EwoudVV/arpeggiator/images/note-switches.png

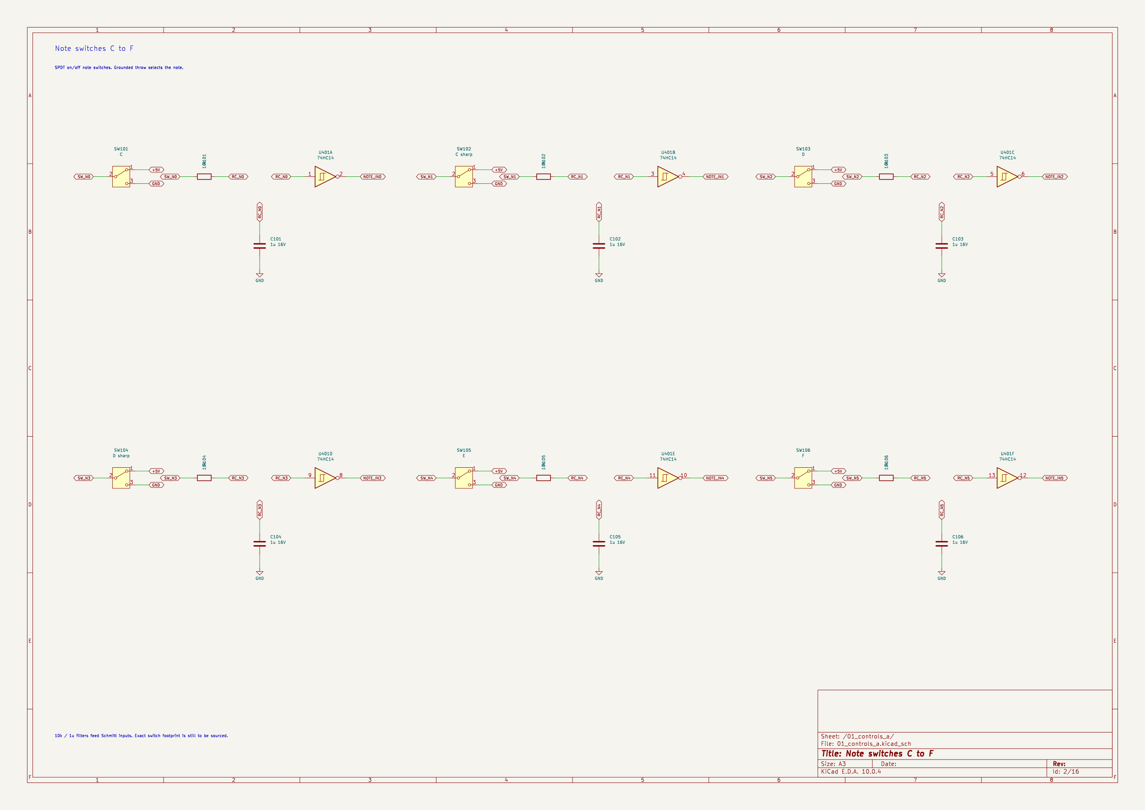
images/note-switches.png
