EwoudVV/arpeggiator/images/pcb-placement.png

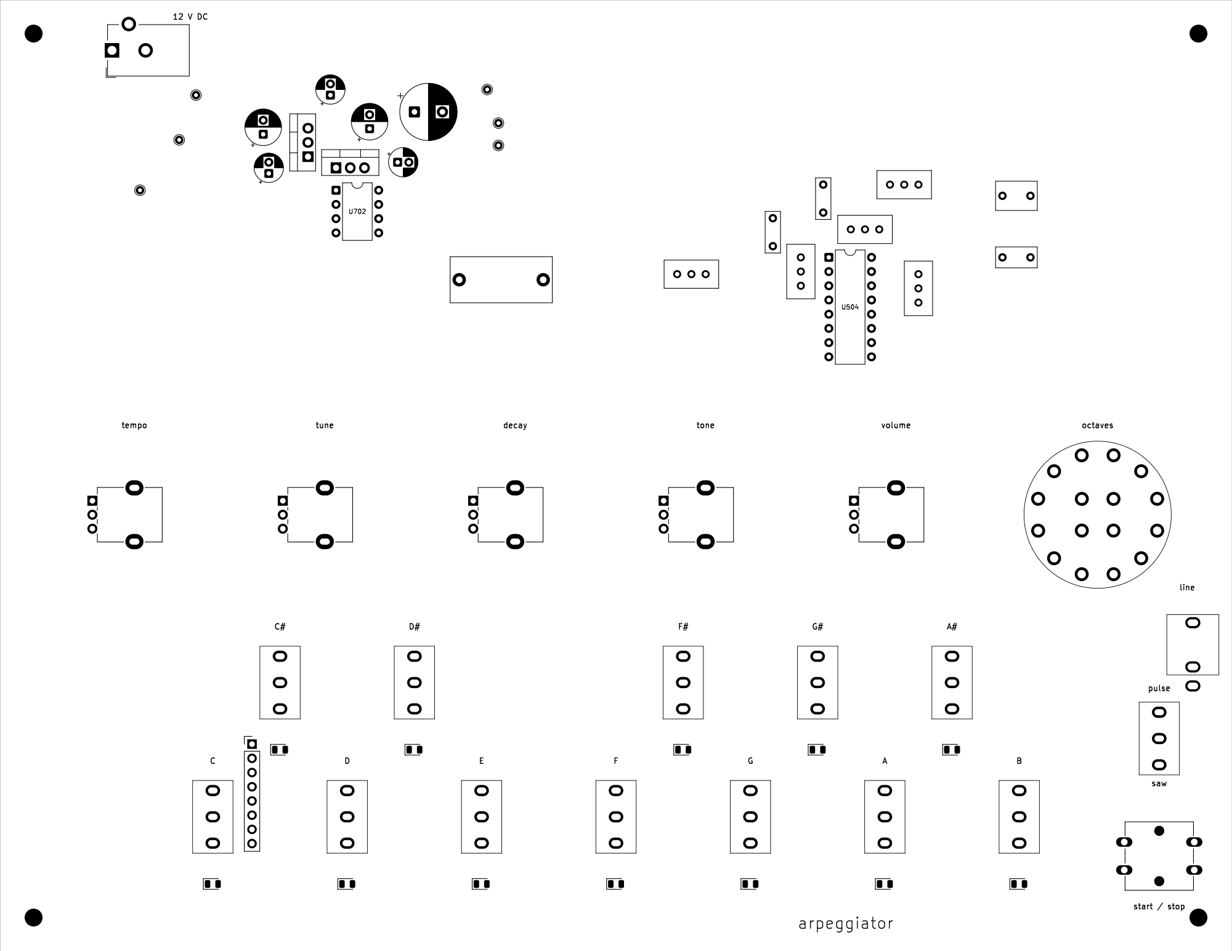
images/pcb-placement.png
