EwoudVV/arpeggiator/BOM.csv

Value | Quantity | References | MPN | Footprint | Manufacturer | Supplier | Supplier URL | Datasheet | Status
74HC04 | 4 | U404, U405, U408, U416 | 74HC04D,653 | Package_SO:SOIC-14_3.9x8.7mm_P1.27mm | Nexperia | LCSC | https://www.lcsc.com/product-detail/C5590.html | https://assets.nexperia.com/documents/data-sheet/74HC_HCT04.pdf | in stock, 23 oct 2026
74HC08 | 8 | U406, U413, U414, U417, U418, U421, U423, U425 | 74HC08D,653 | Package_SO:SOIC-14_3.9x8.7mm_P1.27mm | Nexperia | LCSC | https://www.lcsc.com/product-detail/C5593.html | https://assets.nexperia.com/documents/data-sheet/74HC_HCT08.pdf | in stock, 23 oct 2026
74HC138 | 1 | U212 | 74HC138D,653 | Package_SO:SOIC-16_3.9x9.9mm_P1.27mm | Nexperia | LCSC | https://www.lcsc.com/product-detail/C5602.html | https://assets.nexperia.com/documents/data-sheet/74HC_HCT138.pdf | in stock, 23 oct 2026
74HC14 | 4 | U401, U402, U403, U420 | 74HC14D,653 | Package_SO:SOIC-14_3.9x8.7mm_P1.27mm | Nexperia | LCSC | https://www.lcsc.com/product-detail/C5605.html | https://assets.nexperia.com/documents/data-sheet/74HC_HCT14.pdf | in stock, 23 oct 2026
74HC154 | 1 | U222 | CD74HC154M96 | Package_SO:SOIC-24W_7.5x15.4mm_P1.27mm | TI | LCSC | https://www.lcsc.com/product-detail/C2832236.html | https://assets.nexperia.com/documents/data-sheet/74HC_HCT154.pdf | in stock, 23 oct 2026
74HC163 | 4 | U211, U213, U214, U215 | SN74HC163DR | Package_SO:SOIC-16_3.9x9.9mm_P1.27mm | TI | LCSC | https://www.lcsc.com/product-detail/C338758.html | https://assets.nexperia.com/documents/data-sheet/74HC_HCT163.pdf | in stock, 23 oct 2026
74HC32 | 7 | U409, U410, U411, U412, U419, U422, U424 | 74HC32D,653 | Package_SO:SOIC-14_3.9x8.7mm_P1.27mm | Nexperia | LCSC | https://www.lcsc.com/product-detail/C5632.html | https://assets.nexperia.com/documents/data-sheet/74HC_HCT32.pdf | in stock, 23 oct 2026
74HC377 | 3 | U205, U206, U221 | 74HC377D,653 | Package_SO:SOIC-20W_7.5x12.8mm_P1.27mm | Nexperia | LCSC | https://www.lcsc.com/product-detail/C5639.html | https://assets.nexperia.com/documents/data-sheet/74HC_HCT377.pdf | in stock, 23 oct 2026
74HC4051D | 1 | U503 | 74HC4051D,653 | Package_SO:SOIC-16_3.9x9.9mm_P1.27mm | Nexperia | LCSC | https://www.lcsc.com/product-detail/C9386.html | https://assets.nexperia.com/documents/data-sheet/74HC_HCT4051.pdf | in stock, 23 oct 2026
74HC574 | 4 | U201, U203, U202, U204 | 74HC574D,653 | Package_SO:SOIC-20W_7.5x12.8mm_P1.27mm | Nexperia | LCSC | https://www.lcsc.com/product-detail/C16501.html | https://assets.nexperia.com/documents/data-sheet/74HC_HCT574.pdf | in stock, 23 oct 2026
74HC74 | 3 | U301, U302, U303 | 74HC74D,653 | Package_SO:SOIC-14_3.9x8.7mm_P1.27mm | Nexperia | LCSC | https://www.lcsc.com/product-detail/C27597.html | https://assets.nexperia.com/documents/data-sheet/74HC_HCT74.pdf | in stock, 23 oct 2026
74HC86 | 2 | U407, U415 | 74HC86D,653 | Package_SO:SOIC-14_3.9x8.7mm_P1.27mm | Nexperia | LCSC | https://www.lcsc.com/product-detail/C5955.html | https://assets.nexperia.com/documents/data-sheet/74HC_HCT86.pdf | in stock, 23 oct 2026
ADG706BRUZ | 1 | U502 | ADG706BRUZ-REEL7 | Package_SO:TSSOP-28_4.4x9.7mm_P0.65mm | ADI | LCSC | https://www.lcsc.com/product-detail/C408400.html | https://www.analog.com/media/en/technical-documentation/data-sheets/adg706_707.pdf | in stock, 23 oct 2026
AS3340A | 1 | U504 | AS3340A | Package_DIP:DIP-16_W7.62mm | ALFA RPAR | Infinite Machinery | https://infinitemachinery.com/as3340a | https://www.alfatriode.lv/eng/sc/AS3340.pdf | listed in stock, cart blocked by verification
CD74HC4067M | 1 | U216 | CD74HC4067M | Package_SO:SOIC-24W_7.5x15.4mm_P1.27mm | TI | LCSC | https://www.lcsc.com/product-detail/C1545936.html | https://www.ti.com/lit/ds/symlink/cd74hc4067.pdf | in stock, 23 oct 2026
L7805CV | 1 | U701 | L7805CV | Package_TO_SOT_THT:TO-220-3_Vertical | ST | LCSC | https://www.lcsc.com/product-detail/C111887.html | https://www.st.com/resource/en/datasheet/l78.pdf | in stock, 23 oct 2026
L7905CV | 1 | U706 | L7905CV | Package_TO_SOT_THT:TO-220-3_Vertical | ST | LCSC | https://www.lcsc.com/product-detail/C111884.html | https://www.st.com/resource/en/datasheet/l79.pdf | in stock, 23 oct 2026
LM13700M/NOPB | 1 | U604 | LM13700M/NOPB | Package_SO:SOIC-16_3.9x9.9mm_P1.27mm | TI | LCSC | https://www.lcsc.com/product-detail/C1346265.html | https://www.ti.com/lit/ds/symlink/lm13700.pdf | in stock, 23 oct 2026
LT1054CP | 1 | U702 | LT1054CP | Package_DIP:DIP-8_W7.62mm | Texas Instruments | Mouser | https://www.mouser.com/en/ProductDetail/Texas-Instruments/LT1054CP?qs=p6YqzpSxLIw2yA3OFyb6XA%3D%3D | https://www.ti.com/lit/ds/symlink/lt1054.pdf | in stock, 22 oct 2026
MCP100T-450I/TT | 1 | U103 | MCP100T-450I/TT | Package_TO_SOT_SMD:SOT-23 | MICROCHIP | LCSC | https://www.lcsc.com/product-detail/C134467.html | https://www.microchip.com/en-us/product/MCP100 | in stock, 23 oct 2026
OPA4192IDR | 2 | U501, U602 | OPA4192IDR | Package_SO:SOIC-14_3.9x8.7mm_P1.27mm | TI | LCSC | https://www.lcsc.com/product-detail/C2057908.html | https://www.ti.com/lit/ds/symlink/opa4192.pdf | in stock, 23 oct 2026
TL074HIDR | 1 | U603 | TL074HIDR | Package_SO:SOIC-14_3.9x8.7mm_P1.27mm | TI | LCSC | https://www.lcsc.com/product-detail/C2878713.html | https://www.ti.com/lit/ds/symlink/tl074.pdf | in stock, 23 oct 2026
TL431BIDBZR | 2 | U703, U704 | TL431BIDBZR | Package_TO_SOT_SMD:SOT-23 | TI | LCSC | https://www.lcsc.com/product-detail/C41283.html | https://www.ti.com/lit/ds/symlink/tl431.pdf | in stock, 23 oct 2026
TLC555IDR | 3 | U101, U102, U601 | TLC555IDR | Package_SO:SOIC-8_3.9x4.9mm_P1.27mm | TI | LCSC | https://www.lcsc.com/product-detail/C6987.html | https://www.ti.com/lit/ds/symlink/tlc555.pdf | in stock, 23 oct 2026
TMUX6219DGKRQ1 | 1 | U705 | TMUX6219DGKRQ1 | Arpeggiator:VSSOP-8_DGK0008A_TI | Texas Instruments | LCSC | https://www.lcsc.com/product-detail/C3657022.html | https://www.ti.com/lit/ds/symlink/tmux6219-q1.pdf | in stock, 23 oct 2026
1 / 2 / 3 octaves | 1 | SW114 | SR2612F-0403-18R0B-D8-N | Arpeggiator:SW_Alpha_SR2612F_4P3T | Taiwan Alpha | Tayda | https://www.taydaelectronics.com/electromechanical/switches-key-pad/rotary-switch/rotary-switch-4-pole-3-position-alpha-sr2612f.html | https://www.taydaelectronics.com/datasheets/A-1892.pdf | in stock, 22 oct 2026
1000u 25V | 1 | C708 | EEU-FR1E102 | Capacitor_THT:CP_Radial_D10.0mm_P5.00mm | Panasonic | Mouser | https://www.mouser.com/en/ProductDetail/Panasonic/EEU-FR1E102?qs=Ao3mORb5HCARq2G4MnAlEQ%3D%3D |  | in stock, 22 oct 2026
100k 0.01% 25ppm/C | 4 | R531, R532, R622, R623 | RNCF0805TKT100K | Resistor_SMD:R_0805_2012Metric | SEI Stackpole | Mouser | https://www.mouser.com/en/ProductDetail/SEI-Stackpole/RNCF0805TKT100K?qs=IPgv5n7u5QbwSiCWZtnkOw%3D%3D |  | in stock, 22 oct 2026
100k audio volume | 1 | RV604 | RD901F-40-15F-A100K | Potentiometer_THT:Potentiometer_Alpha_RD901F-40-00D_Single_Vertical | Taiwan Alpha | Tayda | https://www.taydaelectronics.com/100k-ohm-logarithmic-taper-potentiometer-d-shaft-pcb-9mm.html | https://www.taydaelectronics.com/datasheets/files/A-4728-1.pdf | in stock, 22 oct 2026
100k coarse trim | 1 | RV606 | 3296W-1-104LF | Potentiometer_THT:Potentiometer_Bourns_3296W_Vertical | BOURNS | LCSC | https://www.lcsc.com/product-detail/C48084.html | https://www.bourns.com/docs/product-datasheets/3296.pdf | in stock, 23 oct 2026
100k offset null | 1 | RV602 | 3296W-1-104LF | Potentiometer_THT:Potentiometer_Bourns_3296W_Vertical | BOURNS | LCSC | https://www.lcsc.com/product-detail/C48084.html | https://www.bourns.com/docs/product-datasheets/3296.pdf | in stock, 23 oct 2026
100k tone | 1 | RV603 | RD901F-40-15F-B100K | Potentiometer_THT:Potentiometer_Alpha_RD901F-40-00D_Single_Vertical | Taiwan Alpha | Tayda | https://www.taydaelectronics.com/100k-ohm-linear-taper-potentiometer-d-shaft-pcb-9mm.html | https://www.taydaelectronics.com/datasheets/files/A-4728-1.pdf | in stock, 22 oct 2026
100k tune | 1 | RV605 | RD901F-40-15F-B100K | Potentiometer_THT:Potentiometer_Alpha_RD901F-40-00D_Single_Vertical | Taiwan Alpha | Tayda | https://www.taydaelectronics.com/100k-ohm-linear-taper-potentiometer-d-shaft-pcb-9mm.html | https://www.taydaelectronics.com/datasheets/files/A-4728-1.pdf | in stock, 22 oct 2026
100n film 100V 5% | 2 | C631, C632 | R82EC3100DQ70J | Capacitor_THT:C_Rect_L7.2mm_W2.5mm_P5.00mm | KEMET | Tayda | https://www.taydaelectronics.com/0-1uf-100v-5-kemet-polyester-film-box-type-capacitor.html |  | in stock, 22 oct 2026
100u 25V | 2 | C701, C707 | EEU-FC1E101S | Capacitor_THT:CP_Radial_D6.3mm_P2.50mm | Panasonic | Mouser | https://www.mouser.com/en/ProductDetail/Panasonic/EEU-FC1E101S?qs=XZT10BZ%2FaGG7SbPLggsp3w%3D%3D | https://industrial.panasonic.com/cdbs/www-data/pdf/RDF0000/ABA0000C1209.pdf | in stock, 22 oct 2026
10k 0.01% 25ppm/C | 4 | R504, R505, R621, R624 | RNCF0805TKY10K0 | Resistor_SMD:R_0805_2012Metric | SEI Stackpole | Mouser | https://www.mouser.com/en/ProductDetail/SEI-Stackpole/RNCF0805TKY10K0?qs=FESYatJ8odKPVkqigBJMsg%3D%3D |  | in stock, 22 oct 2026
10k tempco | 1 | RV502 | 3296W-1-103LF | Potentiometer_THT:Potentiometer_Bourns_3296W_Vertical | Bourns | Mouser | https://www.mouser.com/en/ProductDetail/Bourns/3296W-1-103LF?qs=CL3xLxiry19Id6AEaxYcng%3D%3D | https://www.bourns.com/docs/product-datasheets/3296.pdf | in stock, 22 oct 2026
1M decay | 1 | RV601 | RD901F-40-15F-B1M | Potentiometer_THT:Potentiometer_Alpha_RD901F-40-00D_Single_Vertical | Taiwan Alpha | Tayda | https://www.taydaelectronics.com/potentiometer-variable-resistors/rotary-potentiometer/linear/1m-ohm-linear-taper-potentiometer-d-shaft-pcb-9mm.html | https://www.taydaelectronics.com/datasheets/files/A-4728-1.pdf | in stock, 22 oct 2026
1u film 63V 5% | 1 | C603 | R82DC4100DQ60J | Capacitor_THT:C_Rect_L7.2mm_W5.0mm_P5.00mm | KEMET | Tayda | https://www.taydaelectronics.com/1uf-63v-5-kemet-polyester-film-box-type-capacitor.html |  | in stock, 22 oct 2026
2.2u film 100V 10% | 1 | C181 | MKS4D042204F00KSSD | Capacitor_THT:C_Rect_L18.0mm_W8.0mm_P15.00mm_FKS3_FKP3 | WIMA | Tayda | https://www.taydaelectronics.com/capacitors/polyester-film-box-type-capacitors/wima-2200nf-2-2uf-100v-10-polyester-film-box-type-capacitor.html |  | in stock, 22 oct 2026
20k HF track | 1 | RV503 | 3296W-1-203LF | Potentiometer_THT:Potentiometer_Bourns_3296W_Vertical | BOURNS | LCSC | https://www.lcsc.com/product-detail/C34845.html | https://www.bourns.com/docs/product-datasheets/3296.pdf | in stock, 23 oct 2026
250k linear | 1 | RV101 | RD901F-40-15F-B250K | Potentiometer_THT:Potentiometer_Alpha_RD901F-40-00D_Single_Vertical | Taiwan Alpha | Tayda | https://www.taydaelectronics.com/potentiometer-variable-resistors/250k-ohm-linear-taper-potentiometer-d-shaft-pcb-9mm.html | https://www.taydaelectronics.com/datasheets/files/A-4728-1.pdf | in stock, 22 oct 2026
2N7002 | 2 | Q601, Q605 | 2N7002,215 | Package_TO_SOT_SMD:SOT-23 | Nexperia | LCSC | https://www.lcsc.com/product-detail/C65189.html | https://assets.nexperia.com/documents/data-sheet/2N7002.pdf | in stock, 23 oct 2026
3.5mm mono line out | 1 | J601 | PJ-3001F | Arpeggiator:Jack_PJ-3001F_Vertical | Tayda Electronics | Tayda | https://www.taydaelectronics.com/pj-3001f-3-5-mm-mono-phone-jack.html | https://www.taydaelectronics.com/datasheets/files/PJ35586.pdf | in stock, 22 oct 2026
470n film 63V 5% | 1 | C633 | R82DC3470AA60J | Capacitor_THT:C_Rect_L7.2mm_W3.5mm_P5.00mm | KEMET | Mouser | https://www.mouser.com/en/ProductDetail/KEMET/R82DC3470AA60J?qs=06HLYMEcjuWhk0f5YvbbSQ%3D%3D |  | in stock, 22 oct 2026
47u 25V | 3 | C704, C705, C711 | 25YXJ47M5X11 | Capacitor_THT:CP_Radial_D5.0mm_P2.00mm | Rubycon | Mouser | https://www.mouser.com/en/ProductDetail/Rubycon/25YXJ47M5X11?qs=T3oQrply3y%2F3J8S0Pc4Y1g%3D%3D |  | in stock, 22 oct 2026
500 scale | 1 | RV501 | 3296W-1-501LF | Potentiometer_THT:Potentiometer_Bourns_3296W_Vertical | Bourns | Mouser | https://www.mouser.com/en/ProductDetail/Bourns/3296W-1-501LF?qs=jv1NtkgVBglZfwkzTzmOUg%3D%3D | https://www.bourns.com/docs/product-datasheets/3296.pdf | in stock, 22 oct 2026
A | 1 | SW110 | 1MS1T1B1M2QES | Arpeggiator:SW_Dailywell_1M_SPDT_M2 | Dailywell | Tayda | https://www.taydaelectronics.com/electromechanical/switches-key-pad/toggle-switch/mini-toggle-switch-spdt-on-none-on-pc-thru-hole.html | https://www.taydaelectronics.com/datasheets/files/1M_series.pdf | in stock, 22 oct 2026
A sharp | 1 | SW111 | 1MS1T1B1M2QES | Arpeggiator:SW_Dailywell_1M_SPDT_M2 | Dailywell | Tayda | https://www.taydaelectronics.com/electromechanical/switches-key-pad/toggle-switch/mini-toggle-switch-spdt-on-none-on-pc-thru-hole.html | https://www.taydaelectronics.com/datasheets/files/1M_series.pdf | in stock, 22 oct 2026
AO3401A | 1 | Q701 | AO3401A | Package_TO_SOT_SMD:SOT-23 | AOS | LCSC | https://www.lcsc.com/product-detail/C15127.html | https://www.aosmd.com/res/data_sheets/AO3401A.pdf | in stock, 23 oct 2026
B | 1 | SW112 | 1MS1T1B1M2QES | Arpeggiator:SW_Dailywell_1M_SPDT_M2 | Dailywell | Tayda | https://www.taydaelectronics.com/electromechanical/switches-key-pad/toggle-switch/mini-toggle-switch-spdt-on-none-on-pc-thru-hole.html | https://www.taydaelectronics.com/datasheets/files/1M_series.pdf | in stock, 22 oct 2026
BAT54GW | 2 | D601, D708 | BAT54GWX | Diode_SMD:D_SOD-123 | Nexperia | LCSC | https://www.lcsc.com/product-detail/C5952163.html | https://assets.nexperia.com/documents/data-sheet/BAT54GW.pdf | in stock, 23 oct 2026
BAT54S,215 | 1 | D706 | BAT54S,215 | Package_TO_SOT_SMD:SOT-23 | Nexperia | LCSC | https://www.lcsc.com/product-detail/C47546.html | https://assets.nexperia.com/documents/data-sheet/BAT54_SER.pdf | in stock, 23 oct 2026
BSS84 | 1 | Q603 | BSS84,215 | Package_TO_SOT_SMD:SOT-23 | Nexperia | LCSC | https://www.lcsc.com/product-detail/C493579.html | https://assets.nexperia.com/documents/data-sheet/BSS84.pdf | in stock, 23 oct 2026
BZT52C8V2 | 1 | D701 | BZT52-C8V2J | Diode_SMD:D_SOD-123 | Nexperia | Mouser | https://www.mouser.com/en/ProductDetail/Nexperia/BZT52-C8V2J?qs=%252BEew9%252B0nqrCU1UOFPtFF2A%3D%3D | https://assets.nexperia.com/documents/data-sheet/BZT52_SER.pdf | in stock, 22 oct 2026
C | 1 | SW101 | 1MS1T1B1M2QES | Arpeggiator:SW_Dailywell_1M_SPDT_M2 | Dailywell | Tayda | https://www.taydaelectronics.com/electromechanical/switches-key-pad/toggle-switch/mini-toggle-switch-spdt-on-none-on-pc-thru-hole.html | https://www.taydaelectronics.com/datasheets/files/1M_series.pdf | in stock, 22 oct 2026
C sharp | 1 | SW102 | 1MS1T1B1M2QES | Arpeggiator:SW_Dailywell_1M_SPDT_M2 | Dailywell | Tayda | https://www.taydaelectronics.com/electromechanical/switches-key-pad/toggle-switch/mini-toggle-switch-spdt-on-none-on-pc-thru-hole.html | https://www.taydaelectronics.com/datasheets/files/1M_series.pdf | in stock, 22 oct 2026
D | 1 | SW103 | 1MS1T1B1M2QES | Arpeggiator:SW_Dailywell_1M_SPDT_M2 | Dailywell | Tayda | https://www.taydaelectronics.com/electromechanical/switches-key-pad/toggle-switch/mini-toggle-switch-spdt-on-none-on-pc-thru-hole.html | https://www.taydaelectronics.com/datasheets/files/1M_series.pdf | in stock, 22 oct 2026
D sharp | 1 | SW104 | 1MS1T1B1M2QES | Arpeggiator:SW_Dailywell_1M_SPDT_M2 | Dailywell | Tayda | https://www.taydaelectronics.com/electromechanical/switches-key-pad/toggle-switch/mini-toggle-switch-spdt-on-none-on-pc-thru-hole.html | https://www.taydaelectronics.com/datasheets/files/1M_series.pdf | in stock, 22 oct 2026
E | 1 | SW105 | 1MS1T1B1M2QES | Arpeggiator:SW_Dailywell_1M_SPDT_M2 | Dailywell | Tayda | https://www.taydaelectronics.com/electromechanical/switches-key-pad/toggle-switch/mini-toggle-switch-spdt-on-none-on-pc-thru-hole.html | https://www.taydaelectronics.com/datasheets/files/1M_series.pdf | in stock, 22 oct 2026
F | 1 | SW106 | 1MS1T1B1M2QES | Arpeggiator:SW_Dailywell_1M_SPDT_M2 | Dailywell | Tayda | https://www.taydaelectronics.com/electromechanical/switches-key-pad/toggle-switch/mini-toggle-switch-spdt-on-none-on-pc-thru-hole.html | https://www.taydaelectronics.com/datasheets/files/1M_series.pdf | in stock, 22 oct 2026
F sharp | 1 | SW107 | 1MS1T1B1M2QES | Arpeggiator:SW_Dailywell_1M_SPDT_M2 | Dailywell | Tayda | https://www.taydaelectronics.com/electromechanical/switches-key-pad/toggle-switch/mini-toggle-switch-spdt-on-none-on-pc-thru-hole.html | https://www.taydaelectronics.com/datasheets/files/1M_series.pdf | in stock, 22 oct 2026
G | 1 | SW108 | 1MS1T1B1M2QES | Arpeggiator:SW_Dailywell_1M_SPDT_M2 | Dailywell | Tayda | https://www.taydaelectronics.com/electromechanical/switches-key-pad/toggle-switch/mini-toggle-switch-spdt-on-none-on-pc-thru-hole.html | https://www.taydaelectronics.com/datasheets/files/1M_series.pdf | in stock, 22 oct 2026
G sharp | 1 | SW109 | 1MS1T1B1M2QES | Arpeggiator:SW_Dailywell_1M_SPDT_M2 | Dailywell | Tayda | https://www.taydaelectronics.com/electromechanical/switches-key-pad/toggle-switch/mini-toggle-switch-spdt-on-none-on-pc-thru-hole.html | https://www.taydaelectronics.com/datasheets/files/1M_series.pdf | in stock, 22 oct 2026
LM4040A25IDBZR | 1 | D501 | LM4040A25IDBZR | Package_TO_SOT_SMD:SOT-23 | TI | LCSC | https://www.lcsc.com/product-detail/C9421.html | https://www.ti.com/lit/ds/symlink/lm4040.pdf | in stock, 23 oct 2026
MF-MSMF035/33X-2 / 350mA | 1 | F701 | MF-MSMF035/33X-2 | Fuse:Fuse_1812_4532Metric | Bourns | Mouser | https://www.mouser.com/en/ProductDetail/Bourns/MF-MSMF035-33X-2?qs=CoAU%2FpHVZXxuOeHMuQc7RQ%3D%3D | https://www.bourns.com/docs/product-datasheets/mf-msmf.pdf | in stock, 22 oct 2026
MMBT3904 | 2 | Q602, Q604 | MMBT3904,215 | Package_TO_SOT_SMD:SOT-23 | Nexperia | LCSC | https://www.lcsc.com/product-detail/C426835.html | https://assets.nexperia.com/documents/data-sheet/MMBT3904.pdf | in stock, 23 oct 2026
MMBT3906 | 3 | Q606, Q702, Q703 | MMBT3906,215 | Package_TO_SOT_SMD:SOT-23 | Nexperia | LCSC | https://www.lcsc.com/product-detail/C75549.html | https://assets.nexperia.com/documents/data-sheet/MMBT3906.pdf | in stock, 23 oct 2026
PESD5V0S1BA,115 | 1 | D705 | PESD5V0S1BA,115 | Diode_SMD:D_SOD-323 | Nexperia | LCSC | https://www.lcsc.com/product-detail/C19224.html | https://assets.nexperia.com/documents/data-sheet/PESD5V0S1BA_BB_BL.pdf | in stock, 23 oct 2026
PJ-102AH / 12V DC centre + | 1 | J701 | PJ-102AH | Arpeggiator:BarrelJack_PJ102AH_Rear | Same Sky | Mouser | https://www.mouser.com/en/ProductDetail/Same-Sky/PJ-102AH?qs=WyjlAZoYn50Yq4CrVLCXLw%3D%3D | https://www.sameskydevices.com/product/resource/pj-102ah.pdf | in stock, 22 oct 2026
SMBJ12A | 1 | D702 | SMBJ12A | Diode_SMD:D_SMB | Littelfuse | Mouser | https://www.mouser.com/en/ProductDetail/Littelfuse/SMBJ12A?qs=JJML70Qc14s9i3D6UUa43Q%3D%3D |  | in stock, 22 oct 2026
SS14 | 3 | D703, D707, D704 | SS14-E3/61T | Diode_SMD:D_SMA | Vishay | Mouser | https://www.mouser.com/en/ProductDetail/Vishay/SS14-E3-61T?qs=x2jpVgRnAtMLNL7KZbtr8g%3D%3D | https://www.mouser.com/datasheet/2/427/VISH_S_A0010526100_1-2571162.pdf | in stock, 22 oct 2026
saw / pulse | 1 | SW601 | 1MS1T1B1M2QES | Arpeggiator:SW_Dailywell_1M_SPDT_M2 | Dailywell | Tayda | https://www.taydaelectronics.com/electromechanical/switches-key-pad/toggle-switch/mini-toggle-switch-spdt-on-none-on-pc-thru-hole.html | https://www.taydaelectronics.com/datasheets/files/1M_series.pdf | in stock, 22 oct 2026
start / stop | 1 | SW113 | B3F-4055 | Button_Switch_THT:SW_SPST_Omron_B3F-40xx | OMRON | LCSC | https://www.lcsc.com/product-detail/C84931.html | https://omronfs.omron.com/en_US/ecb/products/pdf/en-b3f.pdf | in stock, 23 oct 2026
1.1M 1% | 1 | R633 | RC0805FR-071M1L | Resistor_SMD:R_0805_2012Metric | YAGEO | Mouser | https://www.mouser.com/en/ProductDetail/YAGEO/RC0805FR-071M1L?qs=g6xwsc4j%252B%2FrRMnxWx%2Fruqg%3D%3D |  | in stock, 22 oct 2026
1.5M 1% | 2 | R534, R542 | RC0805FR-071M5L | Resistor_SMD:R_0805_2012Metric | YAGEO | Mouser | https://www.mouser.com/en/ProductDetail/YAGEO/RC0805FR-071M5L?qs=g6xwsc4j%252B%2FoVoMODI3Rz0Q%3D%3D |  | in stock, 22 oct 2026
1.5k 1% | 1 | R537 | RC0805FR-071K5L | Resistor_SMD:R_0805_2012Metric | YAGEO | Mouser | https://www.mouser.com/en/ProductDetail/YAGEO/RC0805FR-071K5L?qs=8Y8p%252BasKcI6LbaohOVk4HA%3D%3D |  | in stock, 22 oct 2026
1.82M 0.1% | 1 | R620 | CPF0805B1M82E | Resistor_SMD:R_0805_2012Metric | TE Connectivity | Mouser | https://www.mouser.com/en/ProductDetail/TE-Connectivity/CPF0805B1M82E?qs=CXI0wBT1M2hvtJld3NhfsA%3D%3D |  | in stock, 22 oct 2026
1.8M 1% | 1 | R163 | ERJ-6ENF1804V | Resistor_SMD:R_0805_2012Metric | Panasonic | Mouser | https://www.mouser.com/en/ProductDetail/Panasonic/ERJ-6ENF1804V?qs=JjxTDIFmKPTXgJmgM%2FyOiQ%3D%3D |  | in stock, 22 oct 2026
100 0.1% | 1 | R540 | RT0805BRD07100RL | Resistor_SMD:R_0805_2012Metric | YAGEO | Mouser | https://www.mouser.com/en/ProductDetail/YAGEO/RT0805BRD07100RL?qs=%2Ff7pOCXLR5dUTF5MWPONjg%3D%3D |  | in stock, 22 oct 2026
100k 1% | 11 | R130, R216, R535, R601, R602, R605, R637, R701, R716, R726, R728 | RC0805FR-07100KL | Resistor_SMD:R_0805_2012Metric | YAGEO | Mouser | https://www.mouser.com/en/ProductDetail/YAGEO/RC0805FR-07100KL?qs=8Y8p%252BasKcI7rEWn6FcVdAA%3D%3D |  | in stock, 22 oct 2026
100n 5% | 1 | C601 | C0805C104J5RACTU | Capacitor_SMD:C_0805_2012Metric | KEMET | Mouser | https://www.mouser.com/en/ProductDetail/KEMET/C0805C104J5RACTU?qs=gbgtKHXraGH15GhoNPXHBg%3D%3D |  | in stock, 22 oct 2026
100n 50V X7R 10% | 68 | C130, C140, C141, C901, C902, C903, C904, C905, C906, C907, C908, C909, C910, C911, C912, C913, C914, C915, C916, C917, C918, C919, C920, C921, C922, C923, C924, C925, C926, C927, C928, C929, C930, C931, C932, C933, C934, C935, C936, C937, C938, C939, C940, C941, C942, C943, C944, C945, C501, C532, C551, C552, C553, C554, C555, C556, C557, C558, C559, C560, C561, C562, C661, C703, C706, C717, C715, C716 | CC0805KRX7R9BB104 | Capacitor_SMD:C_0805_2012Metric | YAGEO | LCSC | https://www.lcsc.com/product-detail/C49678.html |  | in stock, 23 oct 2026
100p C0G | 5 | C502, C503, C621, C713, C714 | C0805C101J5GACTU | Capacitor_SMD:C_0805_2012Metric | KEMET | Mouser | https://www.mouser.com/en/ProductDetail/KEMET/C0805C101J5GACTU?qs=6pfgPk%252B7Yz7wCPQSSQ%2FBjg%3D%3D |  | in stock, 22 oct 2026
10k 0.1% | 2 | R625, R639 | RT0805BRD0710KL | Resistor_SMD:R_0805_2012Metric | YAGEO | Mouser | https://www.mouser.com/en/ProductDetail/YAGEO/RT0805BRD0710KL?qs=87%2Fgv35YuOdOfU%252BBkLDVxA%3D%3D |  | in stock, 22 oct 2026
10k 0.1% 25ppm/C | 1 | R503 | RT0805BRD0710KL | Resistor_SMD:R_0805_2012Metric | YAGEO | Mouser | https://www.mouser.com/en/ProductDetail/YAGEO/RT0805BRD0710KL?qs=87%2Fgv35YuOdOfU%252BBkLDVxA%3D%3D |  | in stock, 22 oct 2026
10k 1% | 25 | R101, R102, R103, R104, R105, R106, R107, R108, R109, R110, R111, R112, R151, R152, R161, R140, R142, R141, R143, R604, R609, R630, R717, R727, R707 | RC0805FR-0710KL | Resistor_SMD:R_0805_2012Metric | YAGEO | Mouser | https://www.mouser.com/en/ProductDetail/YAGEO/RC0805FR-0710KL?qs=7bY8808IzHq6vrU3BeiiYw%3D%3D |  | in stock, 22 oct 2026
10n | 6 | C172, C182, C531, C533, C602, C634 | C0805C103J5GACTU | Capacitor_SMD:C_0805_2012Metric | KEMET | LCSC | https://www.lcsc.com/product-detail/C2167597.html |  | in stock, 23 oct 2026
10u 16V | 1 | C150 | GRM21BR61C106KE15L | Capacitor_SMD:C_0805_2012Metric | muRata | LCSC | https://www.lcsc.com/product-detail/C77075.html |  | in stock, 23 oct 2026
15k 0.1% 25ppm/C | 1 | R502 | RT0805BRD0715KL | Resistor_SMD:R_0805_2012Metric | YAGEO | Mouser | https://www.mouser.com/en/ProductDetail/YAGEO/RT0805BRD0715KL?qs=%2Ff7pOCXLR5foXQ1VlhQYhQ%3D%3D |  | in stock, 22 oct 2026
174k 0.1% | 1 | R704 | RT0805BRD07174KL | Resistor_SMD:R_0805_2012Metric | YAGEO | Mouser | https://www.mouser.com/en/ProductDetail/YAGEO/RT0805BRD07174KL?qs=4CyHz7GXqSj4xC7rYoRg0A%3D%3D |  | in stock, 22 oct 2026
18.2k 1% | 1 | R603 | ERJ-6ENF1822V | Resistor_SMD:R_0805_2012Metric | Panasonic | Mouser | https://www.mouser.com/en/ProductDetail/Panasonic/ERJ-6ENF1822V?qs=JjxTDIFmKPRzh6ImPVU9cQ%3D%3D |  | in stock, 22 oct 2026
1M 1% | 2 | R541, R629 | RC0805FR-071ML | Resistor_SMD:R_0805_2012Metric | YAGEO | Mouser | https://www.mouser.com/en/ProductDetail/YAGEO/RC0805FR-071ML?qs=8Y8p%252BasKcI6wvSL4jxV1pQ%3D%3D |  | in stock, 22 oct 2026
1k 0.1% | 12 | R511, R512, R513, R514, R515, R516, R517, R518, R519, R520, R521, R522 | RT0805BRD071KL | Resistor_SMD:R_0805_2012Metric | YAGEO | Mouser | https://www.mouser.com/en/ProductDetail/YAGEO/RT0805BRD071KL?qs=%2Ff7pOCXLR5e3FpClshTdPA%3D%3D |  | in stock, 22 oct 2026
1k 1% | 6 | R131, R628, R632, R634, R635, R636 | RC0805FR-071KL | Resistor_SMD:R_0805_2012Metric | YAGEO | Mouser | https://www.mouser.com/en/ProductDetail/YAGEO/RC0805FR-071KL?qs=1ogmaHw32WJjeGY0DHXakQ%3D%3D |  | in stock, 22 oct 2026
1n C0G | 2 | C171, C534 | C0805C102J5GACTU | Capacitor_SMD:C_0805_2012Metric | KEMET | Mouser | https://www.mouser.com/en/ProductDetail/KEMET/C0805C102J5GACTU?qs=yrVqjCObULOWvTzsHVJg1Q%3D%3D |  | in stock, 22 oct 2026
1u 16V | 12 | C101, C102, C103, C104, C105, C106, C107, C108, C109, C110, C111, C112 | CC0805KKX7R8BB105 | Capacitor_SMD:C_0805_2012Metric | YAGEO | Mouser | https://www.mouser.com/en/ProductDetail/YAGEO/CC0805KKX7R8BB105?qs=QENzi4TkIJ0C75LKGblEtw%3D%3D |  | in stock, 22 oct 2026
2.2k 1% | 14 | R221, R222, R223, R224, R225, R226, R227, R228, R229, R230, R231, R232, R714, R724 | RC0805FR-072K2L | Resistor_SMD:R_0805_2012Metric | YAGEO | Mouser | https://www.mouser.com/en/ProductDetail/YAGEO/RC0805FR-072K2L?qs=CSLd874fYV2eT6iKTza3nw%3D%3D |  | in stock, 22 oct 2026
2.32k 0.1% | 1 | R712 | RT0805BRD072K32L | Resistor_SMD:R_0805_2012Metric | YAGEO | Mouser | https://www.mouser.com/en/ProductDetail/YAGEO/RT0805BRD072K32L?qs=4CyHz7GXqSgSJcxnTJ8TbQ%3D%3D |  | in stock, 22 oct 2026
2.49k 1% | 1 | R501 | RC0805FR-072K49L | Resistor_SMD:R_0805_2012Metric | YAGEO | Mouser | https://www.mouser.com/en/ProductDetail/YAGEO/RC0805FR-072K49L?qs=QrWOOBGzeCbaR%2FeulLJohg%3D%3D |  | in stock, 22 oct 2026
200k 1% | 1 | R627 | RC0805FR-07200KL | Resistor_SMD:R_0805_2012Metric | YAGEO | Mouser | https://www.mouser.com/en/ProductDetail/YAGEO/RC0805FR-07200KL?qs=8Y8p%252BasKcI4ufYuYh%252BmyZQ%3D%3D |  | in stock, 22 oct 2026
20k 0.1% | 1 | R703 | RT0805BRD0720KL | Resistor_SMD:R_0805_2012Metric | YAGEO | Mouser | https://www.mouser.com/en/ProductDetail/YAGEO/RT0805BRD0720KL?qs=87%2Fgv35YuOd%2FdRM1LyX3Lg%3D%3D |  | in stock, 22 oct 2026
220 1% | 2 | R607, R611 | RC0805FR-07220RL | Resistor_SMD:R_0805_2012Metric | YAGEO | Mouser | https://www.mouser.com/en/ProductDetail/YAGEO/RC0805FR-07220RL?qs=KCkj9j0IqmXa4o%252BHKR6RGw%3D%3D |  | in stock, 22 oct 2026
22k 1% | 1 | R608 | RC0805FR-0722KL | Resistor_SMD:R_0805_2012Metric | YAGEO | Mouser | https://www.mouser.com/en/ProductDetail/YAGEO/RC0805FR-0722KL?qs=ngJqVwYVsdVbc7Rh0xIeHw%3D%3D |  | in stock, 22 oct 2026
24k 1% | 1 | R538 | RC0805FR-0724KL | Resistor_SMD:R_0805_2012Metric | YAGEO | Mouser | https://www.mouser.com/en/ProductDetail/YAGEO/RC0805FR-0724KL?qs=0OpHuDRjTADBsy5P0J6k2w%3D%3D |  | in stock, 22 oct 2026
2k 0.1% | 2 | R711, R722 | RT0805BRD072KL | Resistor_SMD:R_0805_2012Metric | YAGEO | Mouser | https://www.mouser.com/en/ProductDetail/YAGEO/RT0805BRD072KL?qs=7JGxMcfkPok2189RXPA53g%3D%3D |  | in stock, 22 oct 2026
2n C0G | 1 | C709 | C0805C202J5GACTU | Capacitor_SMD:C_0805_2012Metric | KEMET | Mouser | https://www.mouser.com/en/ProductDetail/KEMET/C0805C202J5GACTU?qs=W4SVoLh3QChWIjbVvPwmQg%3D%3D |  | in stock, 22 oct 2026
330k 0.1% | 2 | R713, R723 | RT0805BRD07330KL | Resistor_SMD:R_0805_2012Metric | YAGEO | Mouser | https://www.mouser.com/en/ProductDetail/YAGEO/RT0805BRD07330KL?qs=aZCcseWLxnuj6nToWrZKFA%3D%3D |  | in stock, 22 oct 2026
330n 50V | 1 | C702 | C0805C334K5RACTU | Capacitor_SMD:C_0805_2012Metric | KEMET | Mouser | https://www.mouser.com/en/ProductDetail/KEMET/C0805C334K5RACTU?qs=nRD1PKnFC2Hh3tSy%2FGeH2Q%3D%3D |  | in stock, 22 oct 2026
33k 1% | 1 | R706 | RC0805FR-0733KL | Resistor_SMD:R_0805_2012Metric | YAGEO | Mouser | https://www.mouser.com/en/ProductDetail/YAGEO/RC0805FR-0733KL?qs=BrN8wpjQTgGzZxKgikrwvw%3D%3D |  | in stock, 22 oct 2026
33p C0G | 1 | C622 | C0805C330J5GACTU | Capacitor_SMD:C_0805_2012Metric | KEMET | Mouser | https://www.mouser.com/en/ProductDetail/KEMET/C0805C330J5GACTU?qs=PVnqbTyV3SUE6Uu%252BkD9Iyg%3D%3D |  | in stock, 22 oct 2026
360k 0.1% | 1 | R533 | RT0805BRD07360KL | Resistor_SMD:R_0805_2012Metric | YAGEO | Mouser | https://www.mouser.com/en/ProductDetail/YAGEO/RT0805BRD07360KL?qs=aZCcseWLxnvpELpsSQnh8g%3D%3D |  | in stock, 22 oct 2026
36k 1% | 1 | R162 | RC0805FR-0736KL | Resistor_SMD:R_0805_2012Metric | YAGEO | Mouser | https://www.mouser.com/en/ProductDetail/YAGEO/RC0805FR-0736KL?qs=g6xwsc4j%252B%2Fq3CmSeyDlL7g%3D%3D |  | in stock, 22 oct 2026
4.7 1% 0.25W | 1 | R702 | RC1206FR-074R7L | Resistor_SMD:R_1206_3216Metric | YAGEO | Mouser | https://www.mouser.com/en/ProductDetail/YAGEO/RC1206FR-074R7L?qs=bz%2FLPVPAsTK5WyYax3BLuA%3D%3D |  | in stock, 22 oct 2026
4.7u 25V X7R | 1 | C635 | GRM21BR71E475KA73L | Capacitor_SMD:C_0805_2012Metric | muRata | LCSC | https://www.lcsc.com/product-detail/C162427.html |  | in stock, 23 oct 2026
470 1% | 2 | R536, R543 | RC0805FR-07470RL | Resistor_SMD:R_0805_2012Metric | YAGEO | Mouser | https://www.mouser.com/en/ProductDetail/YAGEO/RC0805FR-07470RL?qs=CSLd874fYV2wsnqMGLpcHA%3D%3D |  | in stock, 22 oct 2026
47k 1% | 5 | R606, R610, R626, R715, R725 | RC0805FR-0747KL | Resistor_SMD:R_0805_2012Metric | YAGEO | Mouser | https://www.mouser.com/en/ProductDetail/YAGEO/RC0805FR-0747KL?qs=sfaR5EV1ye7DERH7OnC2Gg%3D%3D |  | in stock, 22 oct 2026
5.62k 0.1% | 1 | R539 | RT0805BRD075K62L | Resistor_SMD:R_0805_2012Metric | YAGEO | Mouser | https://www.mouser.com/en/ProductDetail/YAGEO/RT0805BRD075K62L?qs=ylEn6CkgxuiWDc5aTJ638g%3D%3D |  | in stock, 22 oct 2026
51k 1% | 1 | R544 | RC0805FR-0751KL | Resistor_SMD:R_0805_2012Metric | YAGEO | Mouser | https://www.mouser.com/en/ProductDetail/YAGEO/RC0805FR-0751KL?qs=g6xwsc4j%252B%2FrUFmy6S6ALYQ%3D%3D |  | in stock, 22 oct 2026
6.04k 0.1% | 1 | R638 | RT0805BRD076K04L | Resistor_SMD:R_0805_2012Metric | YAGEO | Mouser | https://www.mouser.com/en/ProductDetail/YAGEO/RT0805BRD076K04L?qs=8SI67b7NHM5NwjLBwcP%252BXQ%3D%3D |  | in stock, 22 oct 2026
6.49k 0.1% | 1 | R721 | RT0805BRD076K49L | Resistor_SMD:R_0805_2012Metric | YAGEO | Mouser | https://www.mouser.com/en/ProductDetail/YAGEO/RT0805BRD076K49L?qs=4CyHz7GXqSiLdN4y1MhhhQ%3D%3D |  | in stock, 22 oct 2026
820k 1% | 1 | R631 | RC0805FR-07820KL | Resistor_SMD:R_0805_2012Metric | YAGEO | Mouser | https://www.mouser.com/en/ProductDetail/YAGEO/RC0805FR-07820KL?qs=g6xwsc4j%252B%2FozLzDoZP6Szg%3D%3D |  | in stock, 22 oct 2026
910 1% | 2 | R729, R730 | RC0805FR-07910RL | Resistor_SMD:R_0805_2012Metric | YAGEO | Mouser | https://www.mouser.com/en/ProductDetail/YAGEO/RC0805FR-07910RL?qs=g6xwsc4j%252B%2FoZ2NamZOKACA%3D%3D |  | in stock, 22 oct 2026
copper test pad | 6 | TP701, TP702, TP703, TP704, TP705, TP706 |  | TestPoint:TestPoint_THTPad_D1.5mm_Drill0.7mm |  |  |  |  | PCB pad, no component
logic test header | 1 | J202 | M20-9990846 | Connector_PinHeader_2.54mm:PinHeader_1x08_P2.54mm_Vertical | Harwin | Mouser | https://www.mouser.com/en/ProductDetail/Harwin/M20-9990846?qs=ulE8k0yEMYb37YKanNqd%2FQ%3D%3D |  | in stock, 22 oct 2026
note LED, 0805 | 12 | D221, D222, D223, D224, D225, D226, D227, D228, D229, D230, D231, D232 | APT2012SYCK | LED_SMD:LED_0805_2012Metric | Kingbright | Mouser | https://www.mouser.com/en/ProductDetail/Kingbright/APT2012SYCK?qs=y3UkhjaxUTb%252BLZXQu8d2yw%3D%3D |  | in stock, 22 oct 2026
four-layer PCB, 220 x 170 mm, 1.6 mm FR4, 1 oz outer / 0.5 oz inner | 1 | PCB | arpeggiator-jlcpcb |  | JLCPCB | JLCPCB | https://jlcpcb.com/pcb-fabrication/fr4-pcb |  | quoted 23 oct 2026; five boards, including production-file review
printed tray, control panel, rear cover and octave collar | 1 | CASE |  | case/base.stl; case/control-panel.stl; case/rear-cover.stl; case/octave-collar.stl |  |  |  |  | PETG-CF tray and rear cover, PLA panel and collar
printed pot knob | 5 | KNOBS |  | case/pot-knob.stl |  |  |  |  | PLA
regulated 12V DC adapter, >=0.5A, centre +, 5.5/2.1mm | 1 | PSU | SMI6B-12-4-P5 | external | CUI Inc. | Mouser | https://www.mouser.com/en/ProductDetail/CUI-Inc/SMI6B-12-4-P5?qs=mAH9sUMRCtt8%252BS4f4Sapgw%3D%3D |  | in stock, 22 oct 2026
printed octave knob | 1 | OCTAVE_KNOB |  | case/octave-knob.stl |  |  |  |  | PLA
M3 x 8 mm socket-head screw | 18 | CASE_SCREWS | A-6393 | ISO 4762 M3 x 8 | Tayda Electronics | Tayda | https://www.taydaelectronics.com/hardware-tools/nuts-washers-screws-spacers-and-more/screws/m3-hexagon-socket-head-cap-screw-3x8mm-grade-12-9.html |  | in stock, 22 oct 2026
M3 hex nut | 18 | CASE_NUTS | Nut M3 | ISO 4032 M3, 5.5 mm across flats | Tayda Electronics | Tayda | https://www.taydaelectronics.com/nut-3mm-for-screw-m3.html |  | in stock, 22 oct 2026
stick-on rubber foot, about 12 mm diameter | 4 | FEET | RF-1204 | external | Tayda Electronics | Tayda | https://www.taydaelectronics.com/rubber-feet-black-64pcs-block-size-12mmx4mm-for-enclosure.html |  | in stock, 23 oct 2026; one sheet of 64 feet
clear 3 mm acrylic rod, at least 200 mm stock | 1 | LIGHT_PIPES | a24061900ux1460 | external | Harfington | Harfington | https://www.harfington.com/products/p-1536182 |  | in stock, 23 oct 2026; listed as 3 x 300 mm, 30 rods per pack
round black button cap | 1 | START_CAP | B32-1610 | Omron B3F-4055 compatible | Aratas | Mouser | https://www.mouser.com/en/ProductDetail/Aratas/B32-1610?qs=1tDaWCEHQQ6l3s6oDrKSiA%3D%3D | https://omronfs.omron.com/en_US/ecb/products/pdf/en-b32.pdf | in stock, 22 oct 2026
M7 x 0.75 thin pot nut and washer | 5 | POT_MOUNTS |  | nut at most 2 mm thick, washer at most 0.5 mm |  |  |  |  | check whether included with pots
1/4-40 toggle nut and washer | 13 | TOGGLE_MOUNTS |  | nut about 2 mm thick, washer 0.5 mm |  |  |  |  | check whether included with switches
3/8-32 NEF rotary nut and lockwasher | 1 | ROTARY_MOUNT |  | nut at most 3 mm thick, washer at most 0.8 mm |  |  |  |  | included with Alpha SR2612F
M6 x 0.5 jack nut and washer | 1 | JACK_MOUNT |  | nut 1 mm thick, washer at most 0.5 mm |  |  |  |  | check whether included with jack
bottom-side frameless stencil, 380 x 280 mm, 0.12 mm | 1 | STENCIL | arpeggiator-bottom-stencil | external | JLCPCB | JLCPCB | https://jlcpcb.com/pcb-stencil |  | quoted 23 oct 2026, before coupon
