EwoudVV/arpeggiator/case/arpeggiator-assembly.step

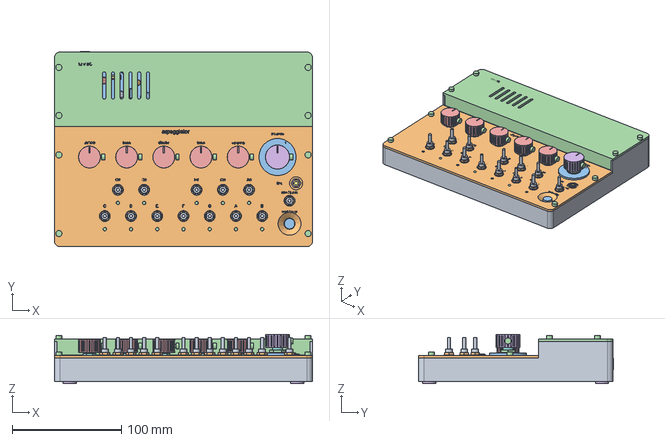
[picture p11: CAD file, 2026-10-22]
case/arpeggiator-assembly.step
236.0 x 178.7 x 45.1 mm
