EwoudVV/arpeggiator/case/rear-cover.stl

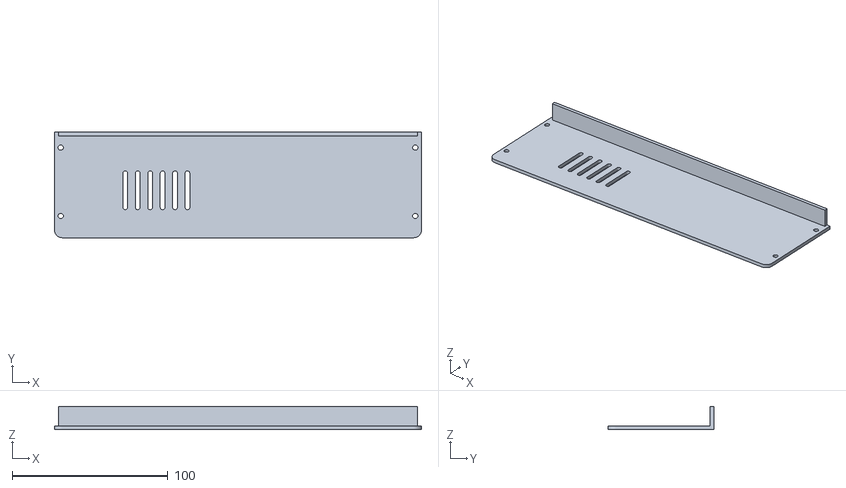
[picture p12: CAD file, 2026-10-22]
case/rear-cover.stl
236.0 x 67.8 x 14.9
