EwoudVV/arpeggiator/case/fit-coupon.stl

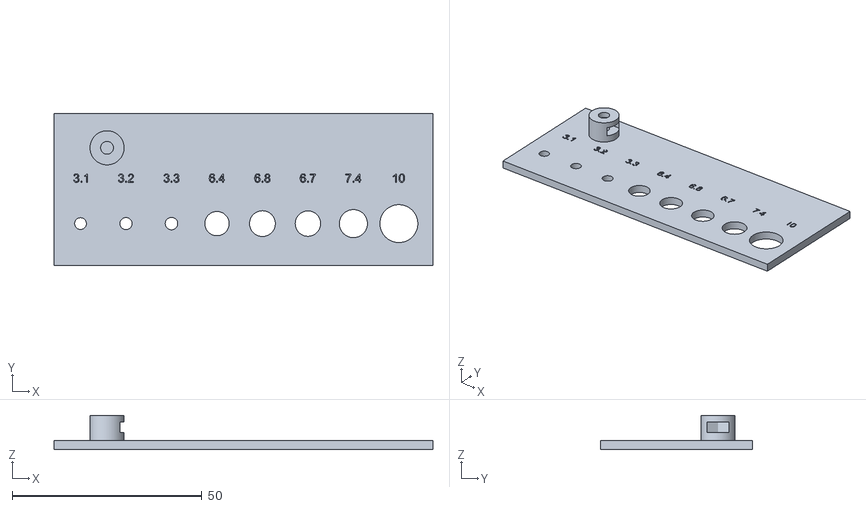
[picture p13: CAD file, 2026-10-22]
case/fit-coupon.stl
100.0 x 40.0 x 9.00
