EwoudVV/arpeggiator/case/base.stl

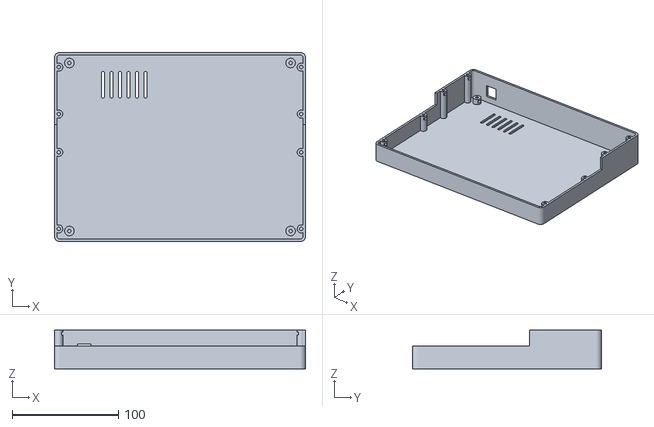
[picture p14: CAD file, 2026-10-22]
case/base.stl
236.0 x 178.0 x 36.6
