EwoudVV/arpeggiator/case/pot-knob.stl

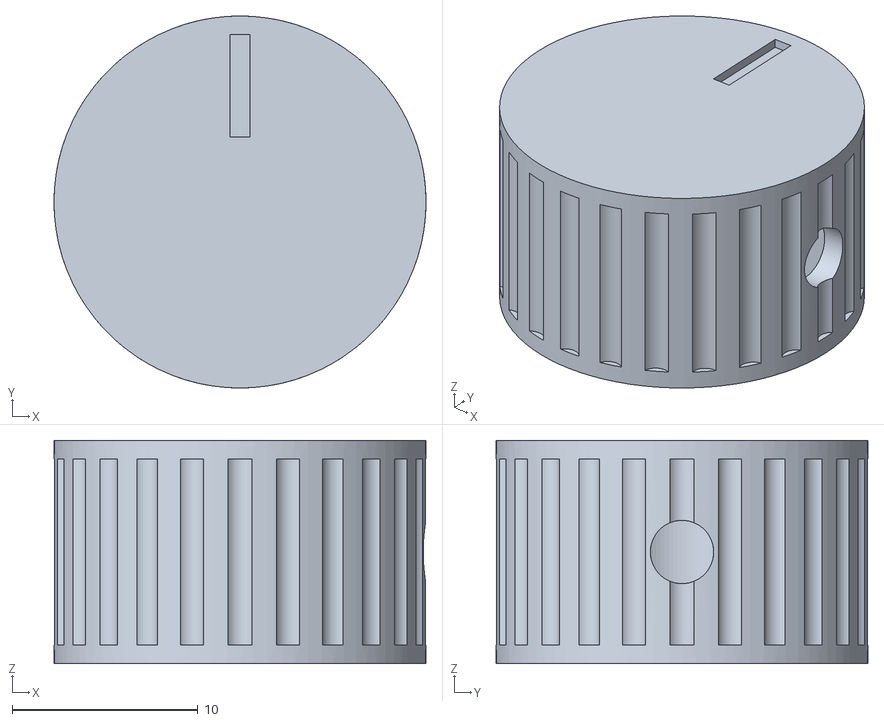
[picture p15: CAD file, 2026-10-22]
case/pot-knob.stl
20.0 x 20.0 x 12.0
