EwoudVV/arpeggiator/case/arpeggiator-case.FCStd

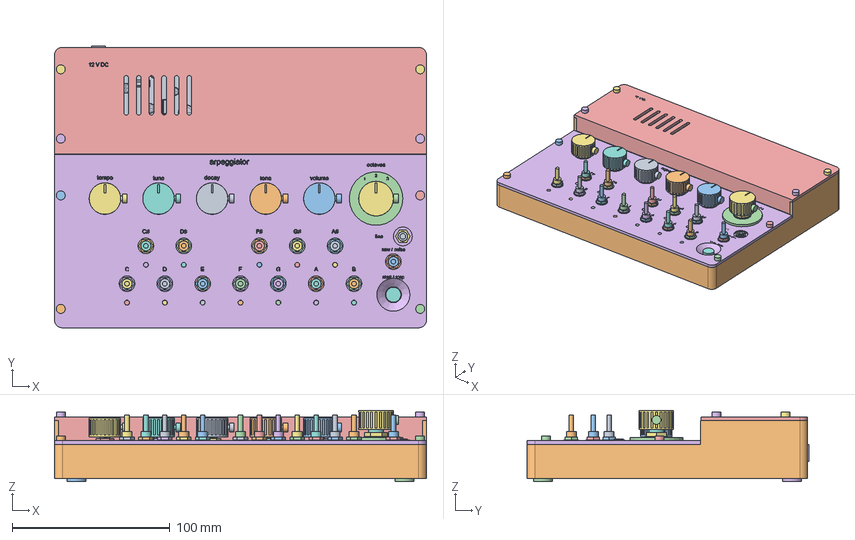
[picture p16: CAD file, 2026-10-22]
case/arpeggiator-case.FCStd
236.0 x 178.7 x 45.1 mm
line jack001
base tray
start switch
C603 body
D221 light pipe
D222 light pipe
D223 light pipe
D224 light pipe
D225 light pipe
D226 light pipe
D227 light pipe
D228 light pipe
D229 light pipe
D230 light pipe
D231 light pipe
D232 light pipe
DC input body
fit coupon
rubber foot
rubber foot001
rubber foot002
rubber foot003
knob1
knob2
knob3
knob4
knob5
octave collar001
rear cover001
control panel001
MountJackNut
MountJackWasher
M3 knob nut
M3 knob nut001
M3 knob nut002
M3 knob nut003
M3 knob nut004
M3 knob nut005
M3 x 8 knob screw
M3 x 8 knob screw001
M3 x 8 knob screw002
M3 x 8 knob screw003
M3 x 8 knob screw004
M3 x 8 knob screw005
MountPotNut0
MountPotNut1
MountPotNut2
MountPotNut3
MountPotNut4
MountPotWasher0
MountPotWasher1
MountPotWasher2
MountPotWasher3
MountPotWasher4
MountRotaryNut
MountRotaryWasher
MountToggleNut0
MountToggleNut1
MountToggleNut10
MountToggleNut11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
