EwoudVV/arpeggiator/case/octave-collar.stl

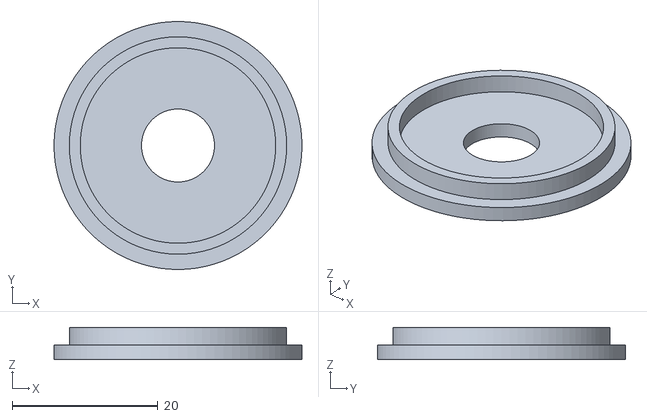
[picture p17: CAD file, 2026-10-22]
case/octave-collar.stl
34.0 x 34.0 x 4.40
