EwoudVV/arpeggiator/case/octave-knob.stl

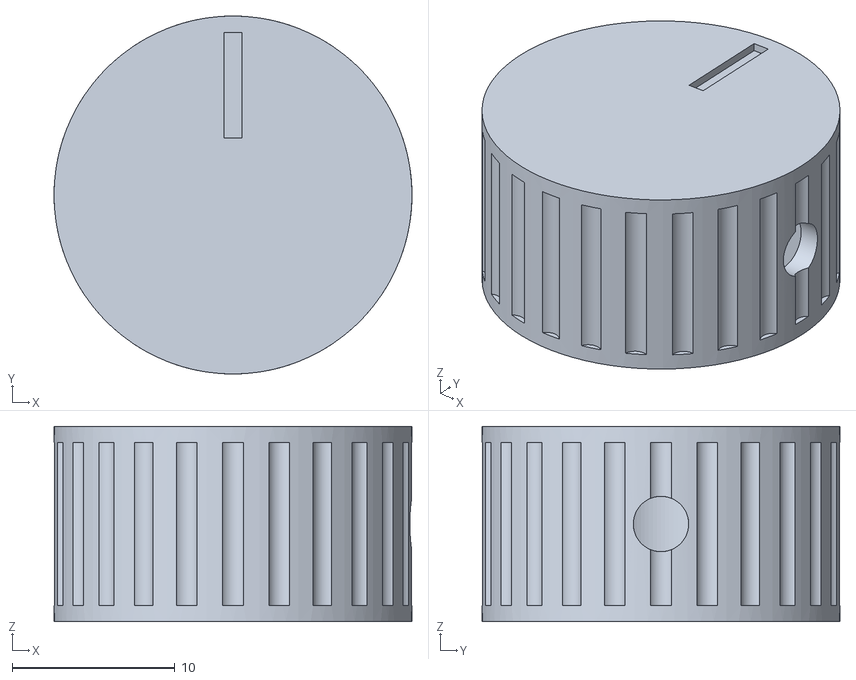
[picture p18: CAD file, 2026-10-22]
case/octave-knob.stl
22.0 x 22.0 x 12.0
