EwoudVV/arpeggiator/case/control-panel.stl

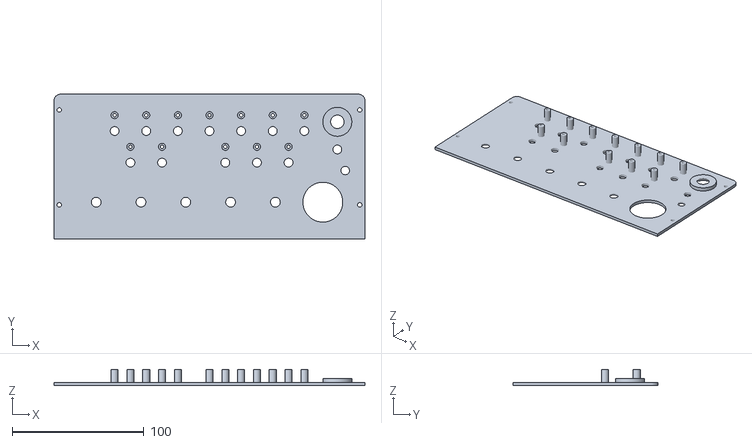
[picture p19: CAD file, 2026-10-22]
case/control-panel.stl
236.0 x 109.8 x 12.2
