EwoudVV/arpeggiator/JOURNAL.md

# journal

## October 19, 2026

10 hours

Devlog 01: sequencer circuit

started the arpeggiator for music week. i'm making it with analog circuits and logic chips, with no microcontroller. settled on 12 note switches and a selector that repeats the chosen notes across one, two or three octaves. set up the repo and Half Life project too

drew the sequencer in KiCad, including the switch inputs, clocks, counters, octave selection, start/stop and note LEDs. one clock sets the tempo and a much faster one searches for the next enabled note. a separate register holds the sounding note steady while that search happens

added a settling step before triggering each note, then put the trigger through a register so a brief glitch from the state decoder won't become an extra note. also added reset and mute behaviour for an empty selection or an invalid state

checked the exported connections and tested the clocked model with every note-switch combination and octave range. also checked changing the selection, stopping during a search and restarting. ERC is clean for this section. these are circuit and model checks, not physical tests

looked into the pitch-voltage parts too. ordinary analog switches can leak enough current to affect the tuning, so i'm planning a precision switch and 0.1% resistors for that section. the sound circuit, main supply, PCB and case are next. nothing built yet

sequencer

note-switches

arpeggiator-03_clock_range

arpeggiator-04_input_registers

arpeggiator-06_pitch_register

arpeggiator-events

arpeggiator-logic_02

arpeggiator-logic_03

arpeggiator-logic_05

arpeggiator-logic_06

## October 19, 2026

4 hours

Devlog 02: pitch and sound circuit

added the part that turns the note numbers into sound. the note register selects a voltage from the resistor ladder, and a second switch selects the octave. both go into the AS3340A oscillator, with trimmers for tuning and tracking

the saw and pulse outputs feed an LM13700 amplifier. each note charges an envelope capacitor, then the decay knob controls how quickly it fades. stop discharges that capacitor too. after the amplifier there is a simple tone control, volume knob and a mono line output

i checked the reference and resistor values, and ran models of the envelope and amplifier current source. i also went back through the sequencer checks with the sound circuit connected. the schematic passes ERC. the oscillator will still need tuning and checking once the board exists

next is finishing the power supply and choosing the actual controls and parts before laying out the PCB

arpeggiator-10_oscillator

arpeggiator-11_envelope

arpeggiator-12_amplifier

arpeggiator-08_reference

## October 20, 2026

8 hours

Devlog 03: power supply and reset

added the power supply. the 12 V input has a fuse and reverse-polarity protection. a 7805 supplies the logic, and an LT1054 charge pump feeds a 7905 for the negative analog rail

added checks for the input voltage and negative rail alongside the existing 5 V reset. the sequencer stays reset until the supplies are ready. a switch mutes the line output while stopped, and the envelope discharge circuit now runs from 12 V so it still works if 5 V disappears

checked the current and heat estimates and reset thresholds, and ran models of a few startup and power-loss cases. also checked stopping partway through the envelope's charge pulse and restarting without an extra note. the sequencer checks still pass and ERC is clean. the switching supply and startup behaviour still need checking on the real board

started the BOM and found sources for the main chips and calibration parts. the AS3340A will use a DIP package, which should be easier to solder and replace. the front controls, a few capacitors and their footprints are next, then PCB placement

arpeggiator-15_input_power

arpeggiator-16_negative_supply

arpeggiator-17_negative_monitor

arpeggiator-18_input_monitor

arpeggiator-19_reset_output

arpeggiator-13_line_output

arpeggiator-14_analog_power

arpeggiator-10_oscillator

## October 20, 2026

8 hours

Devlog 04: controls and first PCB placement

picked the switches, pots, jack and film capacitors and finished their footprints. checked the knob directions too. clockwise now means faster tempo, higher pitch, longer decay, brighter tone and more volume. the note switches select a note when pushed up

the octave selector has exactly three positions. it uses two poles to encode the range, with the other two left open. the tempo pot is 250k with a resistor across it to keep the nominal range around 38-240 BPM

started the PCB. it is 220 x 170 mm with two copper layers and four mounting holes. the controls are on the front in two piano-style rows, with most of the small circuit parts on the back. the supply parts are grouped at the rear, away from the controls

made a footprint for the mute switch using TI's recommended land pattern. the wider pads in the generic footprint were too close for the board's clearance setting. also checked the switch commons, jack contacts and the pot support tabs against their drawings

the schematic passes ERC and the sequencer checks still pass. the board is only a first placement, with no routed tracks yet. routing and the case are next, and the physical fits will still need checking when the parts arrive

pcb-front

pcb-back

arpeggiator-01_controls_a

arpeggiator-03_clock_range

arpeggiator-13_line_output

SW_Alpha_SR2612F_4P3T

VSSOP-8_DGK0008A_TI

Jack_PJ-3001F_Vertical

## October 22, 2026

15 hours

Devlog 05: routing the board

finally got the PCB routed. the power section and analog circuit went in first, followed by all the connections between the logic chips. kept the note switches and the rest of the controls where they were

i started with two layers, but the ground connections were getting stuck between all the signal tracks. changed it to four layers, with both inner layers used for ground. that sorted out the remaining connections without having to move everything around again

the board passes DRC now. next is making a case for it, then getting the parts and board ordered

routed PCB, front

routed PCB, back

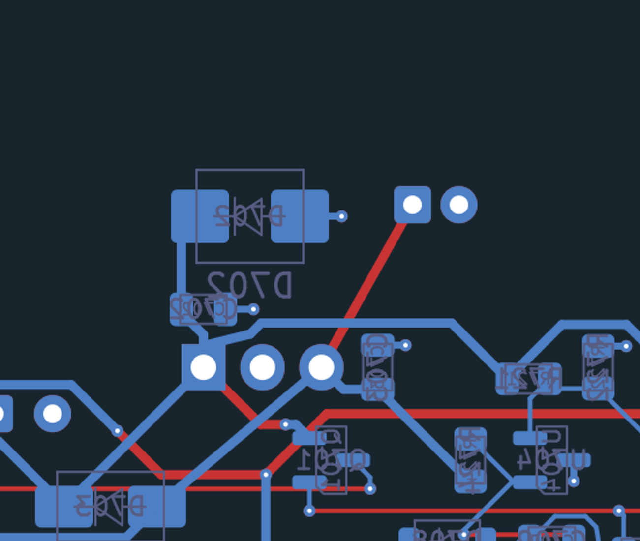
[picture p20: images/routing/5v-supply.png]
5v supply


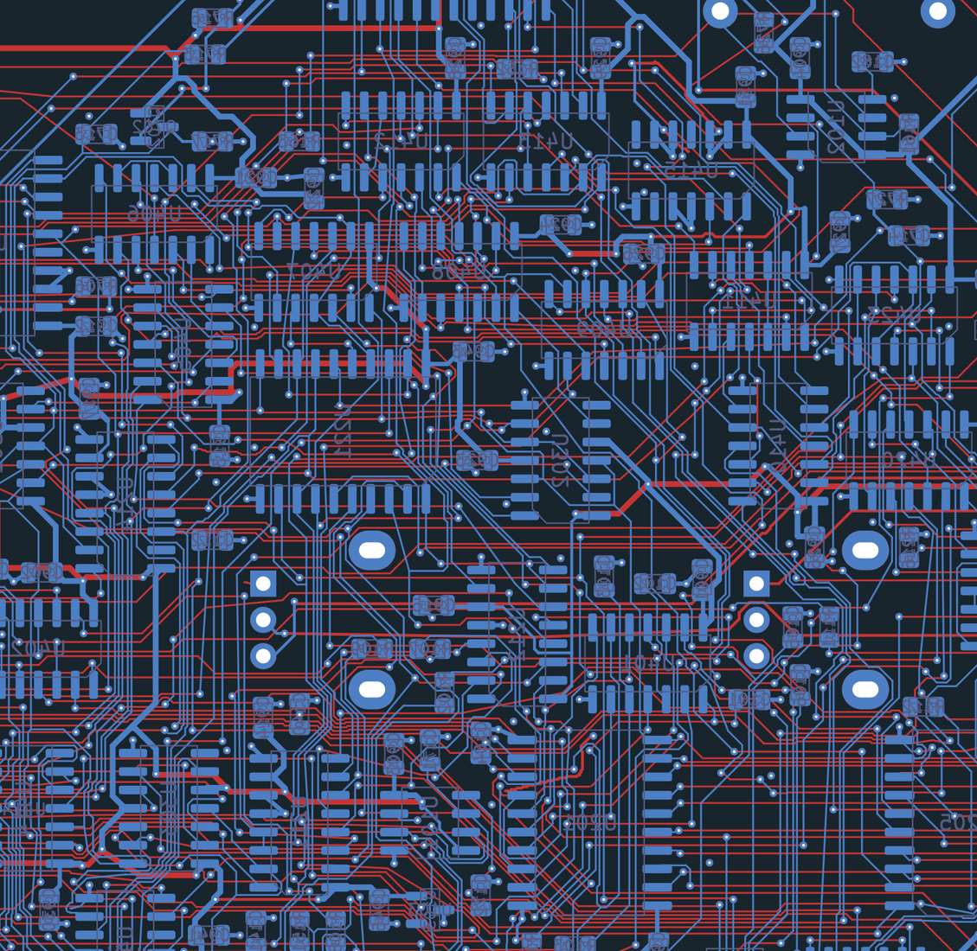
[picture p21: images/routing/clock-and-start.png]
clock and start


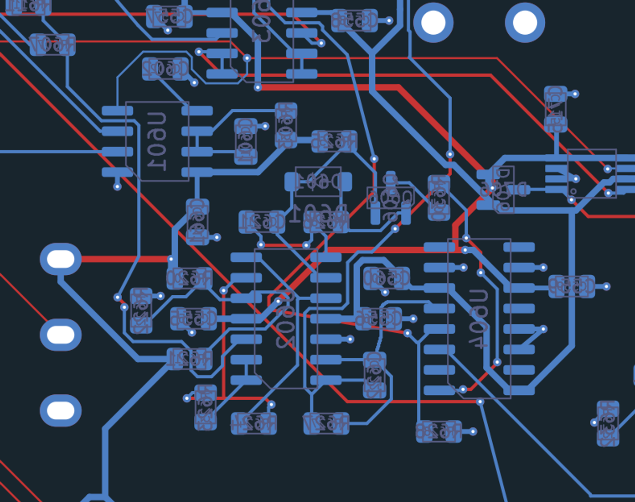
[picture p22: images/routing/envelope-and-vca.png]
envelope and vca


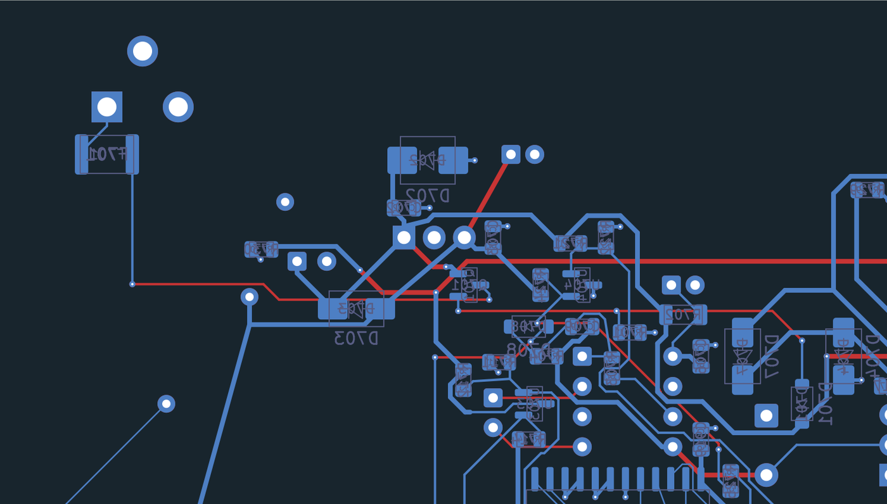
[picture p23: images/routing/input-power.png]
input power


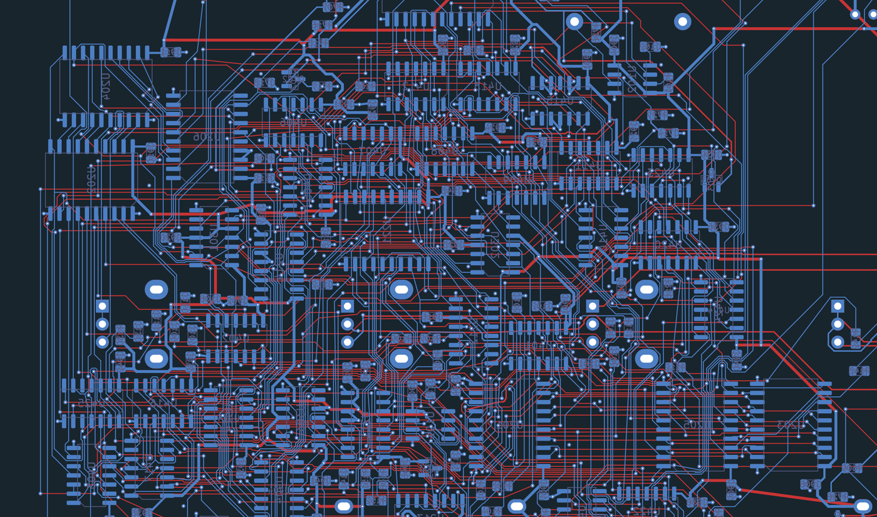
[picture p24: images/routing/input-registers.png]
input registers


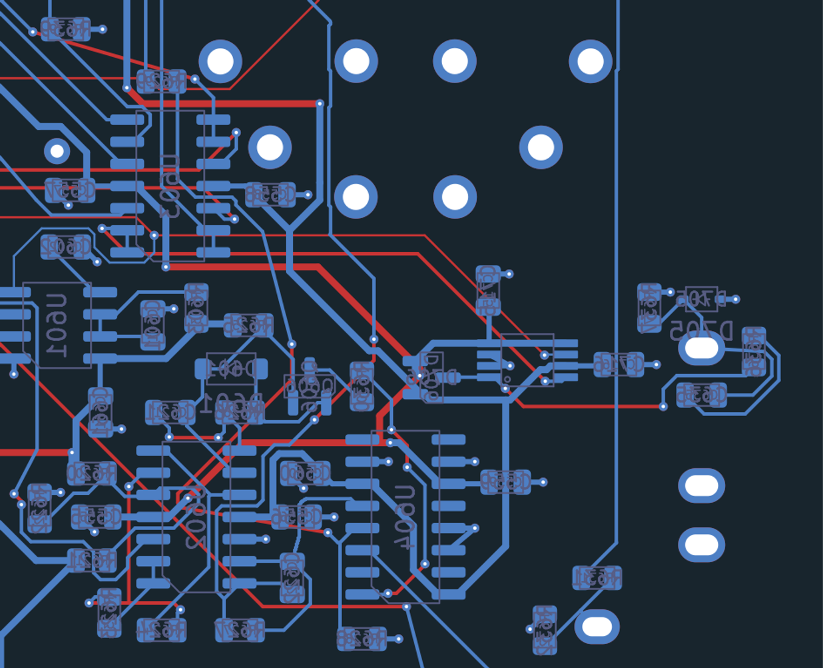
[picture p25: images/routing/line-output.png]
line output


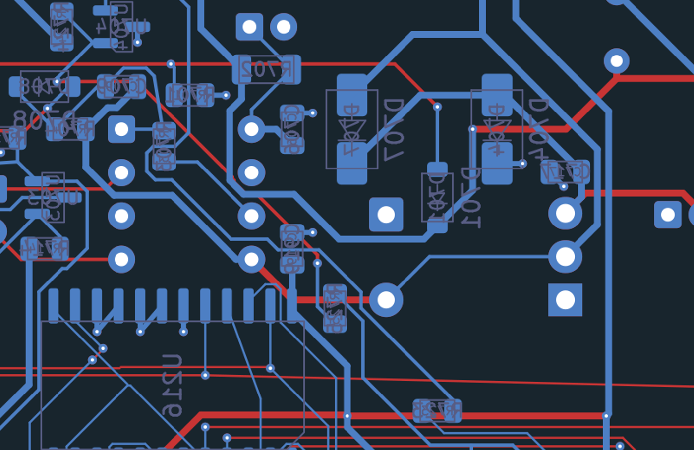
[picture p26: images/routing/negative-supply.png]
negative supply


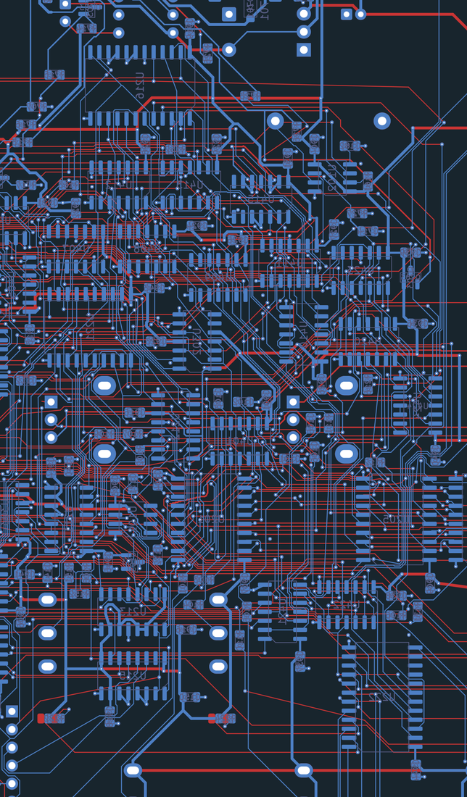
[picture p27: images/routing/note-multiplexer.png]
note multiplexer


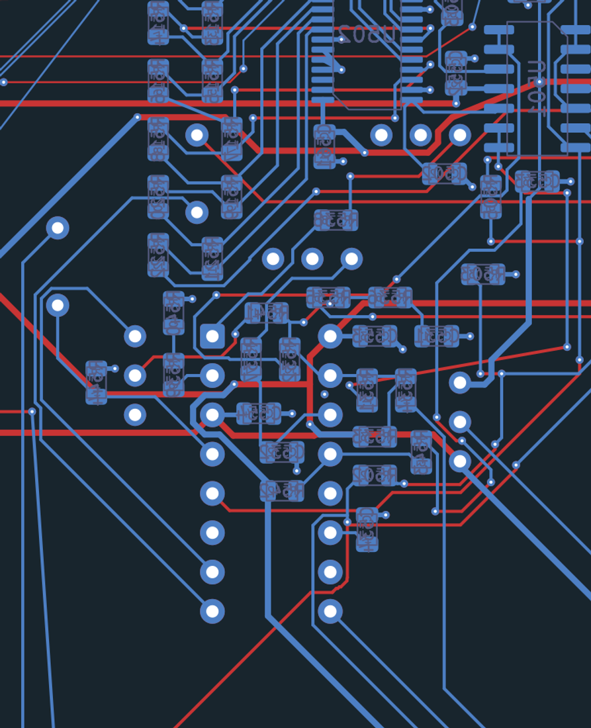
[picture p28: images/routing/oscillator.png]
oscillator


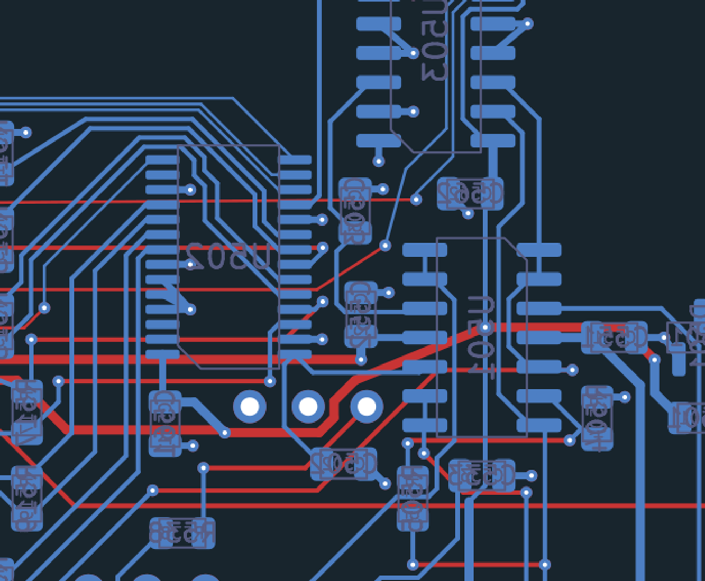
[picture p29: images/routing/pitch-reference.png]
pitch reference


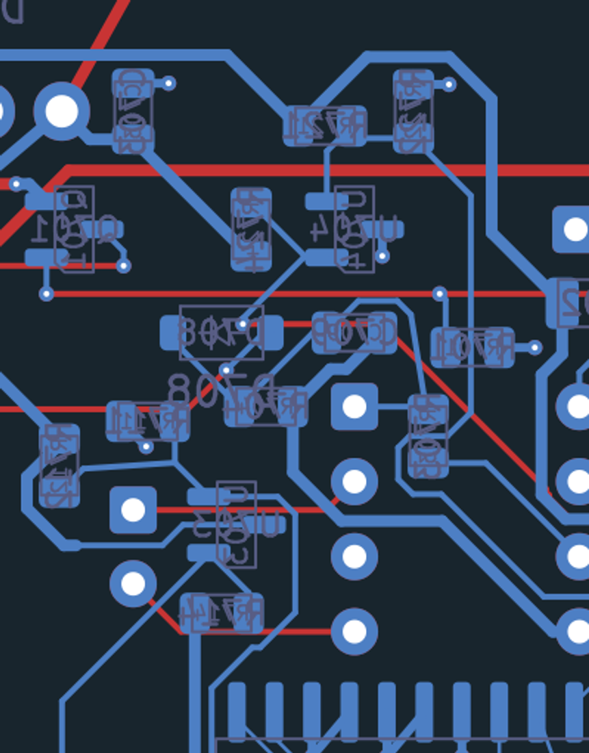
[picture p30: images/routing/rail-monitors.png]
rail monitors


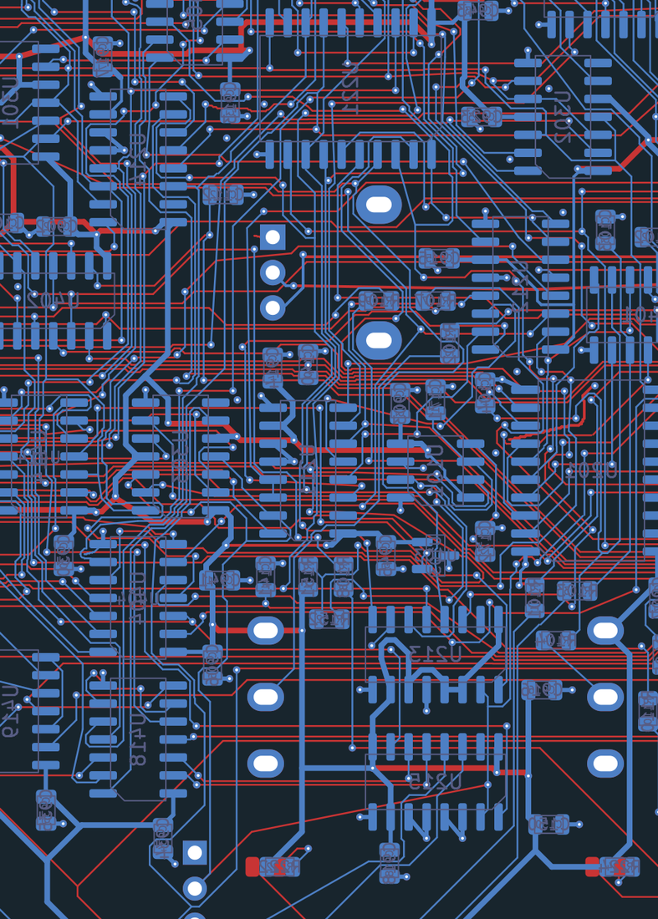
[picture p31: images/routing/search-counters.png]
search counters


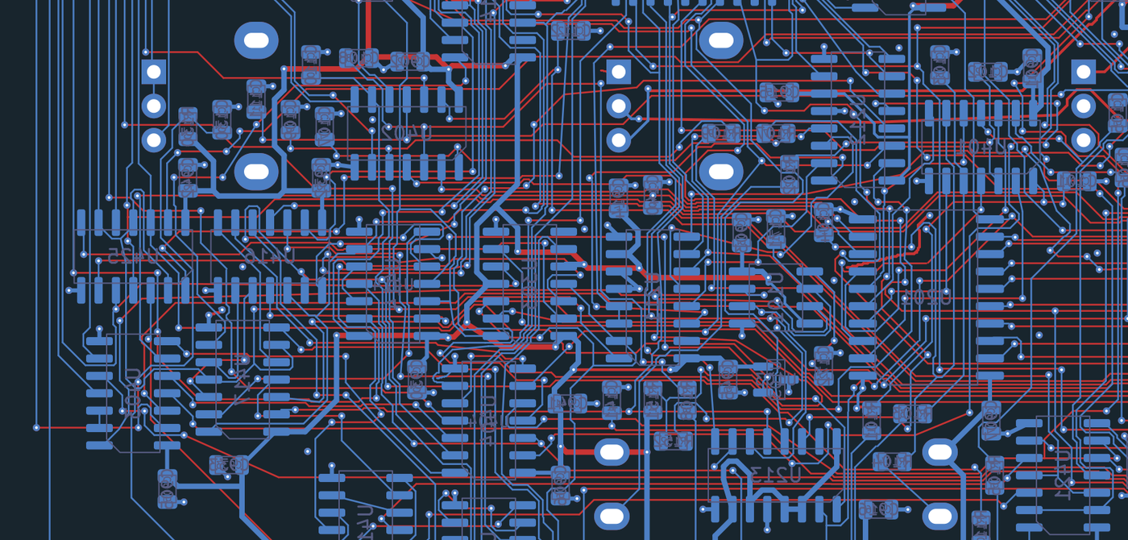
[picture p32: images/routing/switch-inputs.png]
switch inputs


## October 22, 2026

2 hours

Devlog 06: the case

made the case around the PCB. the controls stay in the same layout, with a low front panel and a taller cover over the power supply. the rear cover comes off so i can reach the tuning trimmers

added the board mounts, screw pockets and six printed knobs. the note LEDs use short pieces of clear acrylic rod to reach the panel. there's also a small fit sample to print before the bigger parts

caught the DC jack facing into the board while checking the case. turned it toward the back so the plug can actually reach it. the power trace stayed in place, and the board still passes DRC

case

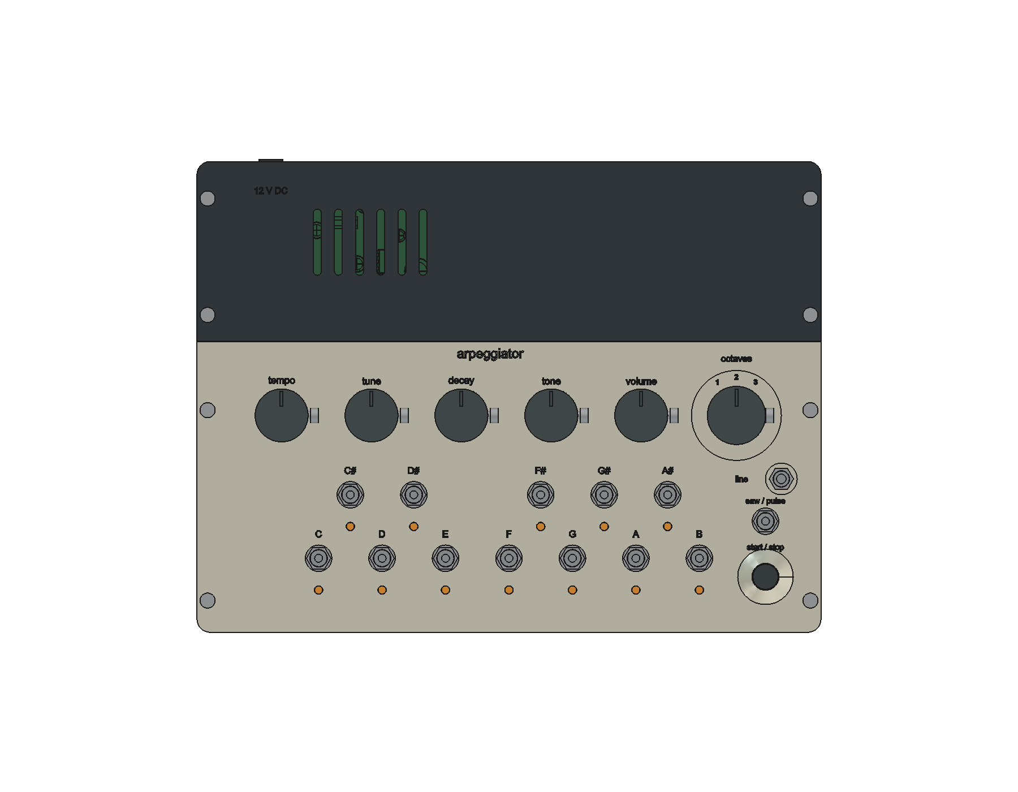
[picture p33: images/case-top.png]
controls


inside

## October 23, 2026

5 hours

Devlog 07: parts and quotes

spent this session picking parts and trying to get the price down. a few of the original part numbers were unavailable, so i checked replacements and updated the BOM. the mute switch is now the automotive version of the same TI chip, and the fuse is a 350mA Bourns part

the PCB quotes were expensive. changed the via drills to 0.3mm and used 0.5 oz copper for the two inner ground planes. five boards and a bottom stencil now quote at $62.27 before delivery and tax

put together the parts carts too. moved the fuse and mute switch into the other orders so there is no separate DigiKey shipment. found a $7 stencil coupon and got $9 off the LCSC shipping. the postage and US fees still add quite a bit

exported the Gerbers and drill files from the saved board and checked the connections again. added the full parts list to the README, plus a separate list with the quantities the shops actually sell. the oscillator supplier's site is still getting stuck on its verification page

PCB, back

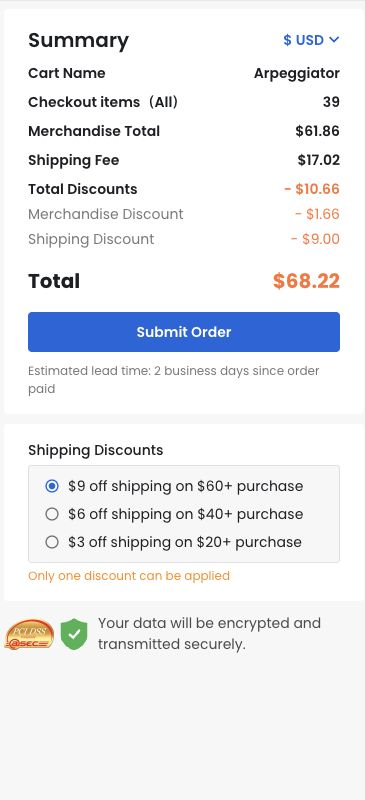
[picture p34: images/quotes/lcsc.png]
LCSC cart


PCB, front

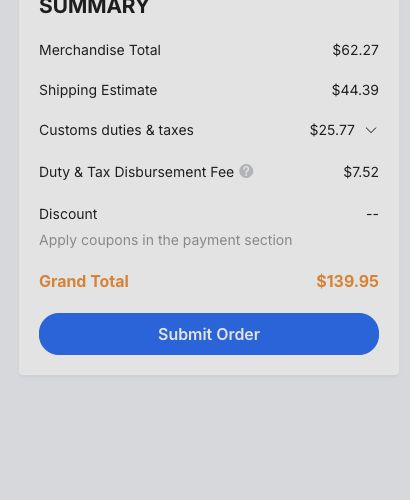
[picture p35: images/quotes/jlc.png]
JLC quote


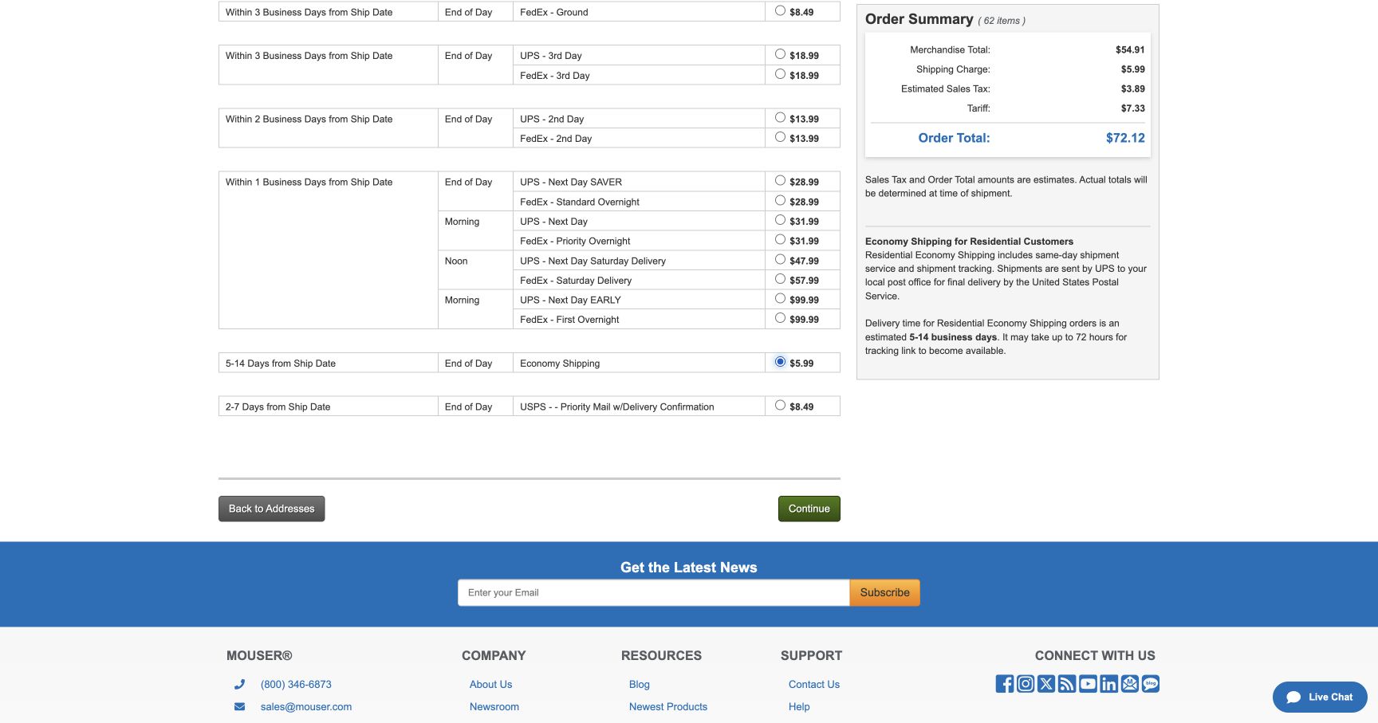
[picture p36: images/quotes/mouser.png]
Mouser quote


## October 23, 2026

5 hours

Devlog 08: getting it ready to submit

put the submission together. checked the saved board against the Gerbers and drill files, and went through the case files, parts list and shop quantities again

looked at cheaper ways to make it, including a two-layer board and different LEDs. those changes needed more work on the layout, so i kept the four-layer board and the existing controls. the cost is still higher than i wanted

filled in the website BOM with the quoted prices and delivery costs. grouped the small parts together so the whole list fits on the site, with every value and part number still in the repo

got the cart screenshots together and made the closing video from the PCB and case renders. next is ordering the parts and building it

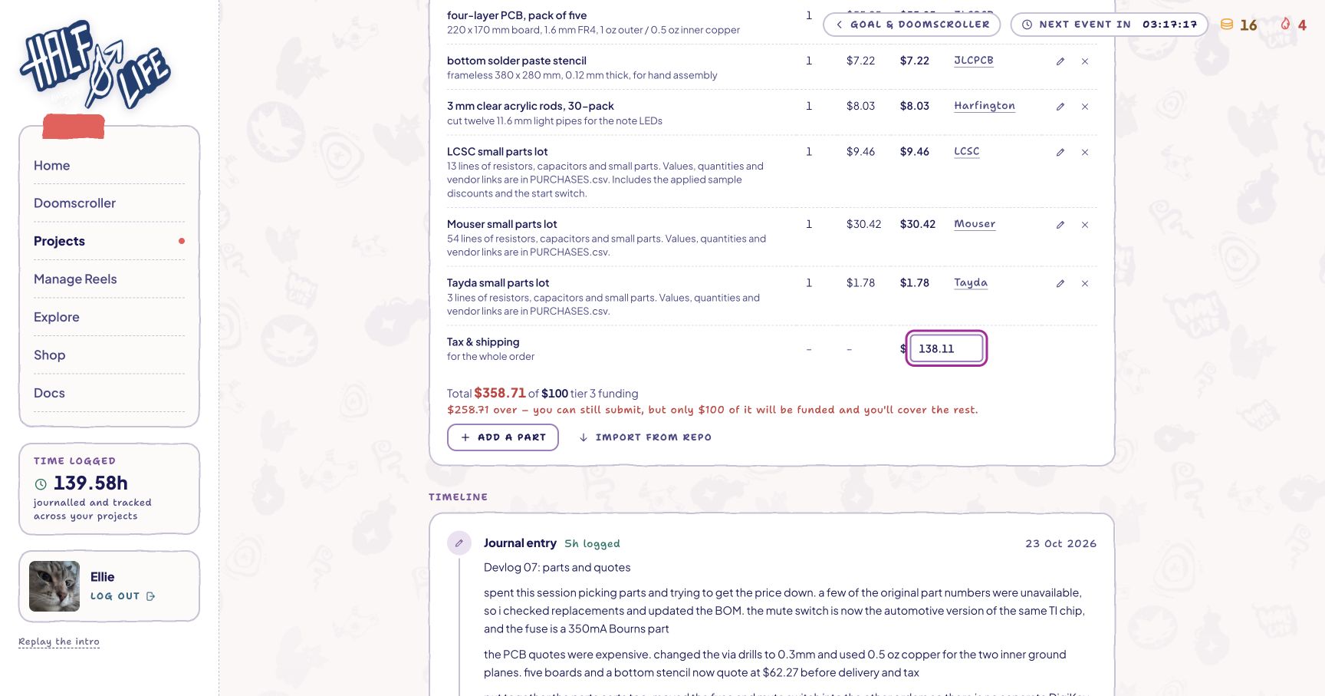
[picture p37: images/quotes/website-bom.png]
website BOM


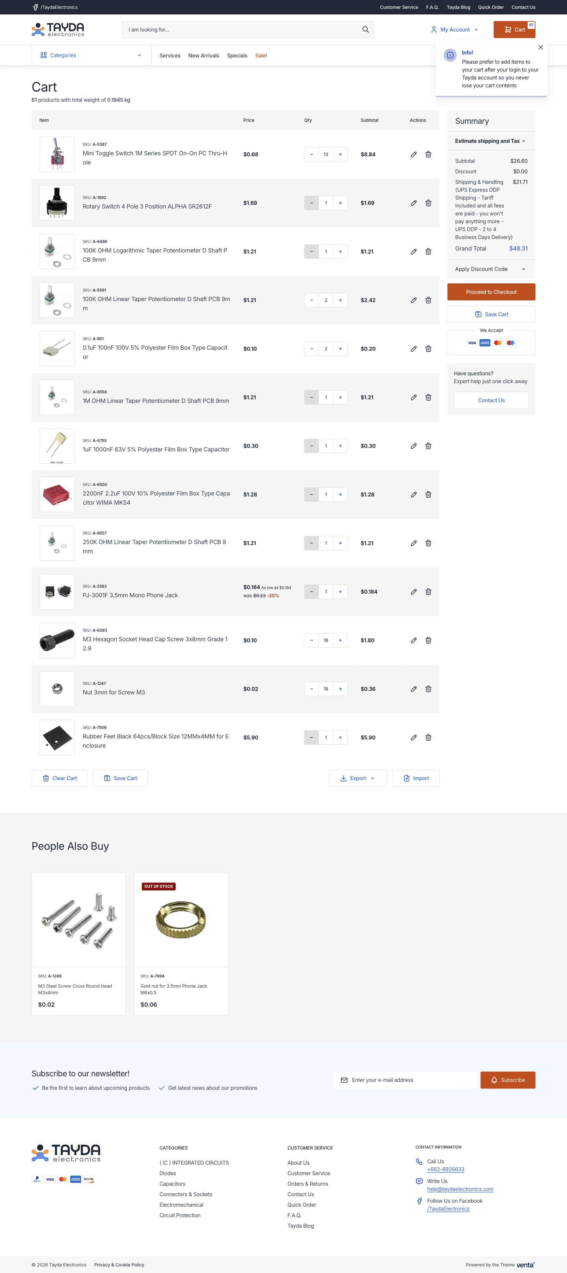
[picture p38: images/quotes/tayda.png]
Tayda cart


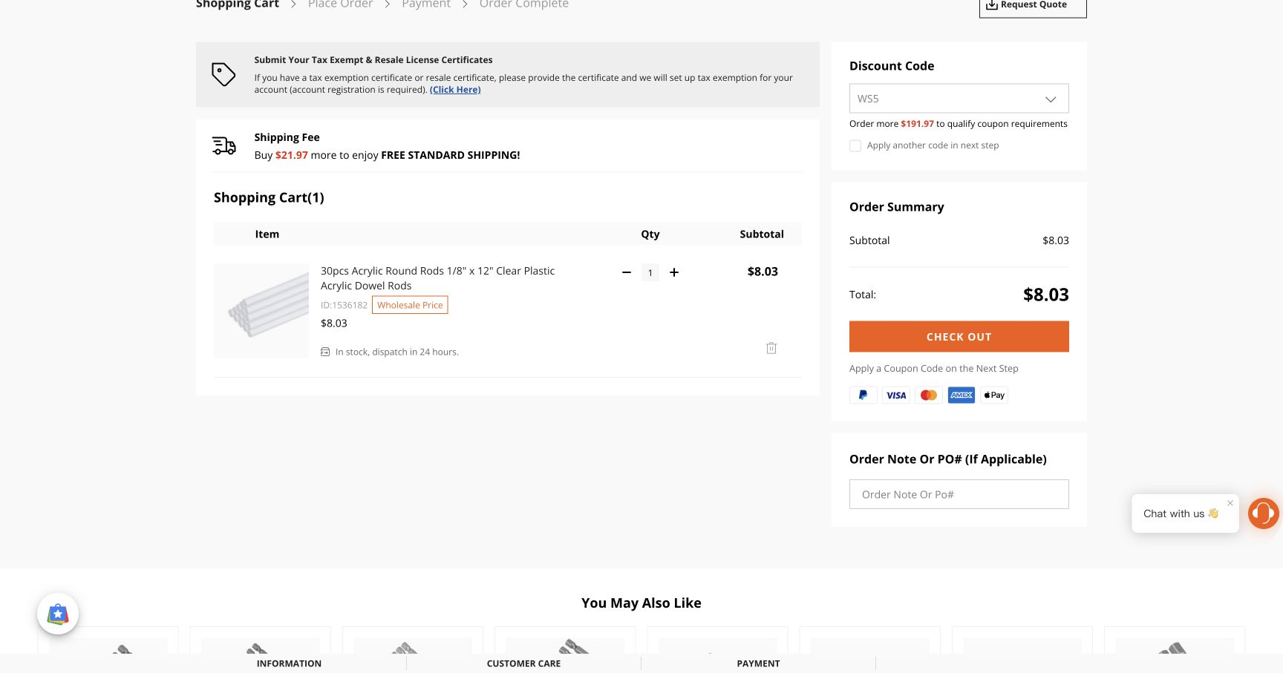
[picture p39: images/quotes/harfington.png]
acrylic rod cart


case

inside
