EwoudVV/arpeggiator/arpeggiator.kicad_pcb

## KiCad design arpeggiator.kicad_pcb (2026-10-23)

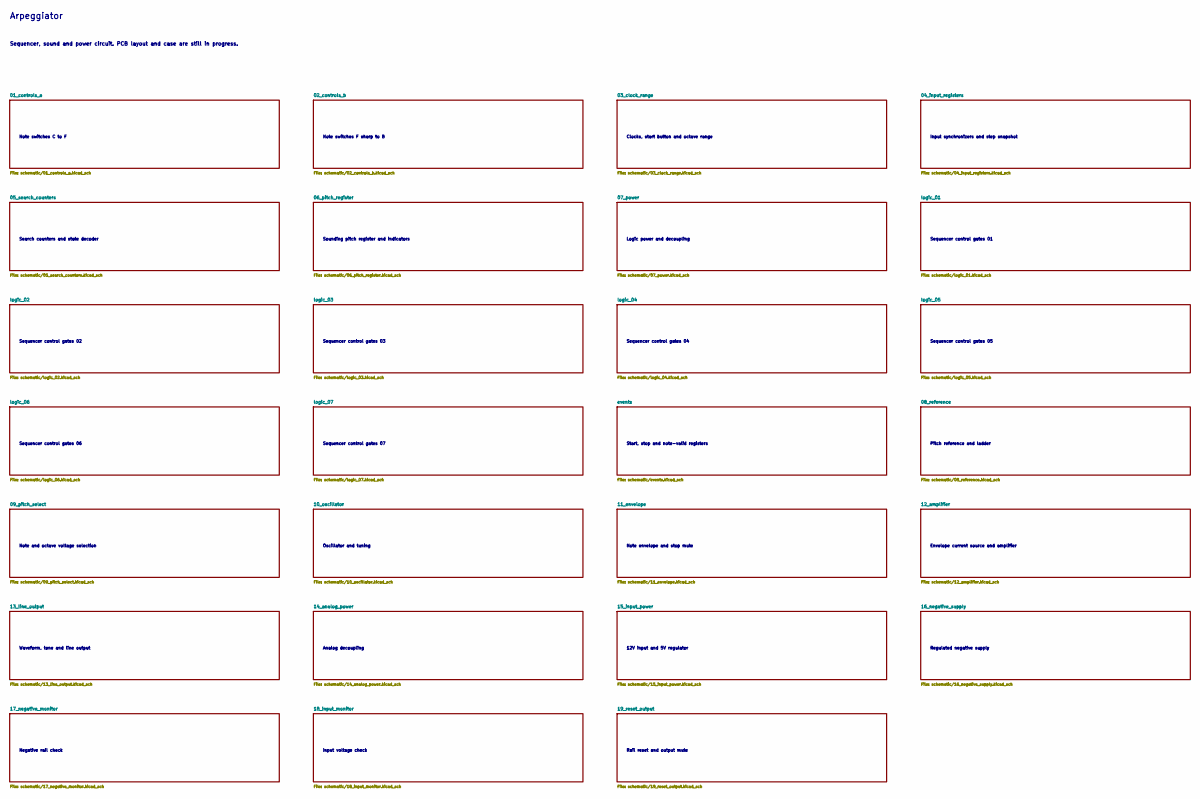
[picture p40: schematic arpeggiator.kicad_sch]

Notes on the sheet:
Arpeggiator
Sequencer, sound and power circuit. PCB layout and case are still in progress.
Note switches C to F
Note switches F sharp to B
Clocks, start button and octave range
Input synchronizers and step snapshot
Search counters and state decoder
Sounding pitch register and indicators
Logic power and decoupling
Sequencer control gates 01
Sequencer control gates 02
Sequencer control gates 03
Sequencer control gates 04
Sequencer control gates 05
Sequencer control gates 06
Sequencer control gates 07
Start, stop and note-valid registers
Pitch reference and ladder
Note and octave voltage selection
Oscillator and tuning
Note envelope and stop mute
Envelope current source and amplifier
Waveform, tone and line output
Analog decoupling
12V input and 5V regulator
Regulated negative supply
Negative rail check
Input voltage check
Rail reset and output mute

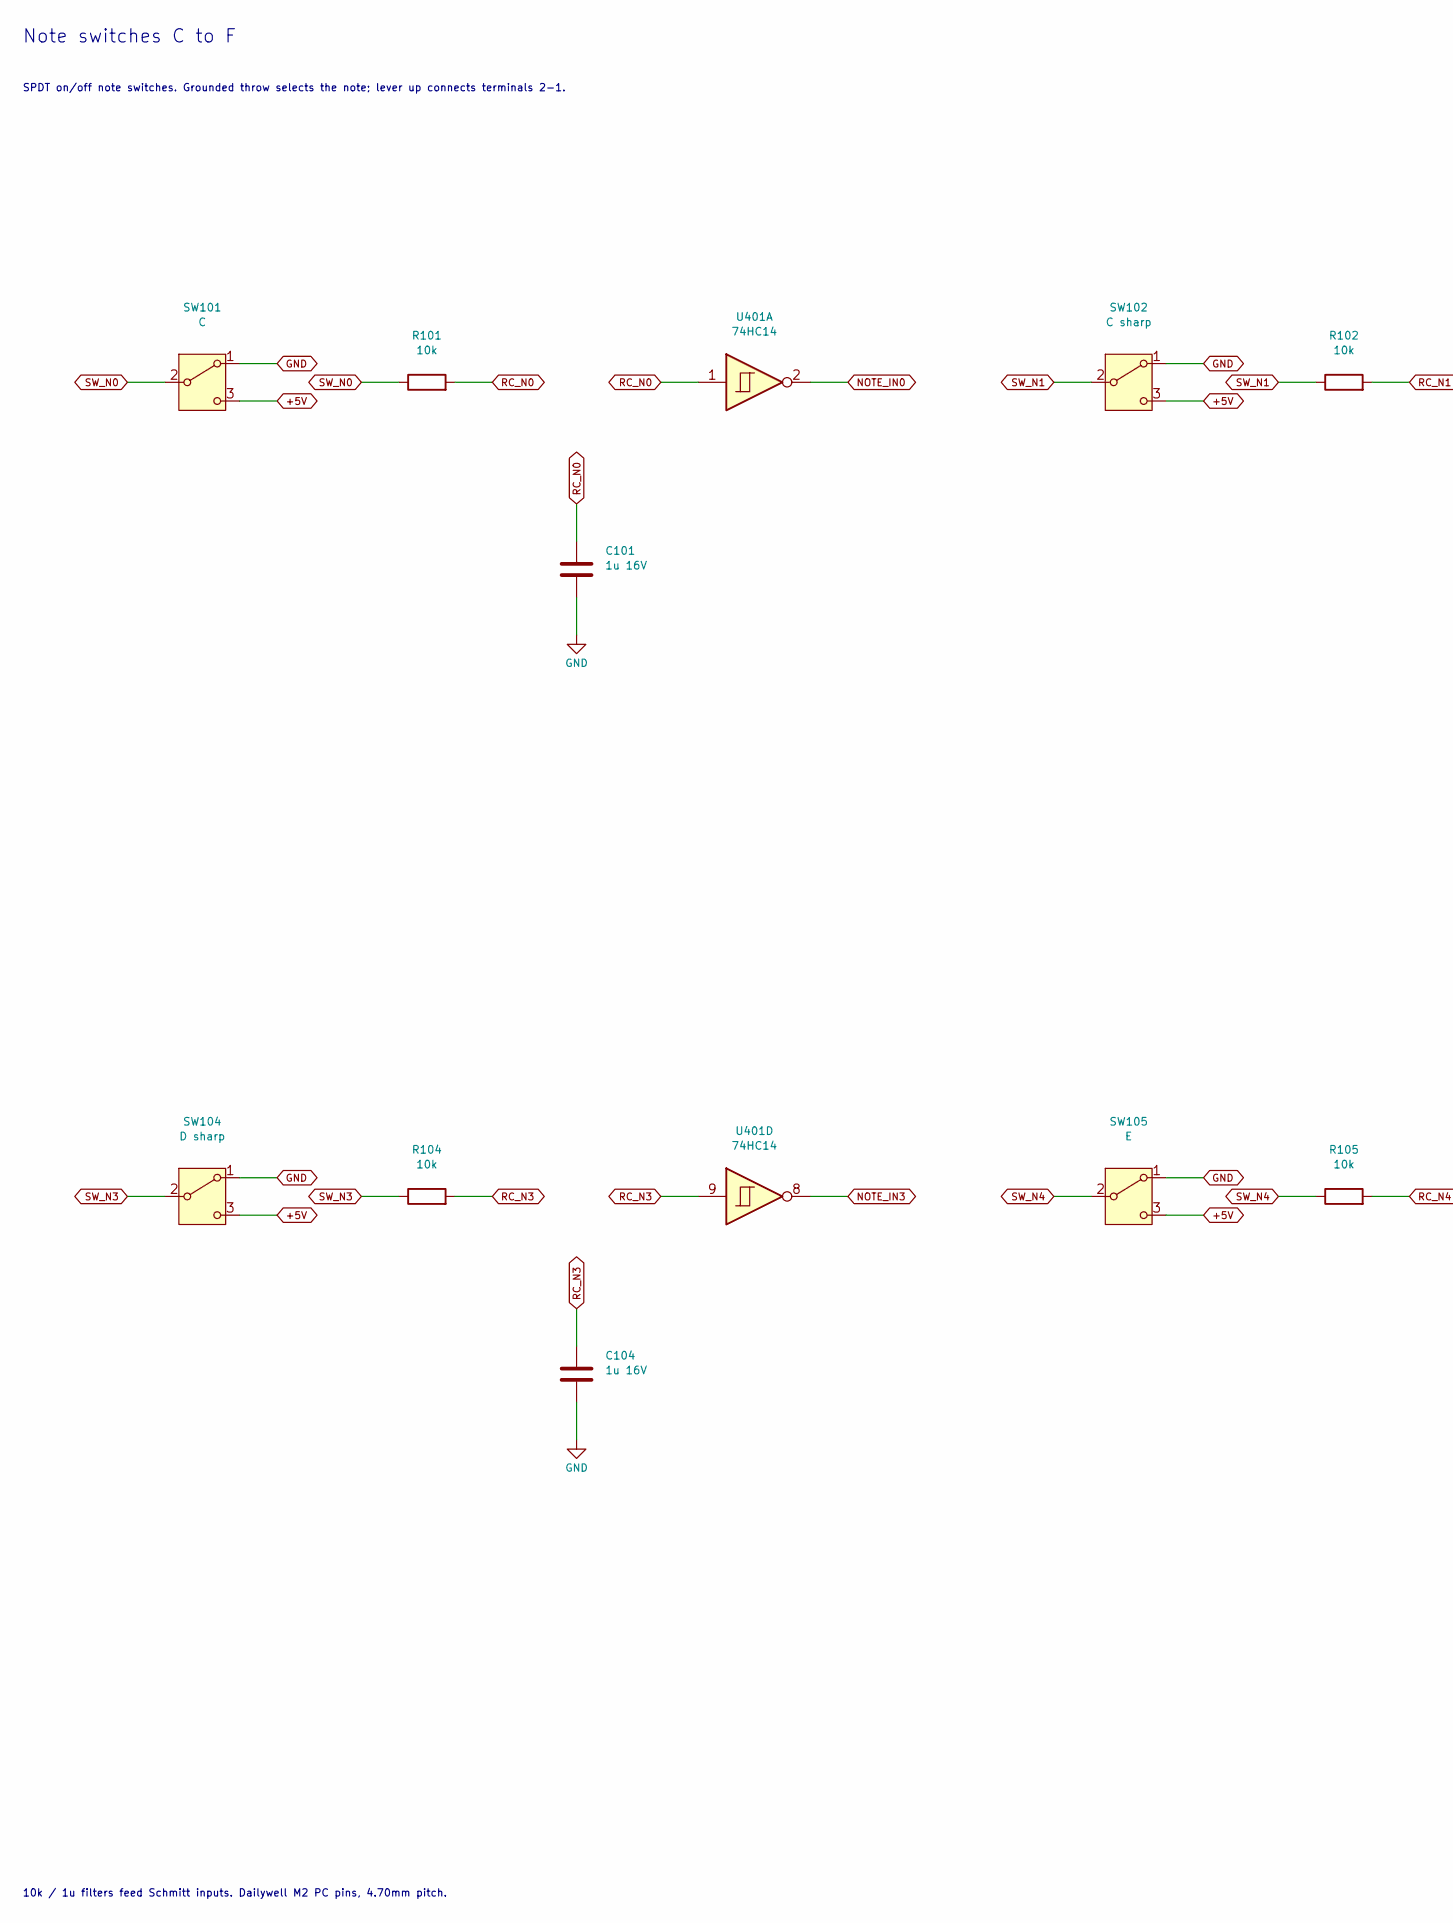
[picture p41: schematic 01_controls_a.kicad_sch, Note switches C to F, part in row 1, column 1]

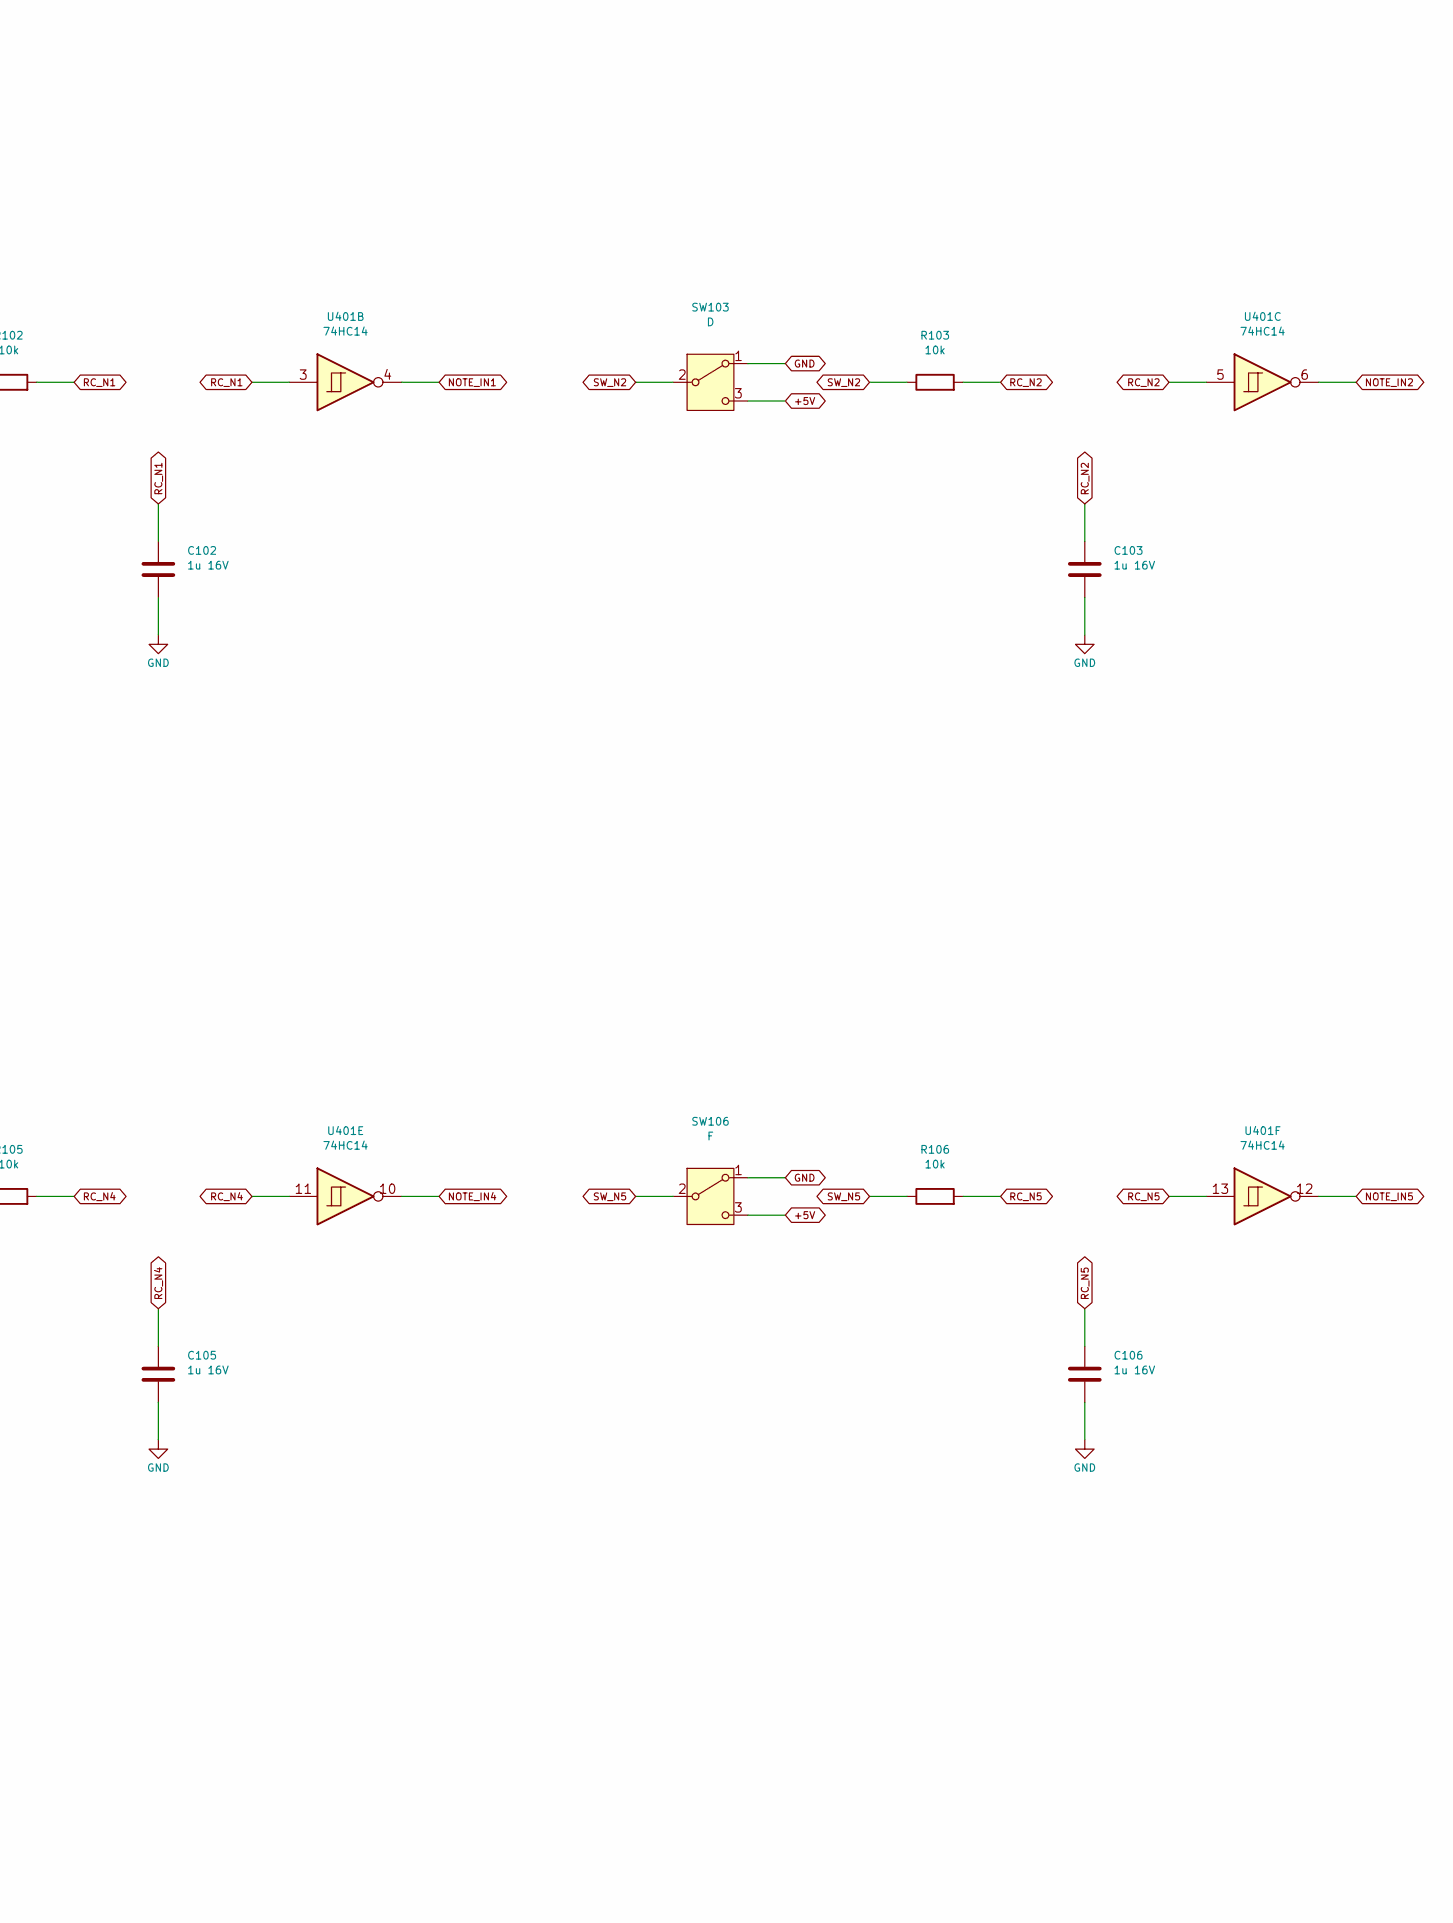
[picture p42: schematic 01_controls_a.kicad_sch, Note switches C to F, part in row 1, column 2]

Parts:
C101, C102, C103, C104, C105, C106: 1u 16V; C_0805_2012Metric
R101, R102, R103, R104, R105, R106: 10k; R_0805_2012Metric
SW101: C; SW_Dailywell_1M_SPDT_M2; MPN 1MS1T1B1M2QES
SW102: C sharp; SW_Dailywell_1M_SPDT_M2; MPN 1MS1T1B1M2QES
SW103: D; SW_Dailywell_1M_SPDT_M2; MPN 1MS1T1B1M2QES
SW104: D sharp; SW_Dailywell_1M_SPDT_M2; MPN 1MS1T1B1M2QES
SW105: E; SW_Dailywell_1M_SPDT_M2; MPN 1MS1T1B1M2QES
SW106: F; SW_Dailywell_1M_SPDT_M2; MPN 1MS1T1B1M2QES
U401: 74HC14; SOIC-14_3.9x8.7mm_P1.27mm; MPN 74HC14D,653

Connections:
+5V: SW101.3 (C), SW102.3 (C), SW103.3 (C), SW104.3 (C), SW105.3 (C), SW106.3 (C); also elsewhere on the board
NOTE_IN0: U401.2; also elsewhere on the board
NOTE_IN1: U401.4; also elsewhere on the board
NOTE_IN2: U401.6; also elsewhere on the board
NOTE_IN3: U401.8; also elsewhere on the board
NOTE_IN4: U401.10; also elsewhere on the board
NOTE_IN5: U401.12; also elsewhere on the board
RC_N0: C101.1, R101.2, U401.1
RC_N1: C102.1, R102.2, U401.3
RC_N2: C103.1, R103.2, U401.5
RC_N3: C104.1, R104.2, U401.9
RC_N4: C105.1, R105.2, U401.11
RC_N5: C106.1, R106.2, U401.13
SW_N0: R101.1, SW101.2 (B)
SW_N1: R102.1, SW102.2 (B)
SW_N2: R103.1, SW103.2 (B)
SW_N3: R104.1, SW104.2 (B)
SW_N4: R105.1, SW105.2 (B)
SW_N5: R106.1, SW106.2 (B)

Notes on the sheet:
Note switches C to F
SPDT on/off note switches. Grounded throw selects the note; lever up connects terminals 2-1.
10k / 1u filters feed Schmitt inputs. Dailywell M2 PC pins, 4.70mm pitch.

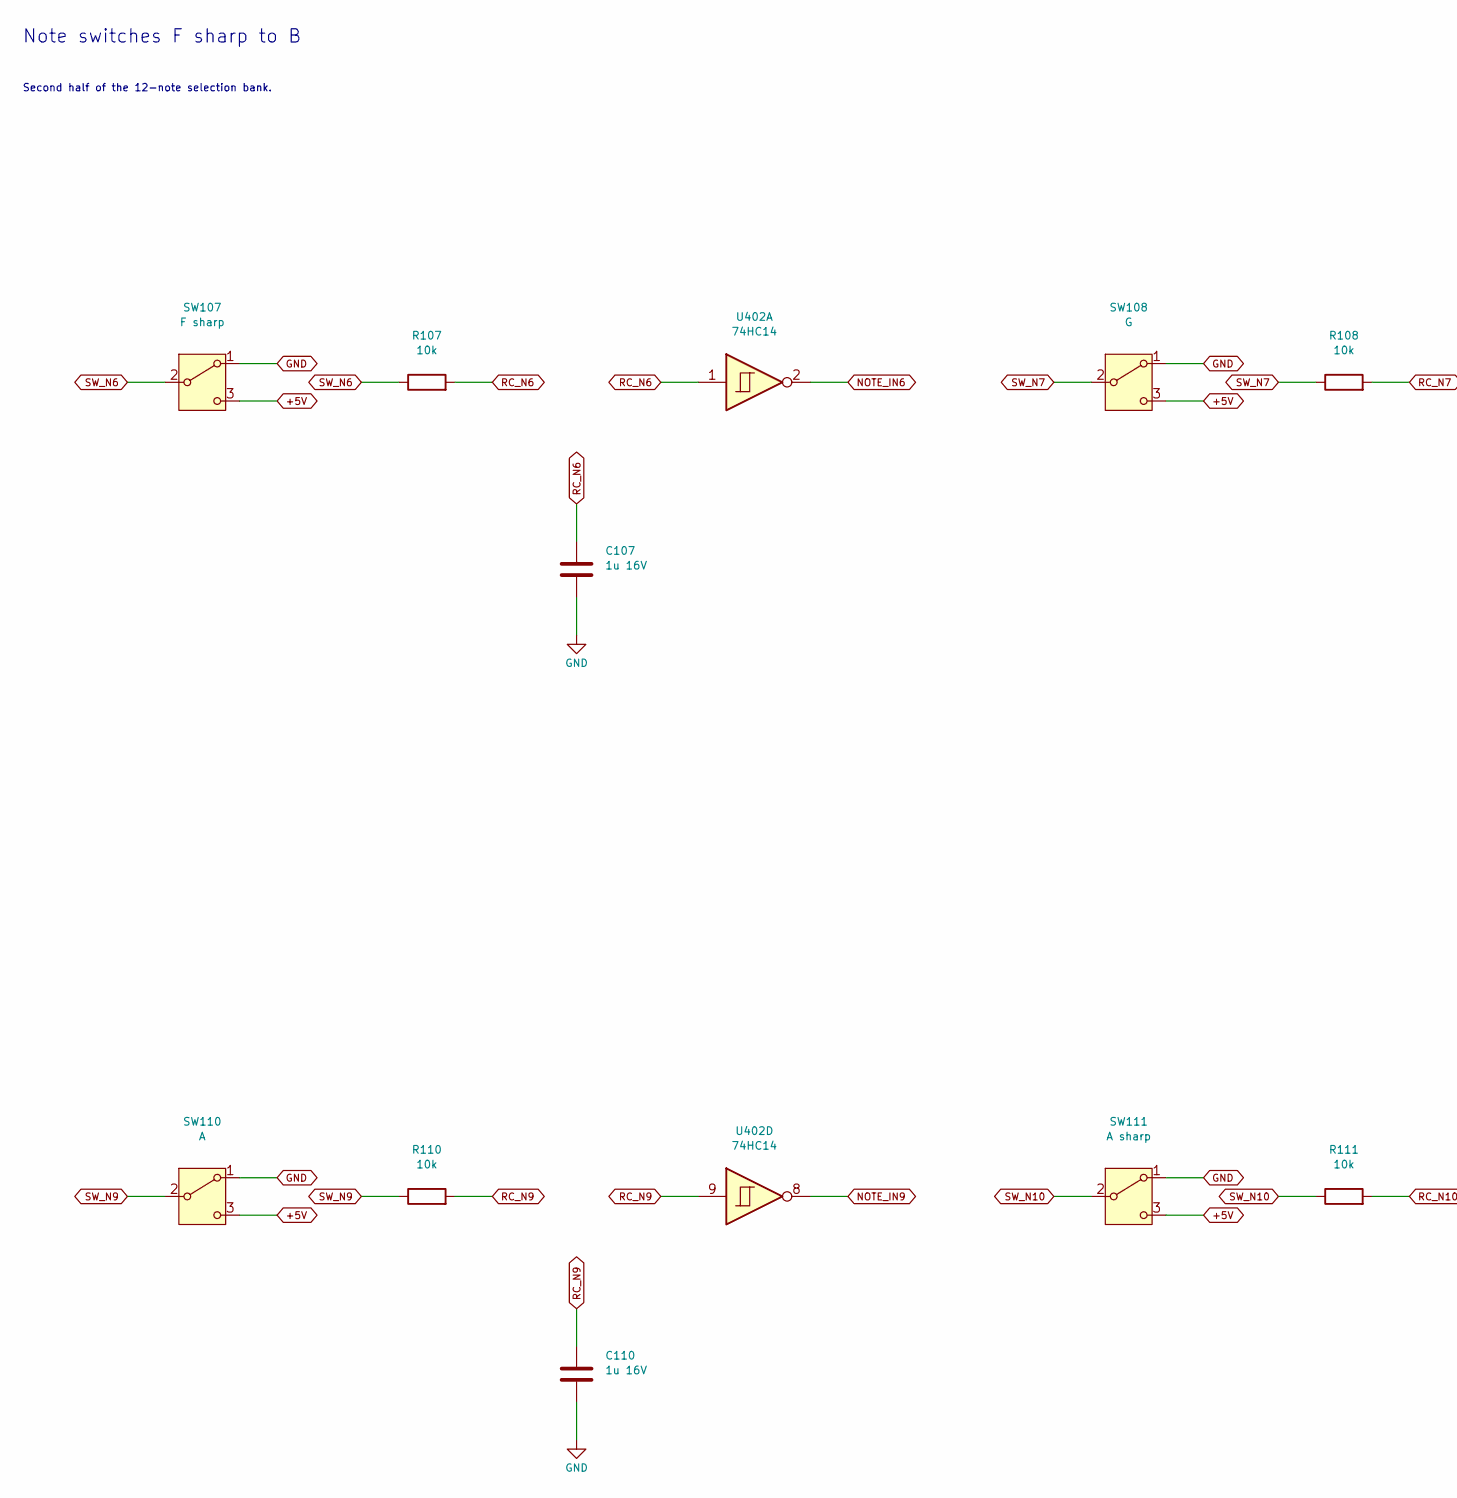
[picture p43: schematic 02_controls_b.kicad_sch, Note switches F sharp to B, part in row 1, column 1]

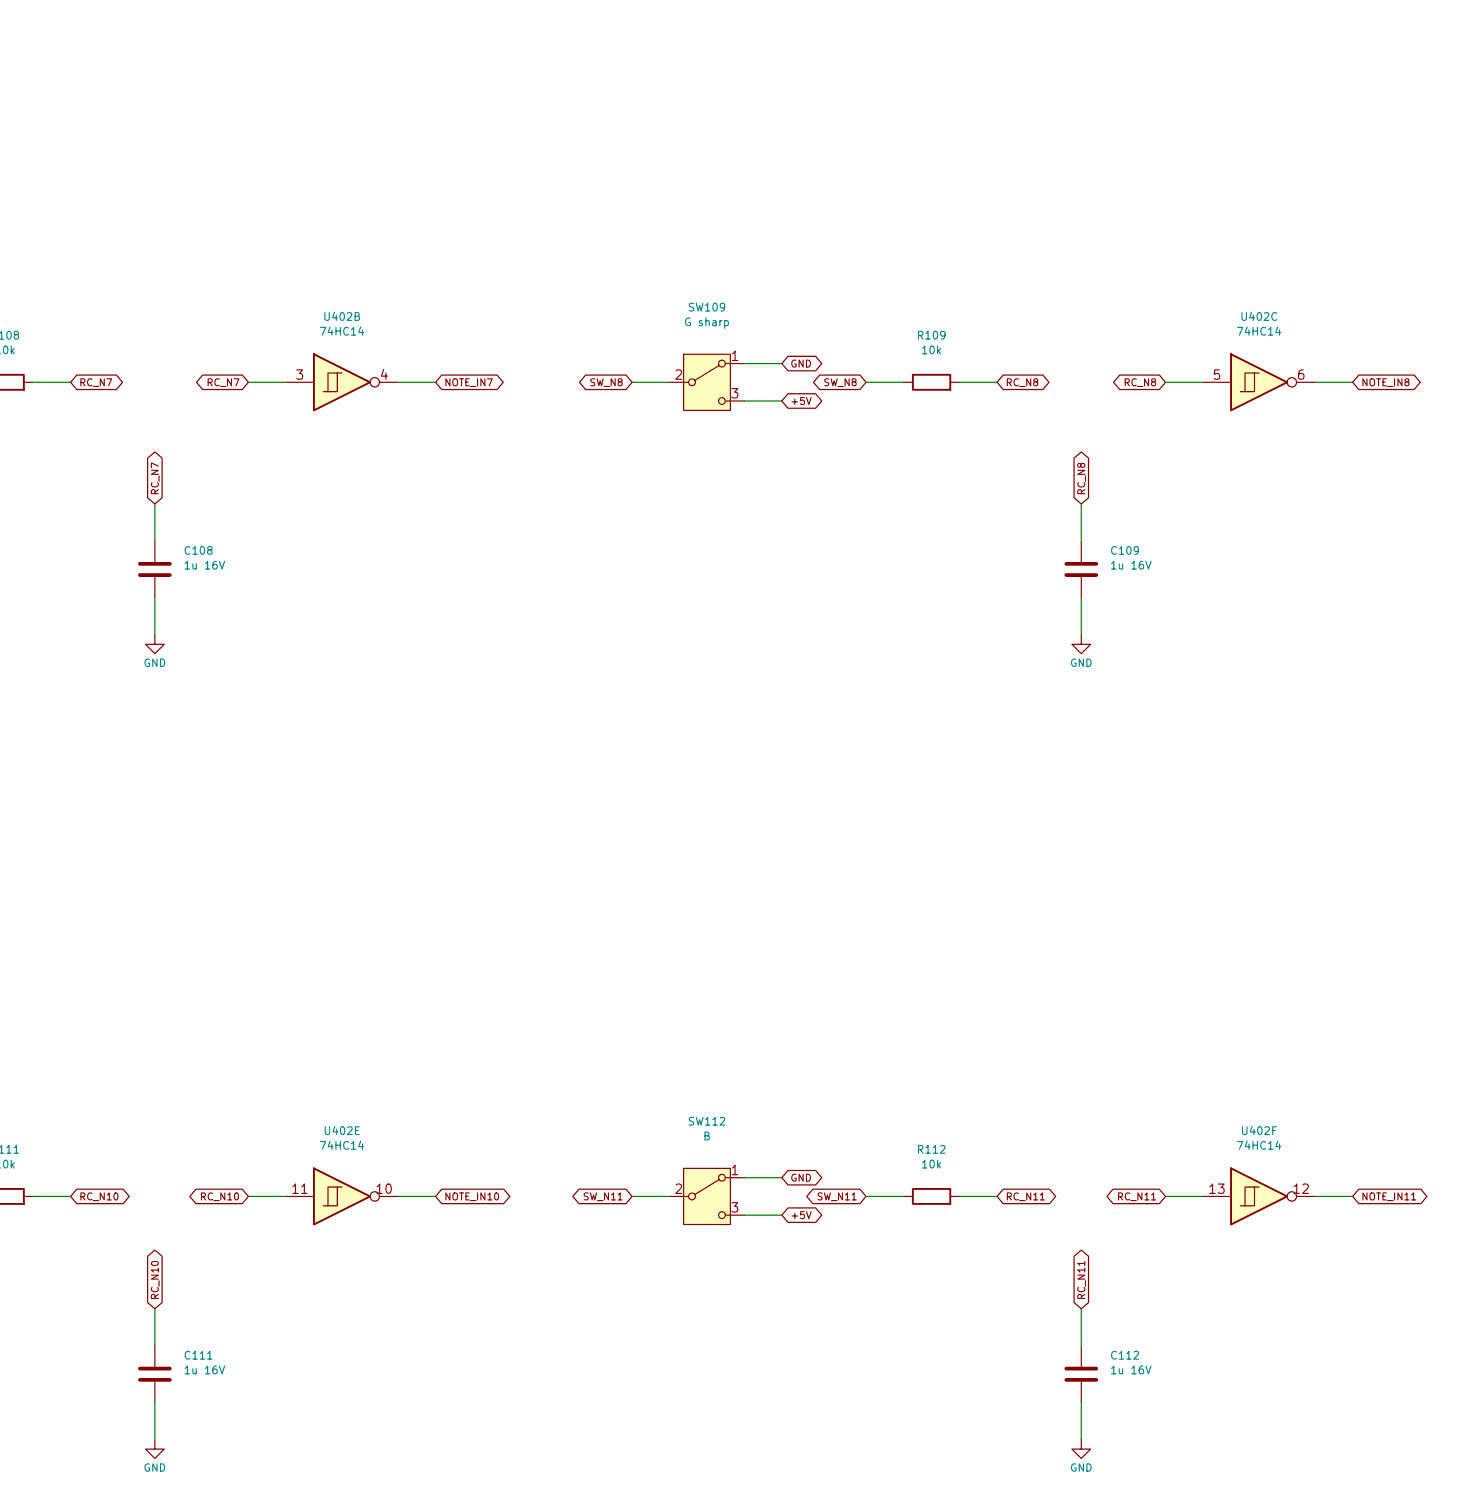
[picture p44: schematic 02_controls_b.kicad_sch, Note switches F sharp to B, part in row 1, column 2]

Parts:
C107, C108, C109, C110, C111, C112: 1u 16V; C_0805_2012Metric
R107, R108, R109, R110, R111, R112: 10k; R_0805_2012Metric
SW107: F sharp; SW_Dailywell_1M_SPDT_M2; MPN 1MS1T1B1M2QES
SW108: G; SW_Dailywell_1M_SPDT_M2; MPN 1MS1T1B1M2QES
SW109: G sharp; SW_Dailywell_1M_SPDT_M2; MPN 1MS1T1B1M2QES
SW110: A; SW_Dailywell_1M_SPDT_M2; MPN 1MS1T1B1M2QES
SW111: A sharp; SW_Dailywell_1M_SPDT_M2; MPN 1MS1T1B1M2QES
SW112: B; SW_Dailywell_1M_SPDT_M2; MPN 1MS1T1B1M2QES
U402: 74HC14; SOIC-14_3.9x8.7mm_P1.27mm; MPN 74HC14D,653

Connections:
+5V: SW107.3 (C), SW108.3 (C), SW109.3 (C), SW110.3 (C), SW111.3 (C), SW112.3 (C); also elsewhere on the board
NOTE_IN6: U402.2; also elsewhere on the board
NOTE_IN7: U402.4; also elsewhere on the board
NOTE_IN8: U402.6; also elsewhere on the board
NOTE_IN9: U402.8; also elsewhere on the board
NOTE_IN10: U402.10; also elsewhere on the board
NOTE_IN11: U402.12; also elsewhere on the board
RC_N6: C107.1, R107.2, U402.1
RC_N7: C108.1, R108.2, U402.3
RC_N8: C109.1, R109.2, U402.5
RC_N9: C110.1, R110.2, U402.9
RC_N10: C111.1, R111.2, U402.11
RC_N11: C112.1, R112.2, U402.13
SW_N6: R107.1, SW107.2 (B)
SW_N7: R108.1, SW108.2 (B)
SW_N8: R109.1, SW109.2 (B)
SW_N9: R110.1, SW110.2 (B)
SW_N10: R111.1, SW111.2 (B)
SW_N11: R112.1, SW112.2 (B)

Notes on the sheet:
Note switches F sharp to B
Second half of the 12-note selection bank.

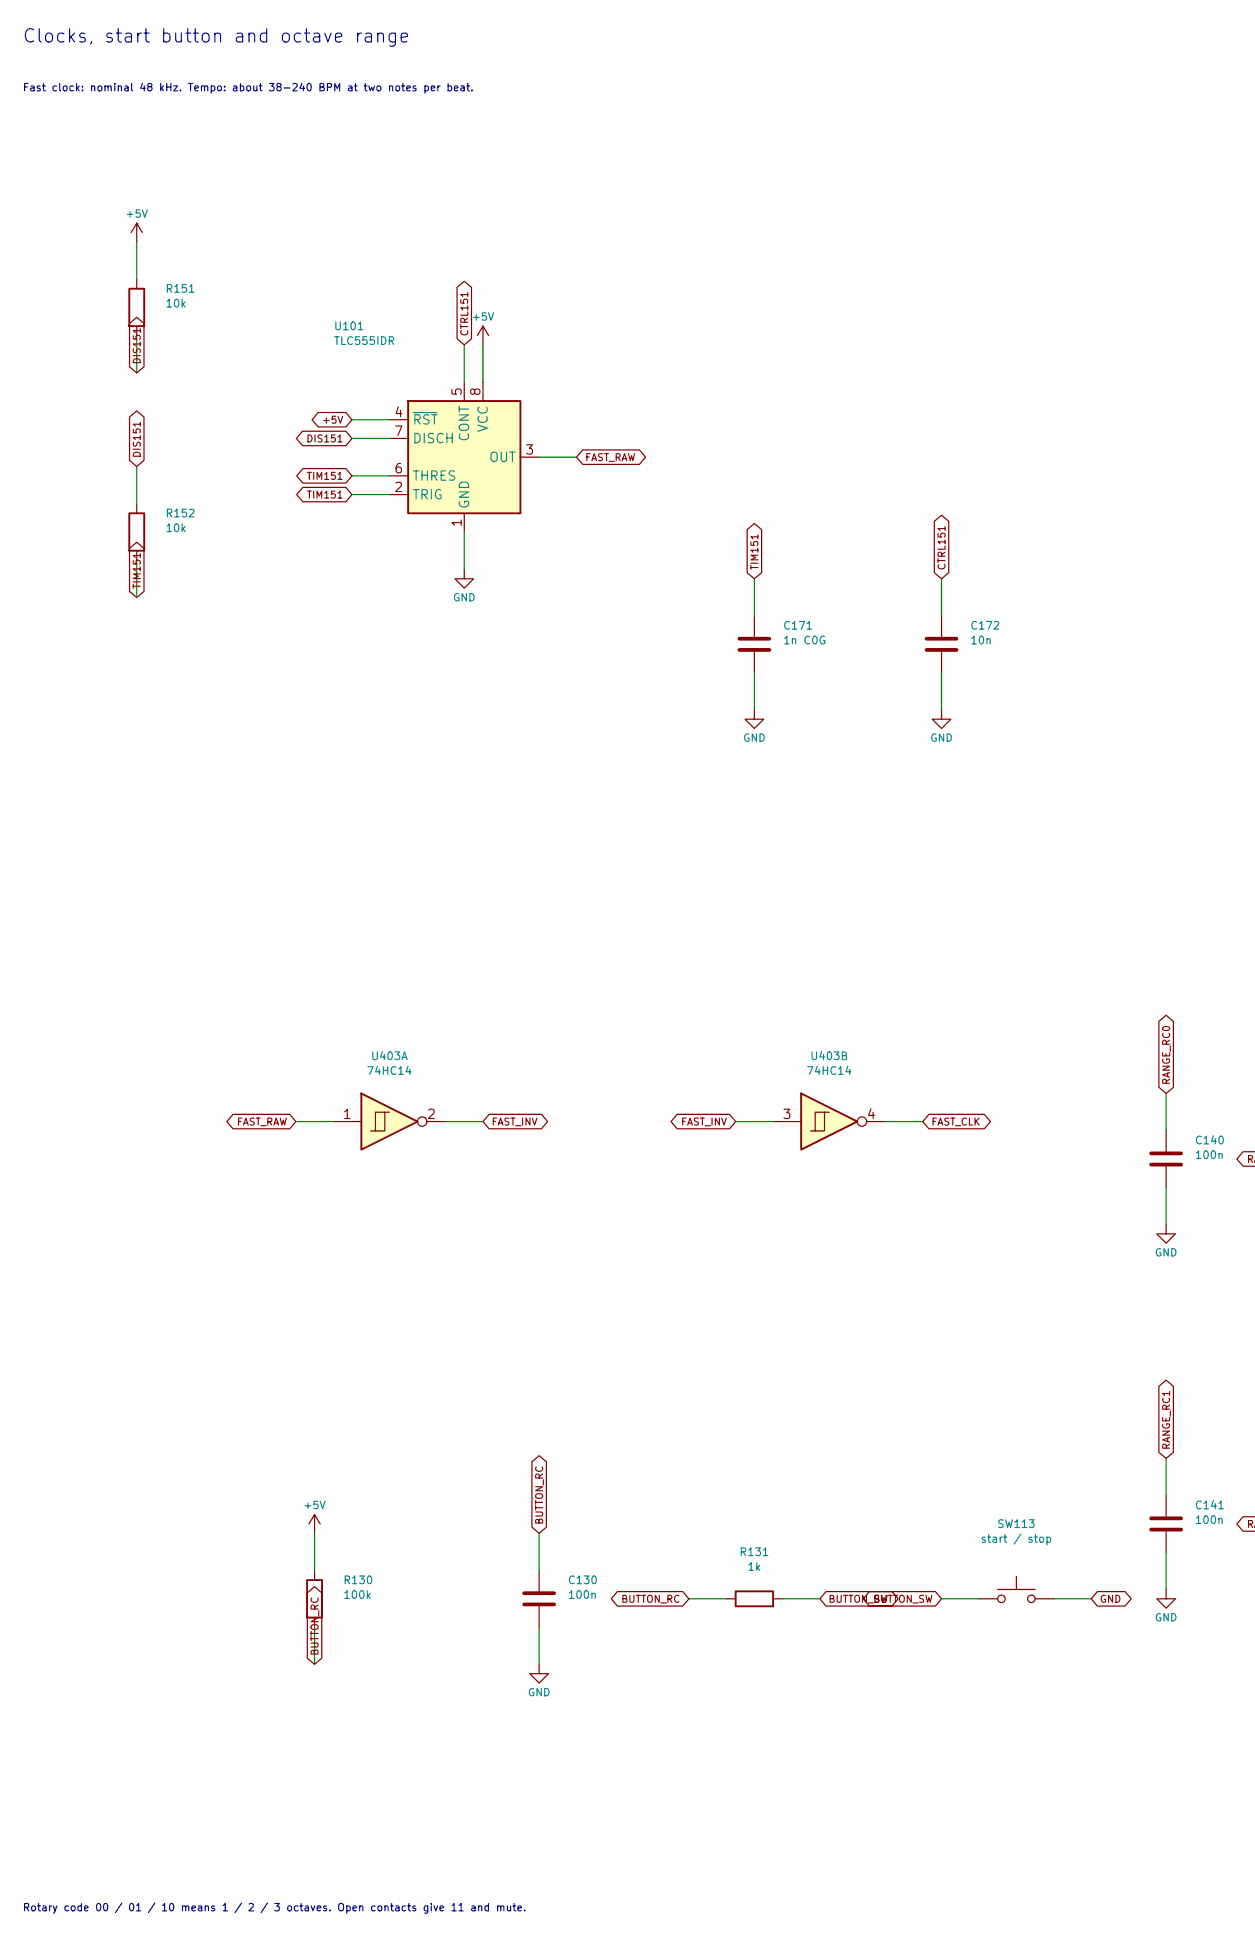
[picture p45: schematic 03_clock_range.kicad_sch, Clocks, start button and octave range, part in row 1, column 1]

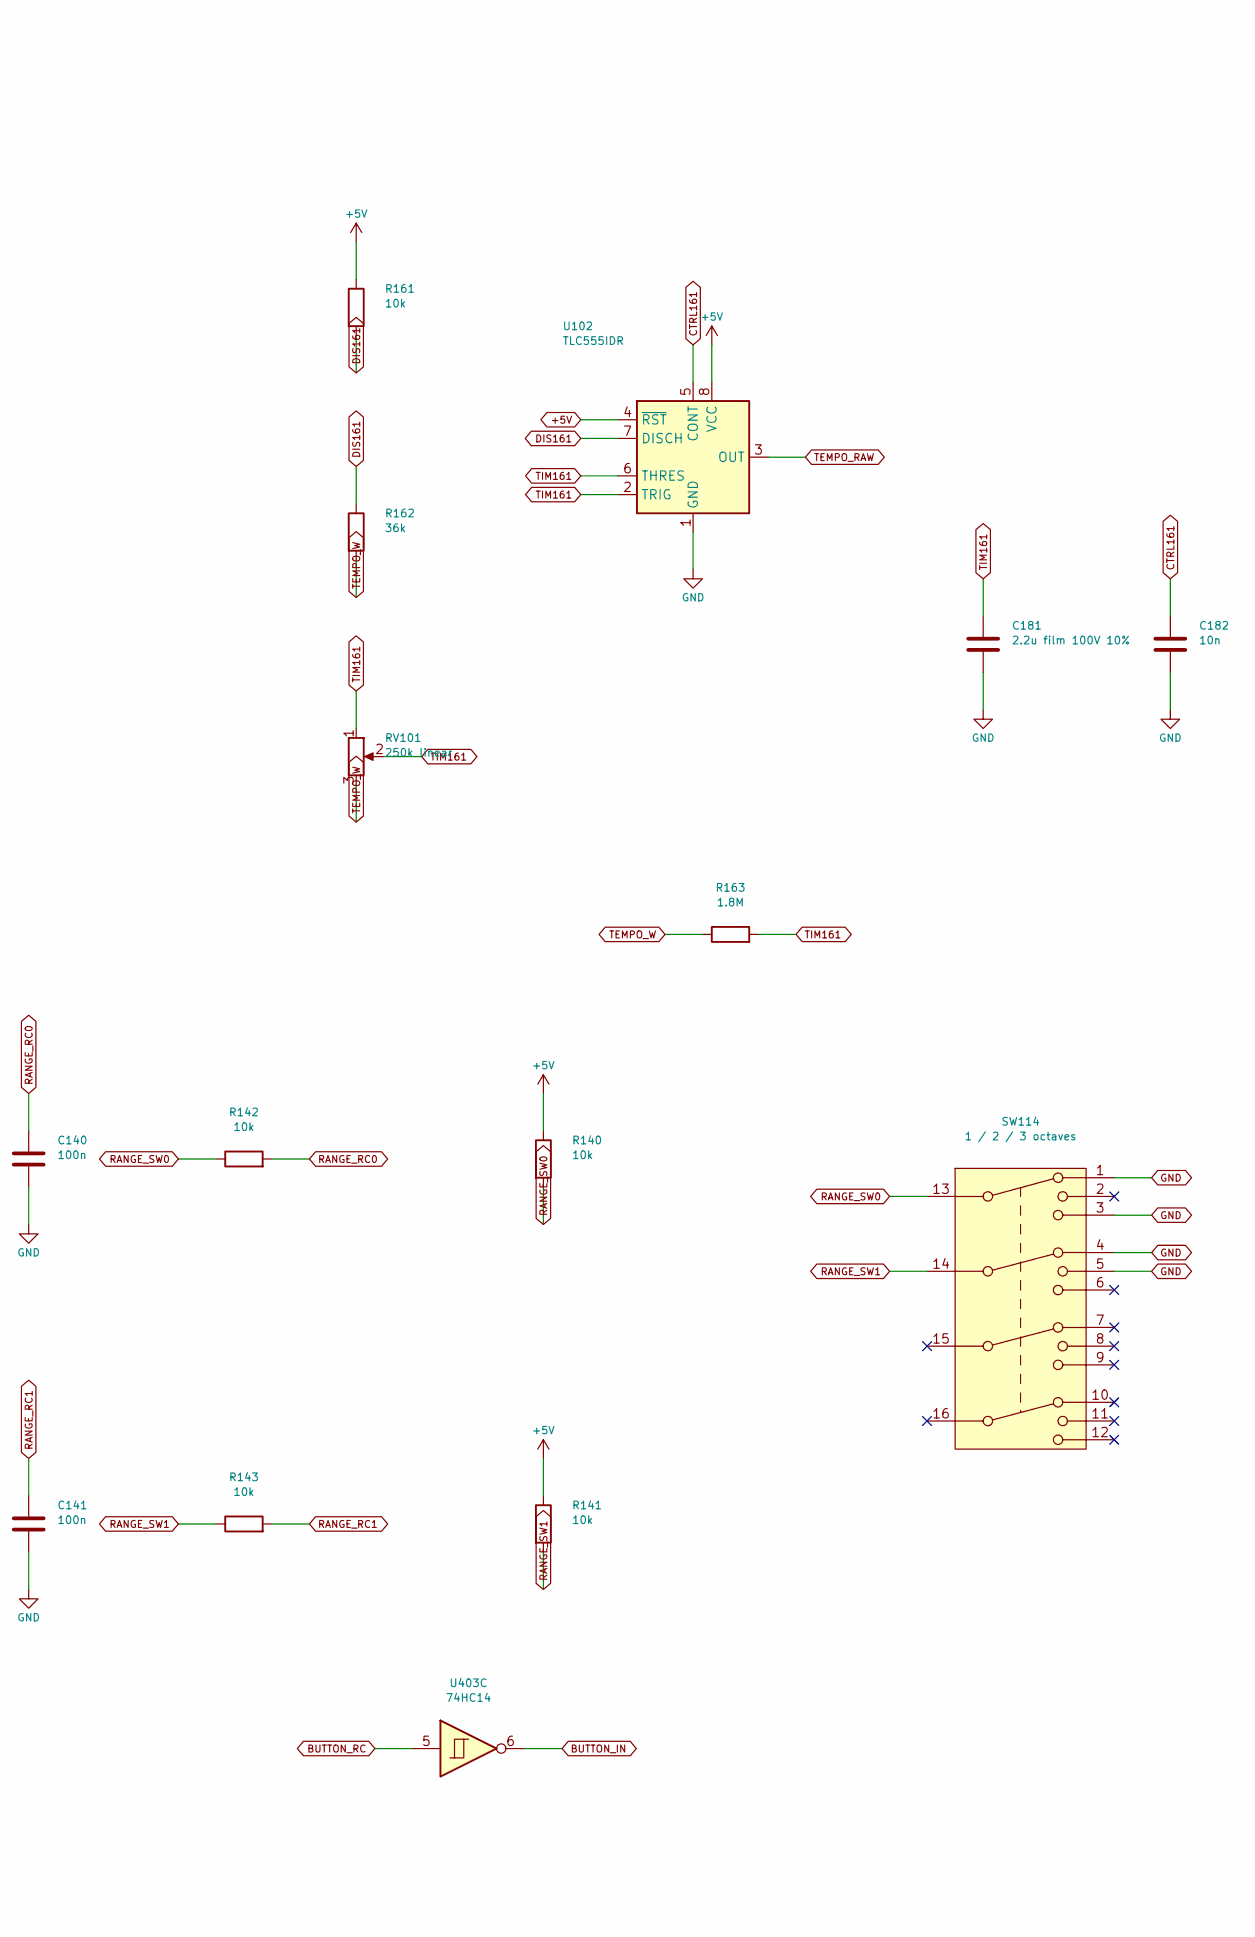
[picture p46: schematic 03_clock_range.kicad_sch, Clocks, start button and octave range, part in row 1, column 2]

Parts:
C130, C140, C141: 100n; C_0805_2012Metric
C171: 1n C0G; C_0805_2012Metric
C172, C182: 10n; C_0805_2012Metric
C181: 2.2u film 100V 10%; C_Rect_L18.0mm_W8.0mm_P15.00mm_FKS3_FKP3; MPN MKS4D042204F00KSSD
R130: 100k; R_0805_2012Metric
R131: 1k; R_0805_2012Metric
R140, R141, R142, R143, R151, R152, R161: 10k; R_0805_2012Metric
R162: 36k; R_0805_2012Metric
R163: 1.8M; R_0805_2012Metric
RV101: 250k linear; Potentiometer_Alpha_RD901F-40-00D_Single_Vertical; MPN RD901F-40-15F-B250K
SW113: start / stop; SW_SPST_Omron_B3F-40xx; MPN B3F-4055
SW114: 1 / 2 / 3 octaves; SW_Alpha_SR2612F_4P3T; MPN SR2612F-0403-18R0B-D8-N
U101, U102: TLC555IDR; SOIC-8_3.9x4.9mm_P1.27mm; MPN TLC555IDR
U403: 74HC14; SOIC-14_3.9x8.7mm_P1.27mm; MPN 74HC14D,653

Connections:
+5V: R130.1, R140.1, R141.1, R151.1, R161.1, U101.4 (~RST), U101.8 (VCC), U102.4 (~RST), U102.8 (VCC); also elsewhere on the board
BUTTON_IN: U403.6; also elsewhere on the board
BUTTON_RC: C130.1, R130.2, R131.1, U403.5
BUTTON_SW: R131.2, SW113.1
CTRL151: C172.1, U101.5 (CONT)
CTRL161: C182.1, U102.5 (CONT)
DIS151: R151.2, R152.1, U101.7 (DISCH)
DIS161: R161.2, R162.1, U102.7 (DISCH)
FAST_CLK: U403.4; also elsewhere on the board
FAST_INV: U403.2, U403.3
FAST_RAW: U101.3 (OUT), U403.1
RANGE_RC0: C140.1, R142.2; also elsewhere on the board
RANGE_RC1: C141.1, R143.2; also elsewhere on the board
RANGE_SW0: R140.2, R142.1, SW114.13
RANGE_SW1: R141.2, R143.1, SW114.14
TEMPO_RAW: U102.3 (OUT); also elsewhere on the board
TEMPO_W: R162.2, R163.1, RV101.3
TIM151: C171.1, R152.2, U101.2 (TRIG), U101.6 (THRES)
TIM161: C181.1, R163.2, RV101.1, RV101.2, U102.2 (TRIG), U102.6 (THRES)

Notes on the sheet:
Clocks, start button and octave range
Fast clock: nominal 48 kHz. Tempo: about 38-240 BPM at two notes per beat.
Rotary code 00 / 01 / 10 means 1 / 2 / 3 octaves. Open contacts give 11 and mute.
