EwoudVV/arpeggiator/arpeggiator.kicad_pcb

## KiCad design arpeggiator.kicad_pcb (continued)

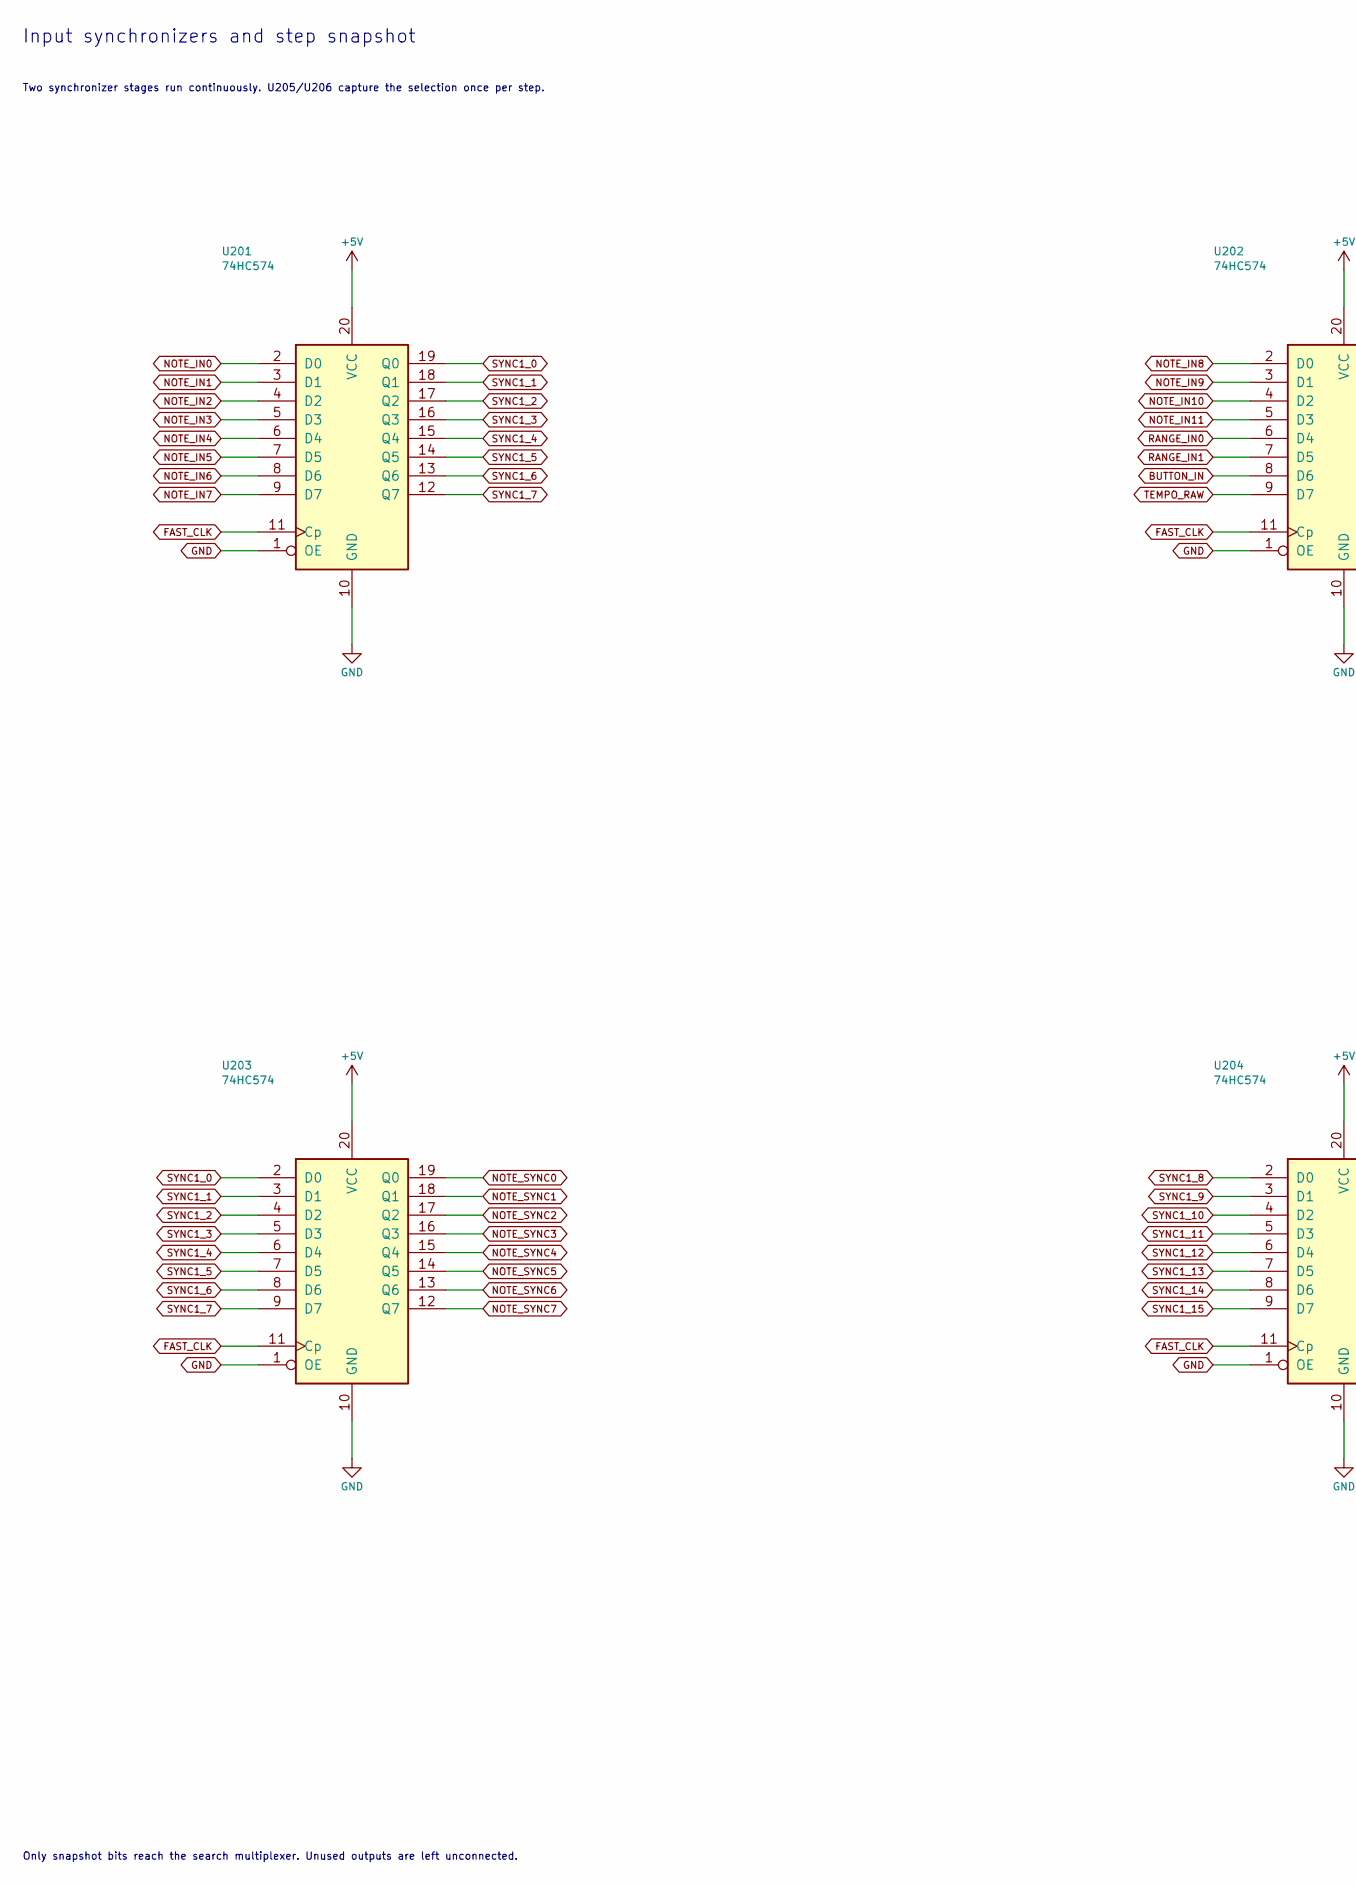
[picture p47: schematic 04_input_registers.kicad_sch, Input synchronizers and step snapshot, part in row 1, column 1]

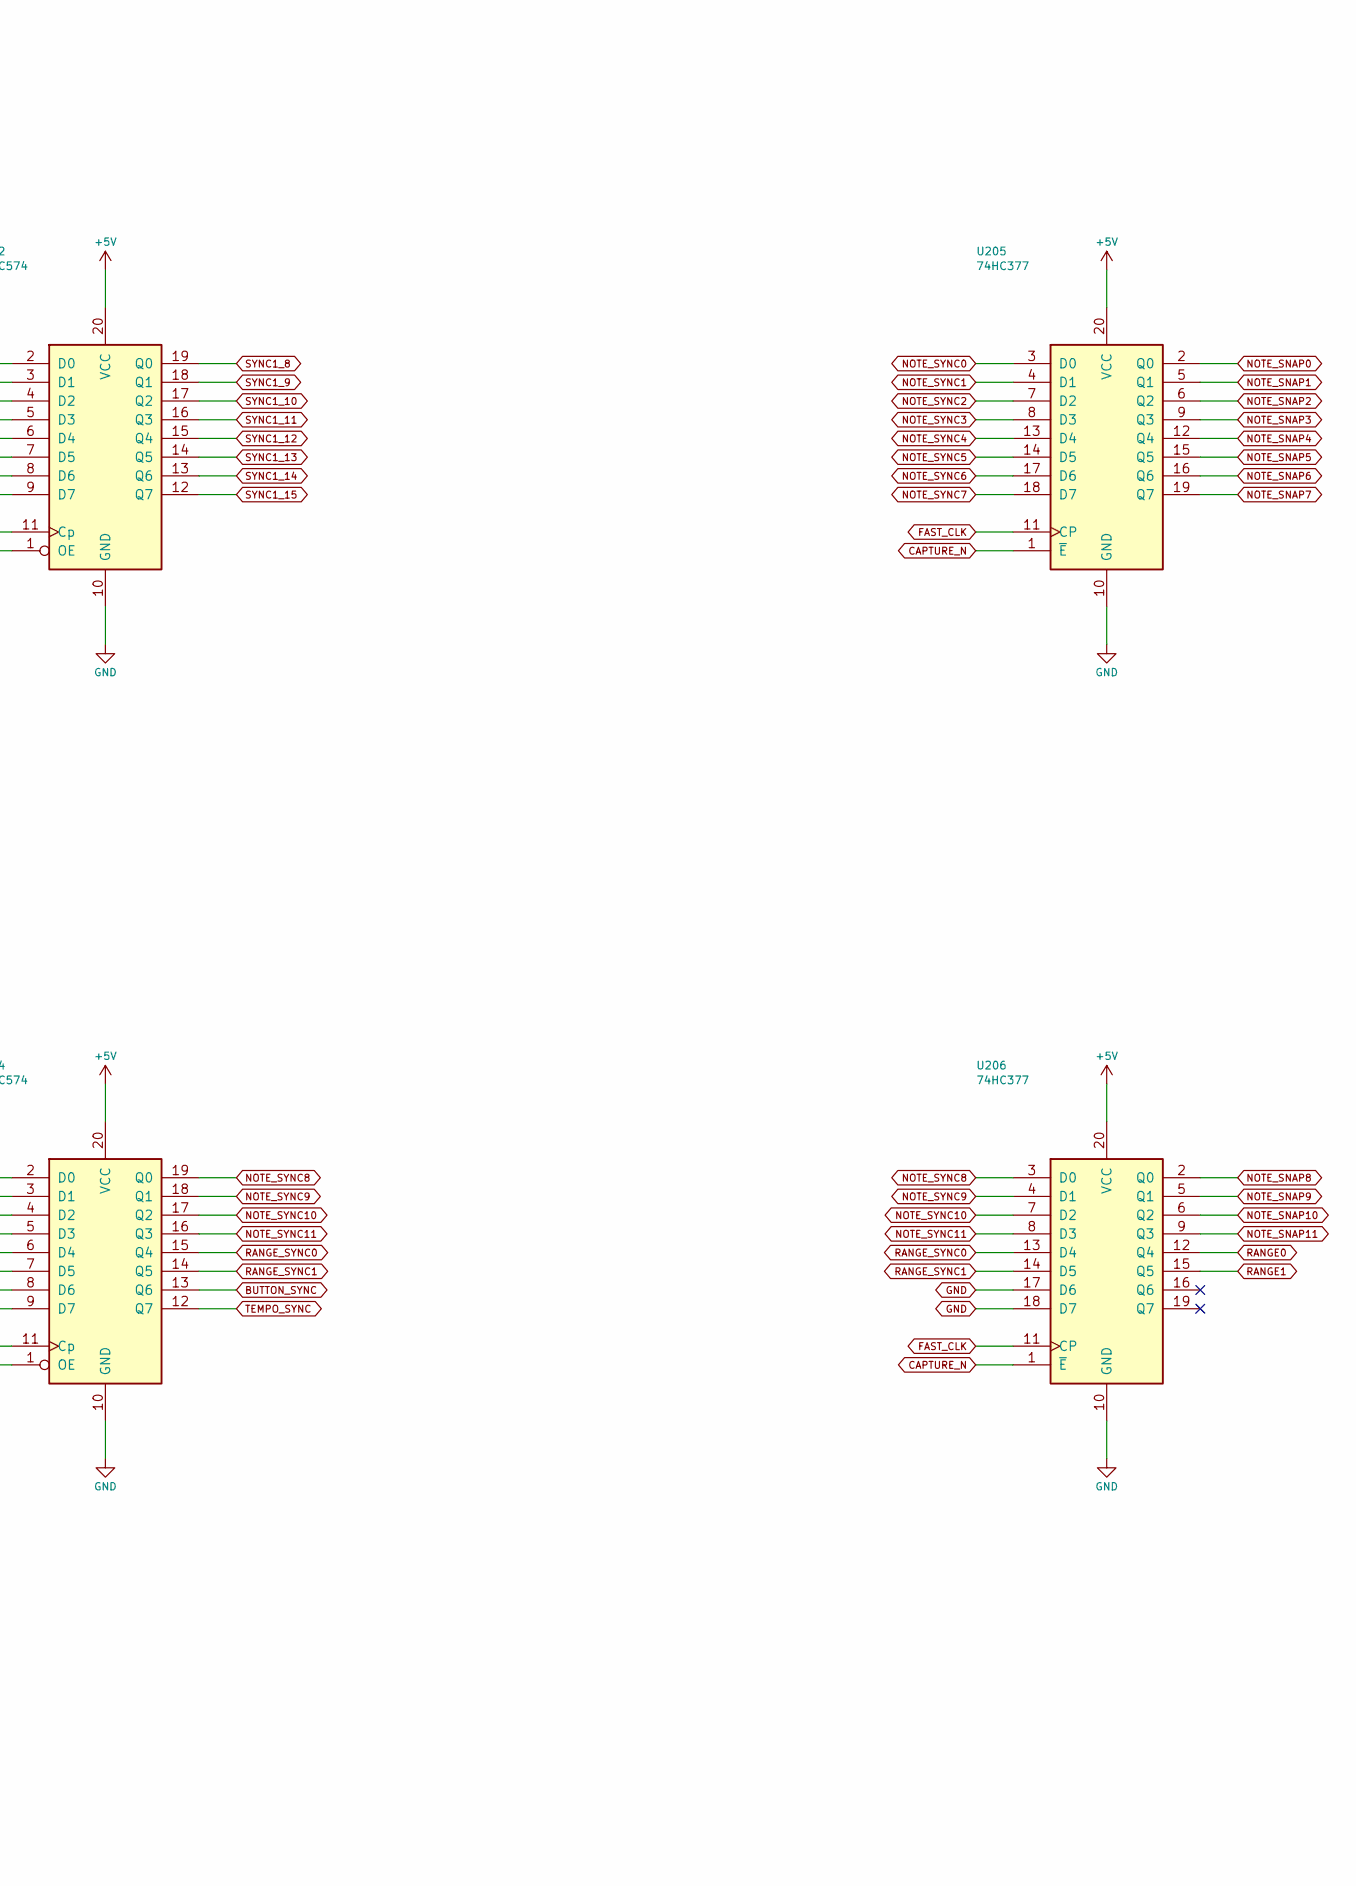
[picture p48: schematic 04_input_registers.kicad_sch, Input synchronizers and step snapshot, part in row 1, column 2]

Parts:
U201, U202, U203, U204: 74HC574; SOIC-20W_7.5x12.8mm_P1.27mm; MPN 74HC574D,653
U205, U206: 74HC377; SOIC-20W_7.5x12.8mm_P1.27mm; MPN 74HC377D,653

Connections:
+5V: U201.20 (VCC), U202.20 (VCC), U203.20 (VCC), U204.20 (VCC), U205.20 (VCC), U206.20 (VCC); also elsewhere on the board
BUTTON_IN: U202.8 (D6); also elsewhere on the board
BUTTON_SYNC: U204.13 (Q6); also elsewhere on the board
CAPTURE_N: U205.1 (~E), U206.1 (~E); also elsewhere on the board
FAST_CLK: U201.11 (Cp), U202.11 (Cp), U203.11 (Cp), U204.11 (Cp), U205.11 (CP), U206.11 (CP); also elsewhere on the board
NOTE_IN0: U201.2 (D0); also elsewhere on the board
NOTE_IN1: U201.3 (D1); also elsewhere on the board
NOTE_IN2: U201.4 (D2); also elsewhere on the board
NOTE_IN3: U201.5 (D3); also elsewhere on the board
NOTE_IN4: U201.6 (D4); also elsewhere on the board
NOTE_IN5: U201.7 (D5); also elsewhere on the board
NOTE_IN6: U201.8 (D6); also elsewhere on the board
NOTE_IN7: U201.9 (D7); also elsewhere on the board
NOTE_IN8: U202.2 (D0); also elsewhere on the board
NOTE_IN9: U202.3 (D1); also elsewhere on the board
NOTE_IN10: U202.4 (D2); also elsewhere on the board
NOTE_IN11: U202.5 (D3); also elsewhere on the board
NOTE_SNAP0: U205.2 (Q0); also elsewhere on the board
NOTE_SNAP1: U205.5 (Q1); also elsewhere on the board
NOTE_SNAP2: U205.6 (Q2); also elsewhere on the board
NOTE_SNAP3: U205.9 (Q3); also elsewhere on the board
NOTE_SNAP4: U205.12 (Q4); also elsewhere on the board
NOTE_SNAP5: U205.15 (Q5); also elsewhere on the board
NOTE_SNAP6: U205.16 (Q6); also elsewhere on the board
NOTE_SNAP7: U205.19 (Q7); also elsewhere on the board
NOTE_SNAP8: U206.2 (Q0); also elsewhere on the board
NOTE_SNAP9: U206.5 (Q1); also elsewhere on the board
NOTE_SNAP10: U206.6 (Q2); also elsewhere on the board
NOTE_SNAP11: U206.9 (Q3); also elsewhere on the board
NOTE_SYNC0: U203.19 (Q0), U205.3 (D0)
NOTE_SYNC1: U203.18 (Q1), U205.4 (D1)
NOTE_SYNC2: U203.17 (Q2), U205.7 (D2)
NOTE_SYNC3: U203.16 (Q3), U205.8 (D3)
NOTE_SYNC4: U203.15 (Q4), U205.13 (D4)
NOTE_SYNC5: U203.14 (Q5), U205.14 (D5)
NOTE_SYNC6: U203.13 (Q6), U205.17 (D6)
NOTE_SYNC7: U203.12 (Q7), U205.18 (D7)
NOTE_SYNC8: U204.19 (Q0), U206.3 (D0)
NOTE_SYNC9: U204.18 (Q1), U206.4 (D1)
NOTE_SYNC10: U204.17 (Q2), U206.7 (D2)
NOTE_SYNC11: U204.16 (Q3), U206.8 (D3)
RANGE0: U206.12 (Q4); also elsewhere on the board
RANGE1: U206.15 (Q5); also elsewhere on the board
RANGE_IN0: U202.6 (D4); also elsewhere on the board
RANGE_IN1: U202.7 (D5); also elsewhere on the board
RANGE_SYNC0: U204.15 (Q4), U206.13 (D4)
RANGE_SYNC1: U204.14 (Q5), U206.14 (D5)
SYNC1_0: U201.19 (Q0), U203.2 (D0)
SYNC1_1: U201.18 (Q1), U203.3 (D1)
SYNC1_2: U201.17 (Q2), U203.4 (D2)
SYNC1_3: U201.16 (Q3), U203.5 (D3)
SYNC1_4: U201.15 (Q4), U203.6 (D4)
SYNC1_5: U201.14 (Q5), U203.7 (D5)
SYNC1_6: U201.13 (Q6), U203.8 (D6)
SYNC1_7: U201.12 (Q7), U203.9 (D7)
SYNC1_8: U202.19 (Q0), U204.2 (D0)
SYNC1_9: U202.18 (Q1), U204.3 (D1)
SYNC1_10: U202.17 (Q2), U204.4 (D2)
SYNC1_11: U202.16 (Q3), U204.5 (D3)
SYNC1_12: U202.15 (Q4), U204.6 (D4)
SYNC1_13: U202.14 (Q5), U204.7 (D5)
SYNC1_14: U202.13 (Q6), U204.8 (D6)
SYNC1_15: U202.12 (Q7), U204.9 (D7)
TEMPO_RAW: U202.9 (D7); also elsewhere on the board
TEMPO_SYNC: U204.12 (Q7); also elsewhere on the board

Notes on the sheet:
Input synchronizers and step snapshot
Two synchronizer stages run continuously. U205/U206 capture the selection once per step.
Only snapshot bits reach the search multiplexer. Unused outputs are left unconnected.

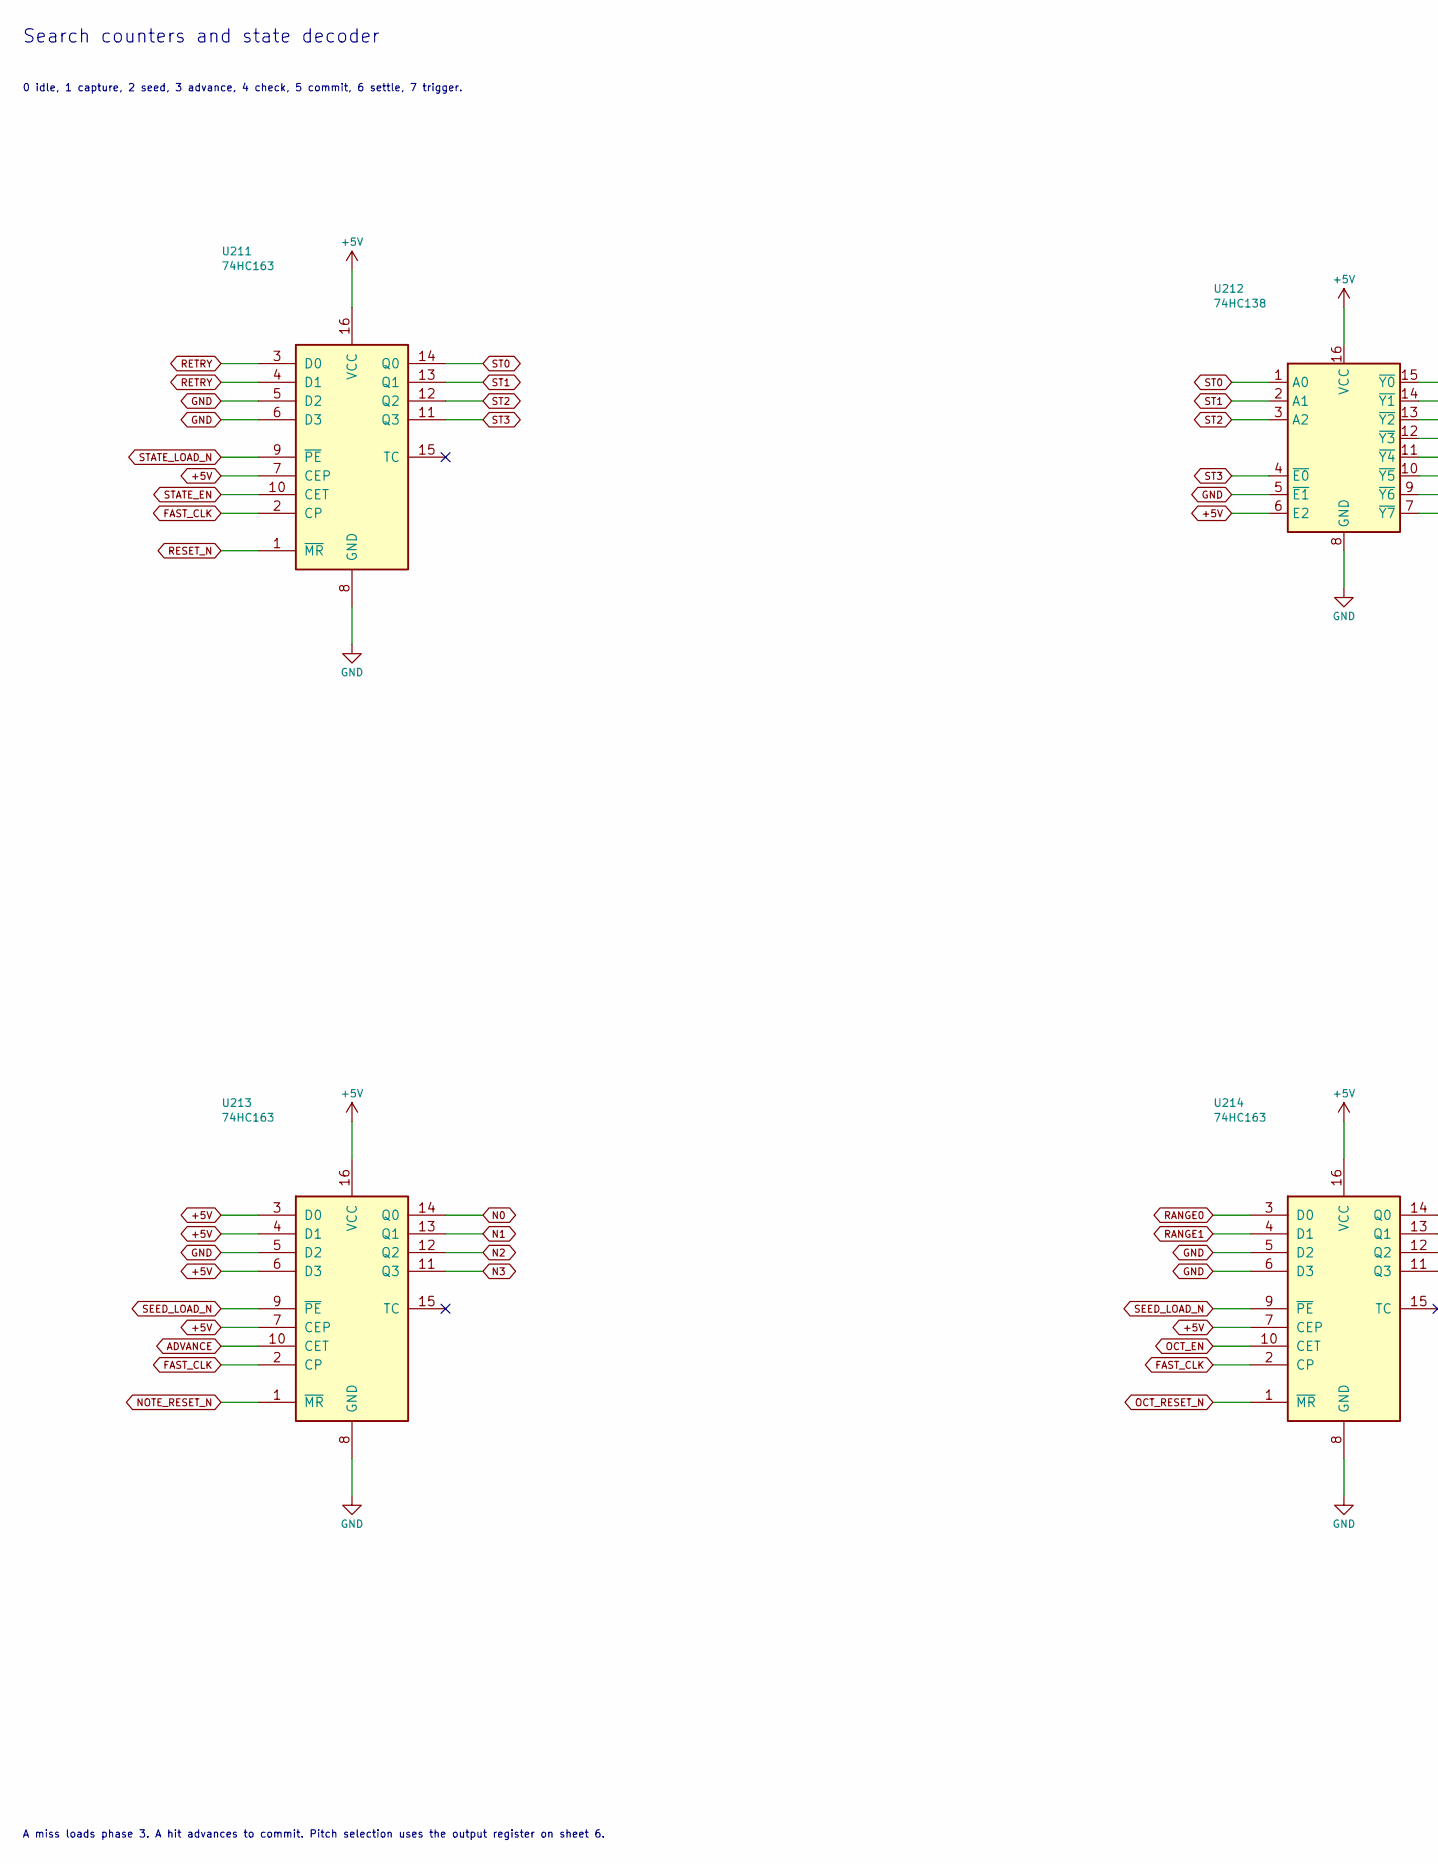
[picture p49: schematic 05_search_counters.kicad_sch, Search counters and state decoder, part in row 1, column 1]

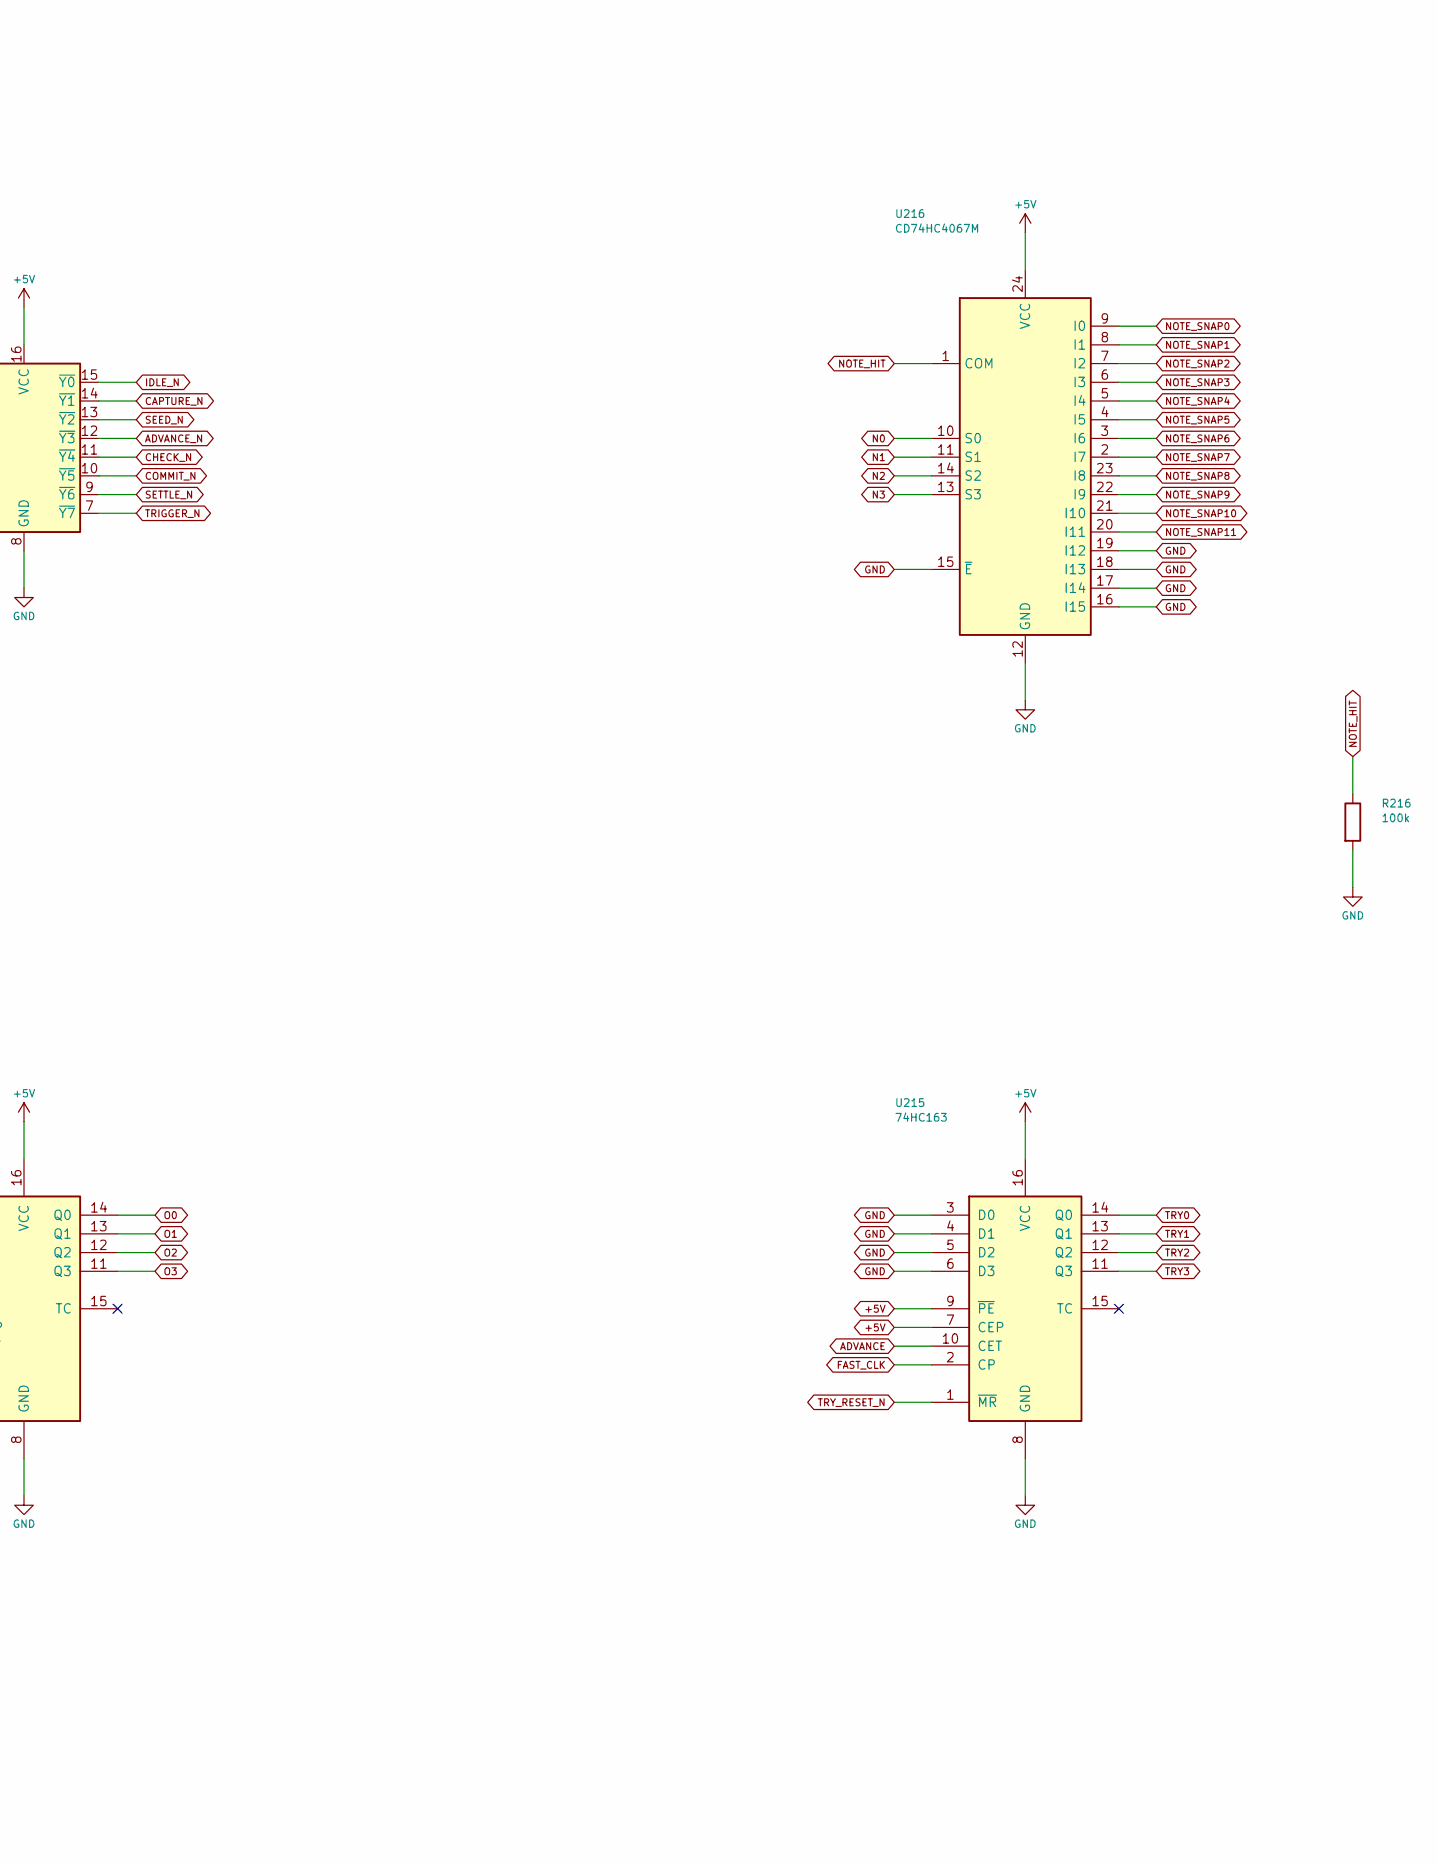
[picture p50: schematic 05_search_counters.kicad_sch, Search counters and state decoder, part in row 1, column 2]

Parts:
R216: 100k; R_0805_2012Metric
U211, U213, U214, U215: 74HC163; SOIC-16_3.9x9.9mm_P1.27mm; MPN SN74HC163DR
U212: 74HC138; SOIC-16_3.9x9.9mm_P1.27mm; MPN 74HC138D,653
U216: CD74HC4067M; SOIC-24W_7.5x15.4mm_P1.27mm; MPN CD74HC4067M

Connections:
+5V: U211.7 (CEP), U211.16 (VCC), U212.6 (E2), U212.16 (VCC), U213.3 (D0), U213.4 (D1), U213.6 (D3), U213.7 (CEP), U213.16 (VCC), U214.7 (CEP), U214.16 (VCC), U215.7 (CEP), U215.9 (~PE), U215.16 (VCC), U216.24 (VCC); also elsewhere on the board
ADVANCE: U213.10 (CET), U215.10 (CET); also elsewhere on the board
ADVANCE_N: U212.12 (~Y3); also elsewhere on the board
CAPTURE_N: U212.14 (~Y1); also elsewhere on the board
CHECK_N: U212.11 (~Y4); also elsewhere on the board
COMMIT_N: U212.10 (~Y5); also elsewhere on the board
FAST_CLK: U211.2 (CP), U213.2 (CP), U214.2 (CP), U215.2 (CP); also elsewhere on the board
IDLE_N: U212.15 (~Y0); also elsewhere on the board
N0: U213.14 (Q0), U216.10 (S0); also elsewhere on the board
N1: U213.13 (Q1), U216.11 (S1); also elsewhere on the board
N2: U213.12 (Q2), U216.14 (S2); also elsewhere on the board
N3: U213.11 (Q3), U216.13 (S3); also elsewhere on the board
NOTE_HIT: R216.1, U216.1 (COM); also elsewhere on the board
NOTE_RESET_N: U213.1 (~MR); also elsewhere on the board
NOTE_SNAP0: U216.9 (I0); also elsewhere on the board
NOTE_SNAP1: U216.8 (I1); also elsewhere on the board
NOTE_SNAP2: U216.7 (I2); also elsewhere on the board
NOTE_SNAP3: U216.6 (I3); also elsewhere on the board
NOTE_SNAP4: U216.5 (I4); also elsewhere on the board
NOTE_SNAP5: U216.4 (I5); also elsewhere on the board
NOTE_SNAP6: U216.3 (I6); also elsewhere on the board
NOTE_SNAP7: U216.2 (I7); also elsewhere on the board
NOTE_SNAP8: U216.23 (I8); also elsewhere on the board
NOTE_SNAP9: U216.22 (I9); also elsewhere on the board
NOTE_SNAP10: U216.21 (I10); also elsewhere on the board
NOTE_SNAP11: U216.20 (I11); also elsewhere on the board
O0: U214.14 (Q0); also elsewhere on the board
O1: U214.13 (Q1); also elsewhere on the board
O2: U214.12 (Q2); also elsewhere on the board
O3: U214.11 (Q3); also elsewhere on the board
OCT_EN: U214.10 (CET); also elsewhere on the board
OCT_RESET_N: U214.1 (~MR); also elsewhere on the board
RANGE0: U214.3 (D0); also elsewhere on the board
RANGE1: U214.4 (D1); also elsewhere on the board
RESET_N: U211.1 (~MR); also elsewhere on the board
RETRY: U211.3 (D0), U211.4 (D1); also elsewhere on the board
SEED_LOAD_N: U213.9 (~PE), U214.9 (~PE); also elsewhere on the board
SEED_N: U212.13 (~Y2); also elsewhere on the board
SETTLE_N: U212.9 (~Y6); also elsewhere on the board
ST0: U211.14 (Q0), U212.1 (A0)
ST1: U211.13 (Q1), U212.2 (A1)
ST2: U211.12 (Q2), U212.3 (A2)
ST3: U211.11 (Q3), U212.4 (~E0); also elsewhere on the board
STATE_EN: U211.10 (CET); also elsewhere on the board
STATE_LOAD_N: U211.9 (~PE); also elsewhere on the board
TRIGGER_N: U212.7 (~Y7); also elsewhere on the board
TRY0: U215.14 (Q0); also elsewhere on the board
TRY1: U215.13 (Q1); also elsewhere on the board
TRY2: U215.12 (Q2); also elsewhere on the board
TRY3: U215.11 (Q3); also elsewhere on the board
TRY_RESET_N: U215.1 (~MR); also elsewhere on the board

Notes on the sheet:
Search counters and state decoder
0 idle, 1 capture, 2 seed, 3 advance, 4 check, 5 commit, 6 settle, 7 trigger.
A miss loads phase 3. A hit advances to commit. Pitch selection uses the output register on sheet 6.

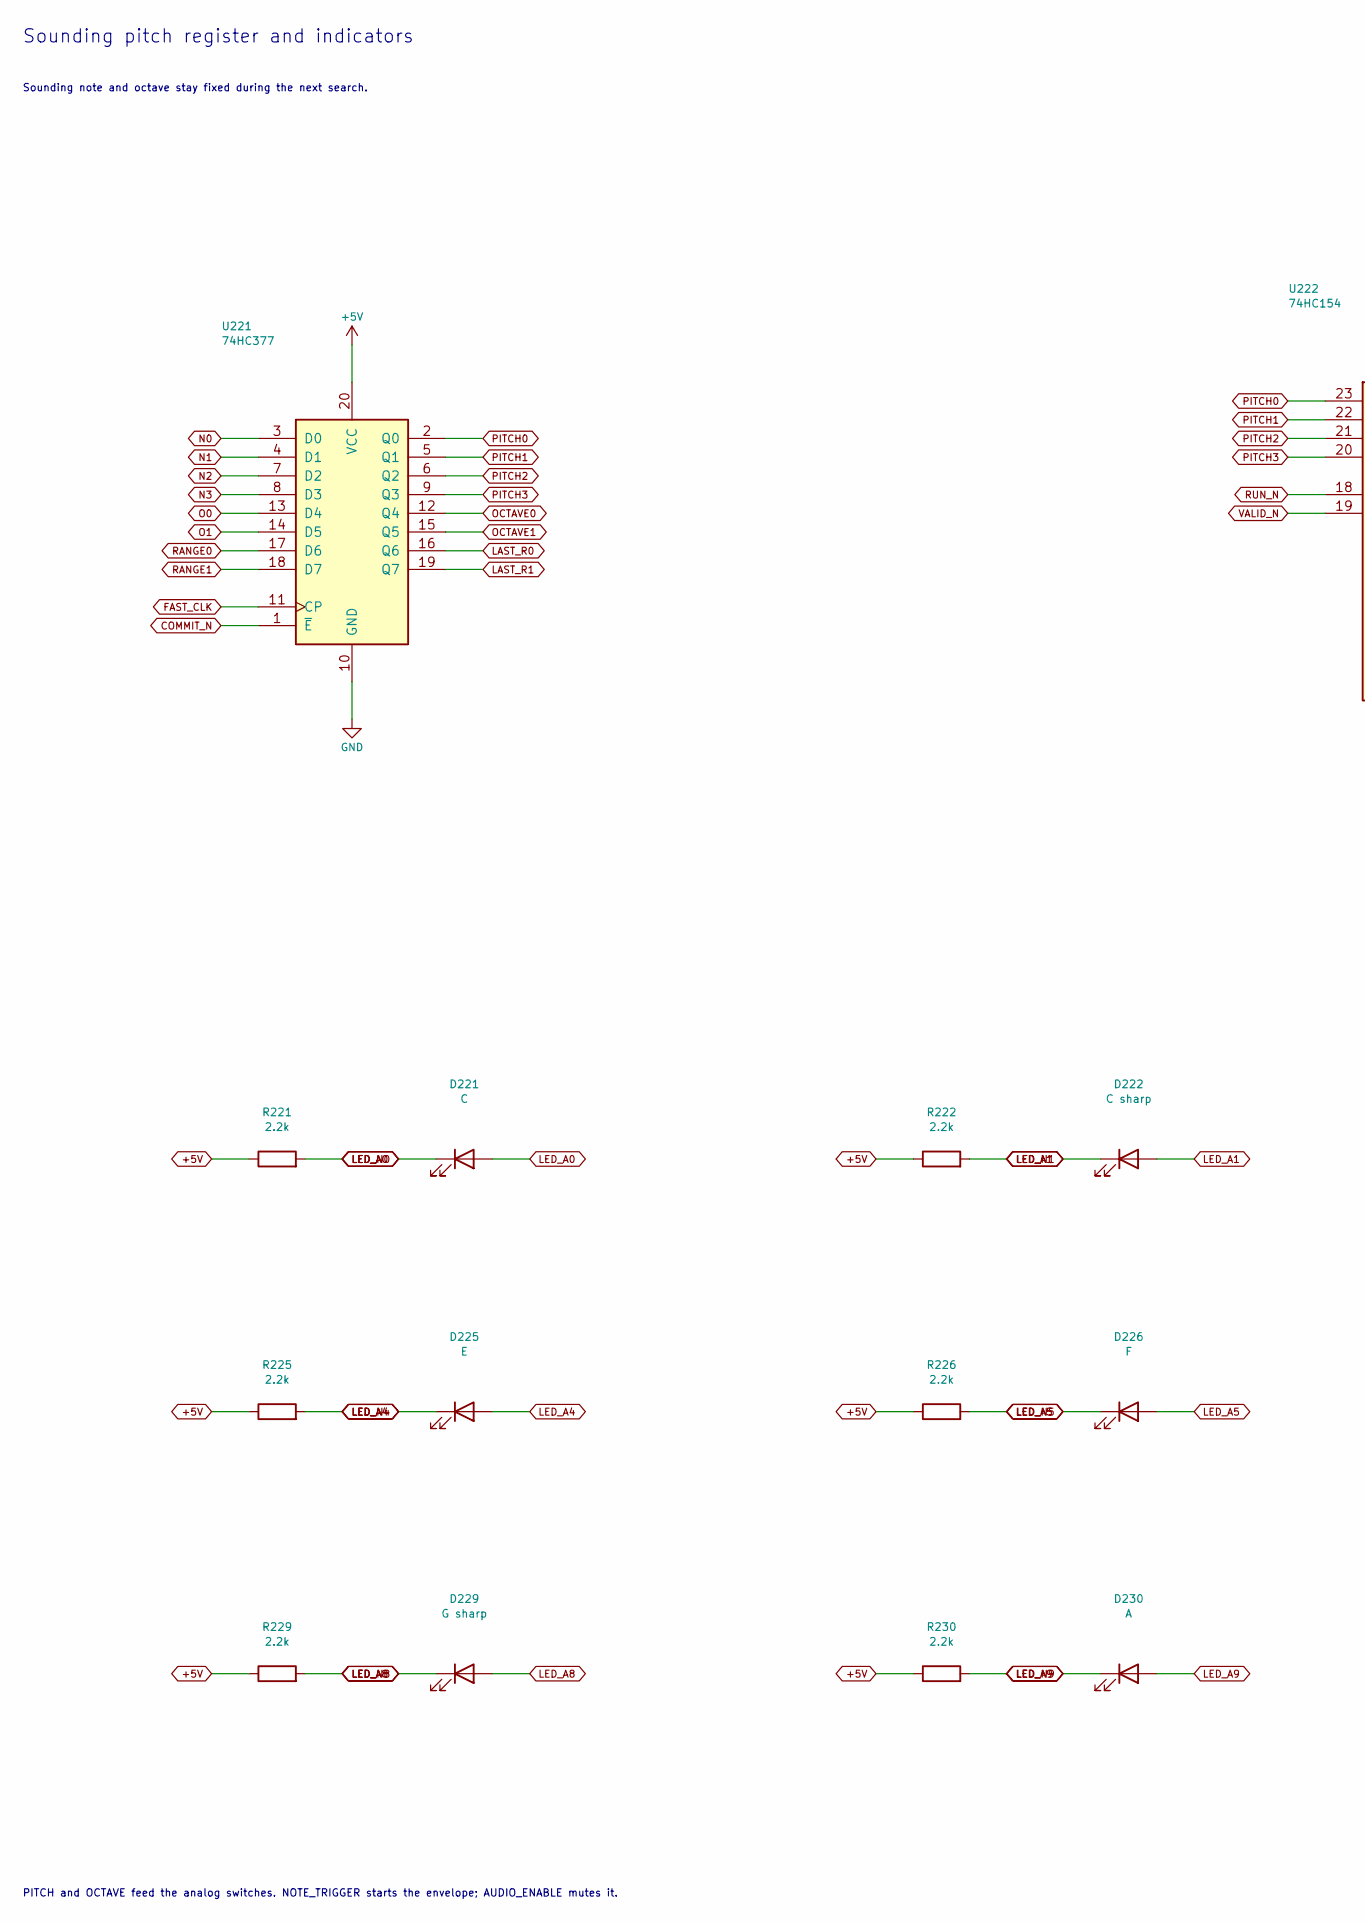
[picture p51: schematic 06_pitch_register.kicad_sch, Sounding pitch register and indicators, part in row 1, column 1]

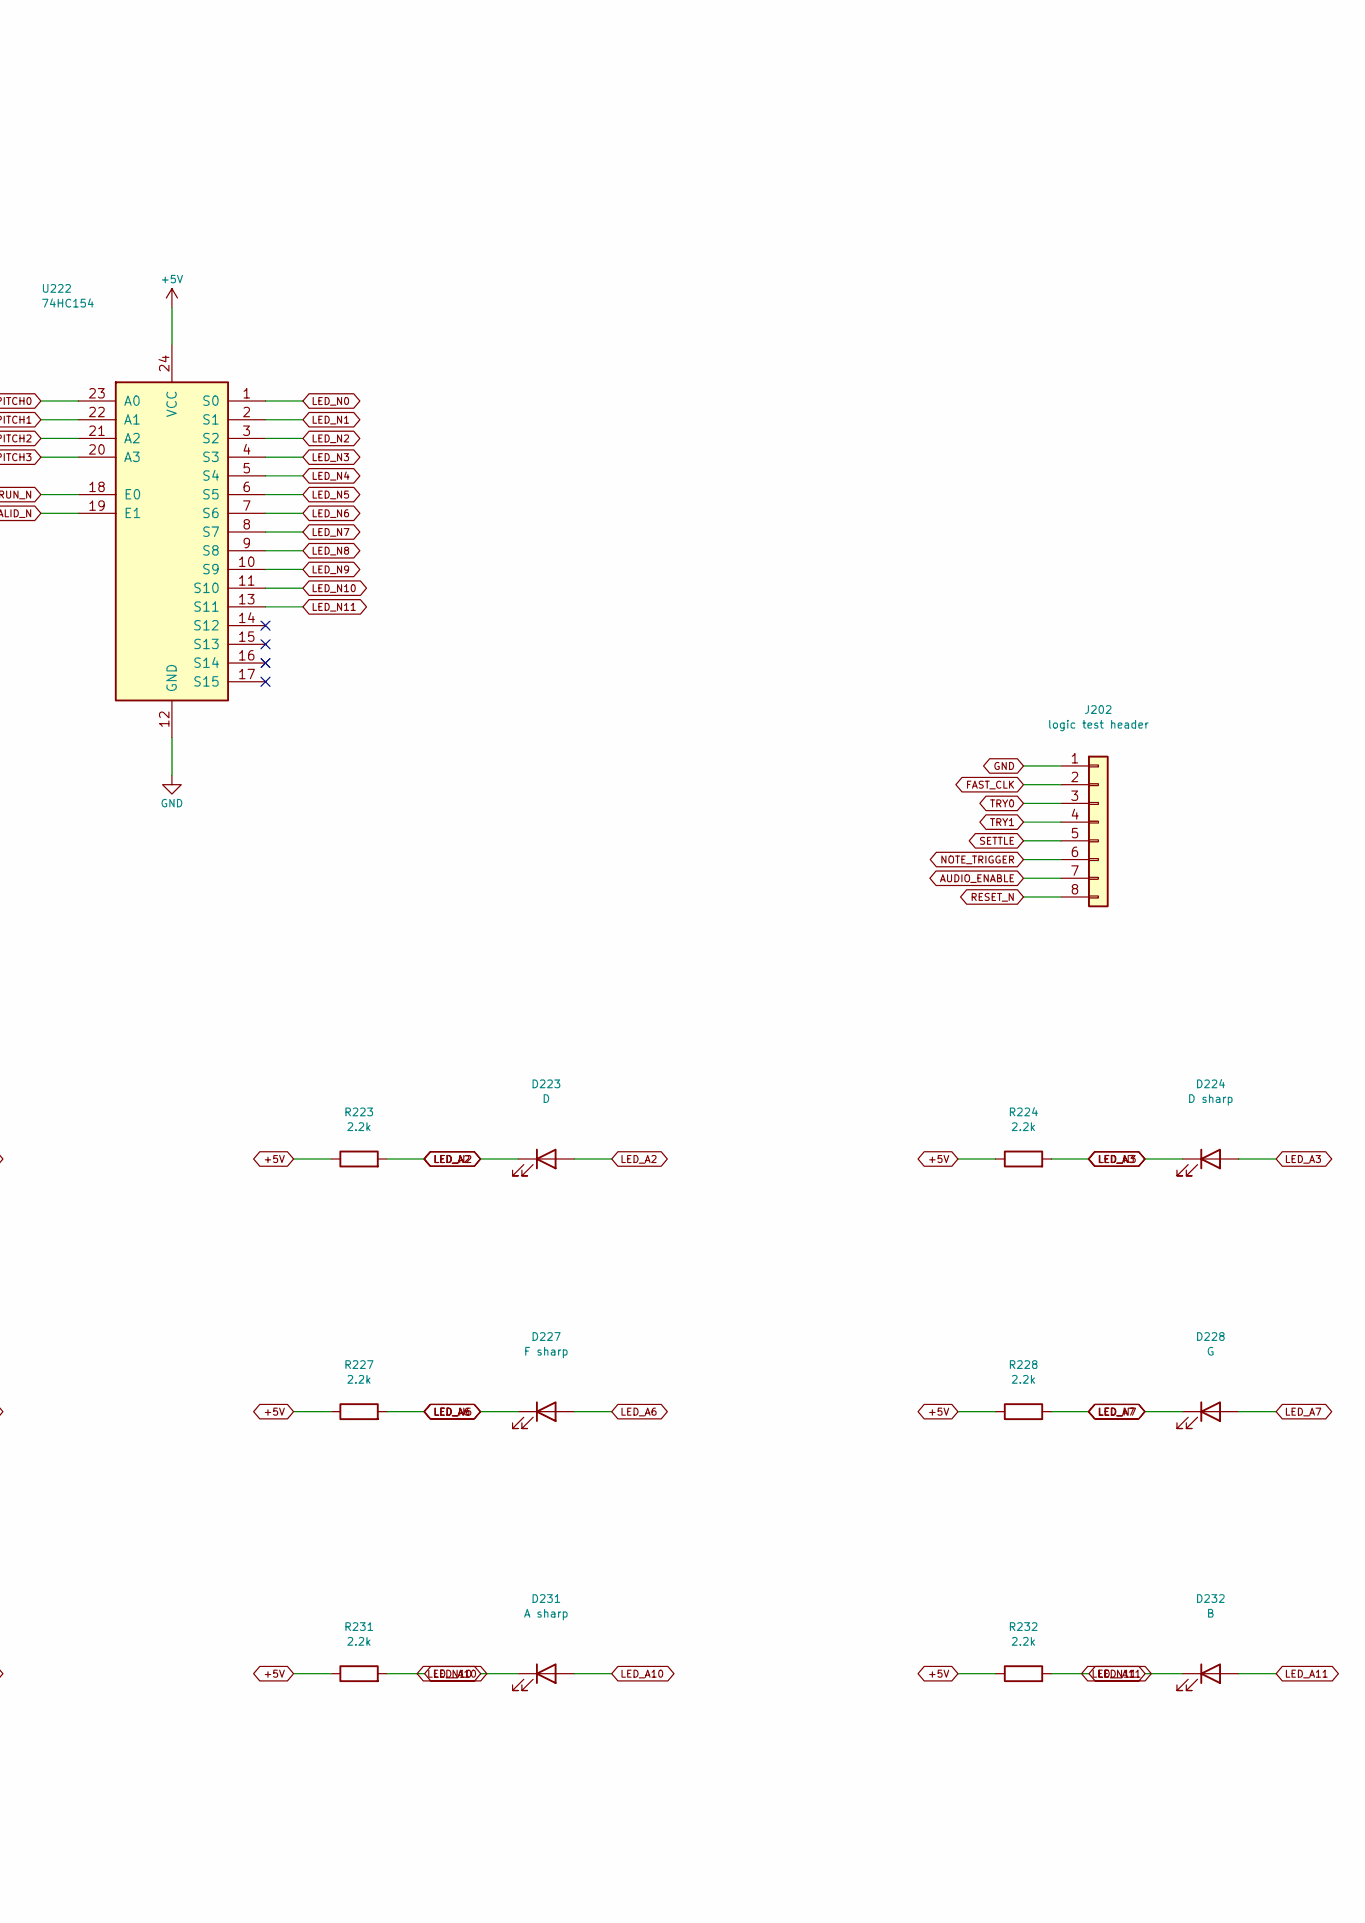
[picture p52: schematic 06_pitch_register.kicad_sch, Sounding pitch register and indicators, part in row 1, column 2]

Parts:
D221: C; LED_0805_2012Metric
D222: C sharp; LED_0805_2012Metric
D223: D; LED_0805_2012Metric
D224: D sharp; LED_0805_2012Metric
D225: E; LED_0805_2012Metric
D226: F; LED_0805_2012Metric
D227: F sharp; LED_0805_2012Metric
D228: G; LED_0805_2012Metric
D229: G sharp; LED_0805_2012Metric
D230: A; LED_0805_2012Metric
D231: A sharp; LED_0805_2012Metric
D232: B; LED_0805_2012Metric
J202: logic test header; PinHeader_1x08_P2.54mm_Vertical
R221, R222, R223, R224, R225, R226, R227, R228, R229, R230, R231, R232: 2.2k; R_0805_2012Metric
U221: 74HC377; SOIC-20W_7.5x12.8mm_P1.27mm; MPN 74HC377D,653
U222: 74HC154; SOIC-24W_7.5x15.4mm_P1.27mm; MPN CD74HC154M96

Connections:
+5V: R221.1, R222.1, R223.1, R224.1, R225.1, R226.1, R227.1, R228.1, R229.1, R230.1, R231.1, R232.1, U221.20 (VCC), U222.24 (VCC); also elsewhere on the board
AUDIO_ENABLE: J202.7; also elsewhere on the board
COMMIT_N: U221.1 (~E); also elsewhere on the board
FAST_CLK: J202.2, U221.11 (CP); also elsewhere on the board
LAST_R0: U221.16 (Q6); also elsewhere on the board
LAST_R1: U221.19 (Q7); also elsewhere on the board
LED_A0: D221.2 (A), R221.2
LED_A1: D222.2 (A), R222.2
LED_A2: D223.2 (A), R223.2
LED_A3: D224.2 (A), R224.2
LED_A4: D225.2 (A), R225.2
LED_A5: D226.2 (A), R226.2
LED_A6: D227.2 (A), R227.2
LED_A7: D228.2 (A), R228.2
LED_A8: D229.2 (A), R229.2
LED_A9: D230.2 (A), R230.2
LED_A10: D231.2 (A), R231.2
LED_A11: D232.2 (A), R232.2
LED_N0: D221.1 (K), U222.1 (S0)
LED_N1: D222.1 (K), U222.2 (S1)
LED_N2: D223.1 (K), U222.3 (S2)
LED_N3: D224.1 (K), U222.4 (S3)
LED_N4: D225.1 (K), U222.5 (S4)
LED_N5: D226.1 (K), U222.6 (S5)
LED_N6: D227.1 (K), U222.7 (S6)
LED_N7: D228.1 (K), U222.8 (S7)
LED_N8: D229.1 (K), U222.9 (S8)
LED_N9: D230.1 (K), U222.10 (S9)
LED_N10: D231.1 (K), U222.11 (S10)
LED_N11: D232.1 (K), U222.13 (S11)
N0: U221.3 (D0); also elsewhere on the board
N1: U221.4 (D1); also elsewhere on the board
N2: U221.7 (D2); also elsewhere on the board
N3: U221.8 (D3); also elsewhere on the board
NOTE_TRIGGER: J202.6; also elsewhere on the board
O0: U221.13 (D4); also elsewhere on the board
O1: U221.14 (D5); also elsewhere on the board
OCTAVE0: U221.12 (Q4); also elsewhere on the board
OCTAVE1: U221.15 (Q5); also elsewhere on the board
PITCH0: U221.2 (Q0), U222.23 (A0); also elsewhere on the board
PITCH1: U221.5 (Q1), U222.22 (A1); also elsewhere on the board
PITCH2: U221.6 (Q2), U222.21 (A2); also elsewhere on the board
PITCH3: U221.9 (Q3), U222.20 (A3); also elsewhere on the board
RANGE0: U221.17 (D6); also elsewhere on the board
RANGE1: U221.18 (D7); also elsewhere on the board
RESET_N: J202.8; also elsewhere on the board
RUN_N: U222.18 (E0); also elsewhere on the board
SETTLE: J202.5; also elsewhere on the board
TRY0: J202.3; also elsewhere on the board
TRY1: J202.4; also elsewhere on the board
VALID_N: U222.19 (E1); also elsewhere on the board

Notes on the sheet:
Sounding pitch register and indicators
Sounding note and octave stay fixed during the next search.
PITCH and OCTAVE feed the analog switches. NOTE_TRIGGER starts the envelope; AUDIO_ENABLE mutes it.
