EwoudVV/arpeggiator/arpeggiator.kicad_pcb

## KiCad design arpeggiator.kicad_pcb (continued)

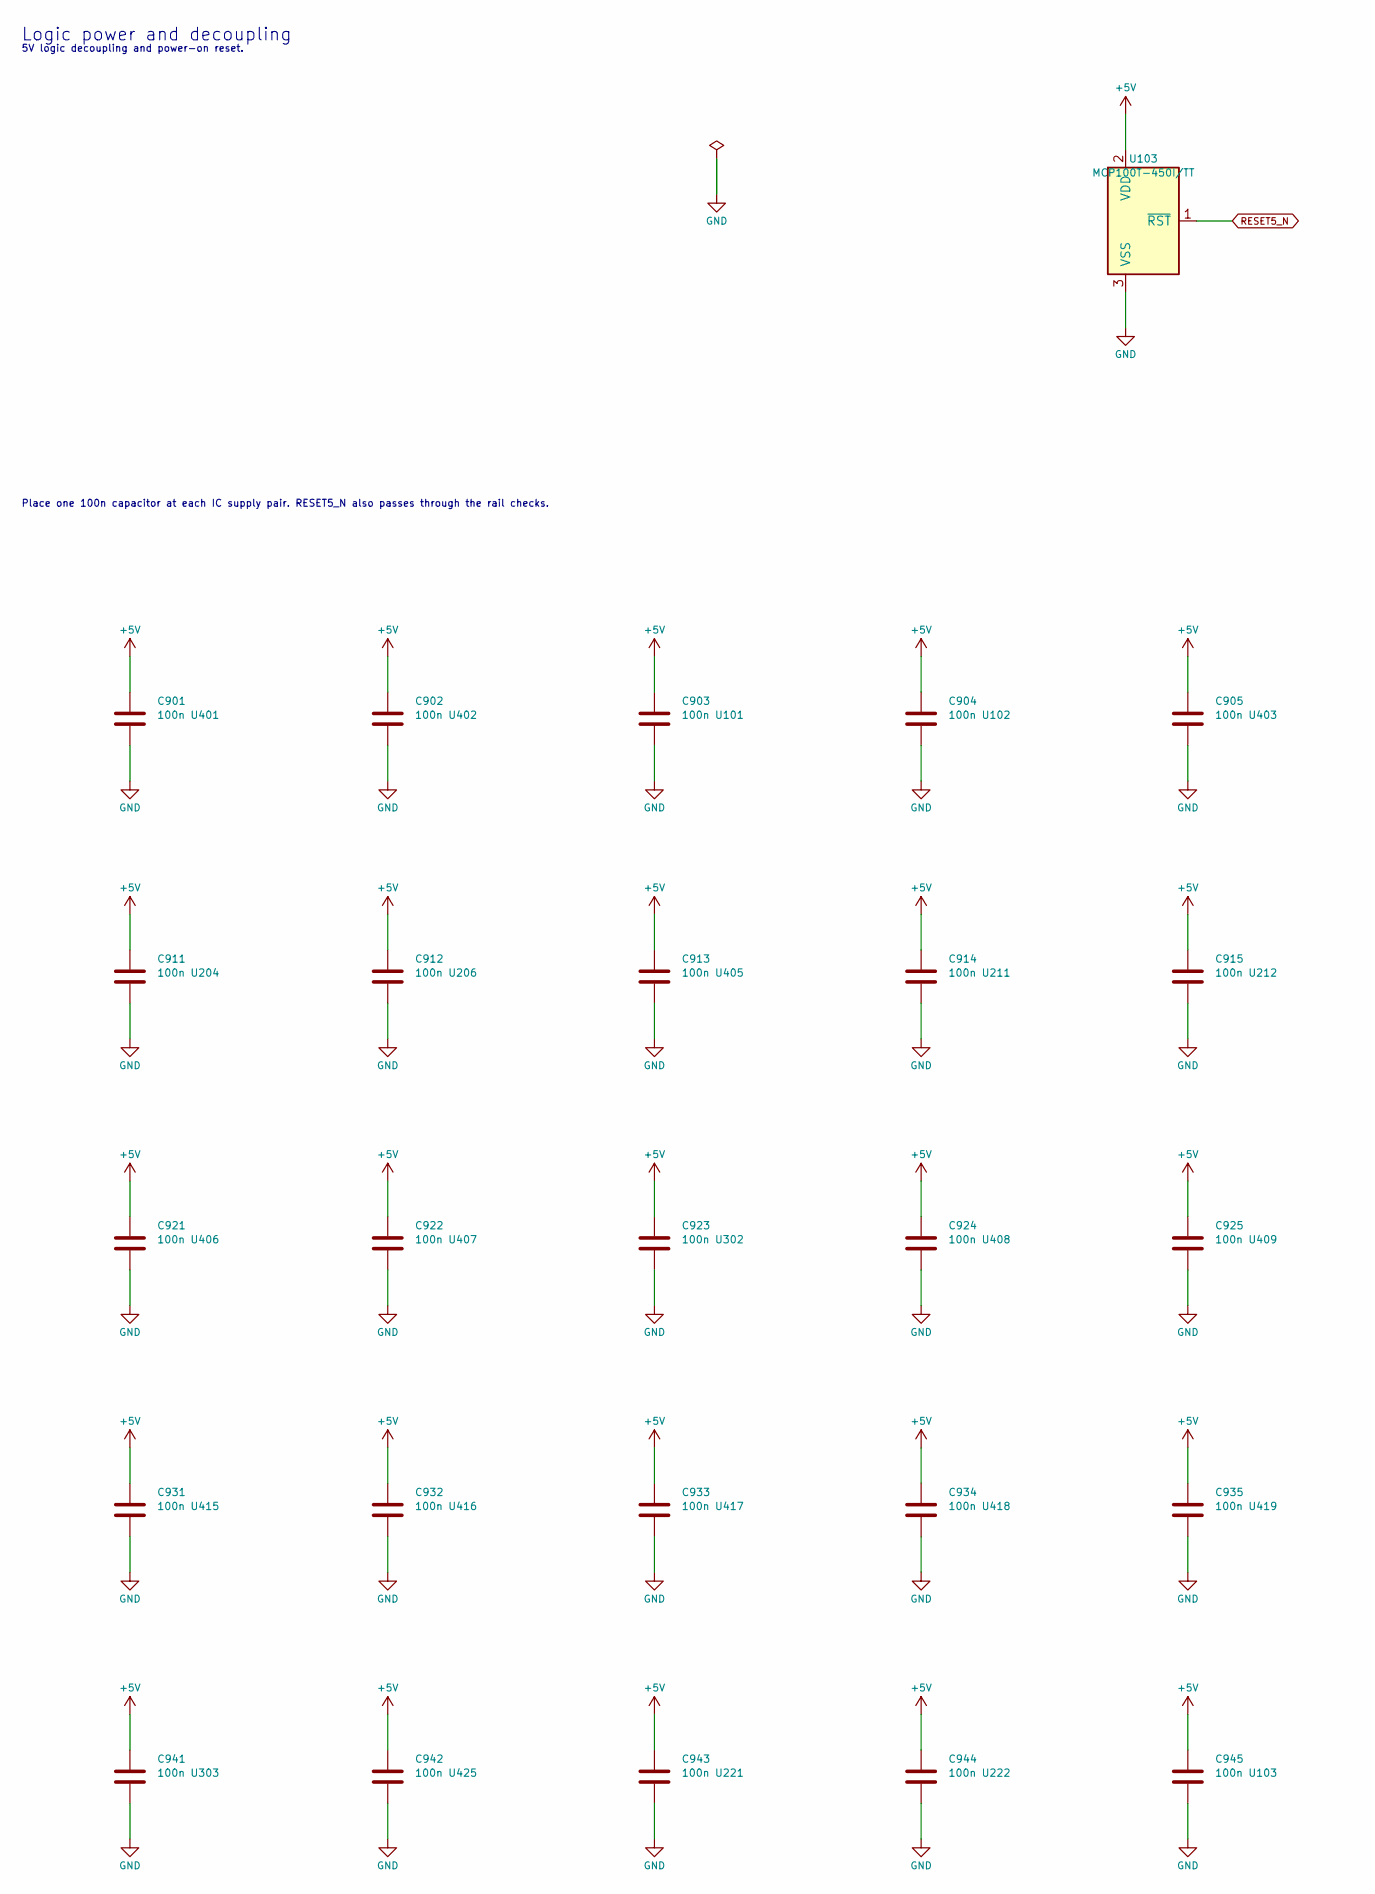
[picture p53: schematic 07_power.kicad_sch, Logic power and decoupling, part in row 1, column 1]

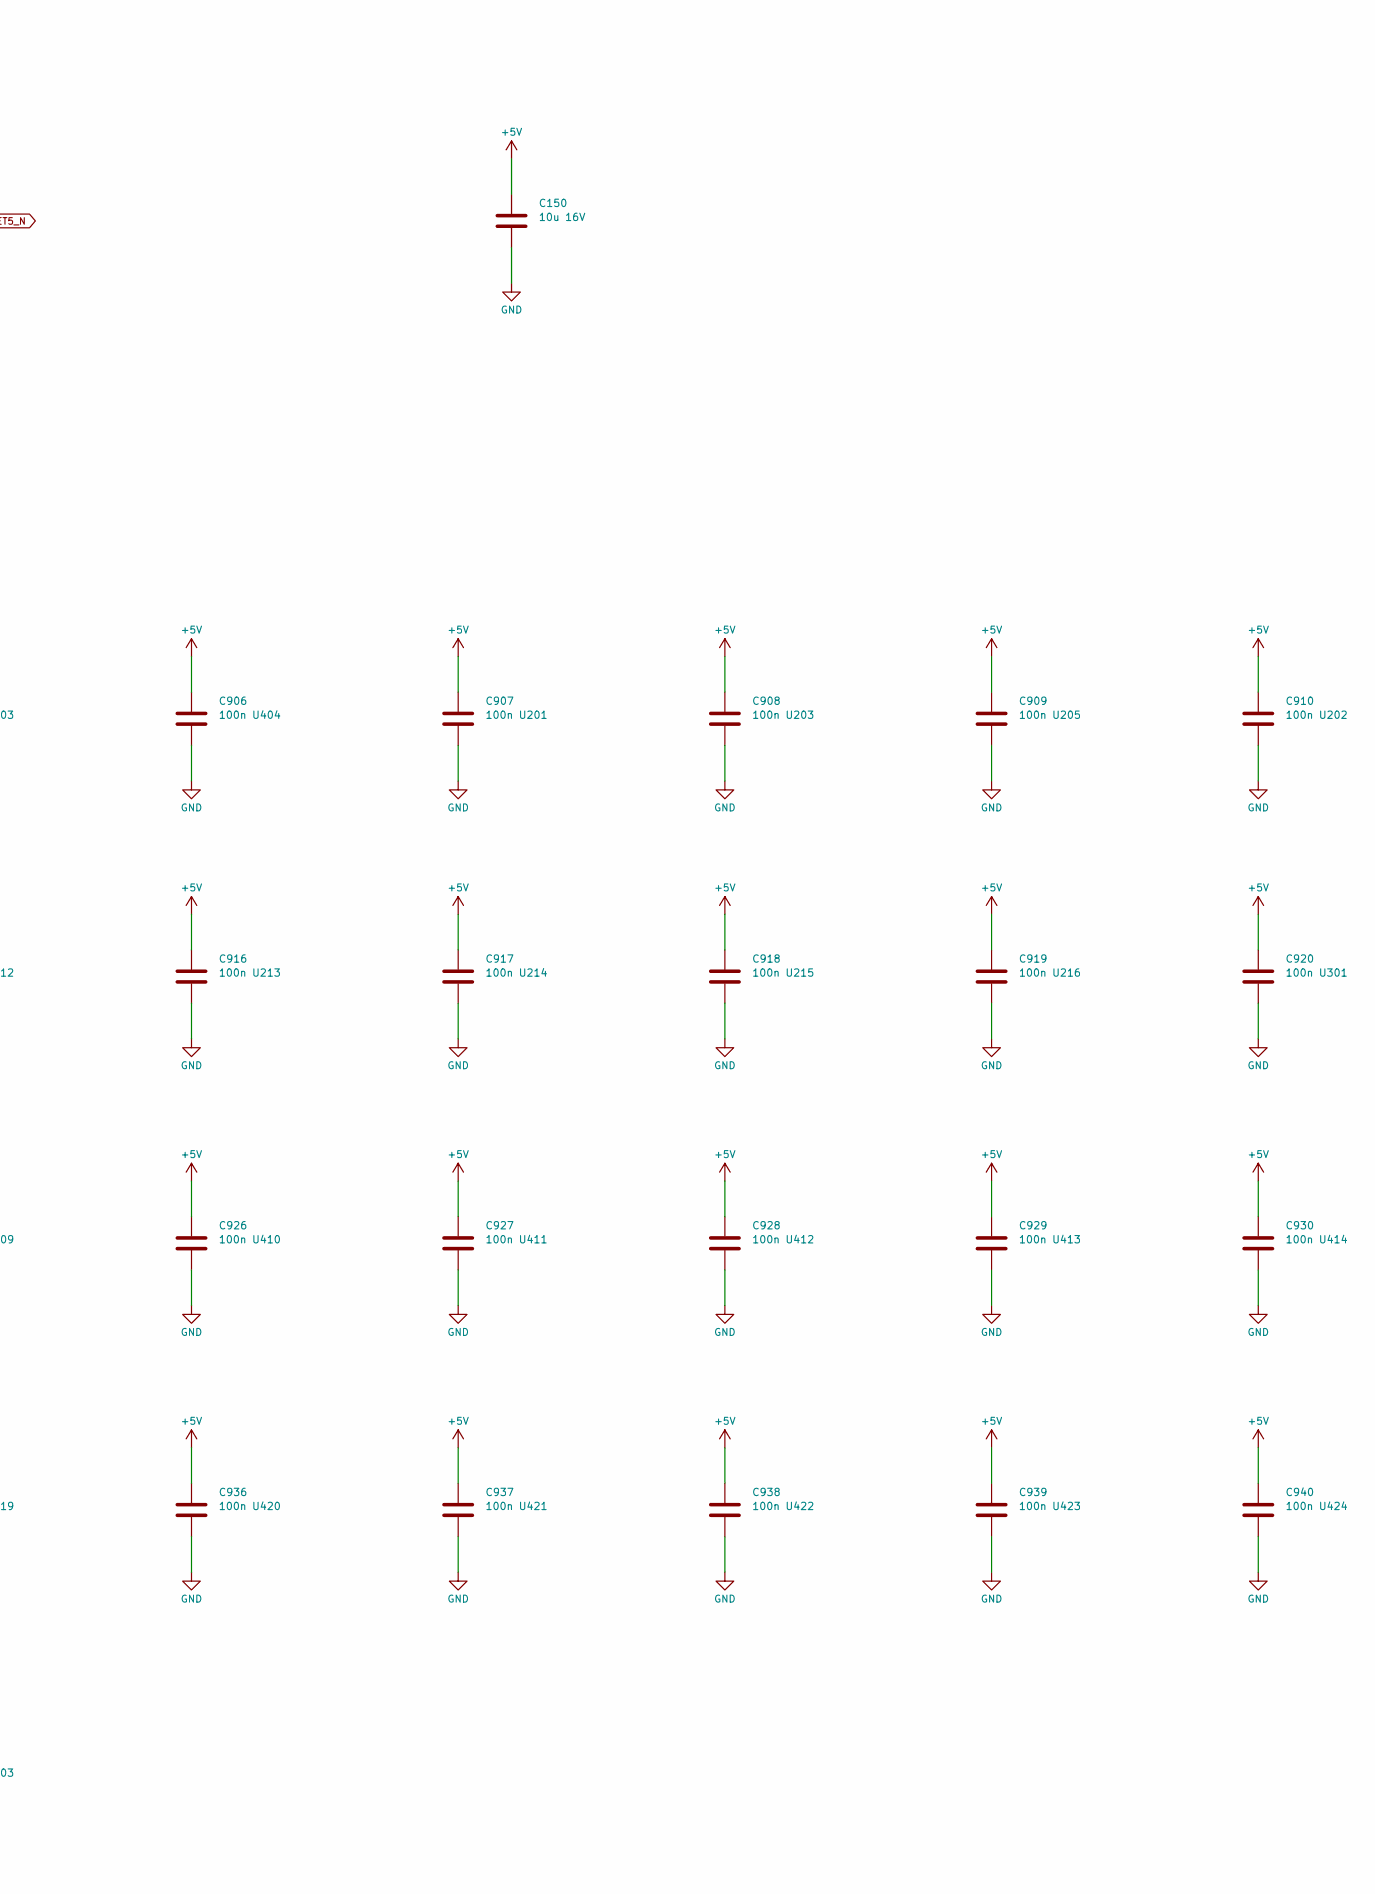
[picture p54: schematic 07_power.kicad_sch, Logic power and decoupling, part in row 1, column 2]

Parts:
C150: 10u 16V; C_0805_2012Metric
C901: 100n U401; C_0805_2012Metric
C902: 100n U402; C_0805_2012Metric
C903: 100n U101; C_0805_2012Metric
C904: 100n U102; C_0805_2012Metric
C905: 100n U403; C_0805_2012Metric
C906: 100n U404; C_0805_2012Metric
C907: 100n U201; C_0805_2012Metric
C908: 100n U203; C_0805_2012Metric
C909: 100n U205; C_0805_2012Metric
C910: 100n U202; C_0805_2012Metric
C911: 100n U204; C_0805_2012Metric
C912: 100n U206; C_0805_2012Metric
C913: 100n U405; C_0805_2012Metric
C914: 100n U211; C_0805_2012Metric
C915: 100n U212; C_0805_2012Metric
C916: 100n U213; C_0805_2012Metric
C917: 100n U214; C_0805_2012Metric
C918: 100n U215; C_0805_2012Metric
C919: 100n U216; C_0805_2012Metric
C920: 100n U301; C_0805_2012Metric
C921: 100n U406; C_0805_2012Metric
C922: 100n U407; C_0805_2012Metric
C923: 100n U302; C_0805_2012Metric
C924: 100n U408; C_0805_2012Metric
C925: 100n U409; C_0805_2012Metric
C926: 100n U410; C_0805_2012Metric
C927: 100n U411; C_0805_2012Metric
C928: 100n U412; C_0805_2012Metric
C929: 100n U413; C_0805_2012Metric
C930: 100n U414; C_0805_2012Metric
C931: 100n U415; C_0805_2012Metric
C932: 100n U416; C_0805_2012Metric
C933: 100n U417; C_0805_2012Metric
C934: 100n U418; C_0805_2012Metric
C935: 100n U419; C_0805_2012Metric
C936: 100n U420; C_0805_2012Metric
C937: 100n U421; C_0805_2012Metric
C938: 100n U422; C_0805_2012Metric
C939: 100n U423; C_0805_2012Metric
C940: 100n U424; C_0805_2012Metric
C941: 100n U303; C_0805_2012Metric
C942: 100n U425; C_0805_2012Metric
C943: 100n U221; C_0805_2012Metric
C944: 100n U222; C_0805_2012Metric
C945: 100n U103; C_0805_2012Metric
U103: MCP100T-450I/TT; SOT-23; MPN MCP100T-450I/TT

Connections:
+5V: C150.1, C901.1, C902.1, C903.1, C904.1, C905.1, C906.1, C907.1, C908.1, C909.1, C910.1, C911.1, C912.1, C913.1, C914.1, C915.1, C916.1, C917.1, C918.1, C919.1, C920.1, C921.1, C922.1, C923.1, C924.1, C925.1, C926.1, C927.1, C928.1, C929.1, C930.1, C931.1, C932.1, C933.1, C934.1, C935.1, C936.1, C937.1, C938.1, C939.1, C940.1, C941.1, C942.1, C943.1, C944.1, C945.1, U103.2 (VDD); also elsewhere on the board
RESET5_N: U103.1 (~RST); also elsewhere on the board

Notes on the sheet:
Logic power and decoupling
5V logic decoupling and power-on reset.
Place one 100n capacitor at each IC supply pair. RESET5_N also passes through the rail checks.

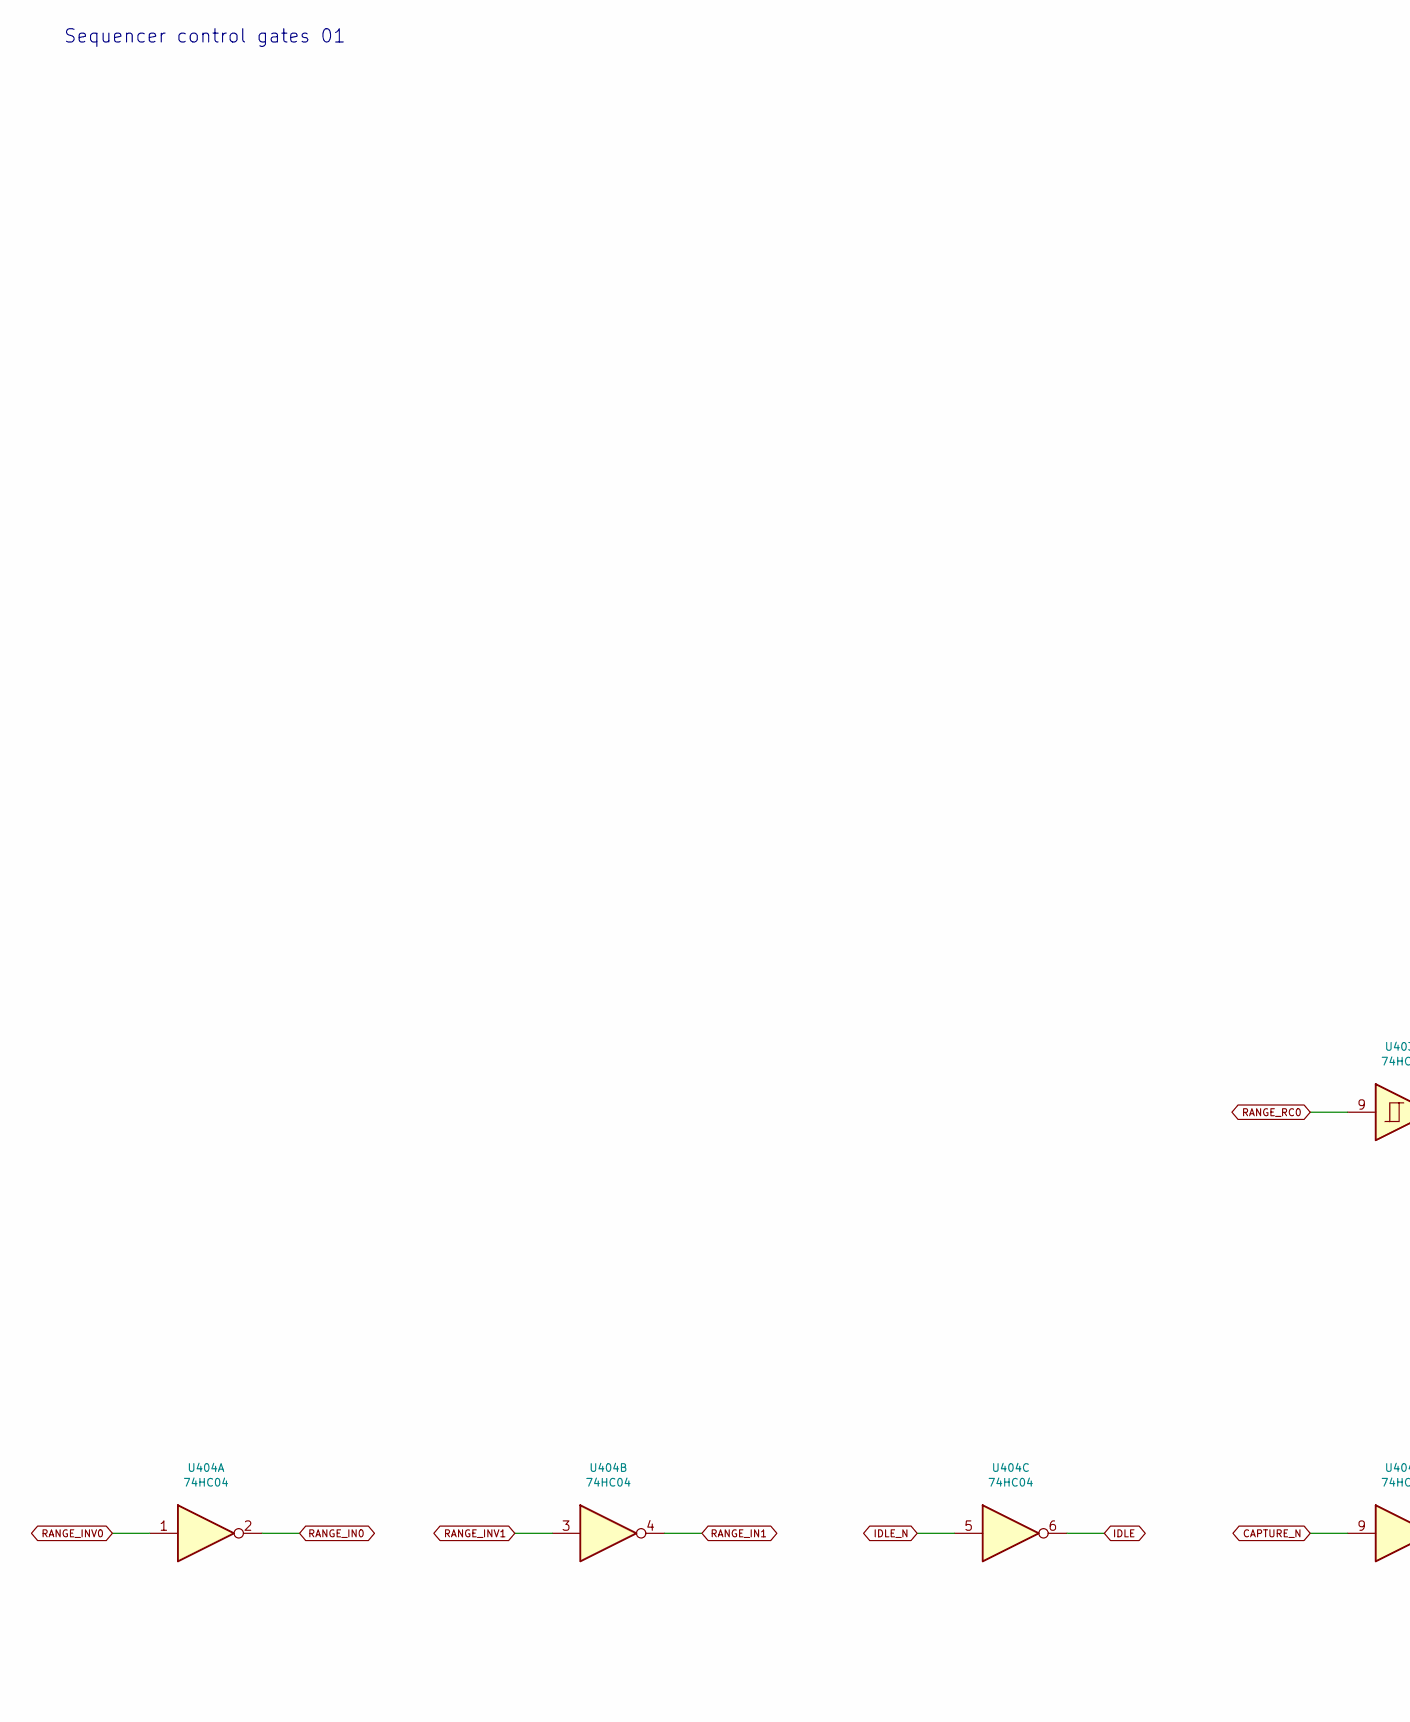
[picture p55: schematic logic_01.kicad_sch, Sequencer control gates 01, part in row 1, column 1]

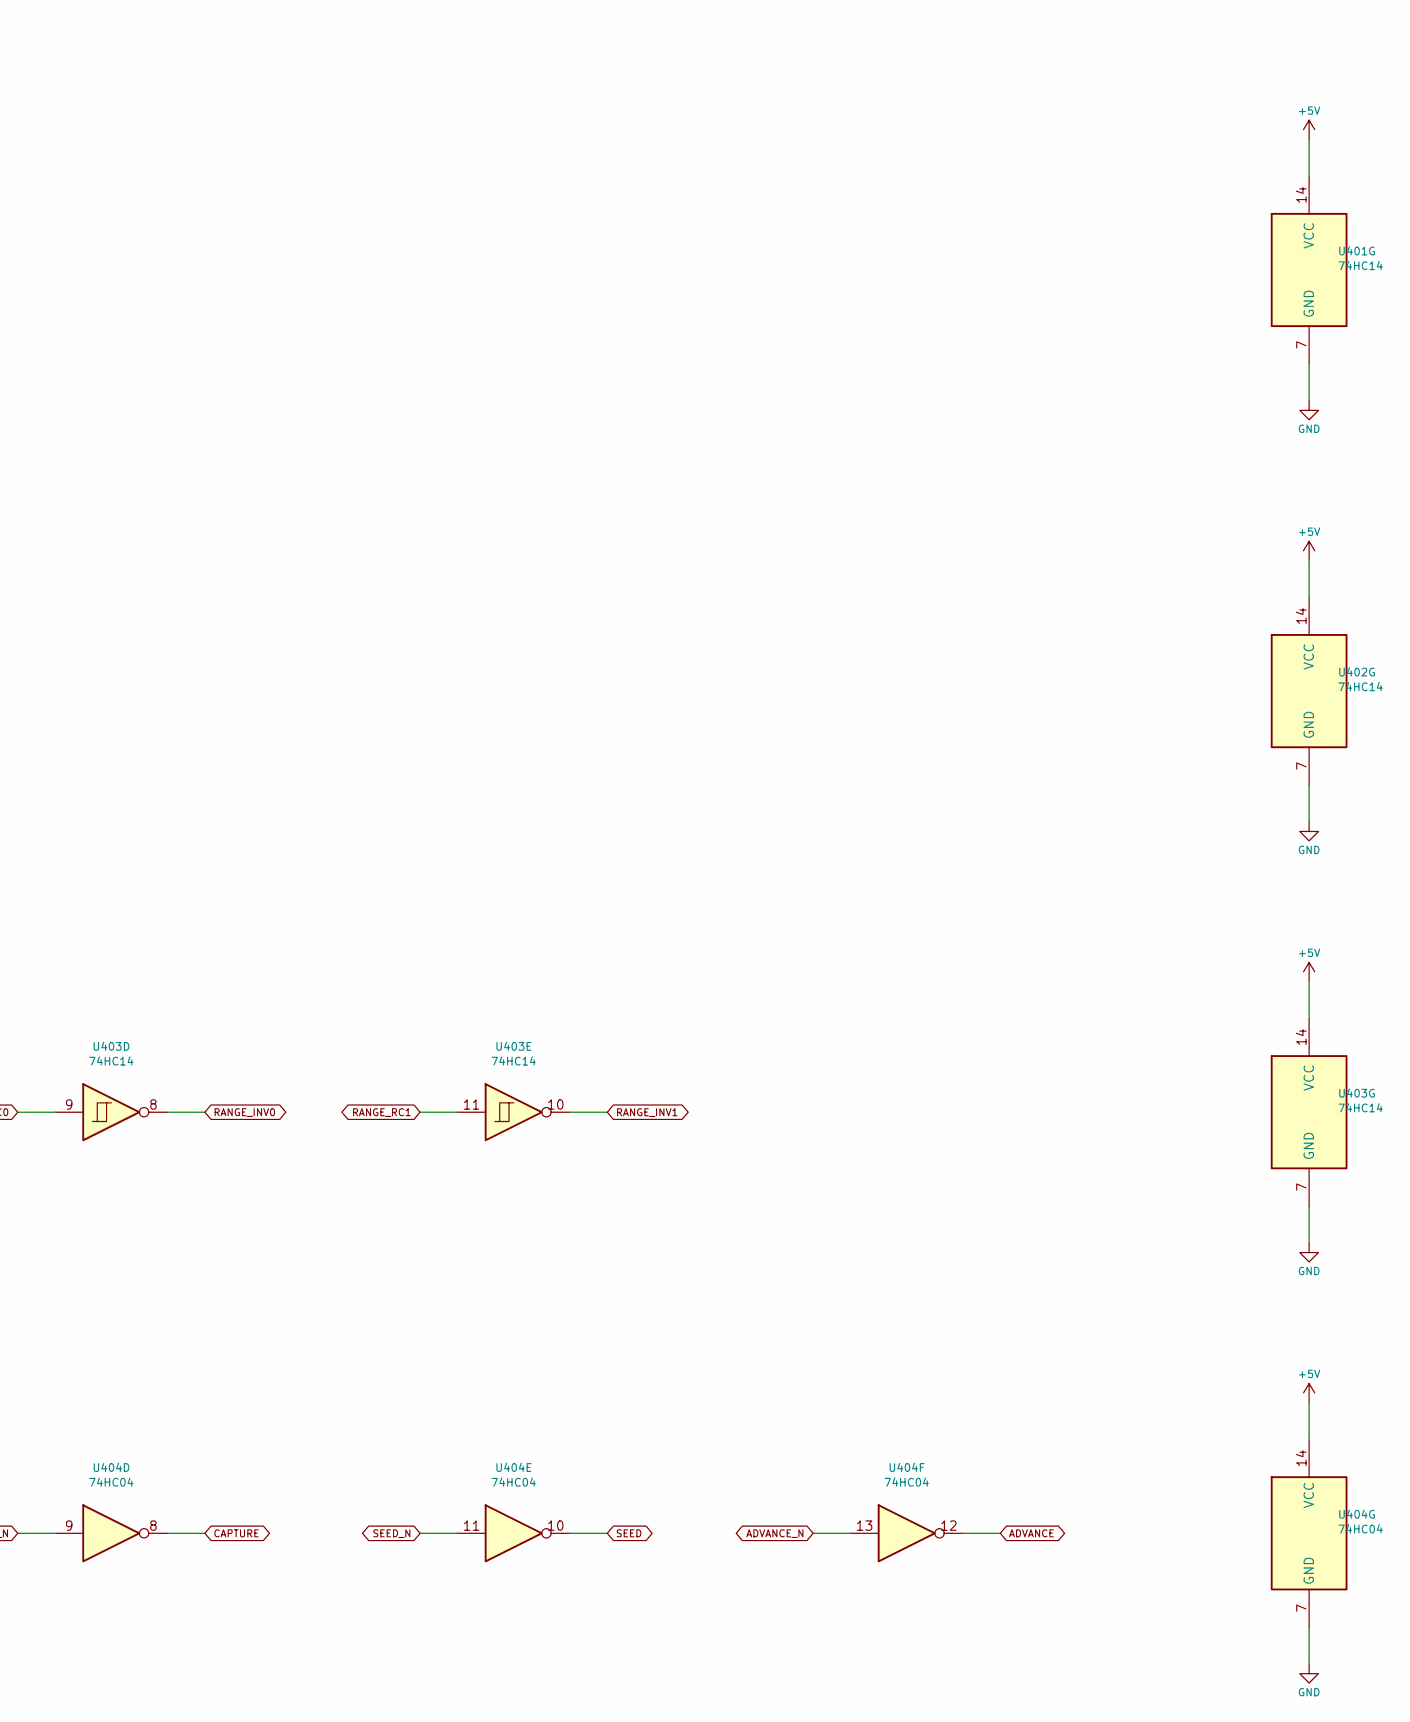
[picture p56: schematic logic_01.kicad_sch, Sequencer control gates 01, part in row 1, column 2]

Parts:
U401, U402, U403: 74HC14; SOIC-14_3.9x8.7mm_P1.27mm; MPN 74HC14D,653
U404: 74HC04; SOIC-14_3.9x8.7mm_P1.27mm; MPN 74HC04D,653

Connections:
+5V: U401.14 (VCC), U402.14 (VCC), U403.14 (VCC), U404.14 (VCC); also elsewhere on the board
ADVANCE: U404.12; also elsewhere on the board
ADVANCE_N: U404.13; also elsewhere on the board
CAPTURE: U404.8; also elsewhere on the board
CAPTURE_N: U404.9; also elsewhere on the board
IDLE: U404.6; also elsewhere on the board
IDLE_N: U404.5; also elsewhere on the board
RANGE_IN0: U404.2; also elsewhere on the board
RANGE_IN1: U404.4; also elsewhere on the board
RANGE_INV0: U403.8, U404.1
RANGE_INV1: U403.10, U404.3
RANGE_RC0: U403.9; also elsewhere on the board
RANGE_RC1: U403.11; also elsewhere on the board
SEED: U404.10; also elsewhere on the board
SEED_N: U404.11; also elsewhere on the board

Notes on the sheet:
Sequencer control gates 01

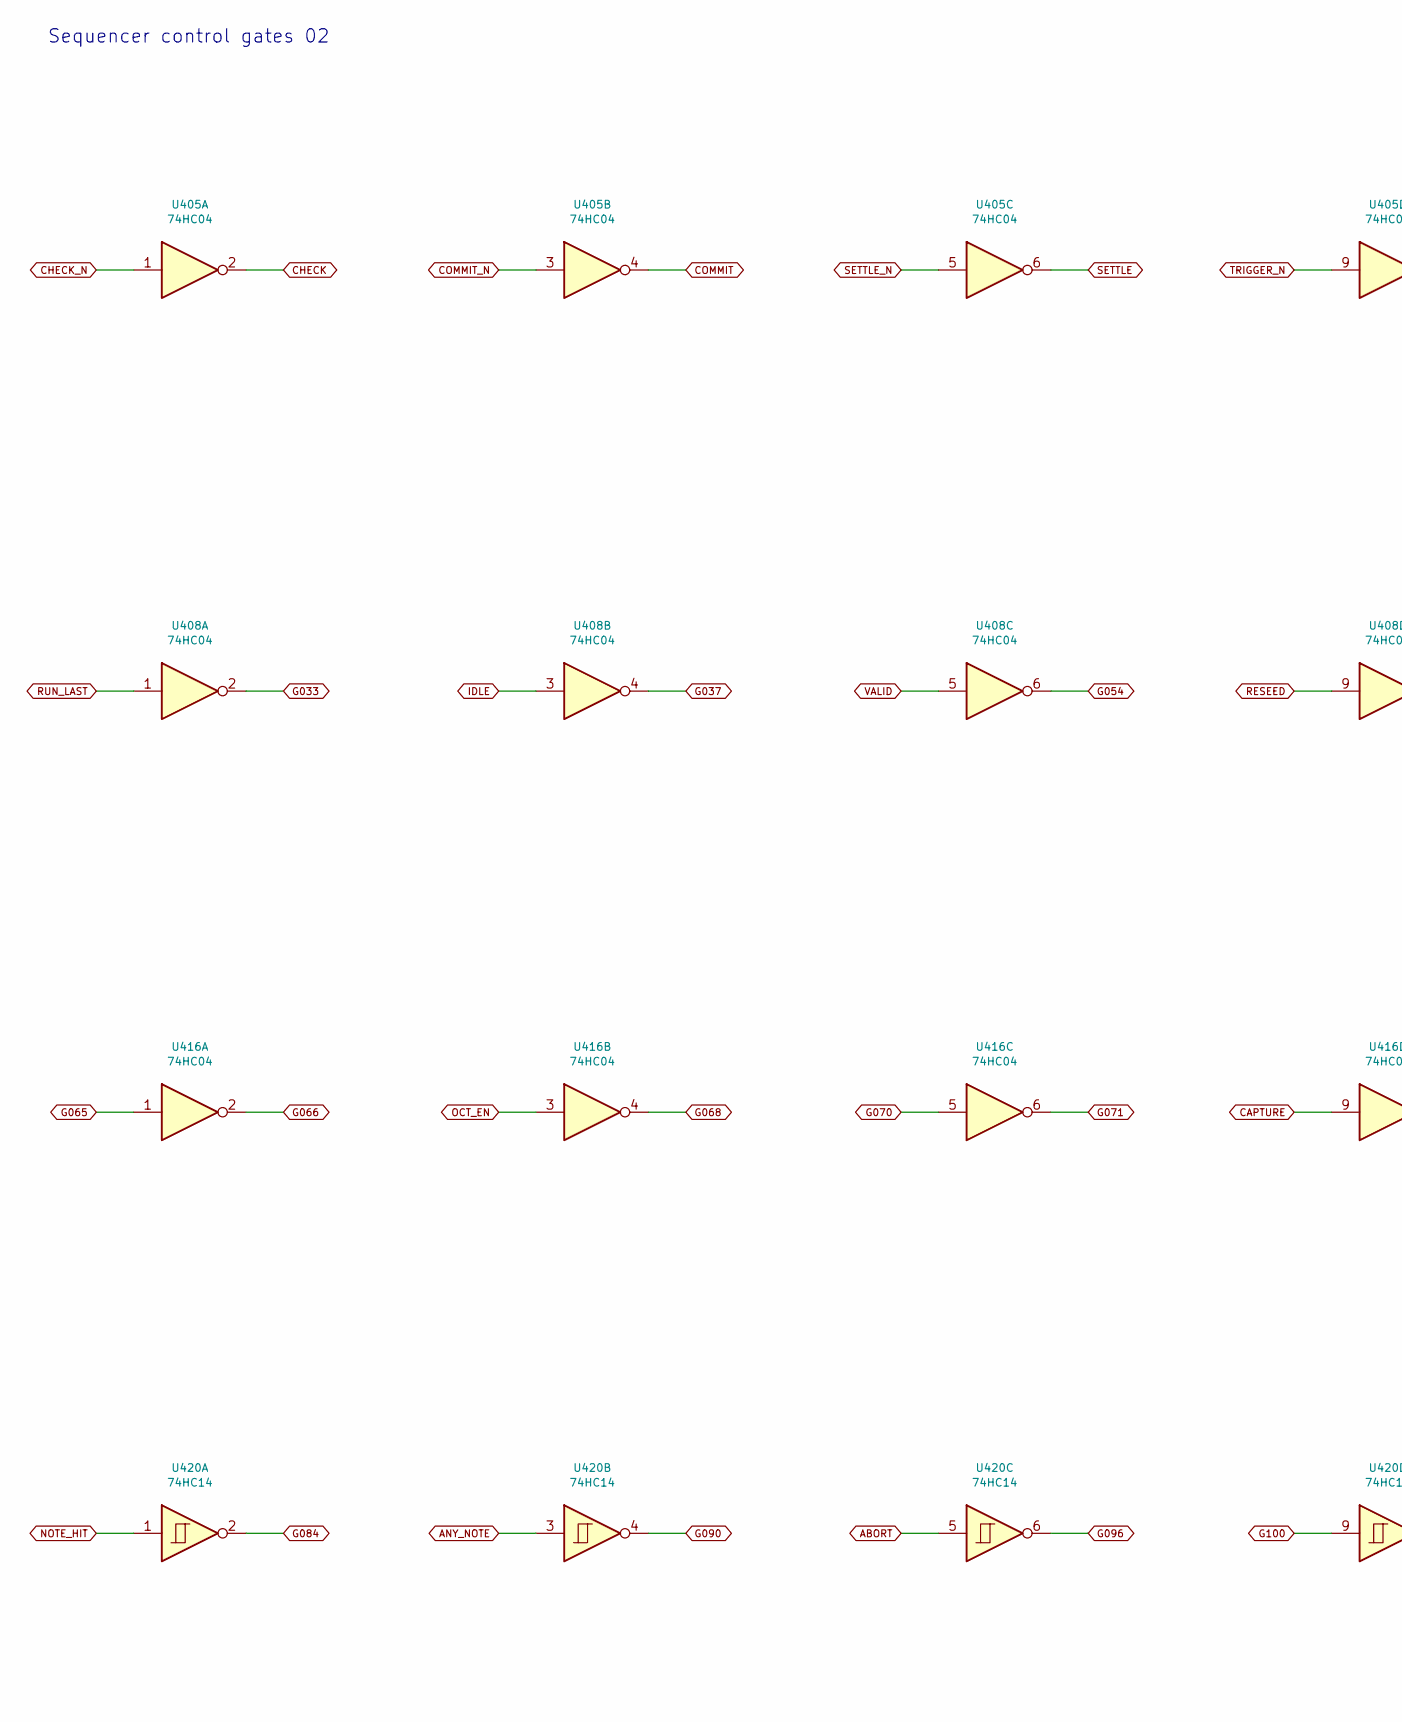
[picture p57: schematic logic_02.kicad_sch, Sequencer control gates 02, part in row 1, column 1]

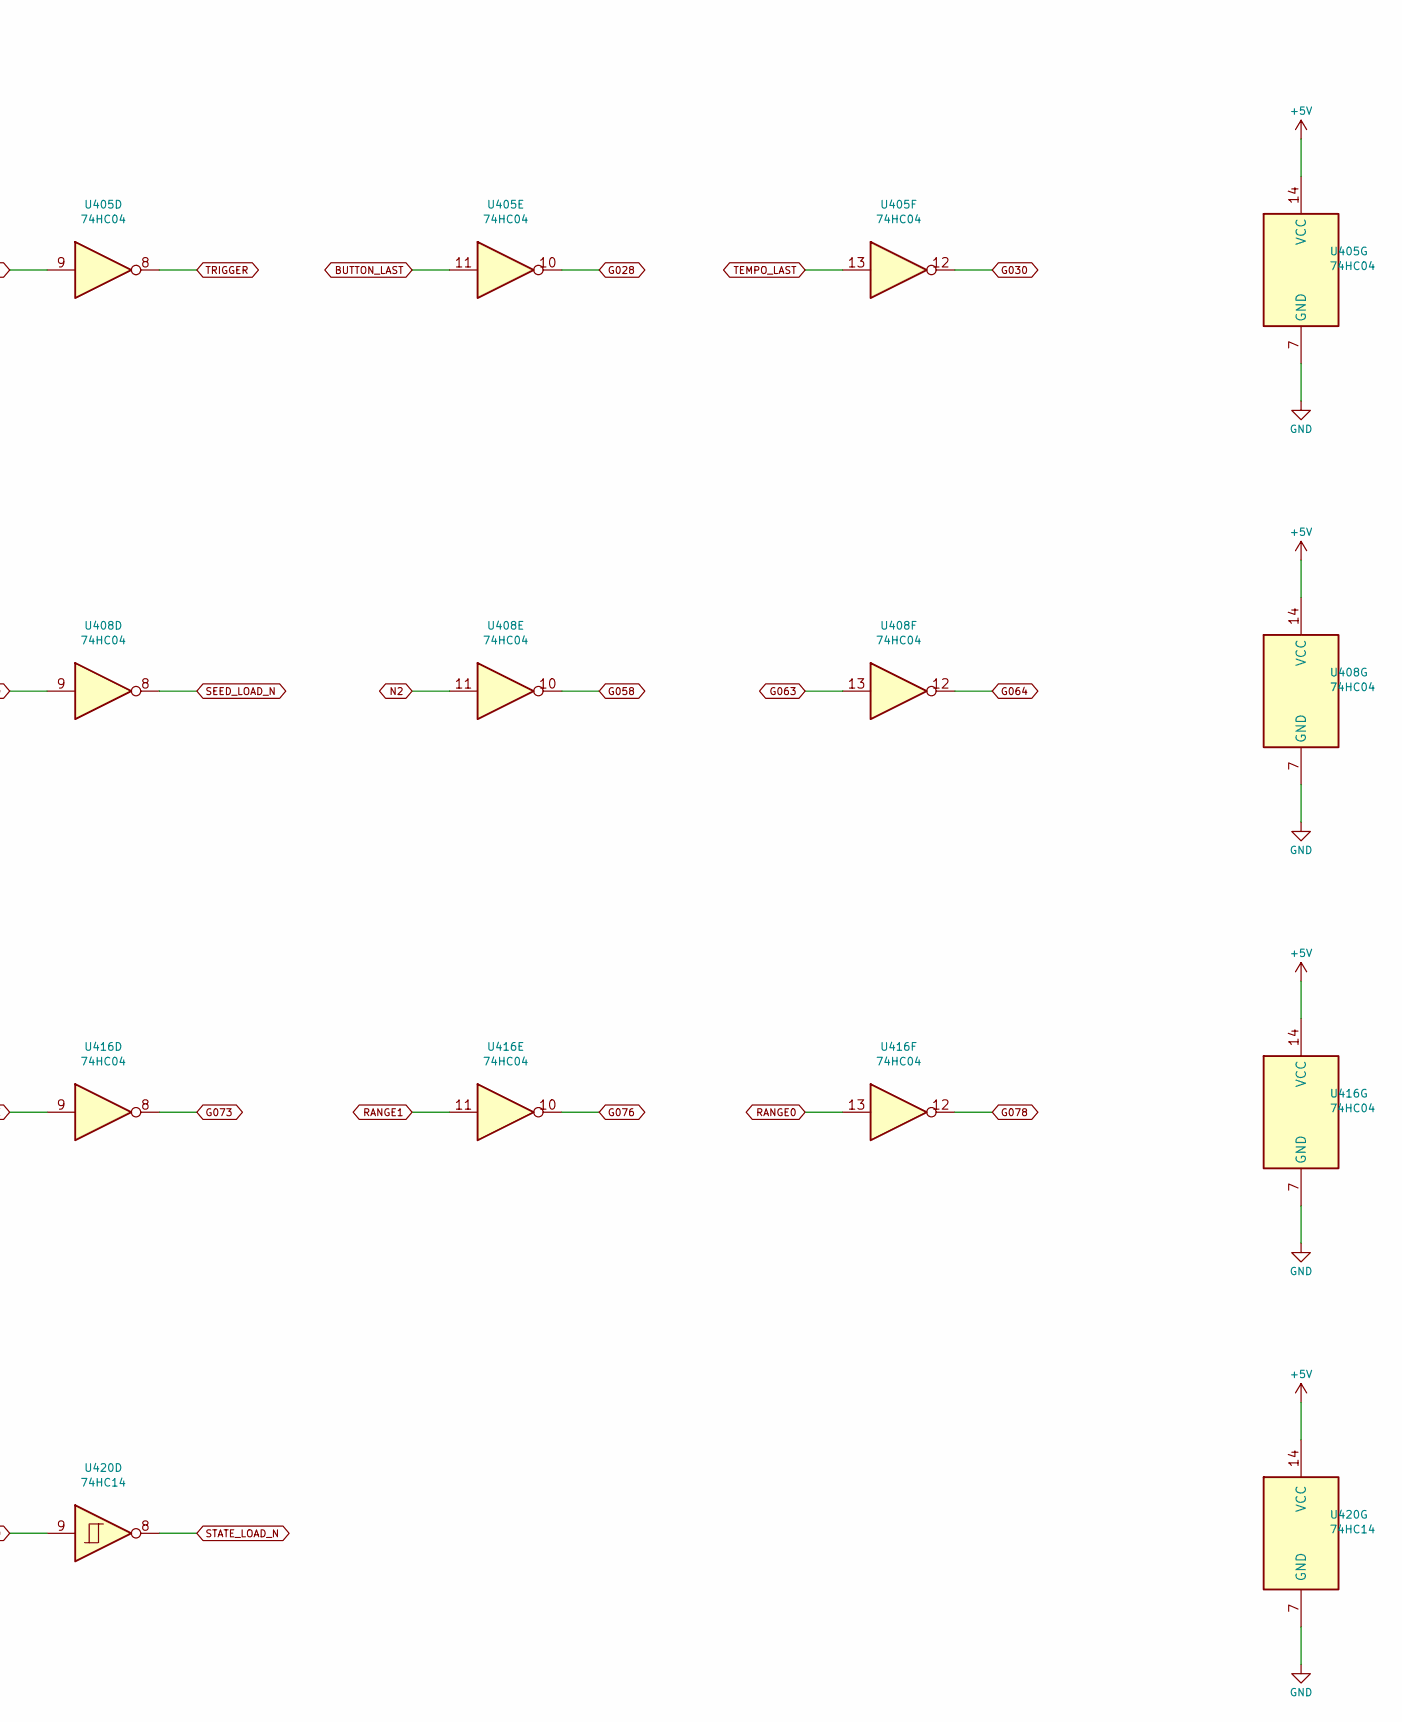
[picture p58: schematic logic_02.kicad_sch, Sequencer control gates 02, part in row 1, column 2]

Parts:
U405, U408, U416: 74HC04; SOIC-14_3.9x8.7mm_P1.27mm; MPN 74HC04D,653
U420: 74HC14; SOIC-14_3.9x8.7mm_P1.27mm; MPN 74HC14D,653

Connections:
+5V: U405.14 (VCC), U408.14 (VCC), U416.14 (VCC), U420.14 (VCC); also elsewhere on the board
ABORT: U420.5; also elsewhere on the board
ANY_NOTE: U420.3; also elsewhere on the board
BUTTON_LAST: U405.11; also elsewhere on the board
CAPTURE: U416.9; also elsewhere on the board
CHECK: U405.2; also elsewhere on the board
CHECK_N: U405.1; also elsewhere on the board
COMMIT: U405.4; also elsewhere on the board
COMMIT_N: U405.3; also elsewhere on the board
G028: U405.10; also elsewhere on the board
G030: U405.12; also elsewhere on the board
G033: U408.2; also elsewhere on the board
G037: U408.4; also elsewhere on the board
G054: U408.6; also elsewhere on the board
G058: U408.10; also elsewhere on the board
G063: U408.13; also elsewhere on the board
G064: U408.12; also elsewhere on the board
G065: U416.1; also elsewhere on the board
G066: U416.2; also elsewhere on the board
G068: U416.4; also elsewhere on the board
G070: U416.5; also elsewhere on the board
G071: U416.6; also elsewhere on the board
G073: U416.8; also elsewhere on the board
G076: U416.10; also elsewhere on the board
G078: U416.12; also elsewhere on the board
G084: U420.2; also elsewhere on the board
G090: U420.4; also elsewhere on the board
G096: U420.6; also elsewhere on the board
G100: U420.9; also elsewhere on the board
IDLE: U408.3; also elsewhere on the board
N2: U408.11; also elsewhere on the board
NOTE_HIT: U420.1; also elsewhere on the board
OCT_EN: U416.3; also elsewhere on the board
RANGE0: U416.13; also elsewhere on the board
RANGE1: U416.11; also elsewhere on the board
RESEED: U408.9; also elsewhere on the board
RUN_LAST: U408.1; also elsewhere on the board
SEED_LOAD_N: U408.8; also elsewhere on the board
SETTLE: U405.6; also elsewhere on the board
SETTLE_N: U405.5; also elsewhere on the board
STATE_LOAD_N: U420.8; also elsewhere on the board
TEMPO_LAST: U405.13; also elsewhere on the board
TRIGGER: U405.8; also elsewhere on the board
TRIGGER_N: U405.9; also elsewhere on the board
VALID: U408.5; also elsewhere on the board

Notes on the sheet:
Sequencer control gates 02
