EwoudVV/arpeggiator/arpeggiator.kicad_pcb

## KiCad design arpeggiator.kicad_pcb (continued)

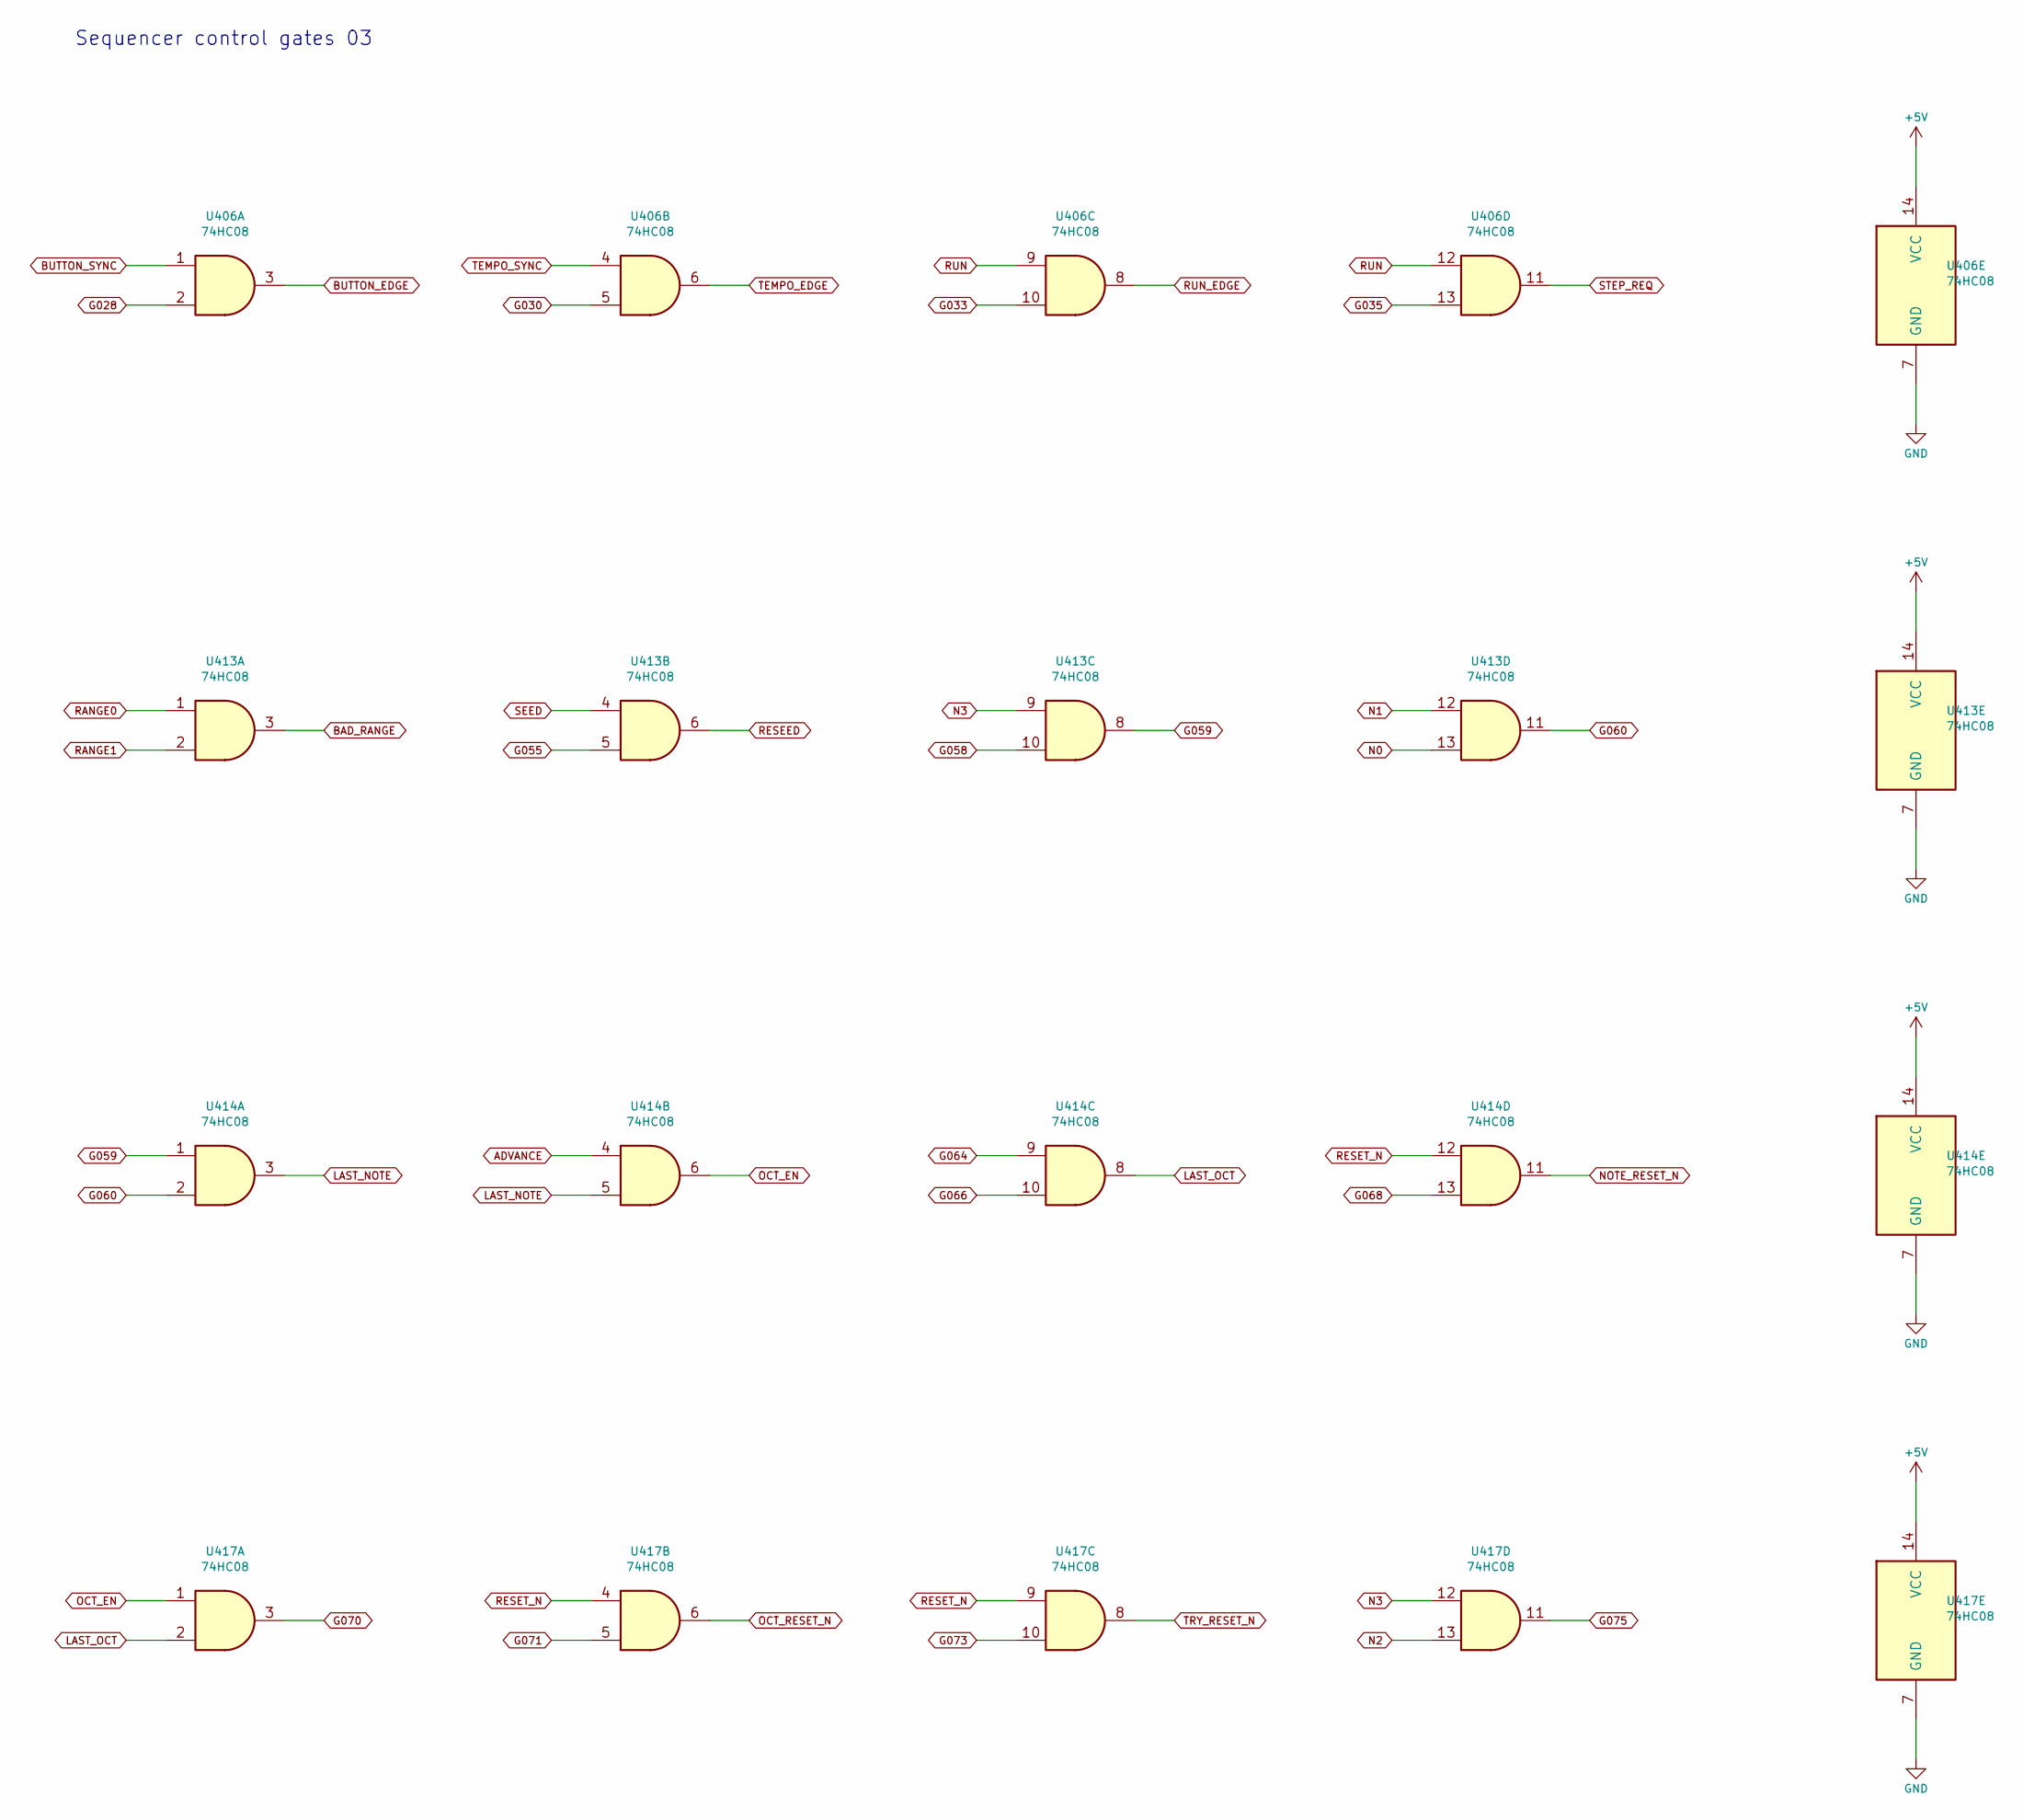
[picture p59: schematic logic_03.kicad_sch, Sequencer control gates 03]

Parts:
U406, U413, U414, U417: 74HC08; SOIC-14_3.9x8.7mm_P1.27mm; MPN 74HC08D,653

Connections:
+5V: U406.14 (VCC), U413.14 (VCC), U414.14 (VCC), U417.14 (VCC); also elsewhere on the board
ADVANCE: U414.4; also elsewhere on the board
BAD_RANGE: U413.3; also elsewhere on the board
BUTTON_EDGE: U406.3; also elsewhere on the board
BUTTON_SYNC: U406.1; also elsewhere on the board
G028: U406.2; also elsewhere on the board
G030: U406.5; also elsewhere on the board
G033: U406.10; also elsewhere on the board
G035: U406.13; also elsewhere on the board
G055: U413.5; also elsewhere on the board
G058: U413.10; also elsewhere on the board
G059: U413.8, U414.1
G060: U413.11, U414.2
G064: U414.9; also elsewhere on the board
G066: U414.10; also elsewhere on the board
G068: U414.13; also elsewhere on the board
G070: U417.3; also elsewhere on the board
G071: U417.5; also elsewhere on the board
G073: U417.10; also elsewhere on the board
G075: U417.11; also elsewhere on the board
LAST_NOTE: U414.3, U414.5
LAST_OCT: U414.8, U417.2
N0: U413.13; also elsewhere on the board
N1: U413.12; also elsewhere on the board
N2: U417.13; also elsewhere on the board
N3: U413.9, U417.12; also elsewhere on the board
NOTE_RESET_N: U414.11; also elsewhere on the board
OCT_EN: U414.6, U417.1; also elsewhere on the board
OCT_RESET_N: U417.6; also elsewhere on the board
RANGE0: U413.1; also elsewhere on the board
RANGE1: U413.2; also elsewhere on the board
RESEED: U413.6; also elsewhere on the board
RESET_N: U414.12, U417.4, U417.9; also elsewhere on the board
RUN: U406.9, U406.12; also elsewhere on the board
RUN_EDGE: U406.8; also elsewhere on the board
SEED: U413.4; also elsewhere on the board
STEP_REQ: U406.11; also elsewhere on the board
TEMPO_EDGE: U406.6; also elsewhere on the board
TEMPO_SYNC: U406.4; also elsewhere on the board
TRY_RESET_N: U417.8; also elsewhere on the board

Notes on the sheet:
Sequencer control gates 03

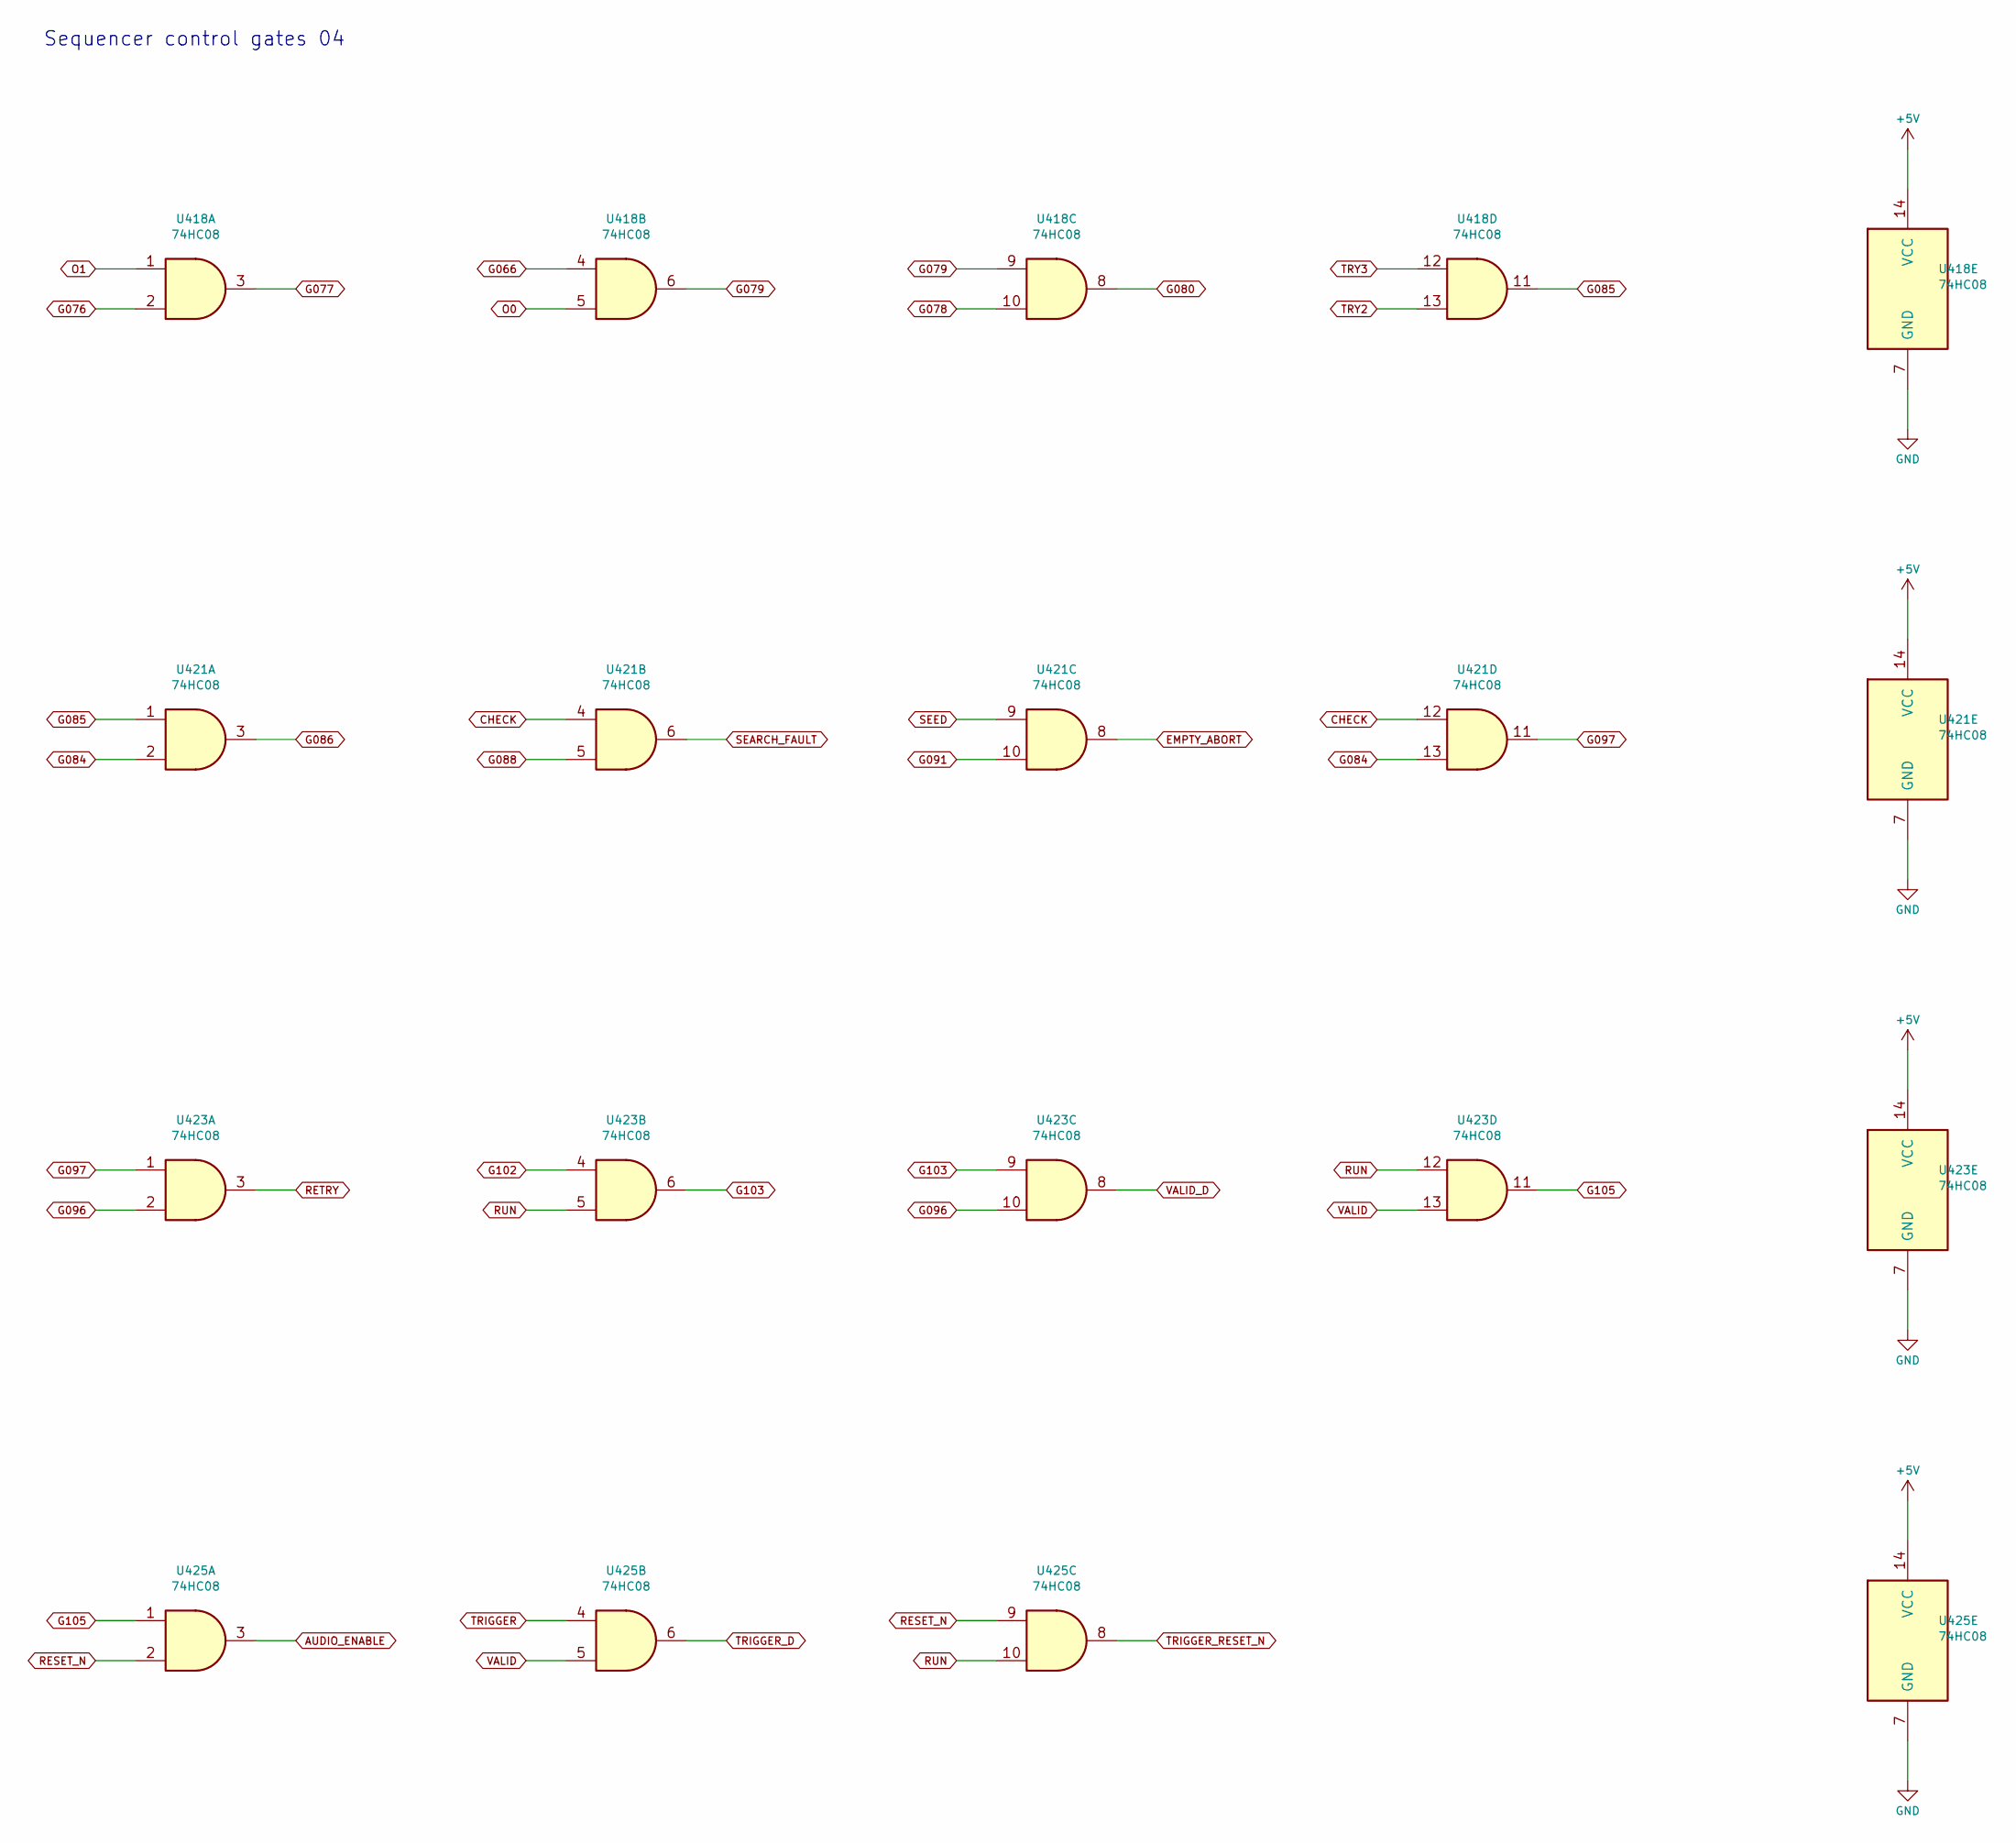
[picture p60: schematic logic_04.kicad_sch, Sequencer control gates 04]

Parts:
U418, U421, U423, U425: 74HC08; SOIC-14_3.9x8.7mm_P1.27mm; MPN 74HC08D,653

Connections:
+5V: U418.14 (VCC), U421.14 (VCC), U423.14 (VCC), U425.14 (VCC); also elsewhere on the board
AUDIO_ENABLE: U425.3; also elsewhere on the board
CHECK: U421.4, U421.12; also elsewhere on the board
EMPTY_ABORT: U421.8; also elsewhere on the board
G066: U418.4; also elsewhere on the board
G076: U418.2; also elsewhere on the board
G077: U418.3; also elsewhere on the board
G078: U418.10; also elsewhere on the board
G079: U418.6, U418.9
G080: U418.8; also elsewhere on the board
G084: U421.2, U421.13; also elsewhere on the board
G085: U418.11, U421.1
G086: U421.3; also elsewhere on the board
G088: U421.5; also elsewhere on the board
G091: U421.10; also elsewhere on the board
G096: U423.2, U423.10; also elsewhere on the board
G097: U421.11, U423.1
G102: U423.4; also elsewhere on the board
G103: U423.6, U423.9
G105: U423.11, U425.1
O0: U418.5; also elsewhere on the board
O1: U418.1; also elsewhere on the board
RESET_N: U425.2, U425.9; also elsewhere on the board
RETRY: U423.3; also elsewhere on the board
RUN: U423.5, U423.12, U425.10; also elsewhere on the board
SEARCH_FAULT: U421.6; also elsewhere on the board
SEED: U421.9; also elsewhere on the board
TRIGGER: U425.4; also elsewhere on the board
TRIGGER_D: U425.6; also elsewhere on the board
TRIGGER_RESET_N: U425.8; also elsewhere on the board
TRY2: U418.13; also elsewhere on the board
TRY3: U418.12; also elsewhere on the board
VALID: U423.13, U425.5; also elsewhere on the board
VALID_D: U423.8; also elsewhere on the board

Notes on the sheet:
Sequencer control gates 04

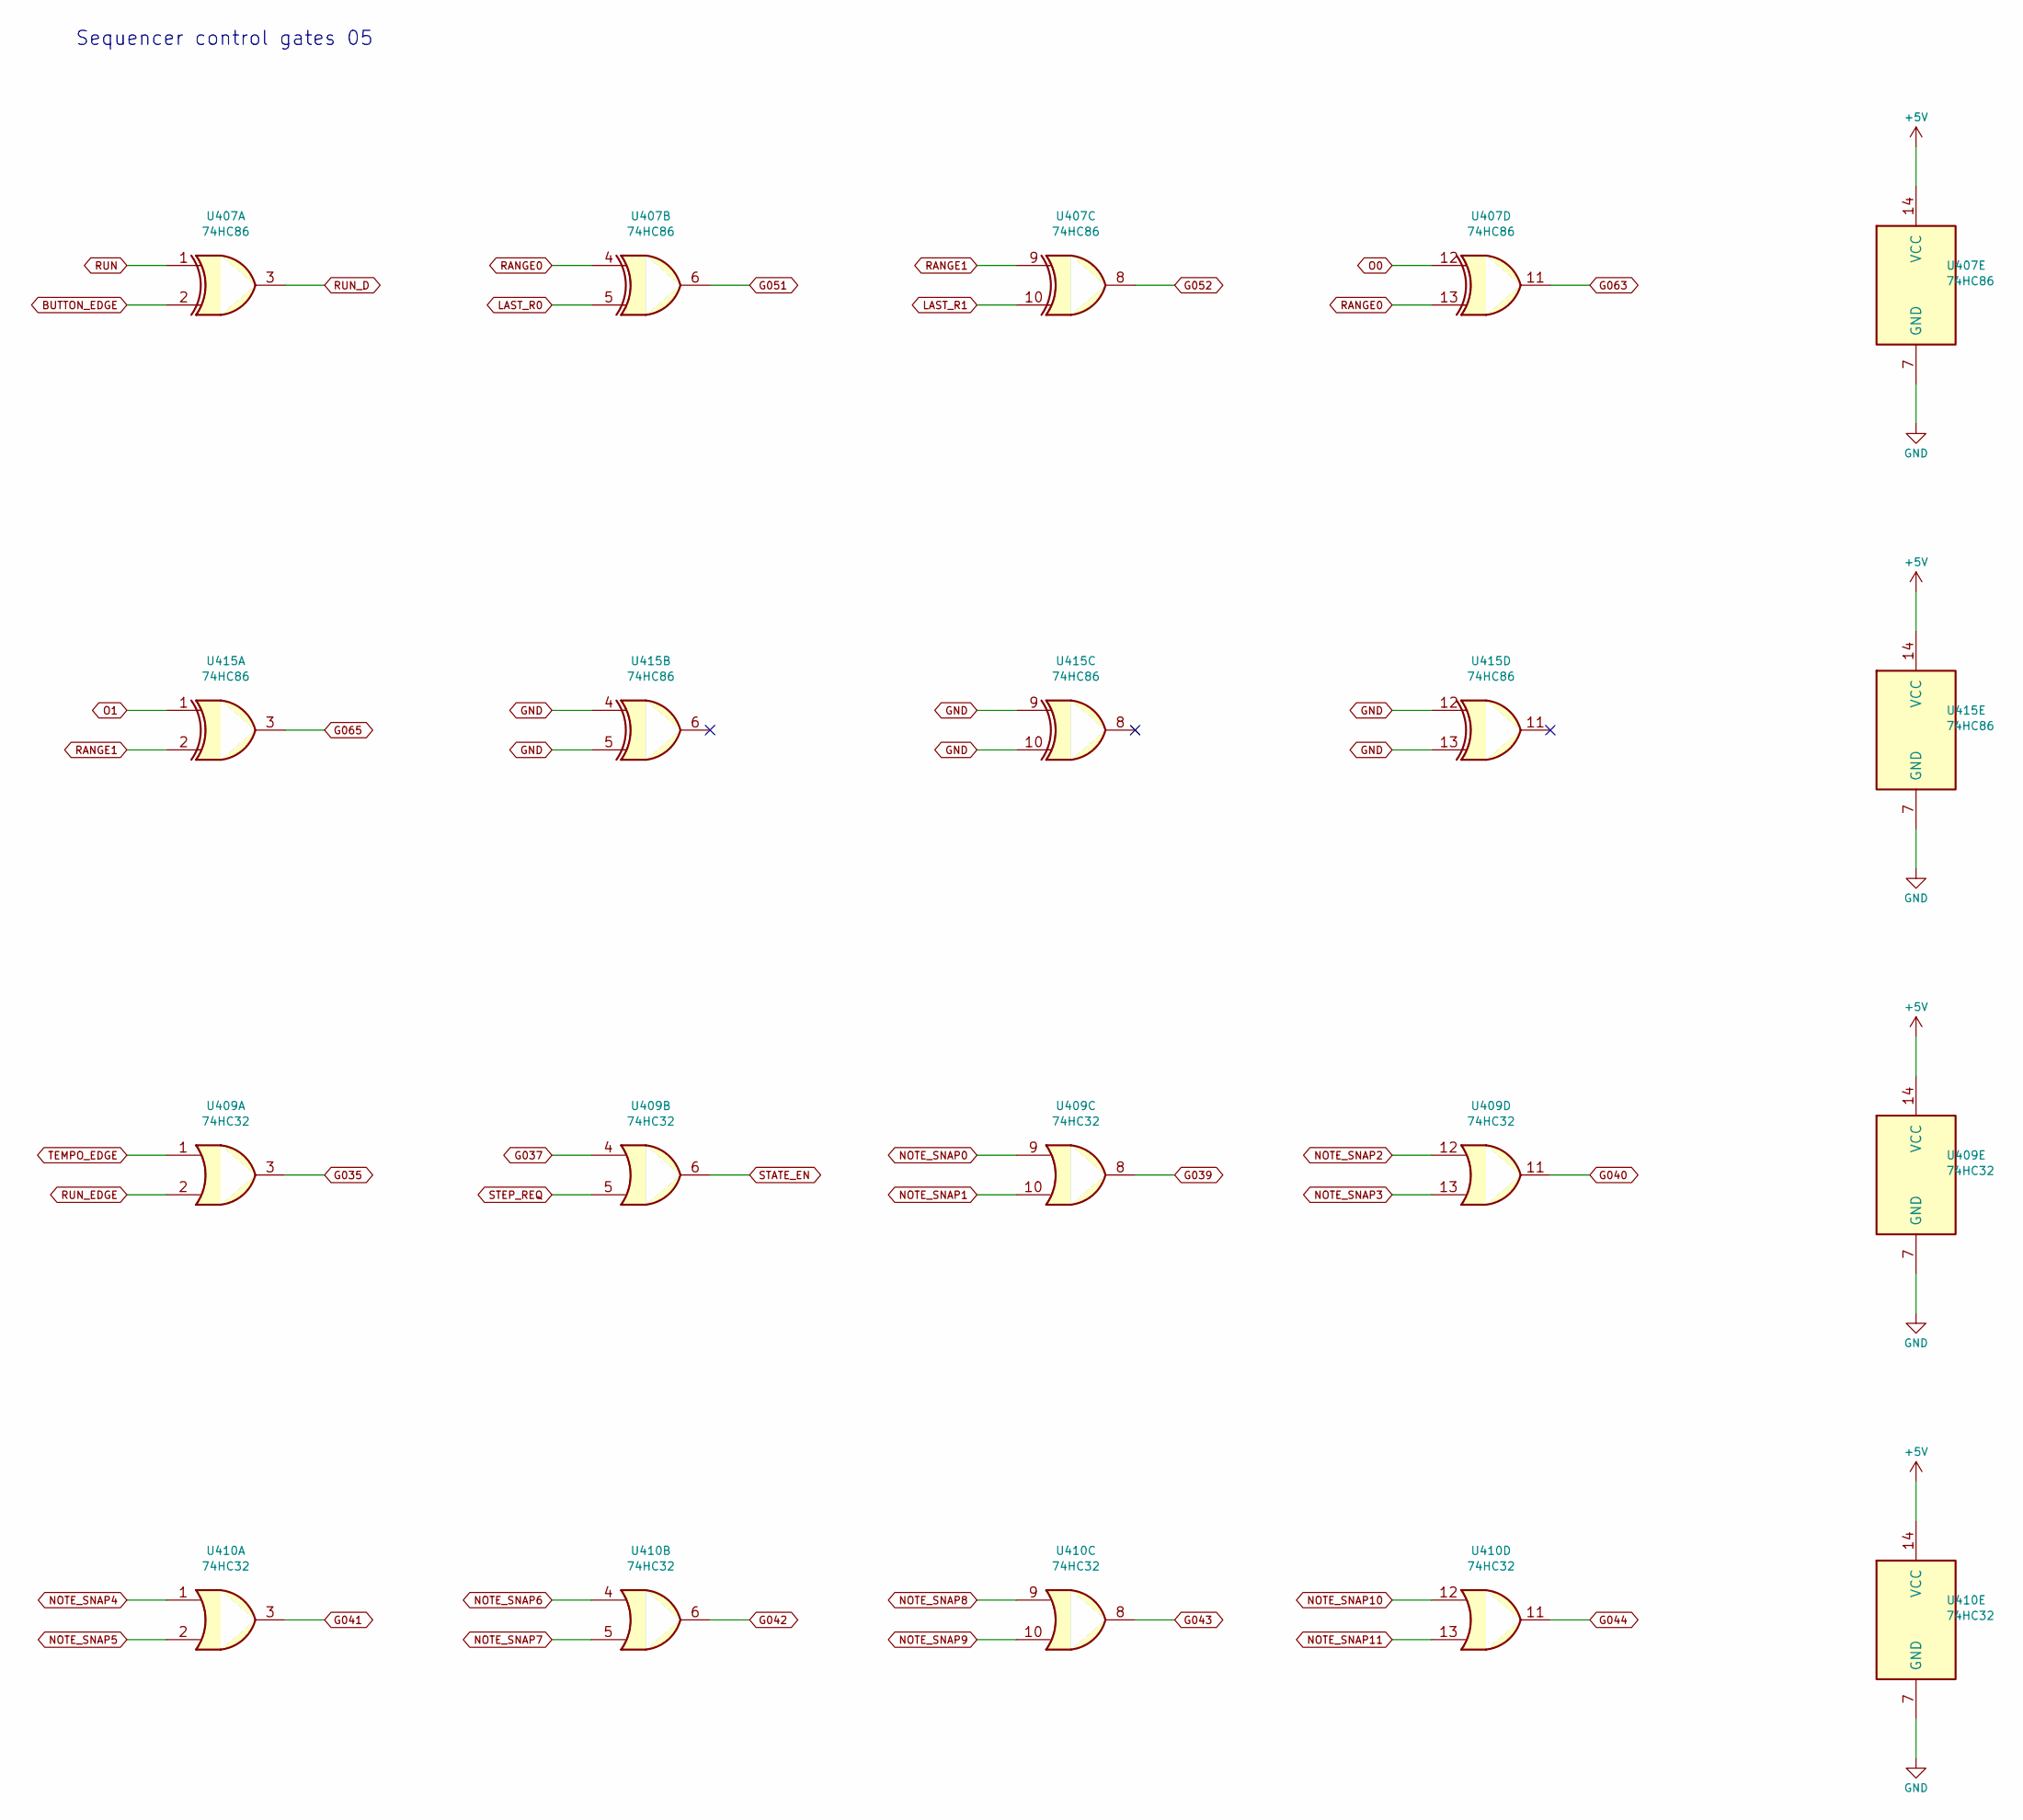
[picture p61: schematic logic_05.kicad_sch, Sequencer control gates 05]

Parts:
U407, U415: 74HC86; SOIC-14_3.9x8.7mm_P1.27mm; MPN 74HC86D,653
U409, U410: 74HC32; SOIC-14_3.9x8.7mm_P1.27mm; MPN 74HC32D,653

Connections:
+5V: U407.14 (VCC), U409.14 (VCC), U410.14 (VCC), U415.14 (VCC); also elsewhere on the board
BUTTON_EDGE: U407.2; also elsewhere on the board
G035: U409.3; also elsewhere on the board
G037: U409.4; also elsewhere on the board
G039: U409.8; also elsewhere on the board
G040: U409.11; also elsewhere on the board
G041: U410.3; also elsewhere on the board
G042: U410.6; also elsewhere on the board
G043: U410.8; also elsewhere on the board
G044: U410.11; also elsewhere on the board
G051: U407.6; also elsewhere on the board
G052: U407.8; also elsewhere on the board
G063: U407.11; also elsewhere on the board
G065: U415.3; also elsewhere on the board
LAST_R0: U407.5; also elsewhere on the board
LAST_R1: U407.10; also elsewhere on the board
NOTE_SNAP0: U409.9; also elsewhere on the board
NOTE_SNAP1: U409.10; also elsewhere on the board
NOTE_SNAP2: U409.12; also elsewhere on the board
NOTE_SNAP3: U409.13; also elsewhere on the board
NOTE_SNAP4: U410.1; also elsewhere on the board
NOTE_SNAP5: U410.2; also elsewhere on the board
NOTE_SNAP6: U410.4; also elsewhere on the board
NOTE_SNAP7: U410.5; also elsewhere on the board
NOTE_SNAP8: U410.9; also elsewhere on the board
NOTE_SNAP9: U410.10; also elsewhere on the board
NOTE_SNAP10: U410.12; also elsewhere on the board
NOTE_SNAP11: U410.13; also elsewhere on the board
O0: U407.12; also elsewhere on the board
O1: U415.1; also elsewhere on the board
RANGE0: U407.4, U407.13; also elsewhere on the board
RANGE1: U407.9, U415.2; also elsewhere on the board
RUN: U407.1; also elsewhere on the board
RUN_D: U407.3; also elsewhere on the board
RUN_EDGE: U409.2; also elsewhere on the board
STATE_EN: U409.6; also elsewhere on the board
STEP_REQ: U409.5; also elsewhere on the board
TEMPO_EDGE: U409.1; also elsewhere on the board

Notes on the sheet:
Sequencer control gates 05

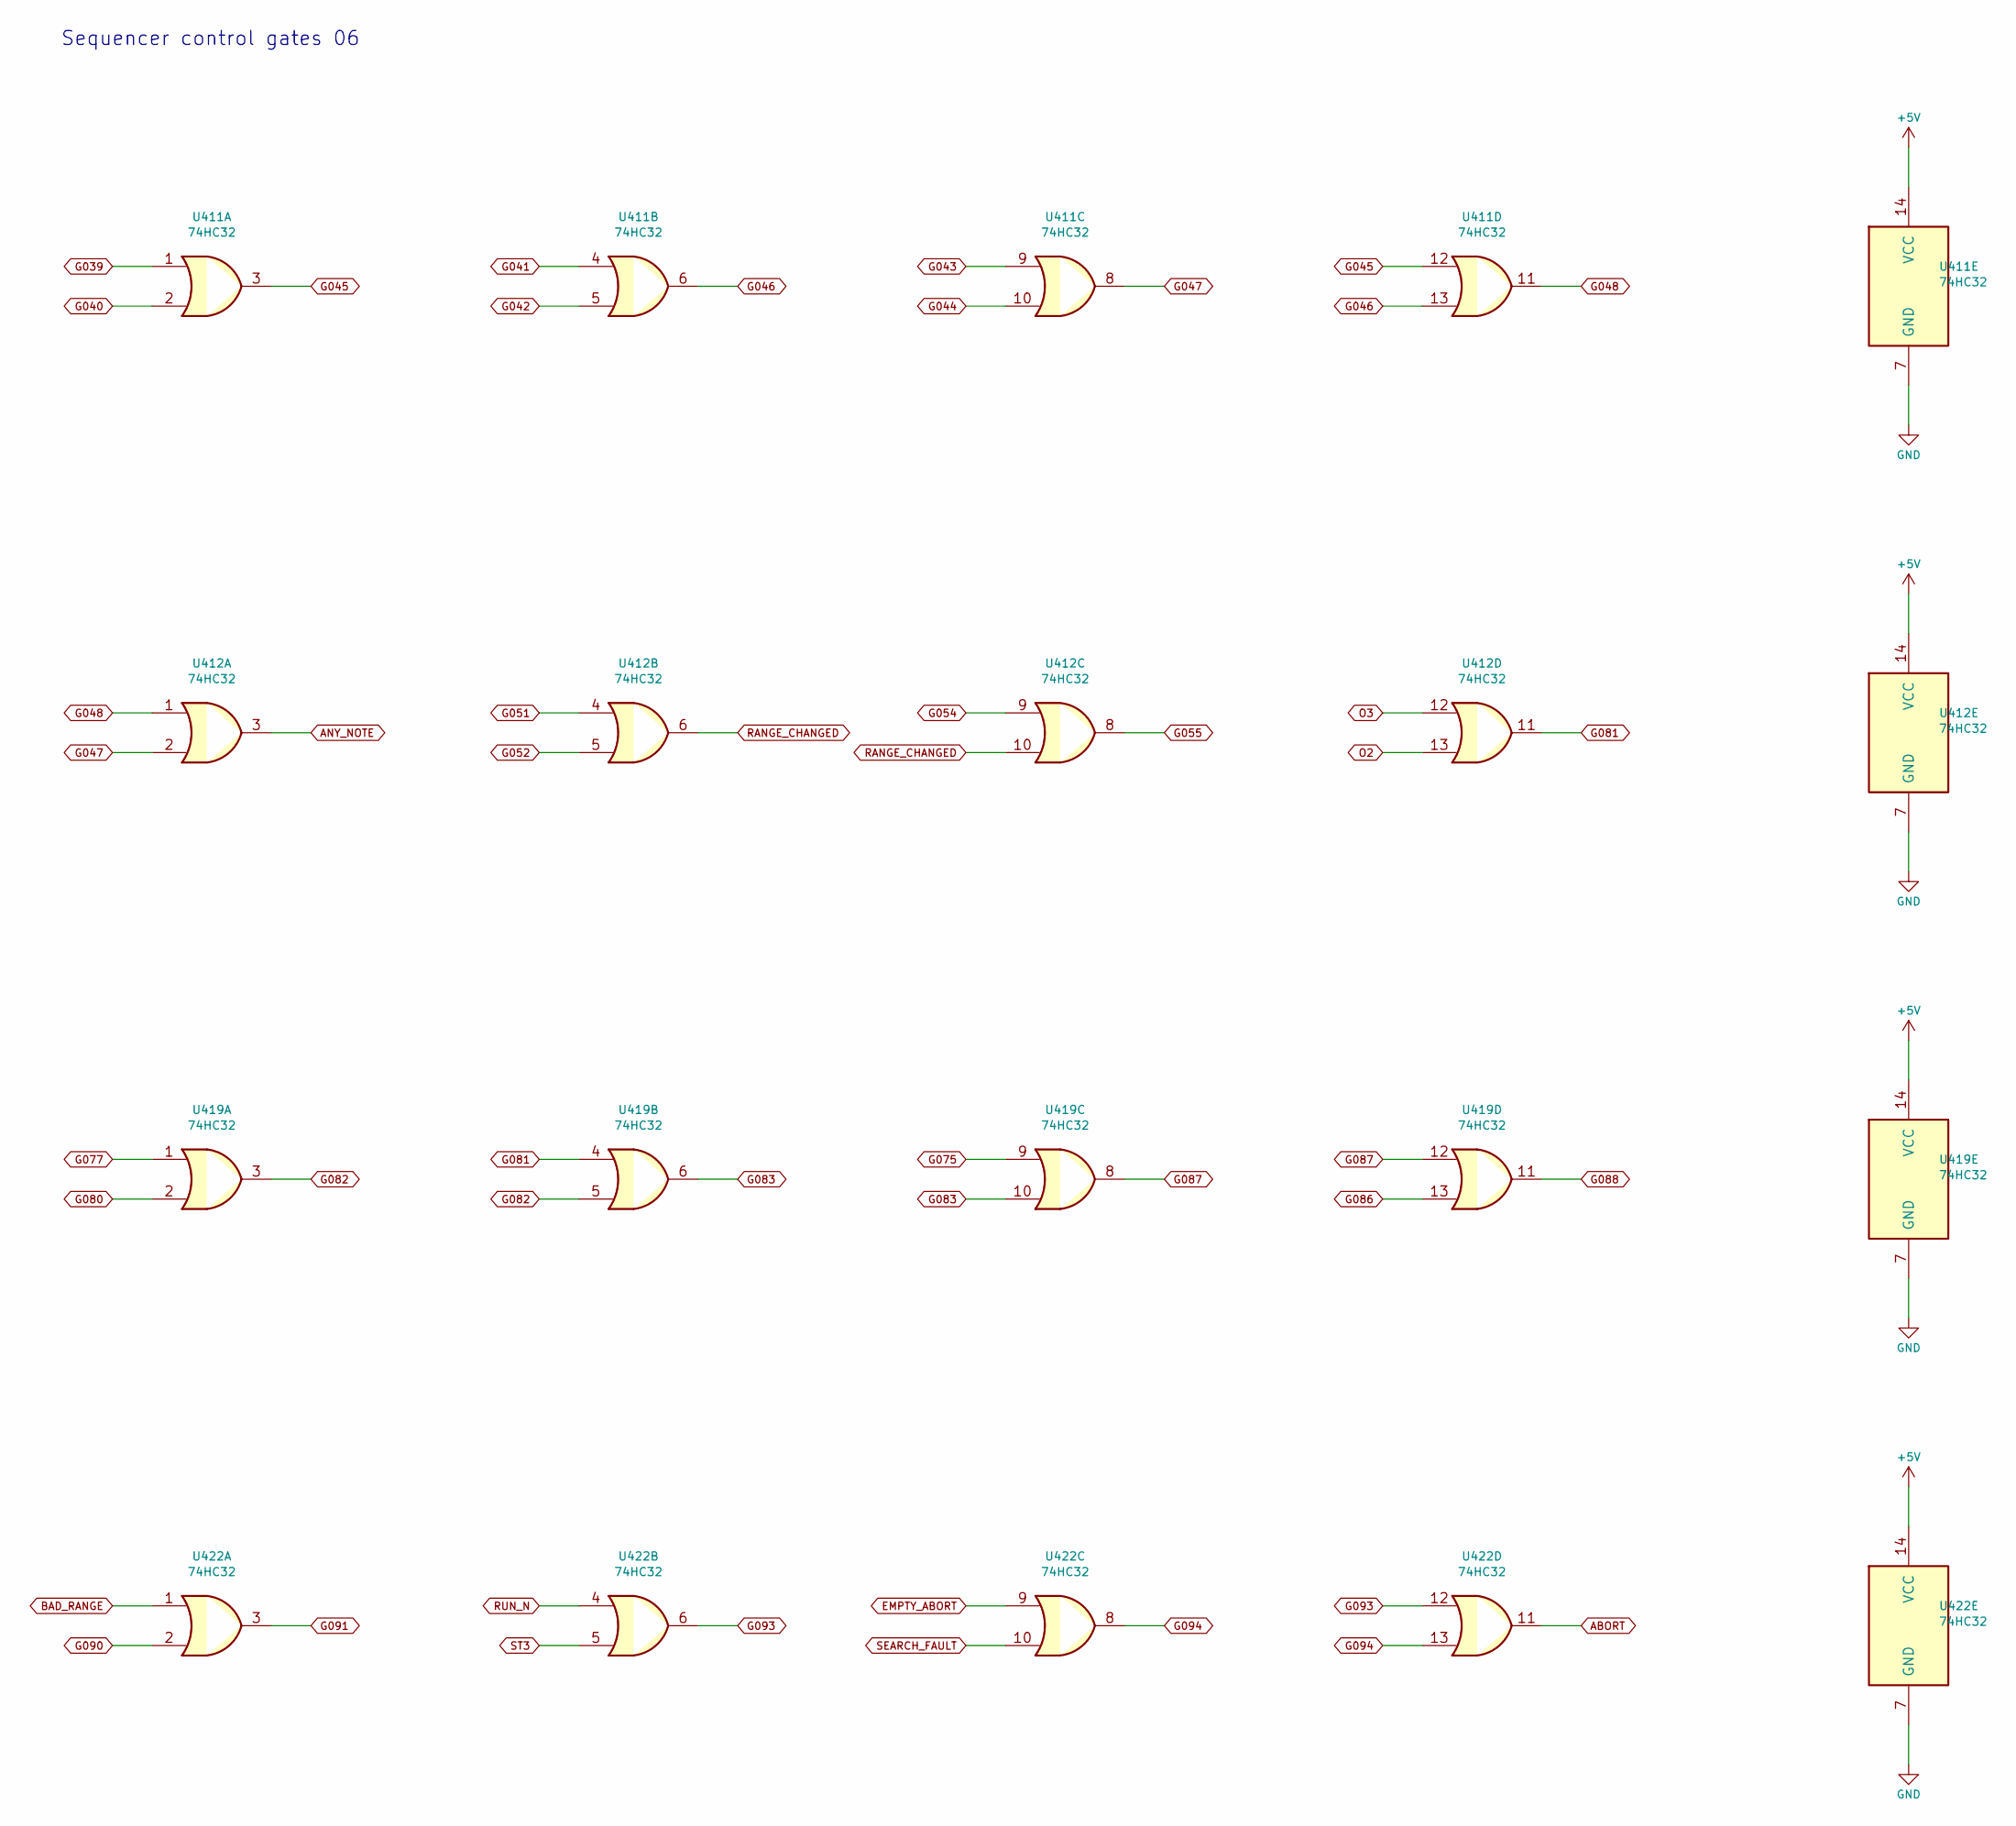
[picture p62: schematic logic_06.kicad_sch, Sequencer control gates 06]

Parts:
U411, U412, U419, U422: 74HC32; SOIC-14_3.9x8.7mm_P1.27mm; MPN 74HC32D,653

Connections:
+5V: U411.14 (VCC), U412.14 (VCC), U419.14 (VCC), U422.14 (VCC); also elsewhere on the board
ABORT: U422.11; also elsewhere on the board
ANY_NOTE: U412.3; also elsewhere on the board
BAD_RANGE: U422.1; also elsewhere on the board
EMPTY_ABORT: U422.9; also elsewhere on the board
G039: U411.1; also elsewhere on the board
G040: U411.2; also elsewhere on the board
G041: U411.4; also elsewhere on the board
G042: U411.5; also elsewhere on the board
G043: U411.9; also elsewhere on the board
G044: U411.10; also elsewhere on the board
G045: U411.3, U411.12
G046: U411.6, U411.13
G047: U411.8, U412.2
G048: U411.11, U412.1
G051: U412.4; also elsewhere on the board
G052: U412.5; also elsewhere on the board
G054: U412.9; also elsewhere on the board
G055: U412.8; also elsewhere on the board
G075: U419.9; also elsewhere on the board
G077: U419.1; also elsewhere on the board
G080: U419.2; also elsewhere on the board
G081: U412.11, U419.4
G082: U419.3, U419.5
G083: U419.6, U419.10
G086: U419.13; also elsewhere on the board
G087: U419.8, U419.12
G088: U419.11; also elsewhere on the board
G090: U422.2; also elsewhere on the board
G091: U422.3; also elsewhere on the board
G093: U422.6, U422.12
G094: U422.8, U422.13
O2: U412.13; also elsewhere on the board
O3: U412.12; also elsewhere on the board
RANGE_CHANGED: U412.6, U412.10
RUN_N: U422.4; also elsewhere on the board
SEARCH_FAULT: U422.10; also elsewhere on the board
ST3: U422.5; also elsewhere on the board

Notes on the sheet:
Sequencer control gates 06
