EwoudVV/arpeggiator/arpeggiator.kicad_pcb

## KiCad design arpeggiator.kicad_pcb (continued)

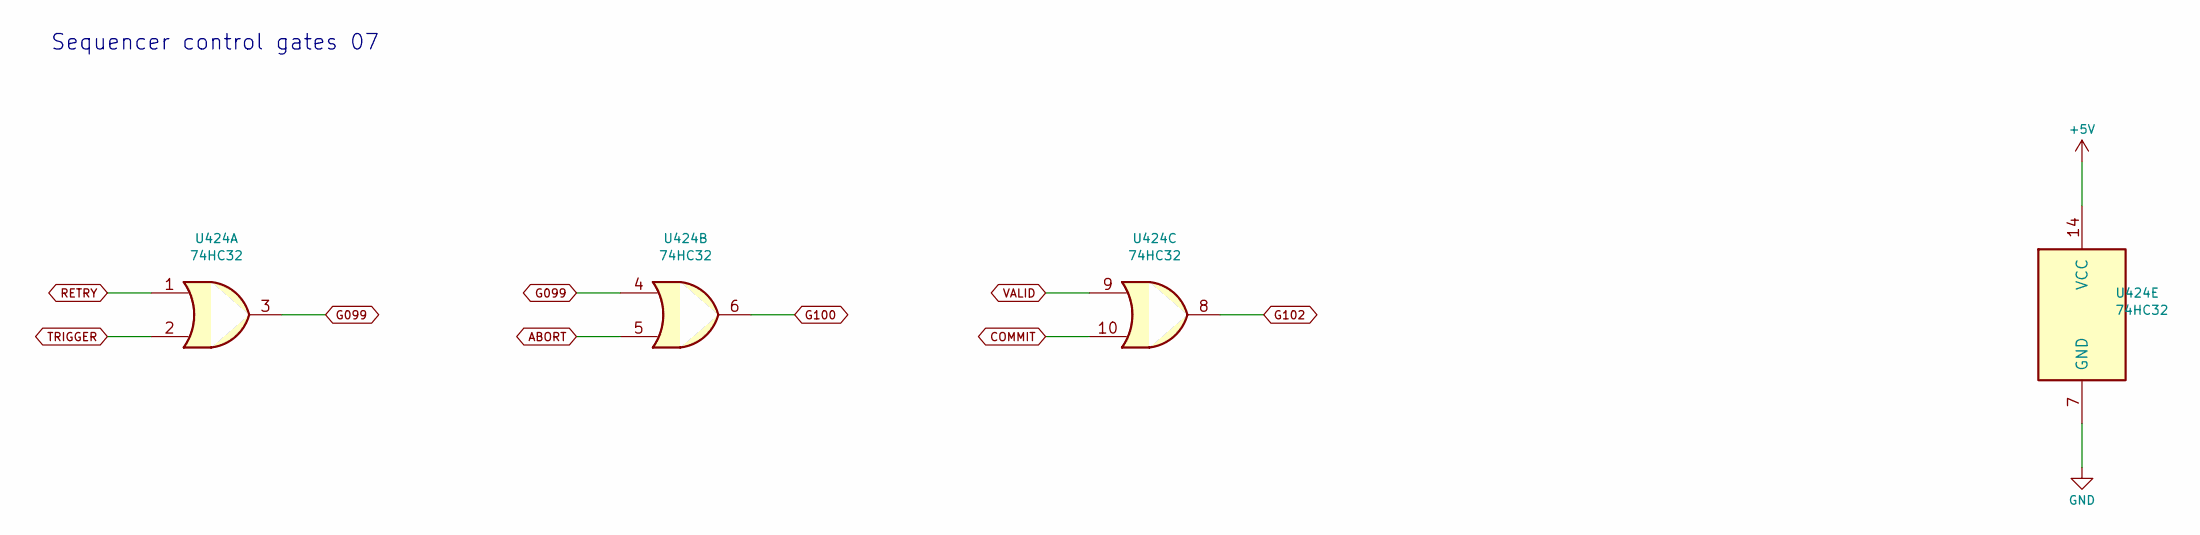
[picture p63: schematic logic_07.kicad_sch, Sequencer control gates 07]

Parts:
U424: 74HC32; SOIC-14_3.9x8.7mm_P1.27mm; MPN 74HC32D,653

Connections:
+5V: U424.14 (VCC); also elsewhere on the board
ABORT: U424.5; also elsewhere on the board
COMMIT: U424.10; also elsewhere on the board
G099: U424.3, U424.4
G100: U424.6; also elsewhere on the board
G102: U424.8; also elsewhere on the board
RETRY: U424.1; also elsewhere on the board
TRIGGER: U424.2; also elsewhere on the board
VALID: U424.9; also elsewhere on the board

Notes on the sheet:
Sequencer control gates 07

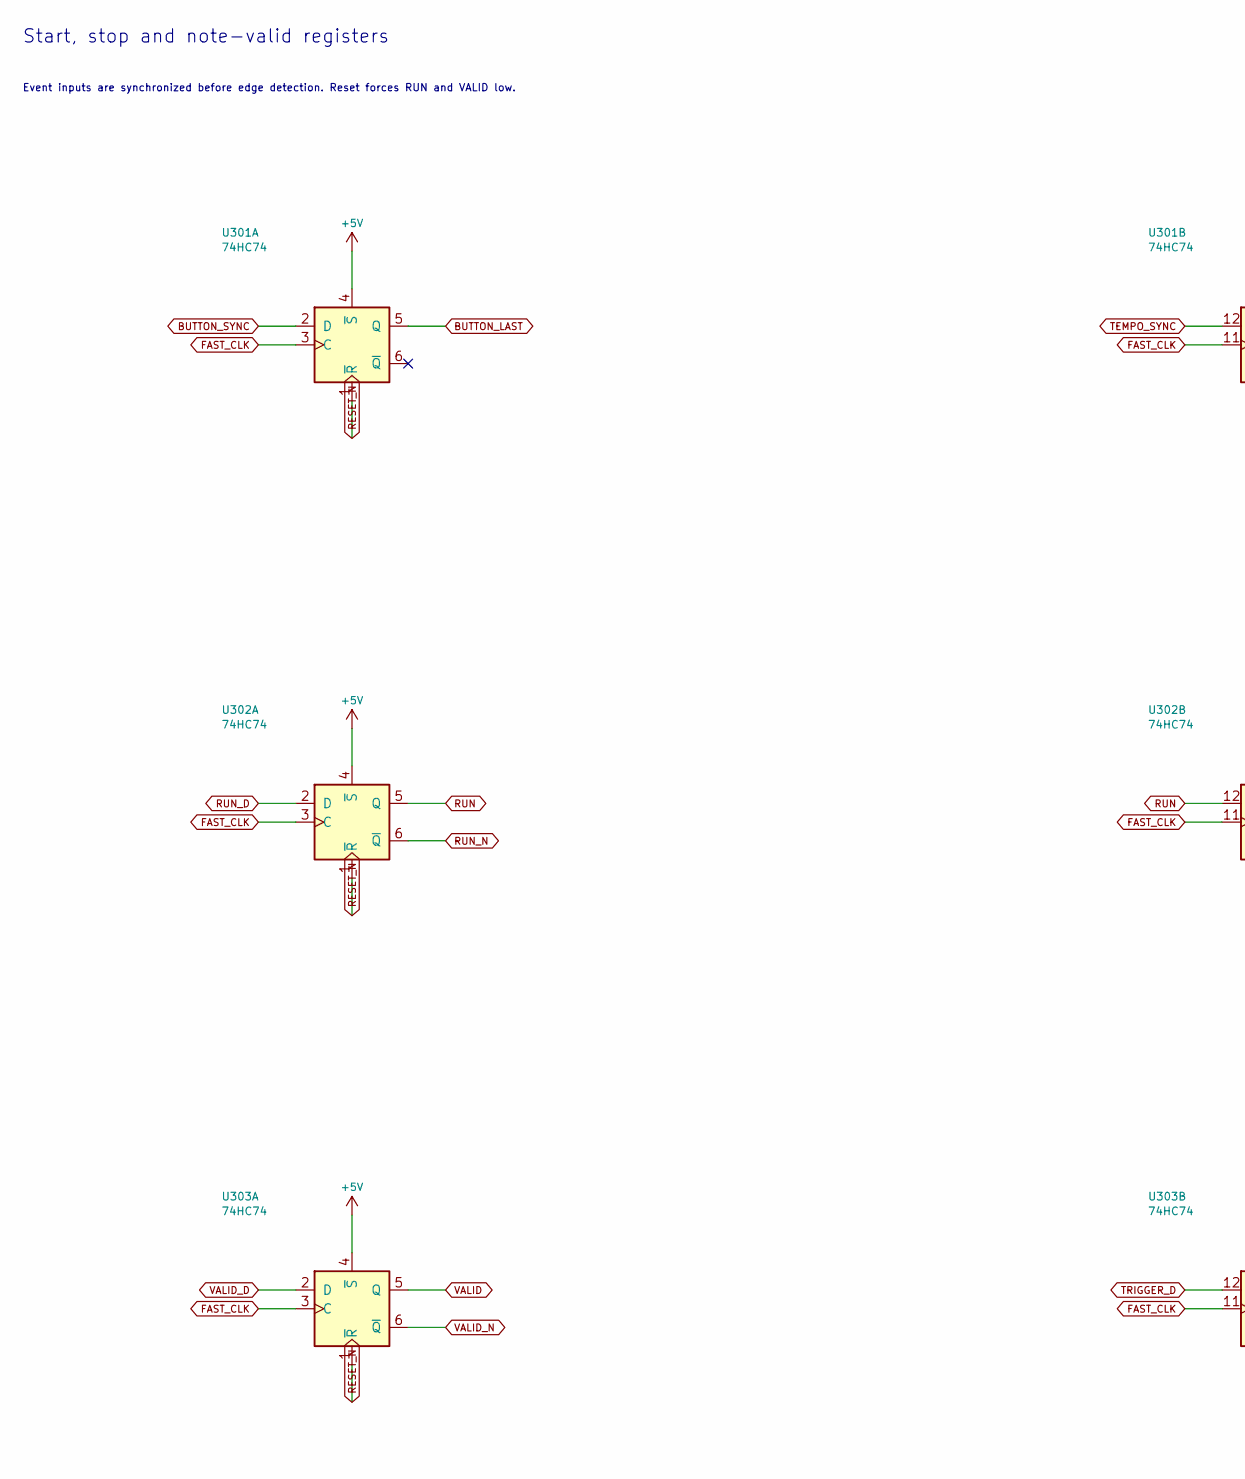
[picture p64: schematic events.kicad_sch, Start, stop and note-valid registers, part in row 1, column 1]

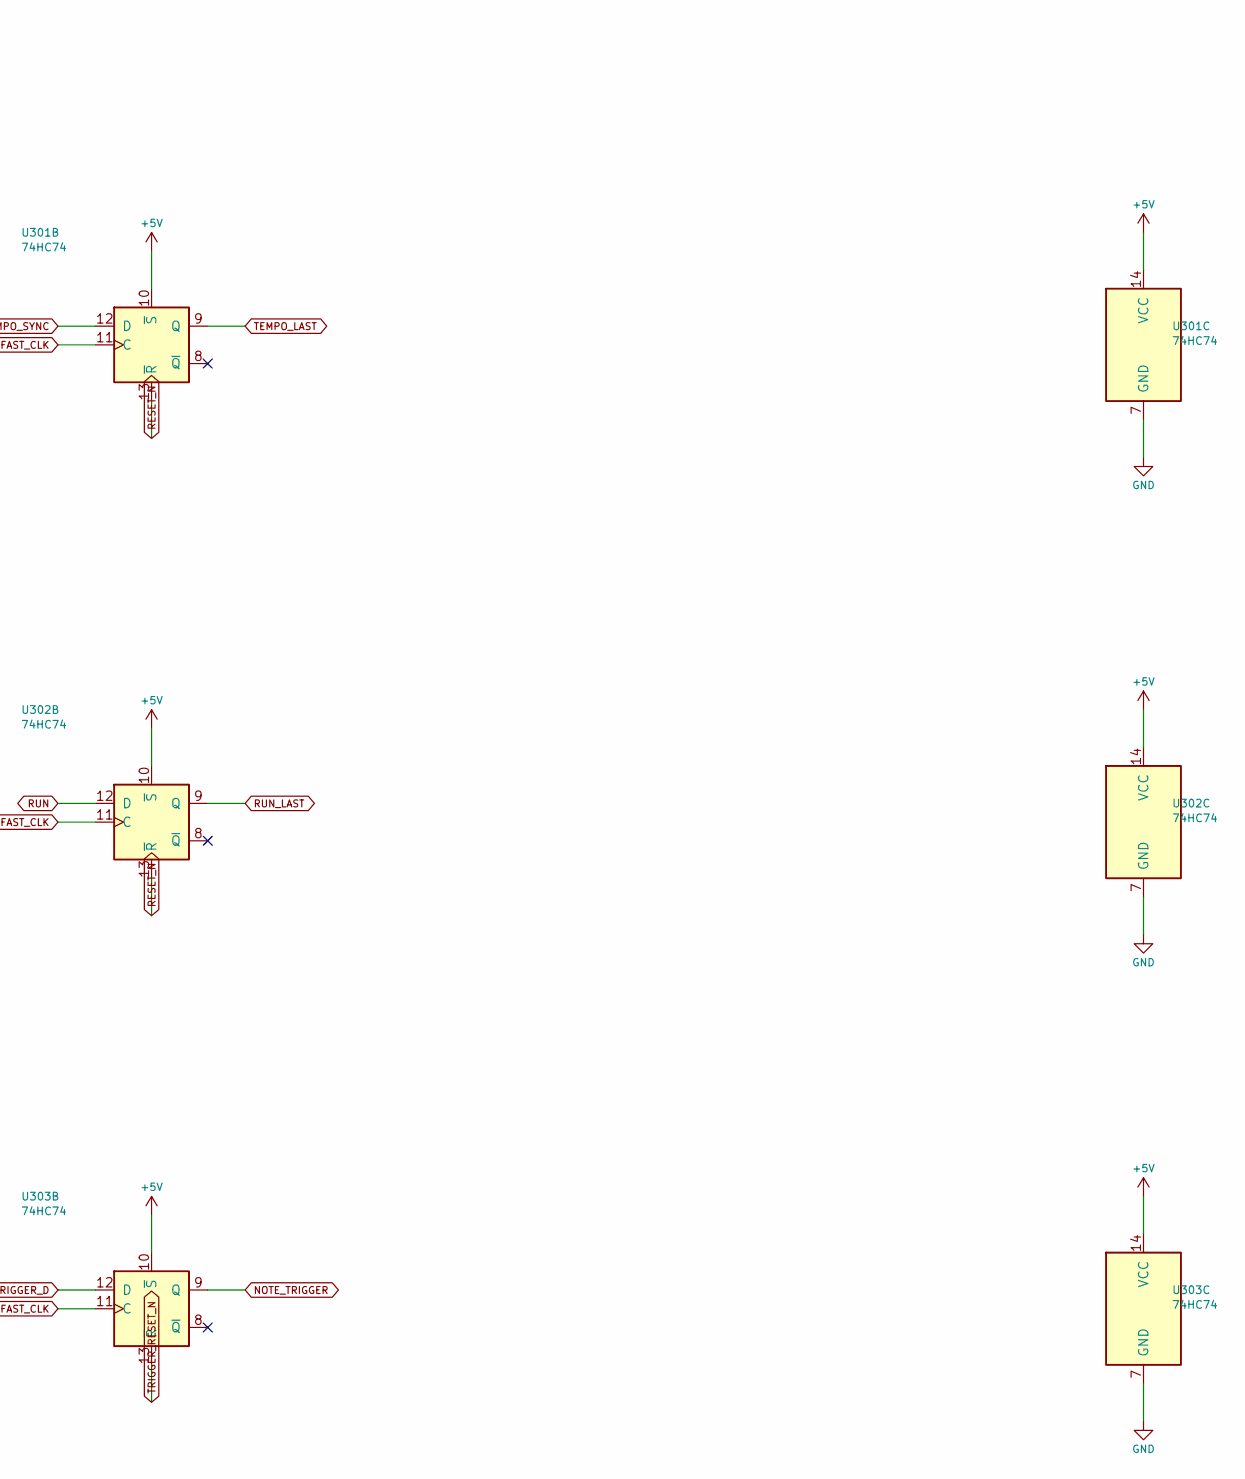
[picture p65: schematic events.kicad_sch, Start, stop and note-valid registers, part in row 1, column 2]

Parts:
U301, U302, U303: 74HC74; SOIC-14_3.9x8.7mm_P1.27mm; MPN 74HC74D,653

Connections:
+5V: U301.4 (~S), U301.10 (~S), U301.14 (VCC), U302.4 (~S), U302.10 (~S), U302.14 (VCC), U303.4 (~S), U303.10 (~S), U303.14 (VCC); also elsewhere on the board
BUTTON_LAST: U301.5 (Q); also elsewhere on the board
BUTTON_SYNC: U301.2 (D); also elsewhere on the board
FAST_CLK: U301.3 (C), U301.11 (C), U302.3 (C), U302.11 (C), U303.3 (C), U303.11 (C); also elsewhere on the board
NOTE_TRIGGER: U303.9 (Q); also elsewhere on the board
RESET_N: U301.1 (~R), U301.13 (~R), U302.1 (~R), U302.13 (~R), U303.1 (~R); also elsewhere on the board
RUN: U302.5 (Q), U302.12 (D); also elsewhere on the board
RUN_D: U302.2 (D); also elsewhere on the board
RUN_LAST: U302.9 (Q); also elsewhere on the board
RUN_N: U302.6 (~Q); also elsewhere on the board
TEMPO_LAST: U301.9 (Q); also elsewhere on the board
TEMPO_SYNC: U301.12 (D); also elsewhere on the board
TRIGGER_D: U303.12 (D); also elsewhere on the board
TRIGGER_RESET_N: U303.13 (~R); also elsewhere on the board
VALID: U303.5 (Q); also elsewhere on the board
VALID_D: U303.2 (D); also elsewhere on the board
VALID_N: U303.6 (~Q); also elsewhere on the board

Notes on the sheet:
Start, stop and note-valid registers
Event inputs are synchronized before edge detection. Reset forces RUN and VALID low.

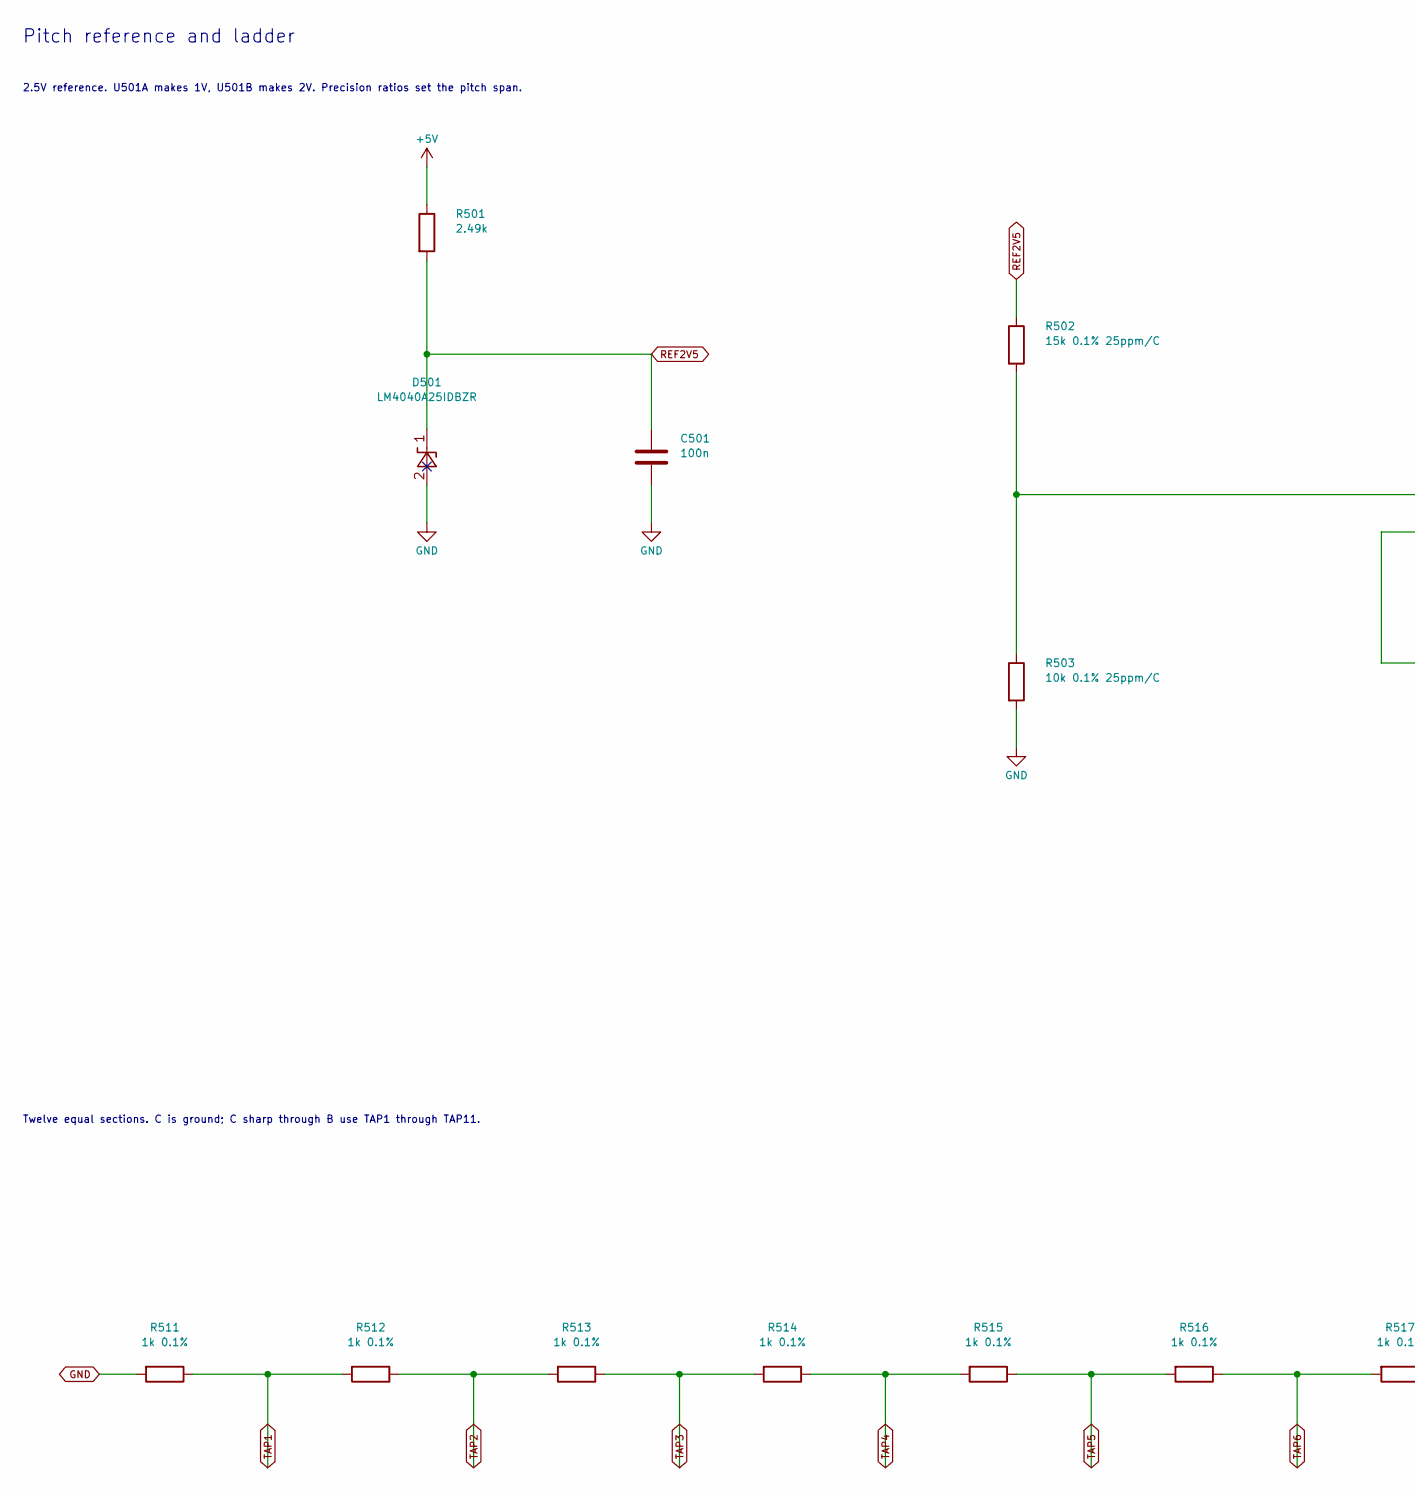
[picture p66: schematic 08_reference.kicad_sch, Pitch reference and ladder, part in row 1, column 1]

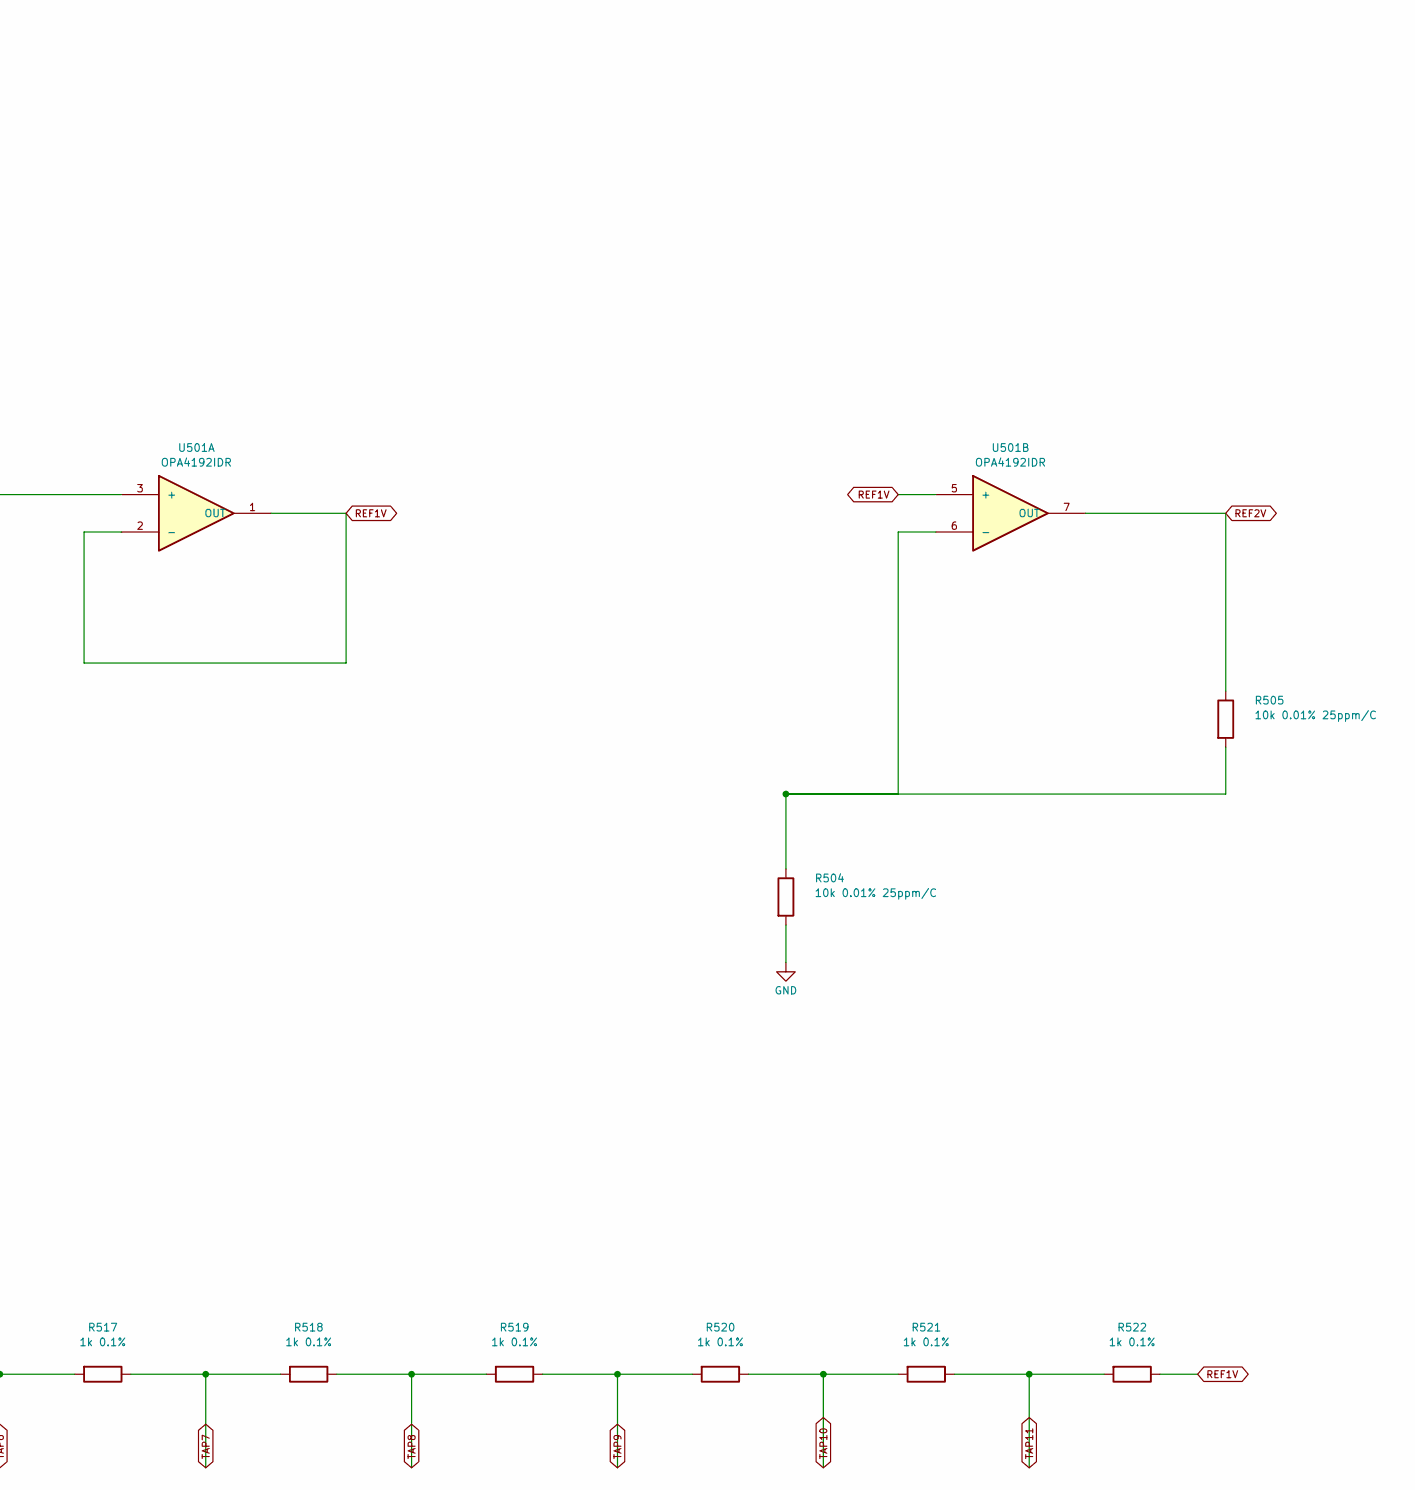
[picture p67: schematic 08_reference.kicad_sch, Pitch reference and ladder, part in row 1, column 2]

Parts:
C501: 100n; C_0805_2012Metric
D501: LM4040A25IDBZR; SOT-23; MPN LM4040A25IDBZR
R501: 2.49k; R_0805_2012Metric
R502: 15k 0.1% 25ppm/C; R_0805_2012Metric
R503: 10k 0.1% 25ppm/C; R_0805_2012Metric
R504, R505: 10k 0.01% 25ppm/C; R_0805_2012Metric; MPN RNCF0805TKY10K0
R511, R512, R513, R514, R515, R516, R517, R518, R519, R520, R521, R522: 1k 0.1%; R_0805_2012Metric
U501: OPA4192IDR; SOIC-14_3.9x8.7mm_P1.27mm; MPN OPA4192IDR

Connections:
+5V: R501.1; also elsewhere on the board
unnamed: R502.2, R503.1, U501.3 (+)
unnamed: R504.1, R505.2, U501.6 (-)
REF1V: R522.1, U501.1 (OUT), U501.2 (-), U501.5 (+); also elsewhere on the board
REF2V: R505.1, U501.7 (OUT); also elsewhere on the board
REF2V5: C501.1, D501.1 (K), R501.2, R502.1; also elsewhere on the board
TAP1: R511.1, R512.2; also elsewhere on the board
TAP2: R512.1, R513.2; also elsewhere on the board
TAP3: R513.1, R514.2; also elsewhere on the board
TAP4: R514.1, R515.2; also elsewhere on the board
TAP5: R515.1, R516.2; also elsewhere on the board
TAP6: R516.1, R517.2; also elsewhere on the board
TAP7: R517.1, R518.2; also elsewhere on the board
TAP8: R518.1, R519.2; also elsewhere on the board
TAP9: R519.1, R520.2; also elsewhere on the board
TAP10: R520.1, R521.2; also elsewhere on the board
TAP11: R521.1, R522.2; also elsewhere on the board

Notes on the sheet:
Pitch reference and ladder
2.5V reference. U501A makes 1V, U501B makes 2V. Precision ratios set the pitch span.
Twelve equal sections. C is ground; C sharp through B use TAP1 through TAP11.

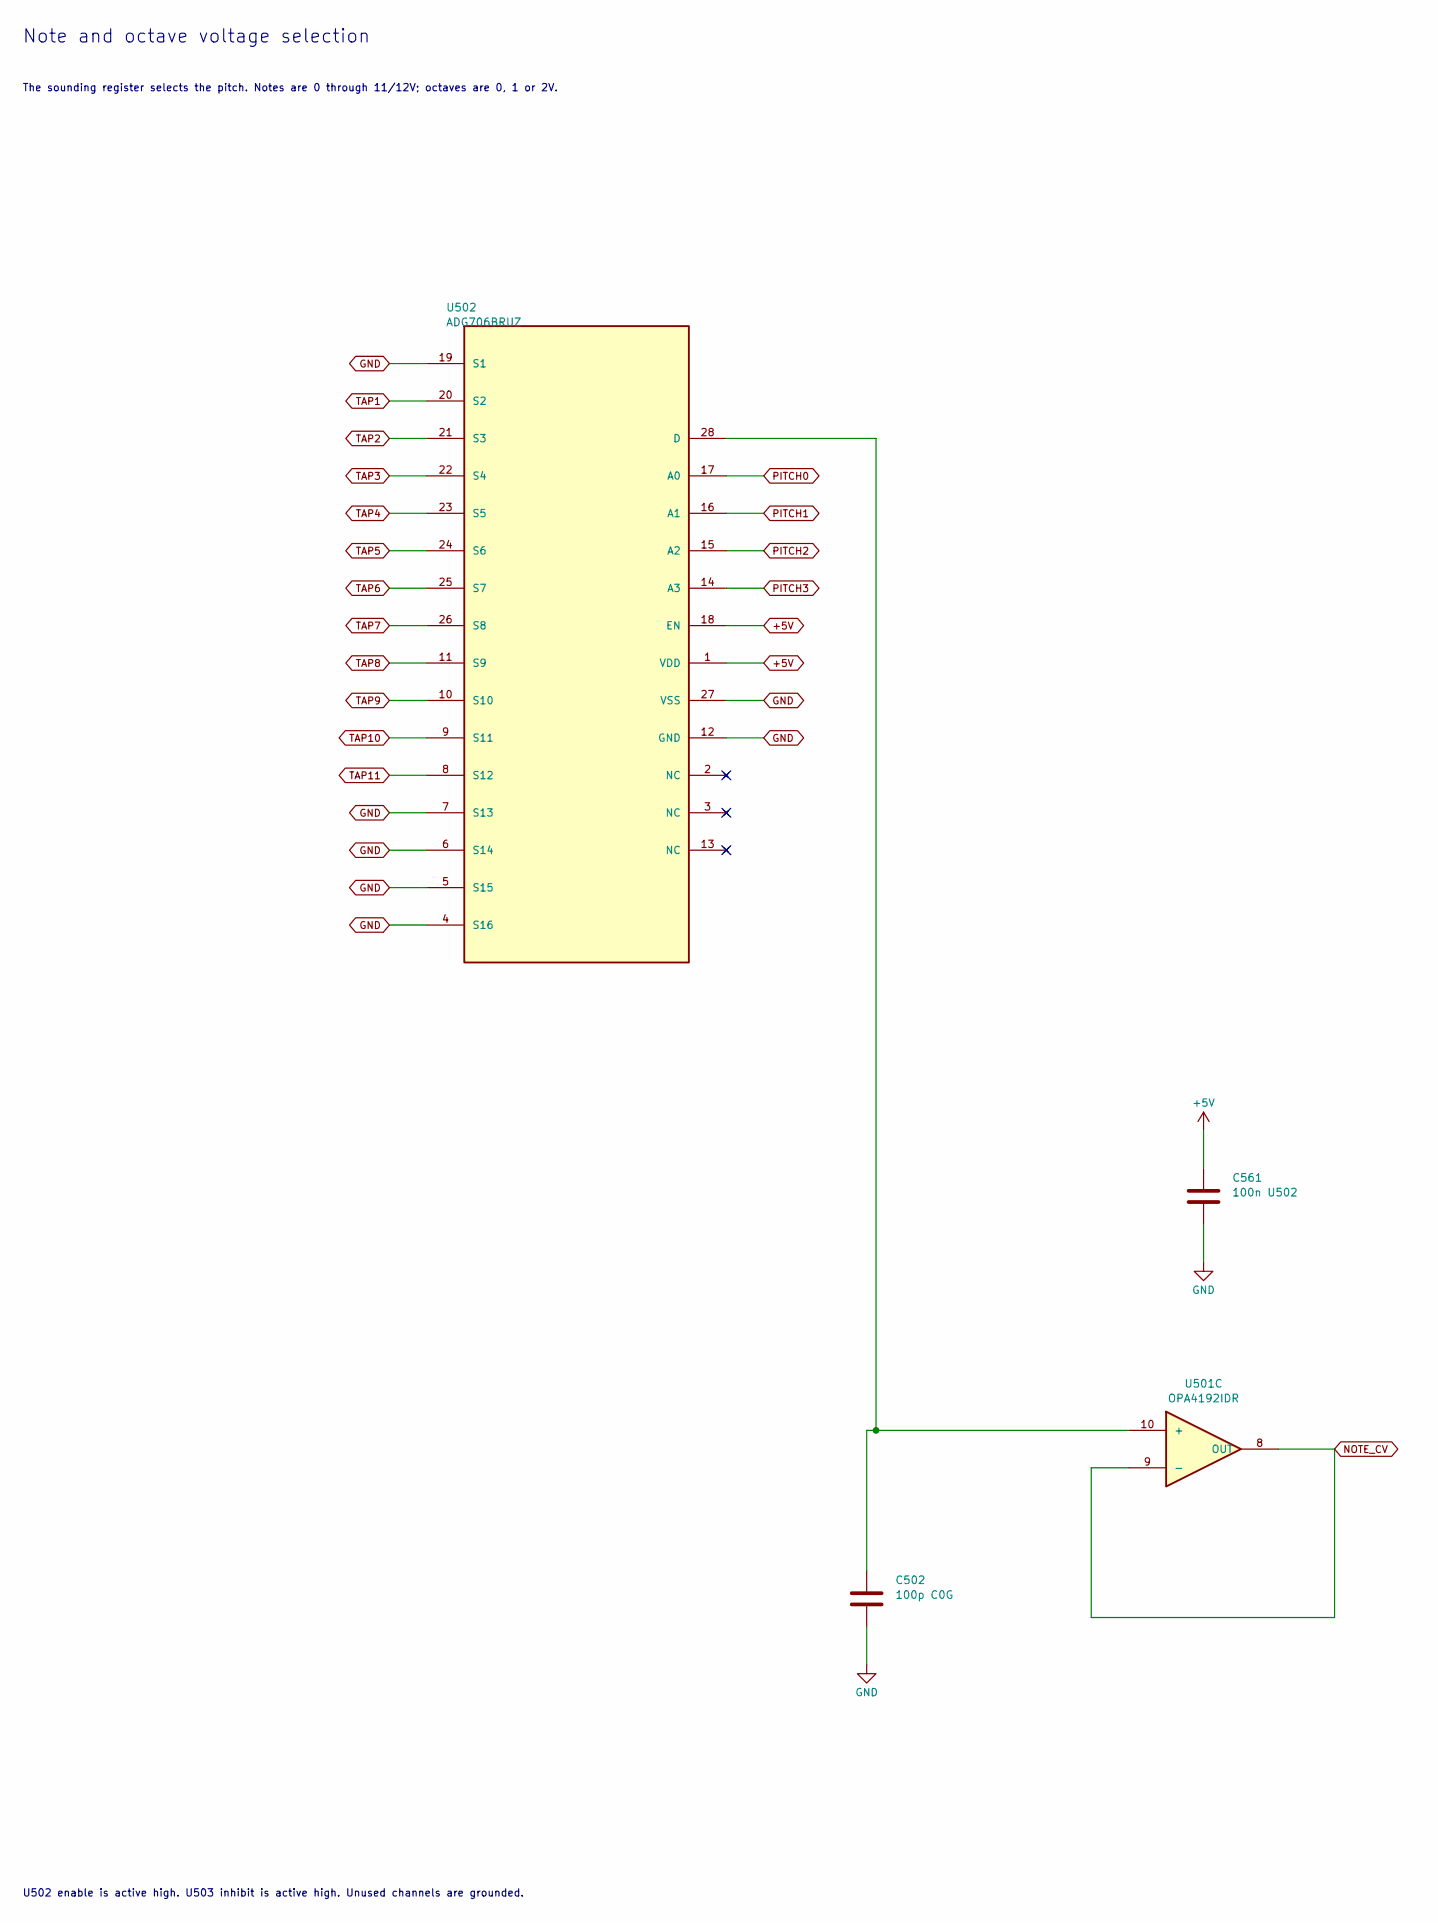
[picture p68: schematic 09_pitch_select.kicad_sch, Note and octave voltage selection, part in row 1, column 1]

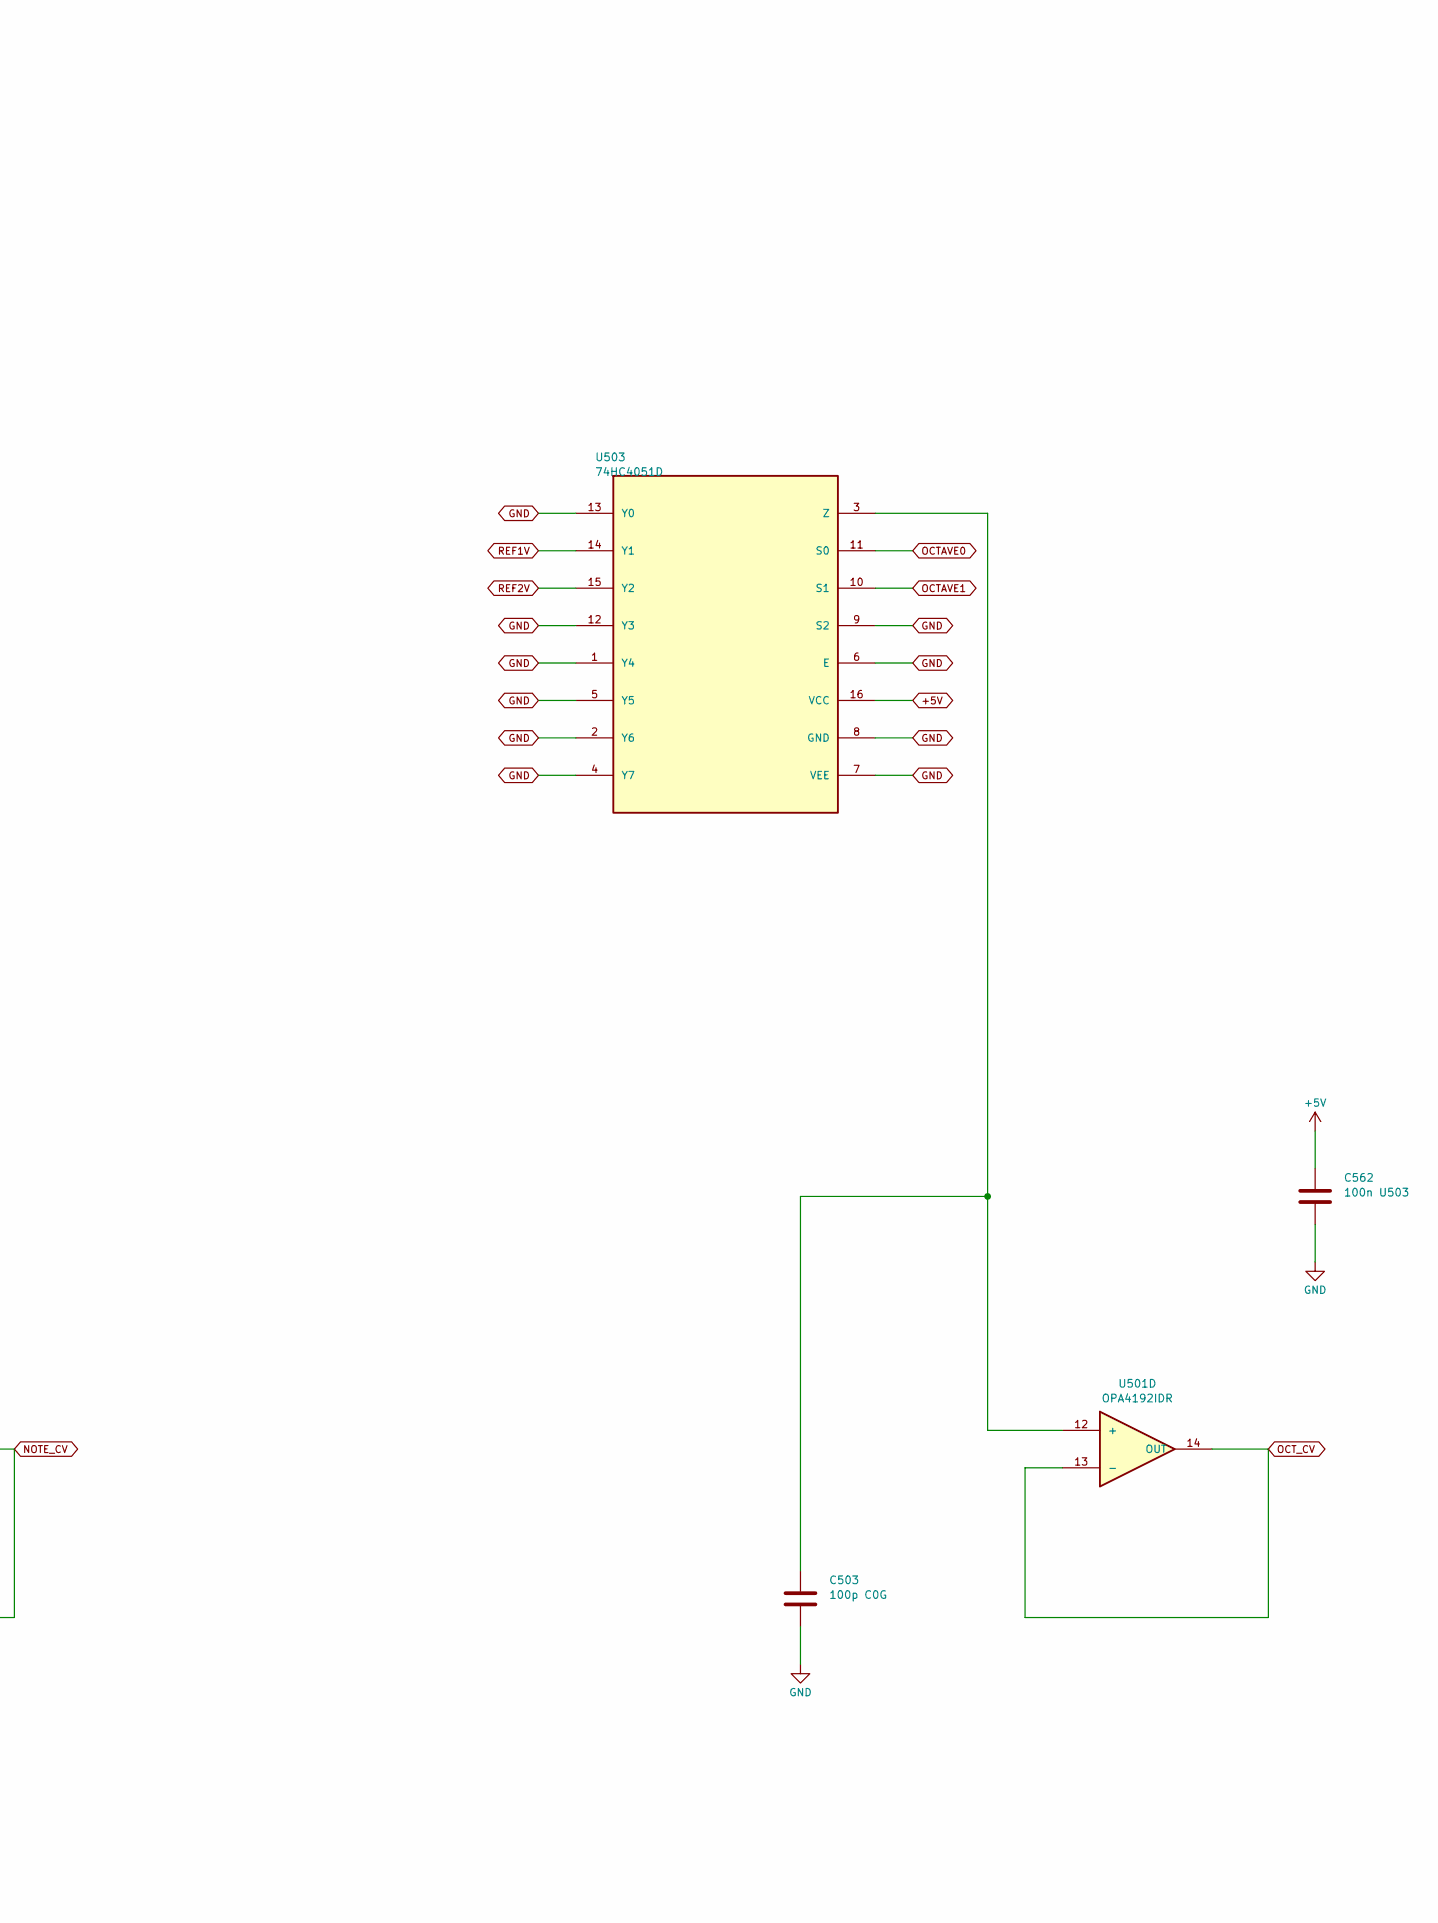
[picture p69: schematic 09_pitch_select.kicad_sch, Note and octave voltage selection, part in row 1, column 2]

Parts:
C502, C503: 100p C0G; C_0805_2012Metric
C561: 100n U502; C_0805_2012Metric
C562: 100n U503; C_0805_2012Metric
U501: OPA4192IDR; SOIC-14_3.9x8.7mm_P1.27mm; MPN OPA4192IDR
U502: ADG706BRUZ; TSSOP-28_4.4x9.7mm_P0.65mm; MPN ADG706BRUZ-REEL7
U503: 74HC4051D; SOIC-16_3.9x9.9mm_P1.27mm; MPN 74HC4051D,653

Connections:
+5V: C561.1, C562.1, U502.1 (VDD), U502.18 (EN), U503.16 (VCC); also elsewhere on the board
NOTE_CV: U501.8 (OUT), U501.9 (-); also elsewhere on the board
unnamed: C502.1, U501.10 (+), U502.28 (D)
unnamed: C503.1, U501.12 (+), U503.3 (Z)
OCTAVE0: U503.11 (S0); also elsewhere on the board
OCTAVE1: U503.10 (S1); also elsewhere on the board
OCT_CV: U501.13 (-), U501.14 (OUT); also elsewhere on the board
PITCH0: U502.17 (A0); also elsewhere on the board
PITCH1: U502.16 (A1); also elsewhere on the board
PITCH2: U502.15 (A2); also elsewhere on the board
PITCH3: U502.14 (A3); also elsewhere on the board
REF1V: U503.14 (Y1); also elsewhere on the board
REF2V: U503.15 (Y2); also elsewhere on the board
TAP1: U502.20 (S2); also elsewhere on the board
TAP2: U502.21 (S3); also elsewhere on the board
TAP3: U502.22 (S4); also elsewhere on the board
TAP4: U502.23 (S5); also elsewhere on the board
TAP5: U502.24 (S6); also elsewhere on the board
TAP6: U502.25 (S7); also elsewhere on the board
TAP7: U502.26 (S8); also elsewhere on the board
TAP8: U502.11 (S9); also elsewhere on the board
TAP9: U502.10 (S10); also elsewhere on the board
TAP10: U502.9 (S11); also elsewhere on the board
TAP11: U502.8 (S12); also elsewhere on the board

Notes on the sheet:
Note and octave voltage selection
The sounding register selects the pitch. Notes are 0 through 11/12V; octaves are 0, 1 or 2V.
U502 enable is active high. U503 inhibit is active high. Unused channels are grounded.
