EwoudVV/arpeggiator/arpeggiator.kicad_pcb

## KiCad design arpeggiator.kicad_pcb (continued)

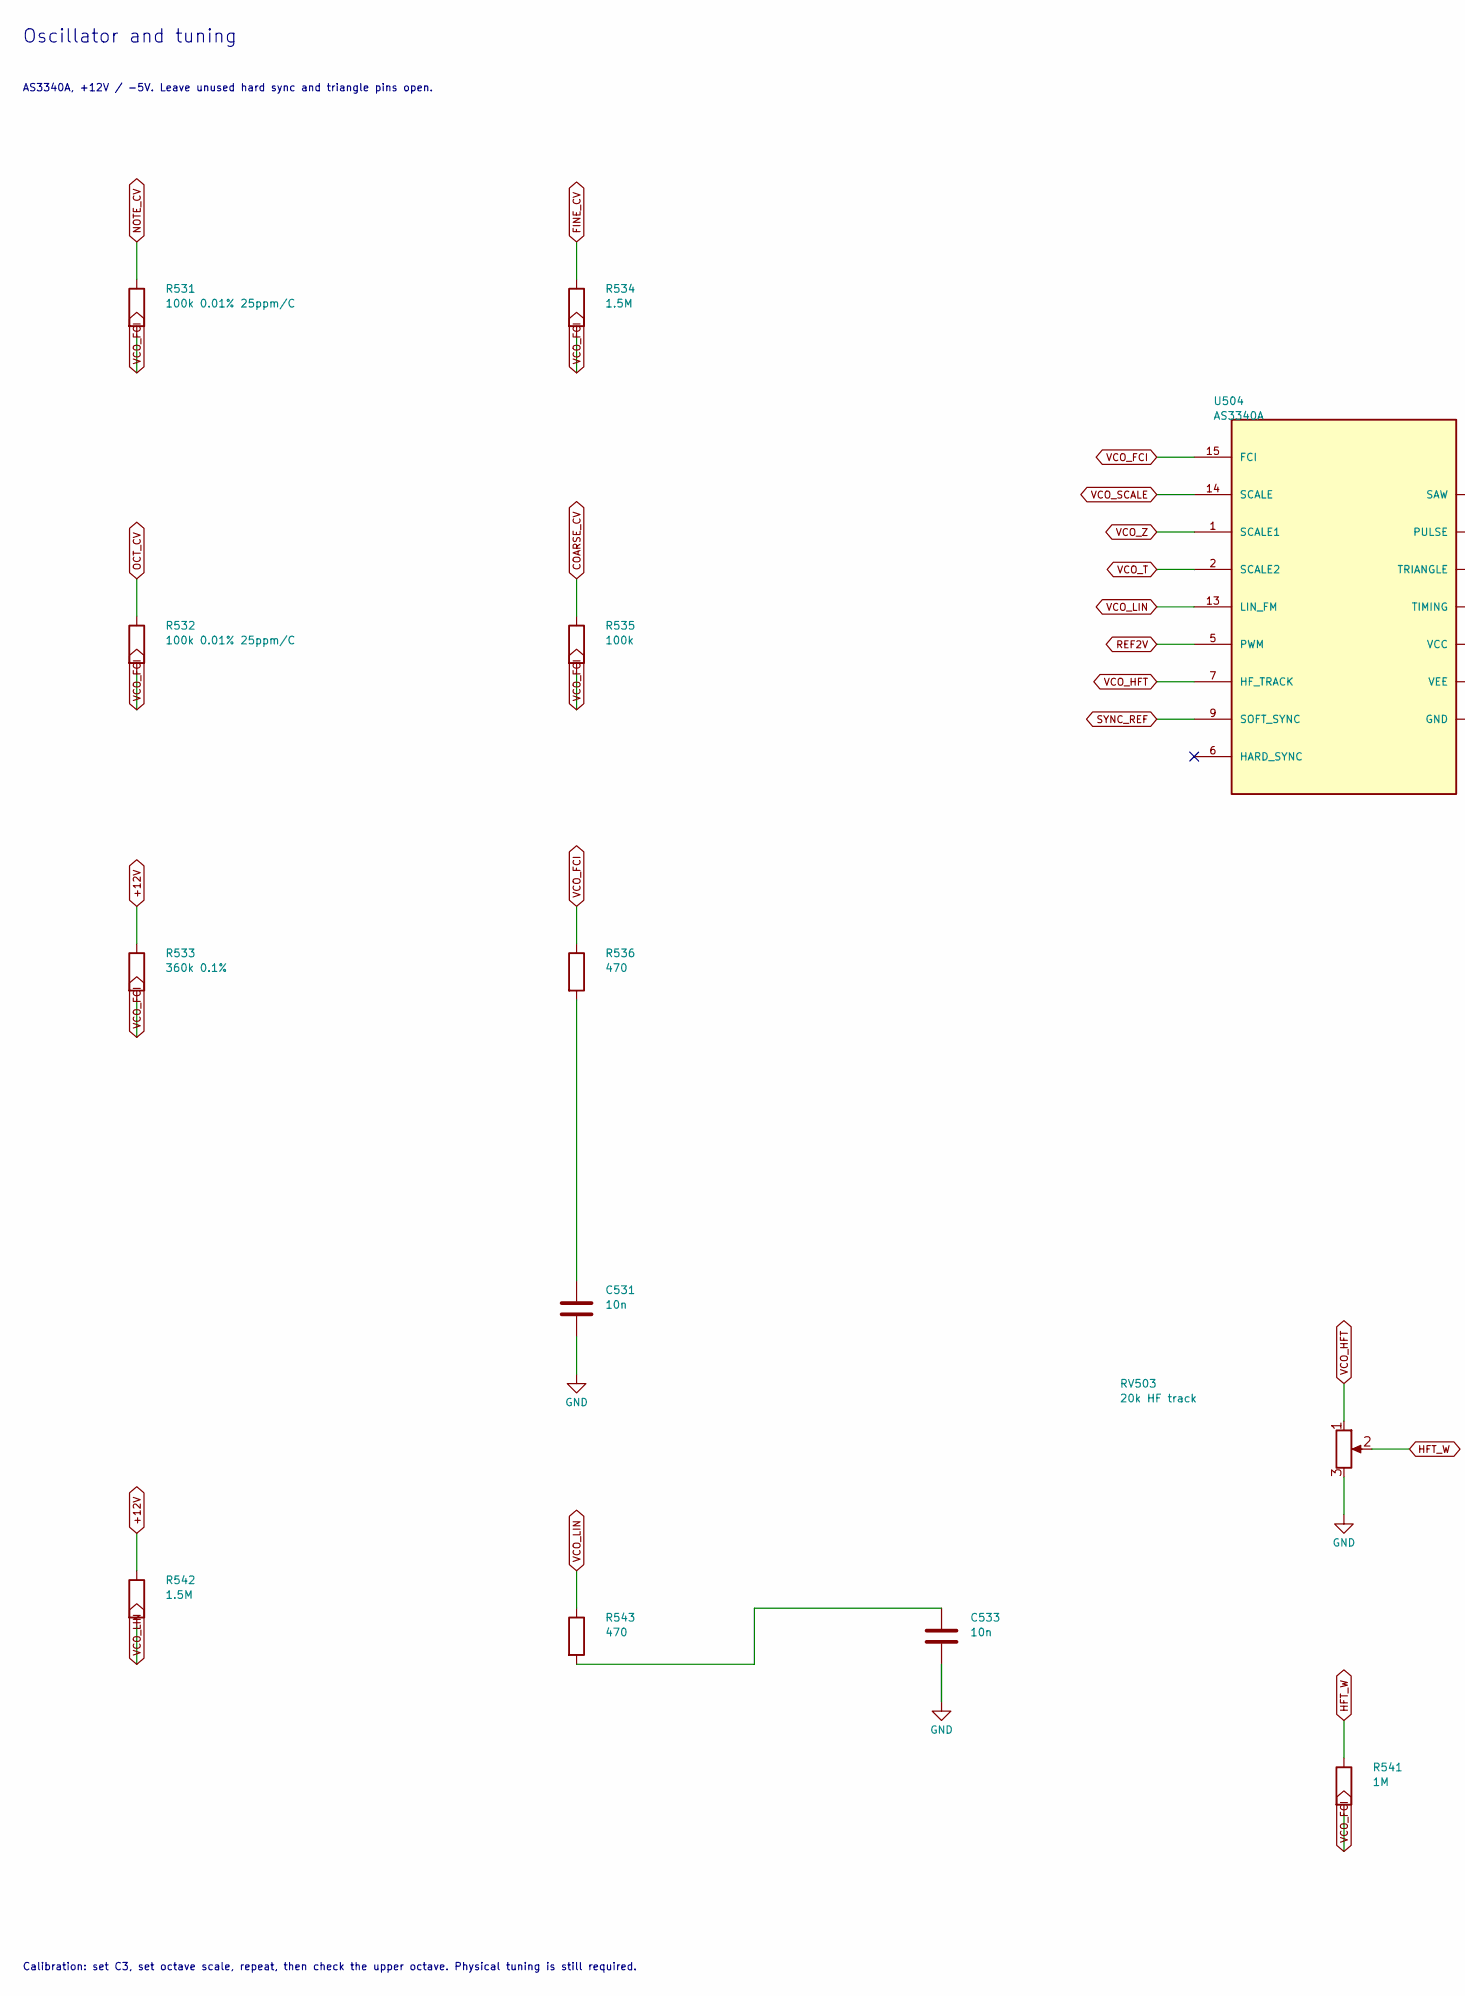
[picture p70: schematic 10_oscillator.kicad_sch, Oscillator and tuning, part in row 1, column 1]

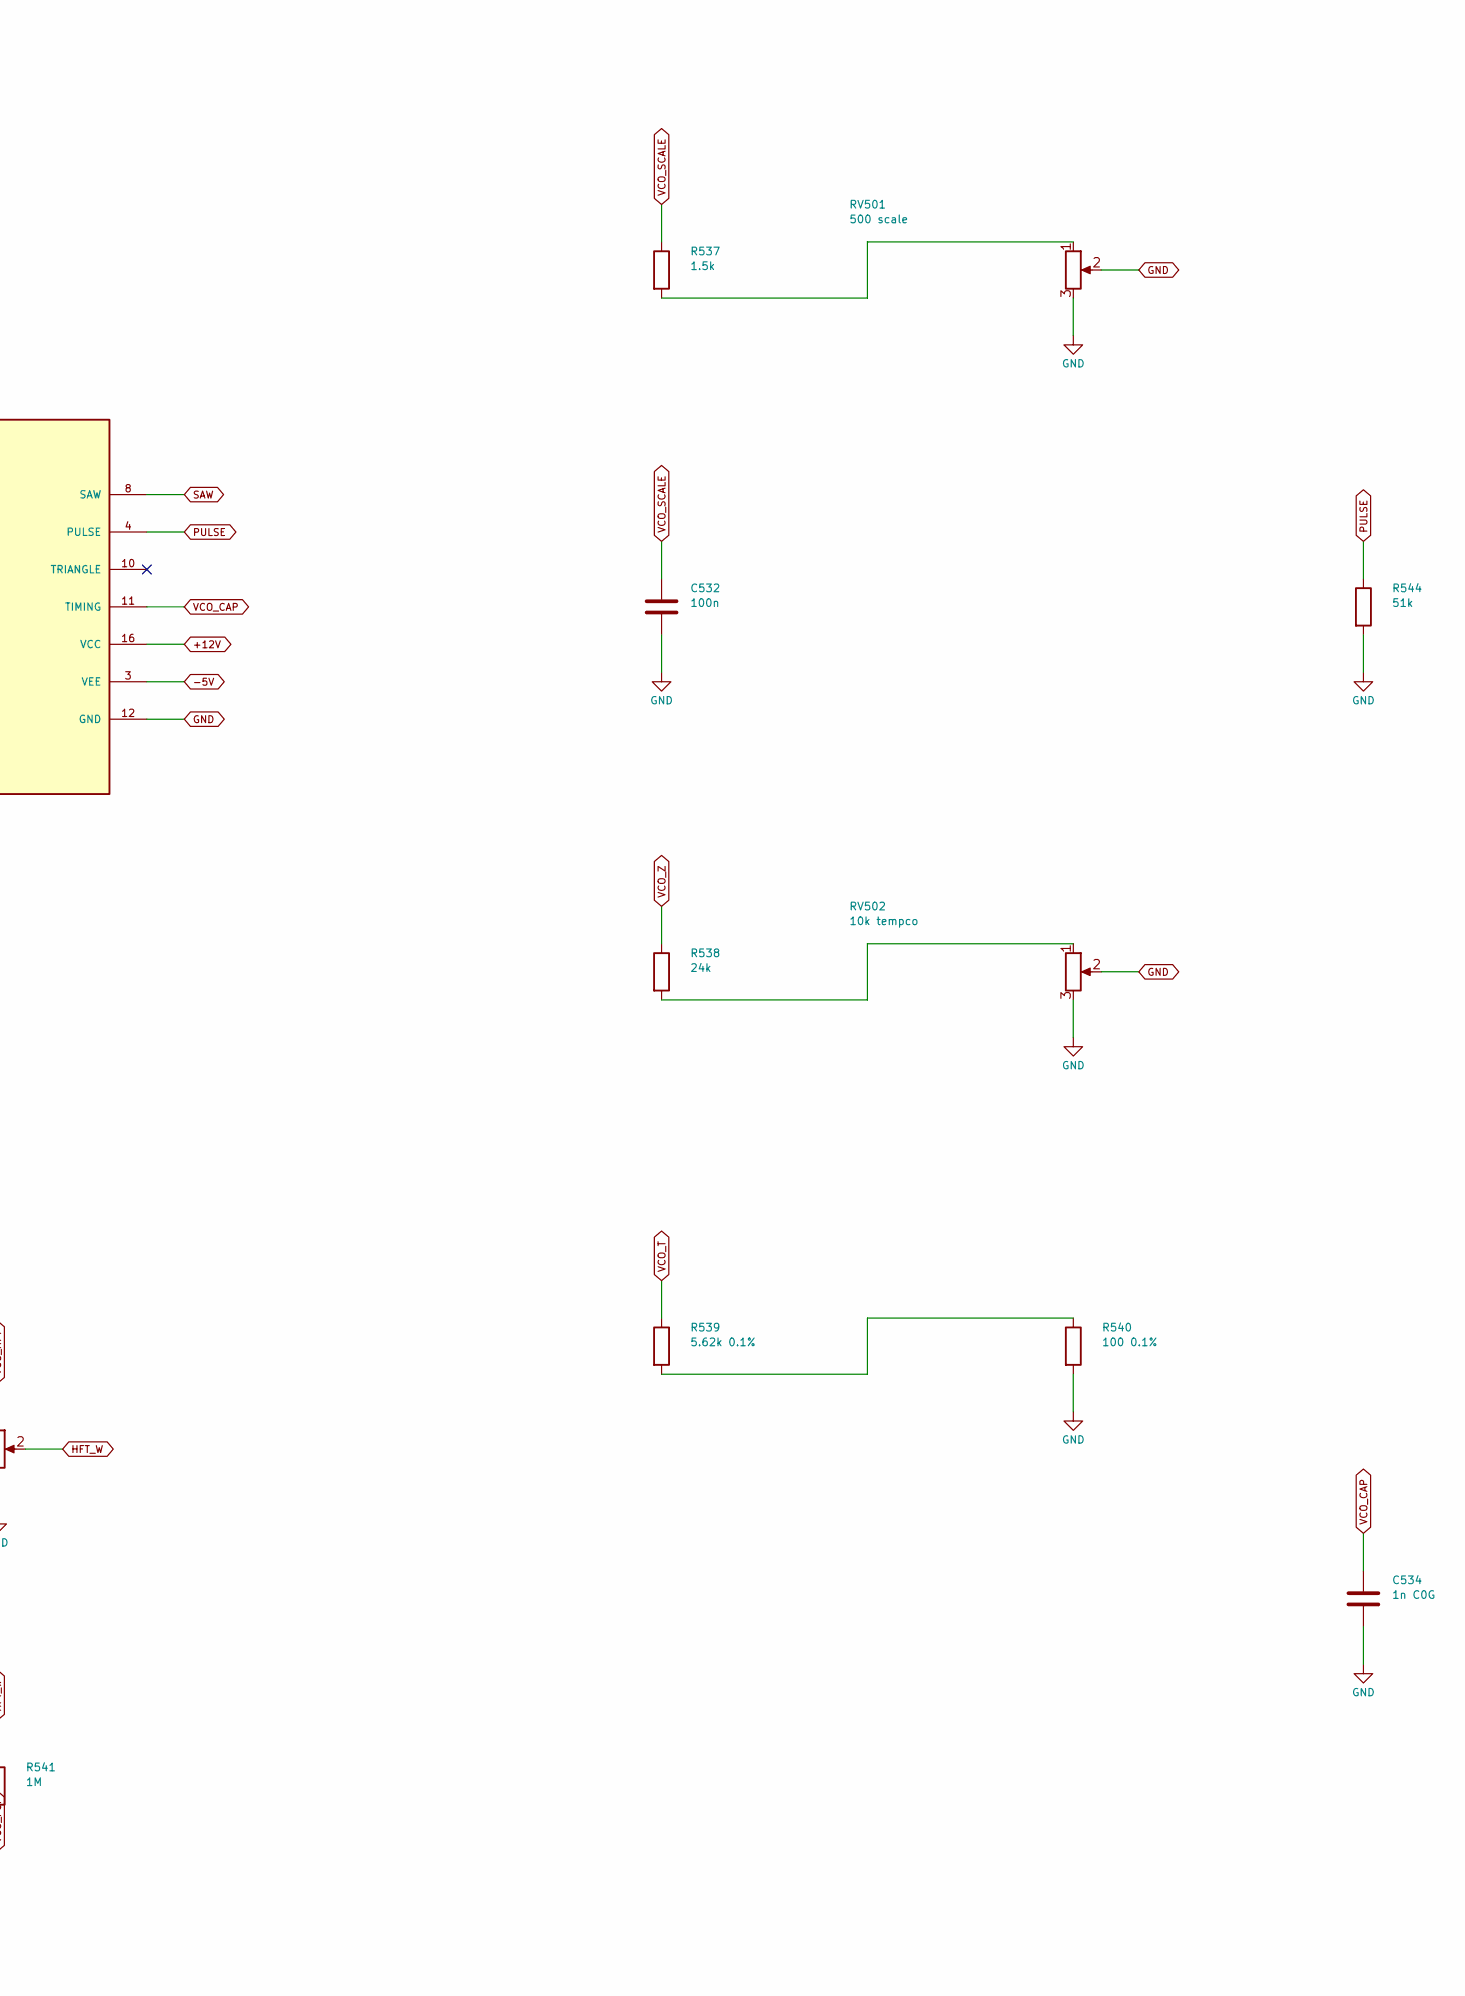
[picture p71: schematic 10_oscillator.kicad_sch, Oscillator and tuning, part in row 1, column 2]

Parts:
C531, C533: 10n; C_0805_2012Metric
C532: 100n; C_0805_2012Metric
C534: 1n C0G; C_0805_2012Metric
R531, R532: 100k 0.01% 25ppm/C; R_0805_2012Metric; MPN RNCF0805TKT100K
R533: 360k 0.1%; R_0805_2012Metric
R534, R542: 1.5M; R_0805_2012Metric
R535: 100k; R_0805_2012Metric
R536, R543: 470; R_0805_2012Metric
R537: 1.5k; R_0805_2012Metric
R538: 24k; R_0805_2012Metric
R539: 5.62k 0.1%; R_0805_2012Metric
R540: 100 0.1%; R_0805_2012Metric
R541: 1M; R_0805_2012Metric
R544: 51k; R_0805_2012Metric
RV501: 500 scale; Potentiometer_Bourns_3296W_Vertical; MPN 3296W-1-501LF
RV502: 10k tempco; Potentiometer_Bourns_3296W_Vertical; MPN 3296W-1-103LF
RV503: 20k HF track; Potentiometer_Bourns_3296W_Vertical; MPN 3296W-1-203LF
U504: AS3340A; DIP-16_W7.62mm; MPN AS3340A

Connections:
+12V: R533.1, R542.1, U504.16 (VCC); also elsewhere on the board
-5V: U504.3 (VEE); also elsewhere on the board
COARSE_CV: R535.1; also elsewhere on the board
FINE_CV: R534.1; also elsewhere on the board
HFT_W: R541.1, RV503.2
NOTE_CV: R531.1; also elsewhere on the board
unnamed: C531.1, R536.2
unnamed: C533.1, R543.2
unnamed: R537.2, RV501.1
unnamed: R538.2, RV502.1
unnamed: R539.2, R540.1
OCT_CV: R532.1; also elsewhere on the board
PULSE: R544.1, U504.4 (PULSE); also elsewhere on the board
REF2V: U504.5 (PWM); also elsewhere on the board
SAW: U504.8 (SAW); also elsewhere on the board
SYNC_REF: U504.9 (SOFT_SYNC); also elsewhere on the board
VCO_CAP: C534.1, U504.11 (TIMING)
VCO_FCI: R531.2, R532.2, R533.2, R534.2, R535.2, R536.1, R541.2, U504.15 (FCI)
VCO_HFT: RV503.1, U504.7 (HF_TRACK)
VCO_LIN: R542.2, R543.1, U504.13 (LIN_FM)
VCO_SCALE: C532.1, R537.1, U504.14 (SCALE)
VCO_T: R539.1, U504.2 (SCALE2)
VCO_Z: R538.1, U504.1 (SCALE1)

Notes on the sheet:
Oscillator and tuning
AS3340A, +12V / -5V. Leave unused hard sync and triangle pins open.
Calibration: set C3, set octave scale, repeat, then check the upper octave. Physical tuning is still required.

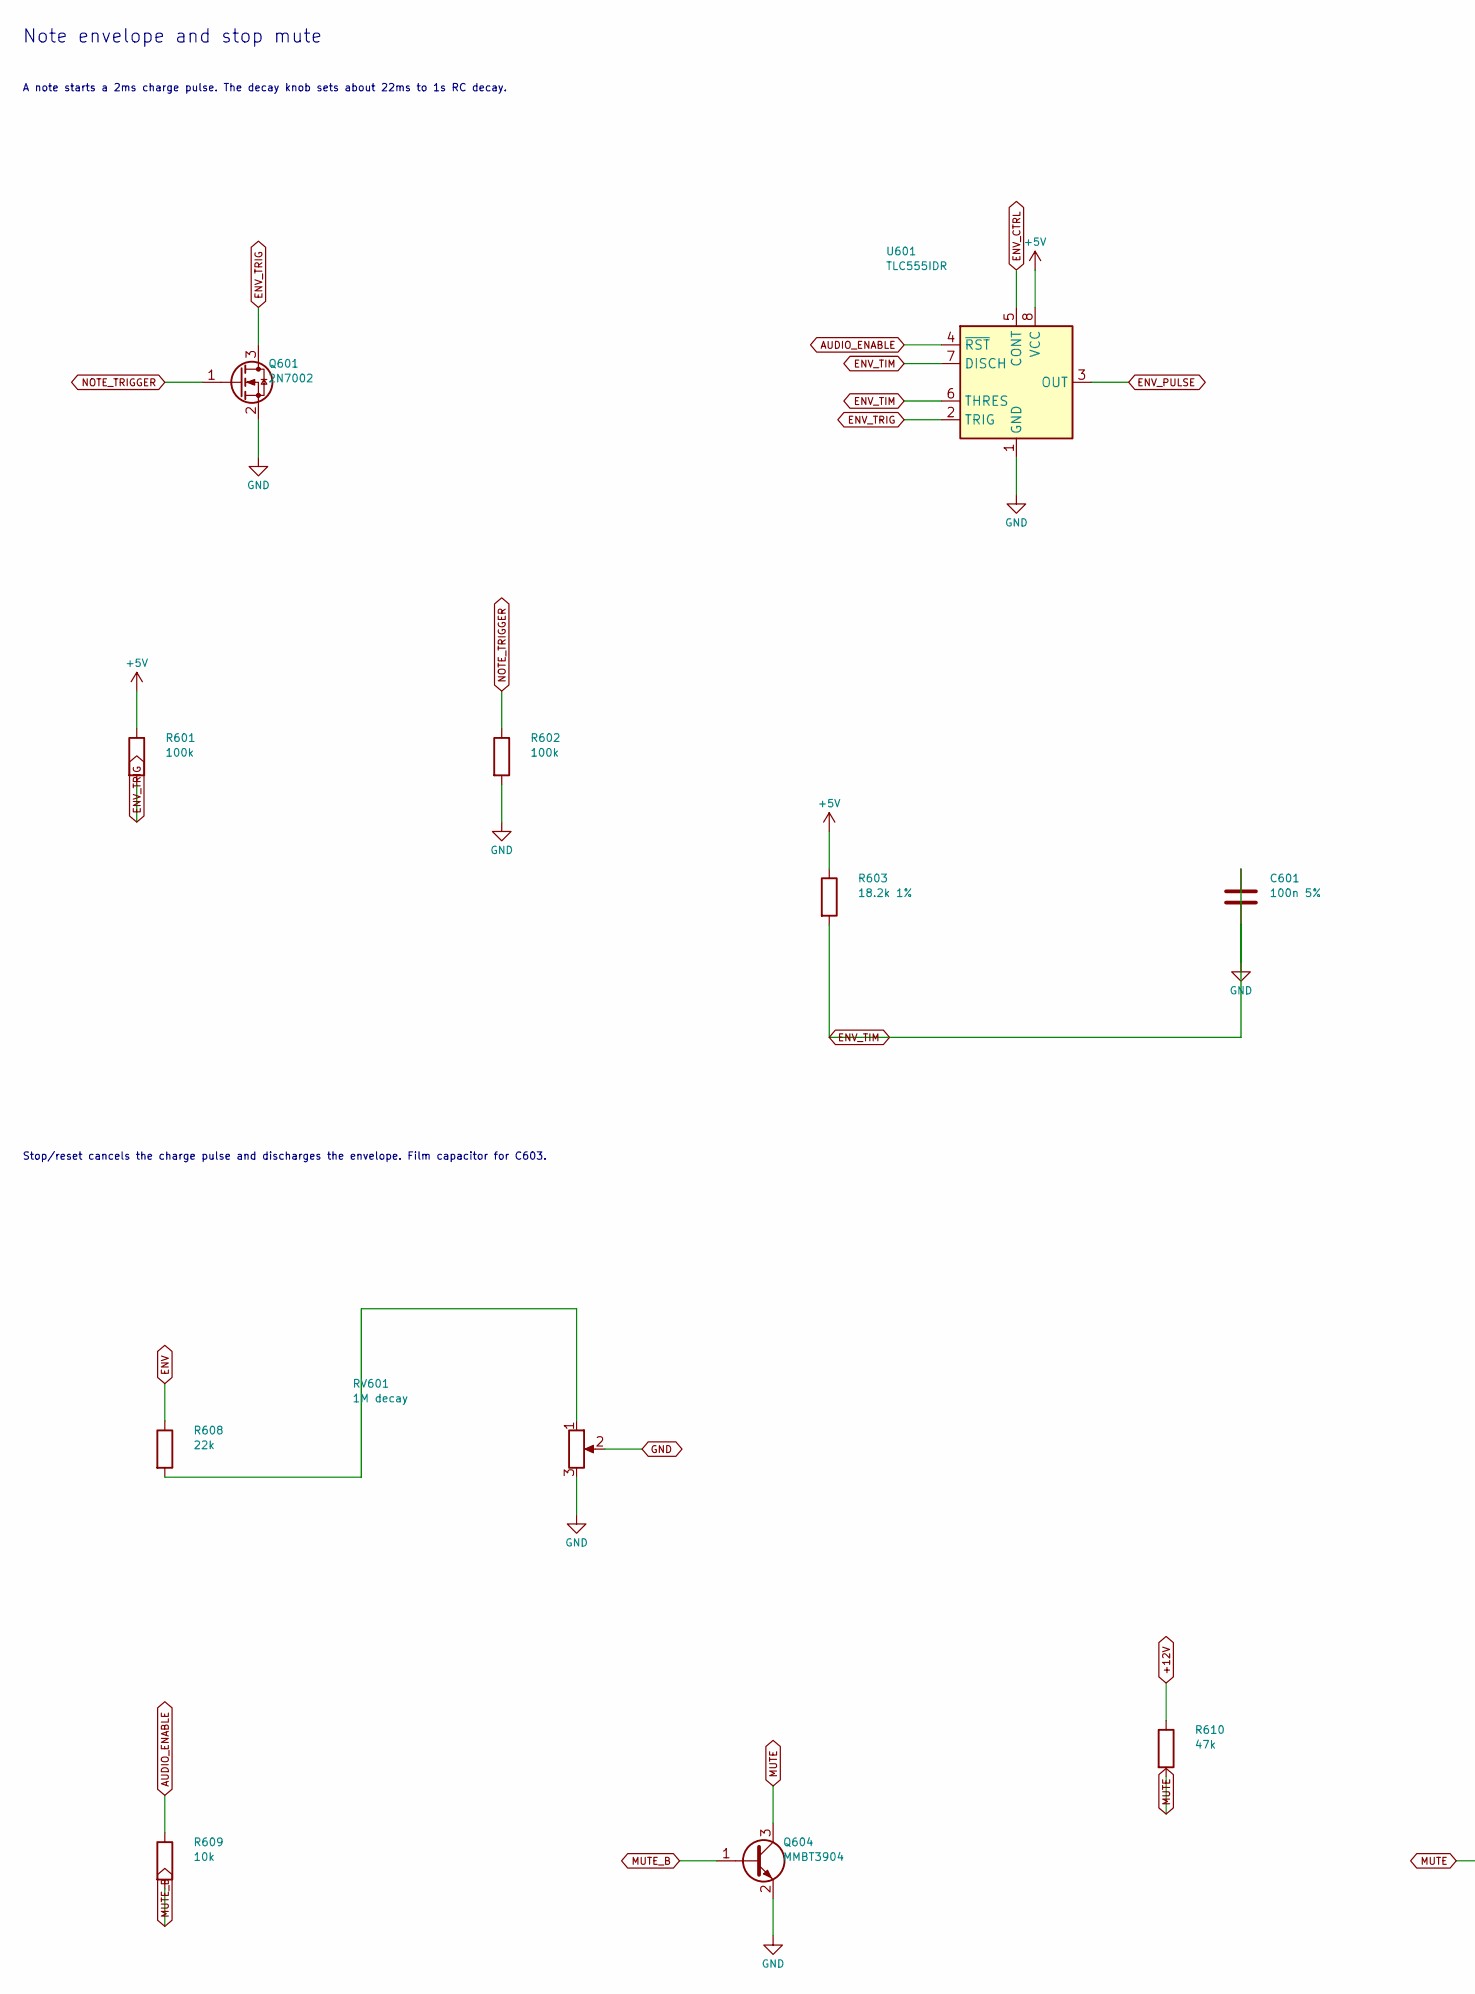
[picture p72: schematic 11_envelope.kicad_sch, Note envelope and stop mute, part in row 1, column 1]

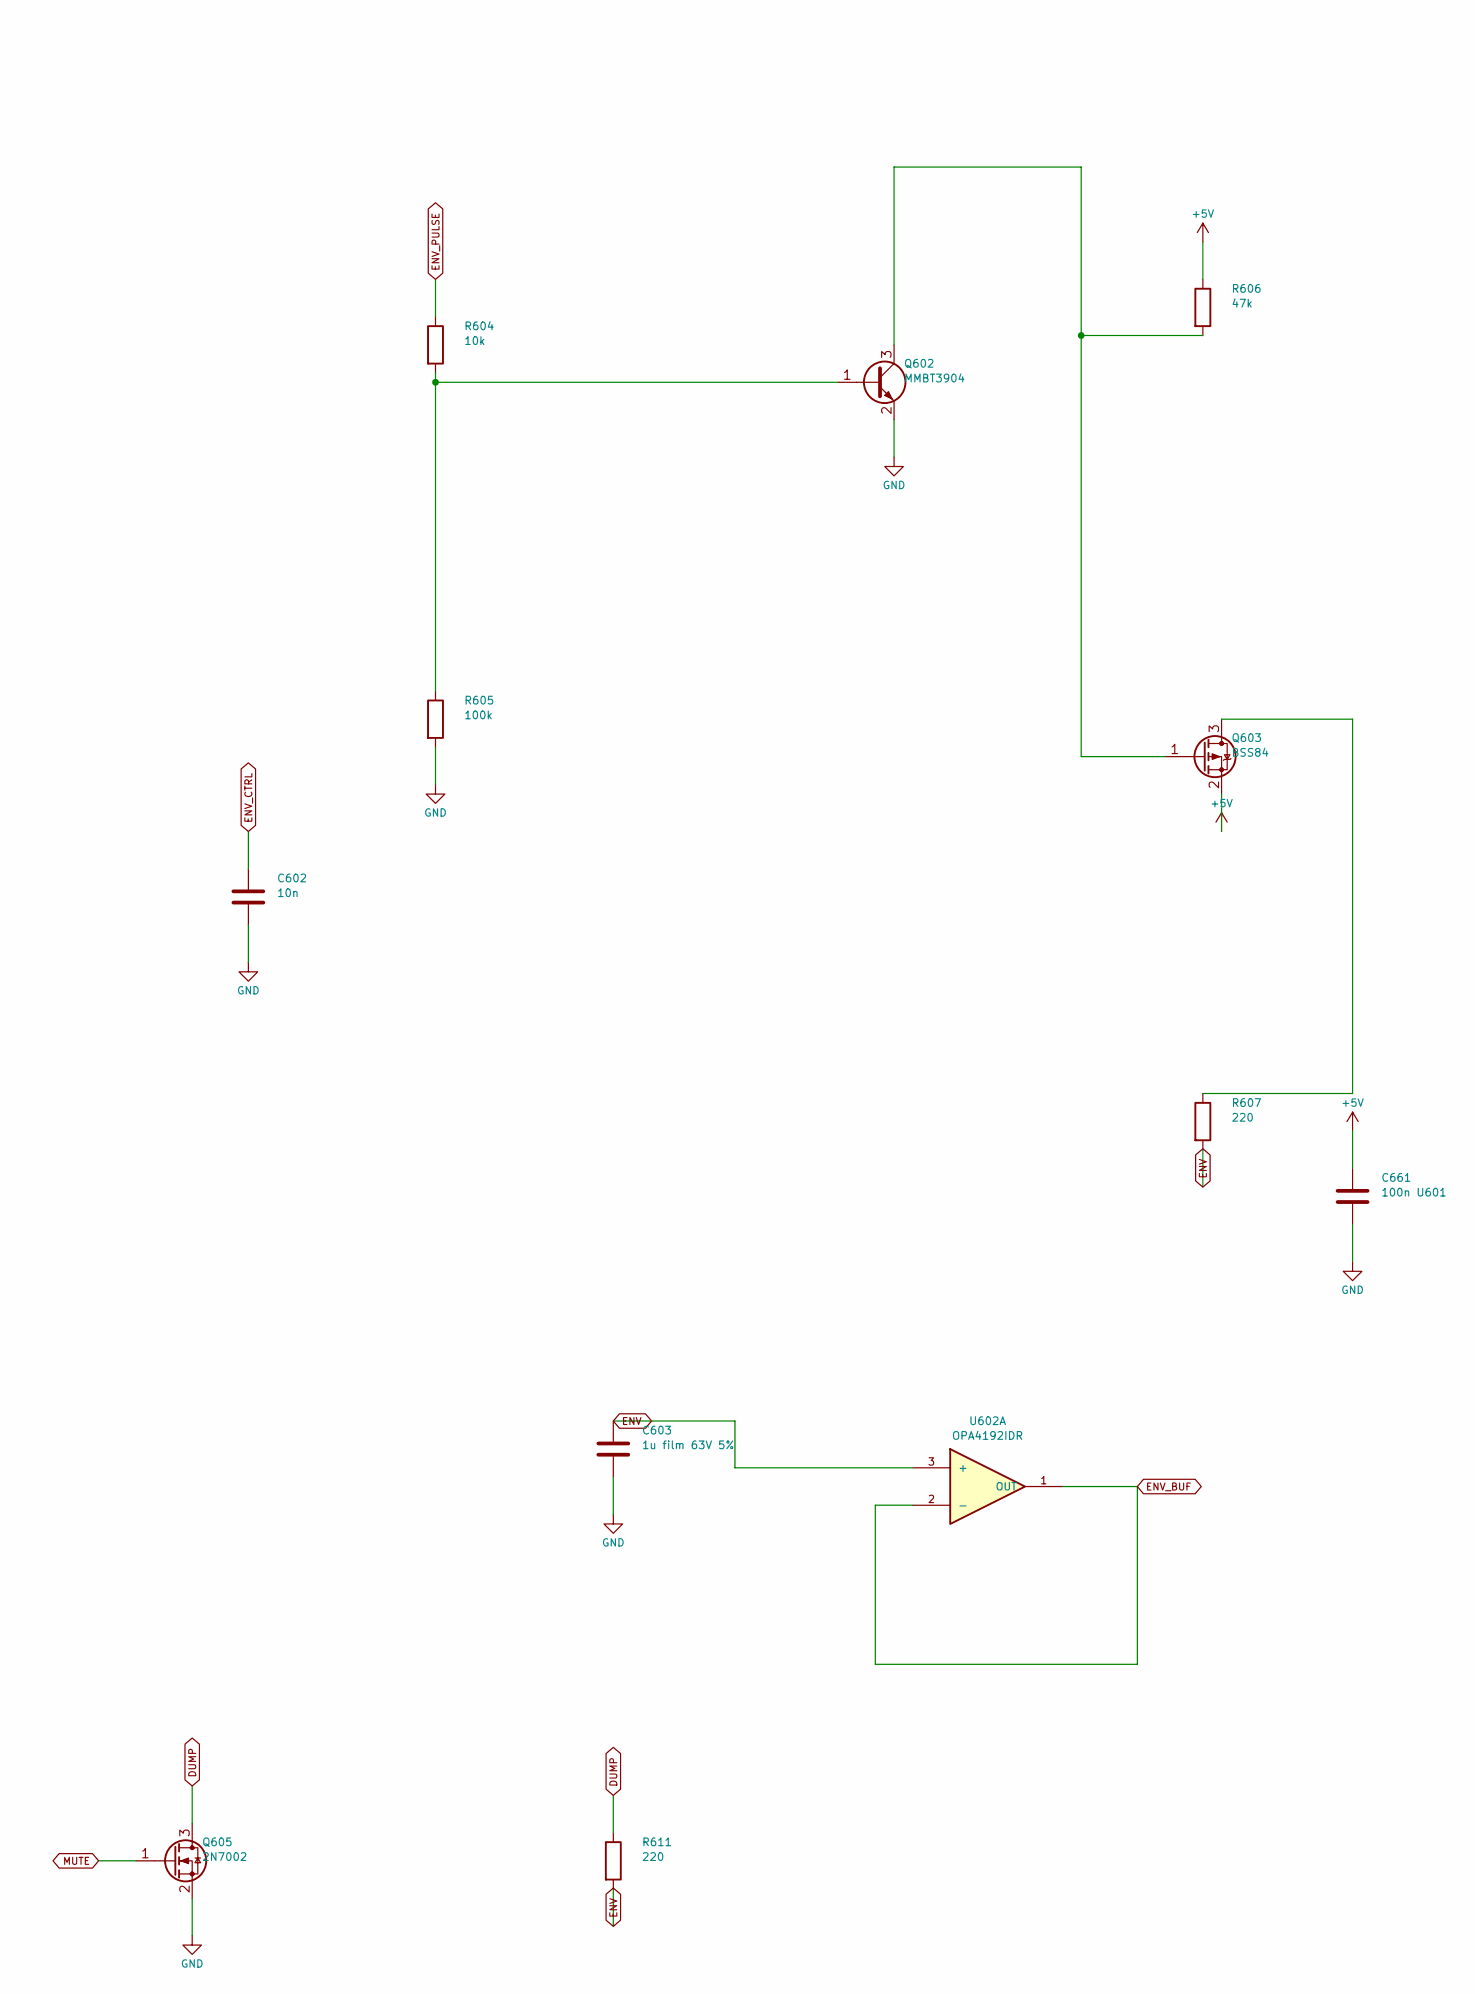
[picture p73: schematic 11_envelope.kicad_sch, Note envelope and stop mute, part in row 1, column 2]

Parts:
C601: 100n 5%; C_0805_2012Metric
C602: 10n; C_0805_2012Metric
C603: 1u film 63V 5%; C_Rect_L7.2mm_W5.0mm_P5.00mm; MPN R82DC4100DQ60J
C661: 100n U601; C_0805_2012Metric
Q601, Q605: 2N7002; SOT-23; MPN 2N7002,215
Q602, Q604: MMBT3904; SOT-23; MPN MMBT3904,215
Q603: BSS84; SOT-23; MPN BSS84,215
R601, R602, R605: 100k; R_0805_2012Metric
R603: 18.2k 1%; R_0805_2012Metric
R604, R609: 10k; R_0805_2012Metric
R606, R610: 47k; R_0805_2012Metric
R607, R611: 220; R_0805_2012Metric
R608: 22k; R_0805_2012Metric
RV601: 1M decay; Potentiometer_Alpha_RD901F-40-00D_Single_Vertical; MPN RD901F-40-15F-B1M
U601: TLC555IDR; SOIC-8_3.9x4.9mm_P1.27mm; MPN TLC555IDR
U602: OPA4192IDR; SOIC-14_3.9x8.7mm_P1.27mm; MPN OPA4192IDR

Connections:
+5V: C661.1, Q603.2 (S), R601.1, R603.1, R606.1, U601.8 (VCC); also elsewhere on the board
+12V: R610.1; also elsewhere on the board
AUDIO_ENABLE: R609.1, U601.4 (~RST); also elsewhere on the board
DUMP: Q605.3 (D), R611.1
ENV: C603.1, R607.2, R608.1, R611.2, U602.3 (+)
ENV_BUF: U602.1 (OUT), U602.2 (-); also elsewhere on the board
ENV_CTRL: C602.1, U601.5 (CONT)
ENV_PULSE: R604.1, U601.3 (OUT)
ENV_TRIG: Q601.3 (D), R601.2, U601.2 (TRIG)
MUTE: Q604.3 (C), Q605.1 (G), R610.2
MUTE_B: Q604.1 (B), R609.2
NOTE_TRIGGER: Q601.1 (G), R602.1; also elsewhere on the board
unnamed: Q602.1 (B), R604.2, R605.1
unnamed: Q602.3 (C), Q603.1 (G), R606.2
unnamed: Q603.3 (D), R607.1
unnamed: R608.2, RV601.1

Notes on the sheet:
Note envelope and stop mute
A note starts a 2ms charge pulse. The decay knob sets about 22ms to 1s RC decay.
Stop/reset cancels the charge pulse and discharges the envelope. Film capacitor for C603.

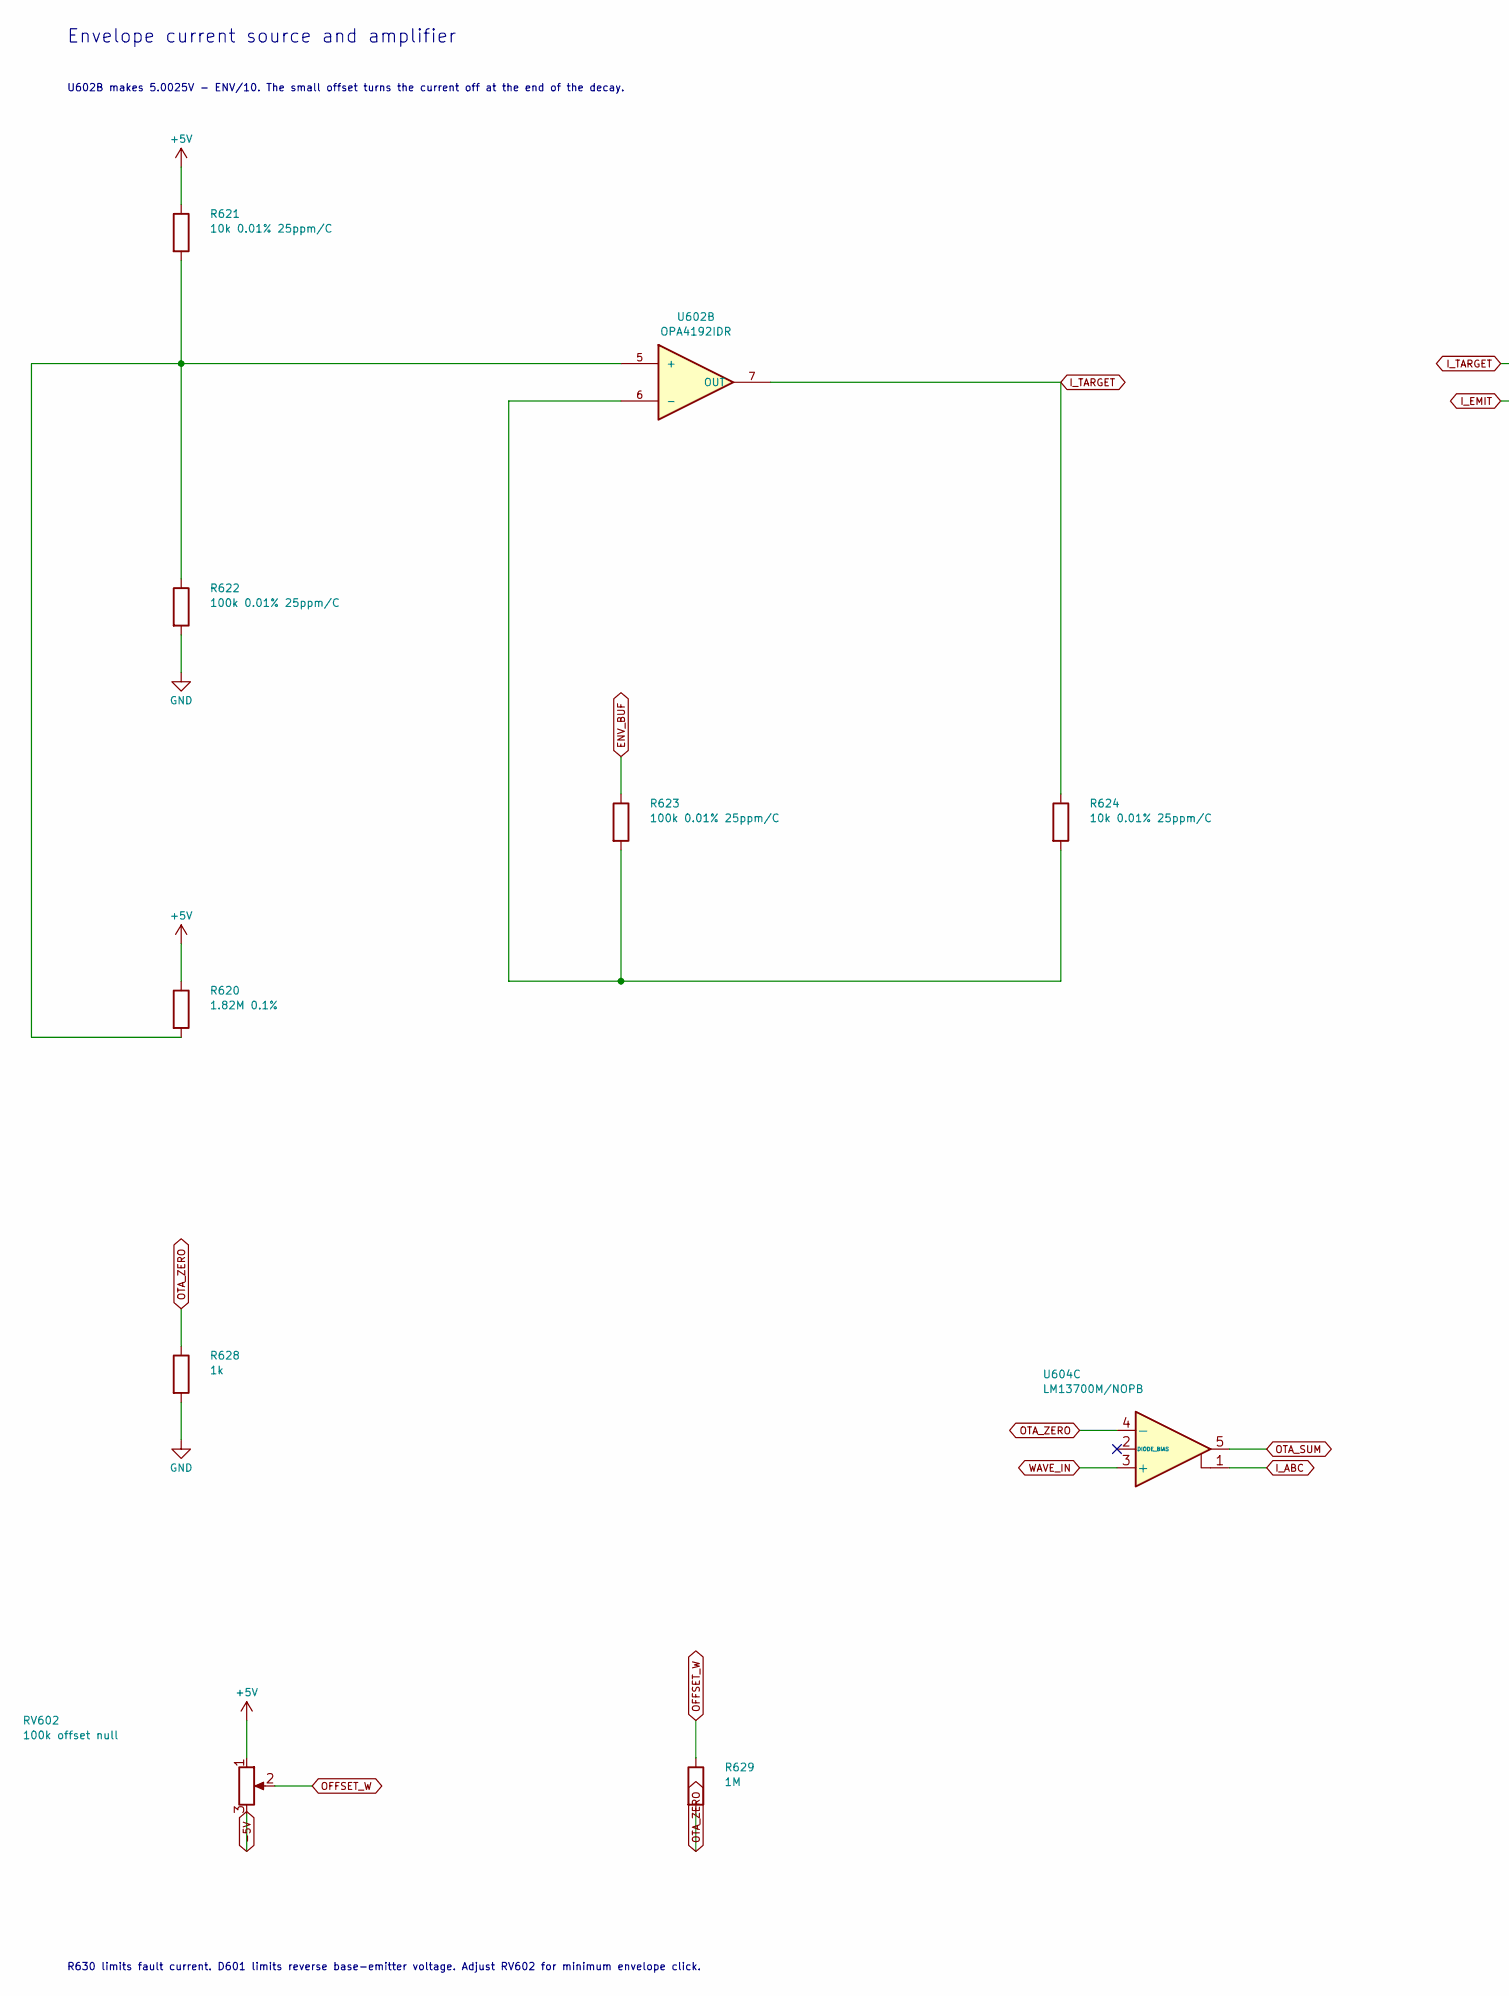
[picture p74: schematic 12_amplifier.kicad_sch, Envelope current source and amplifier, part in row 1, column 1]

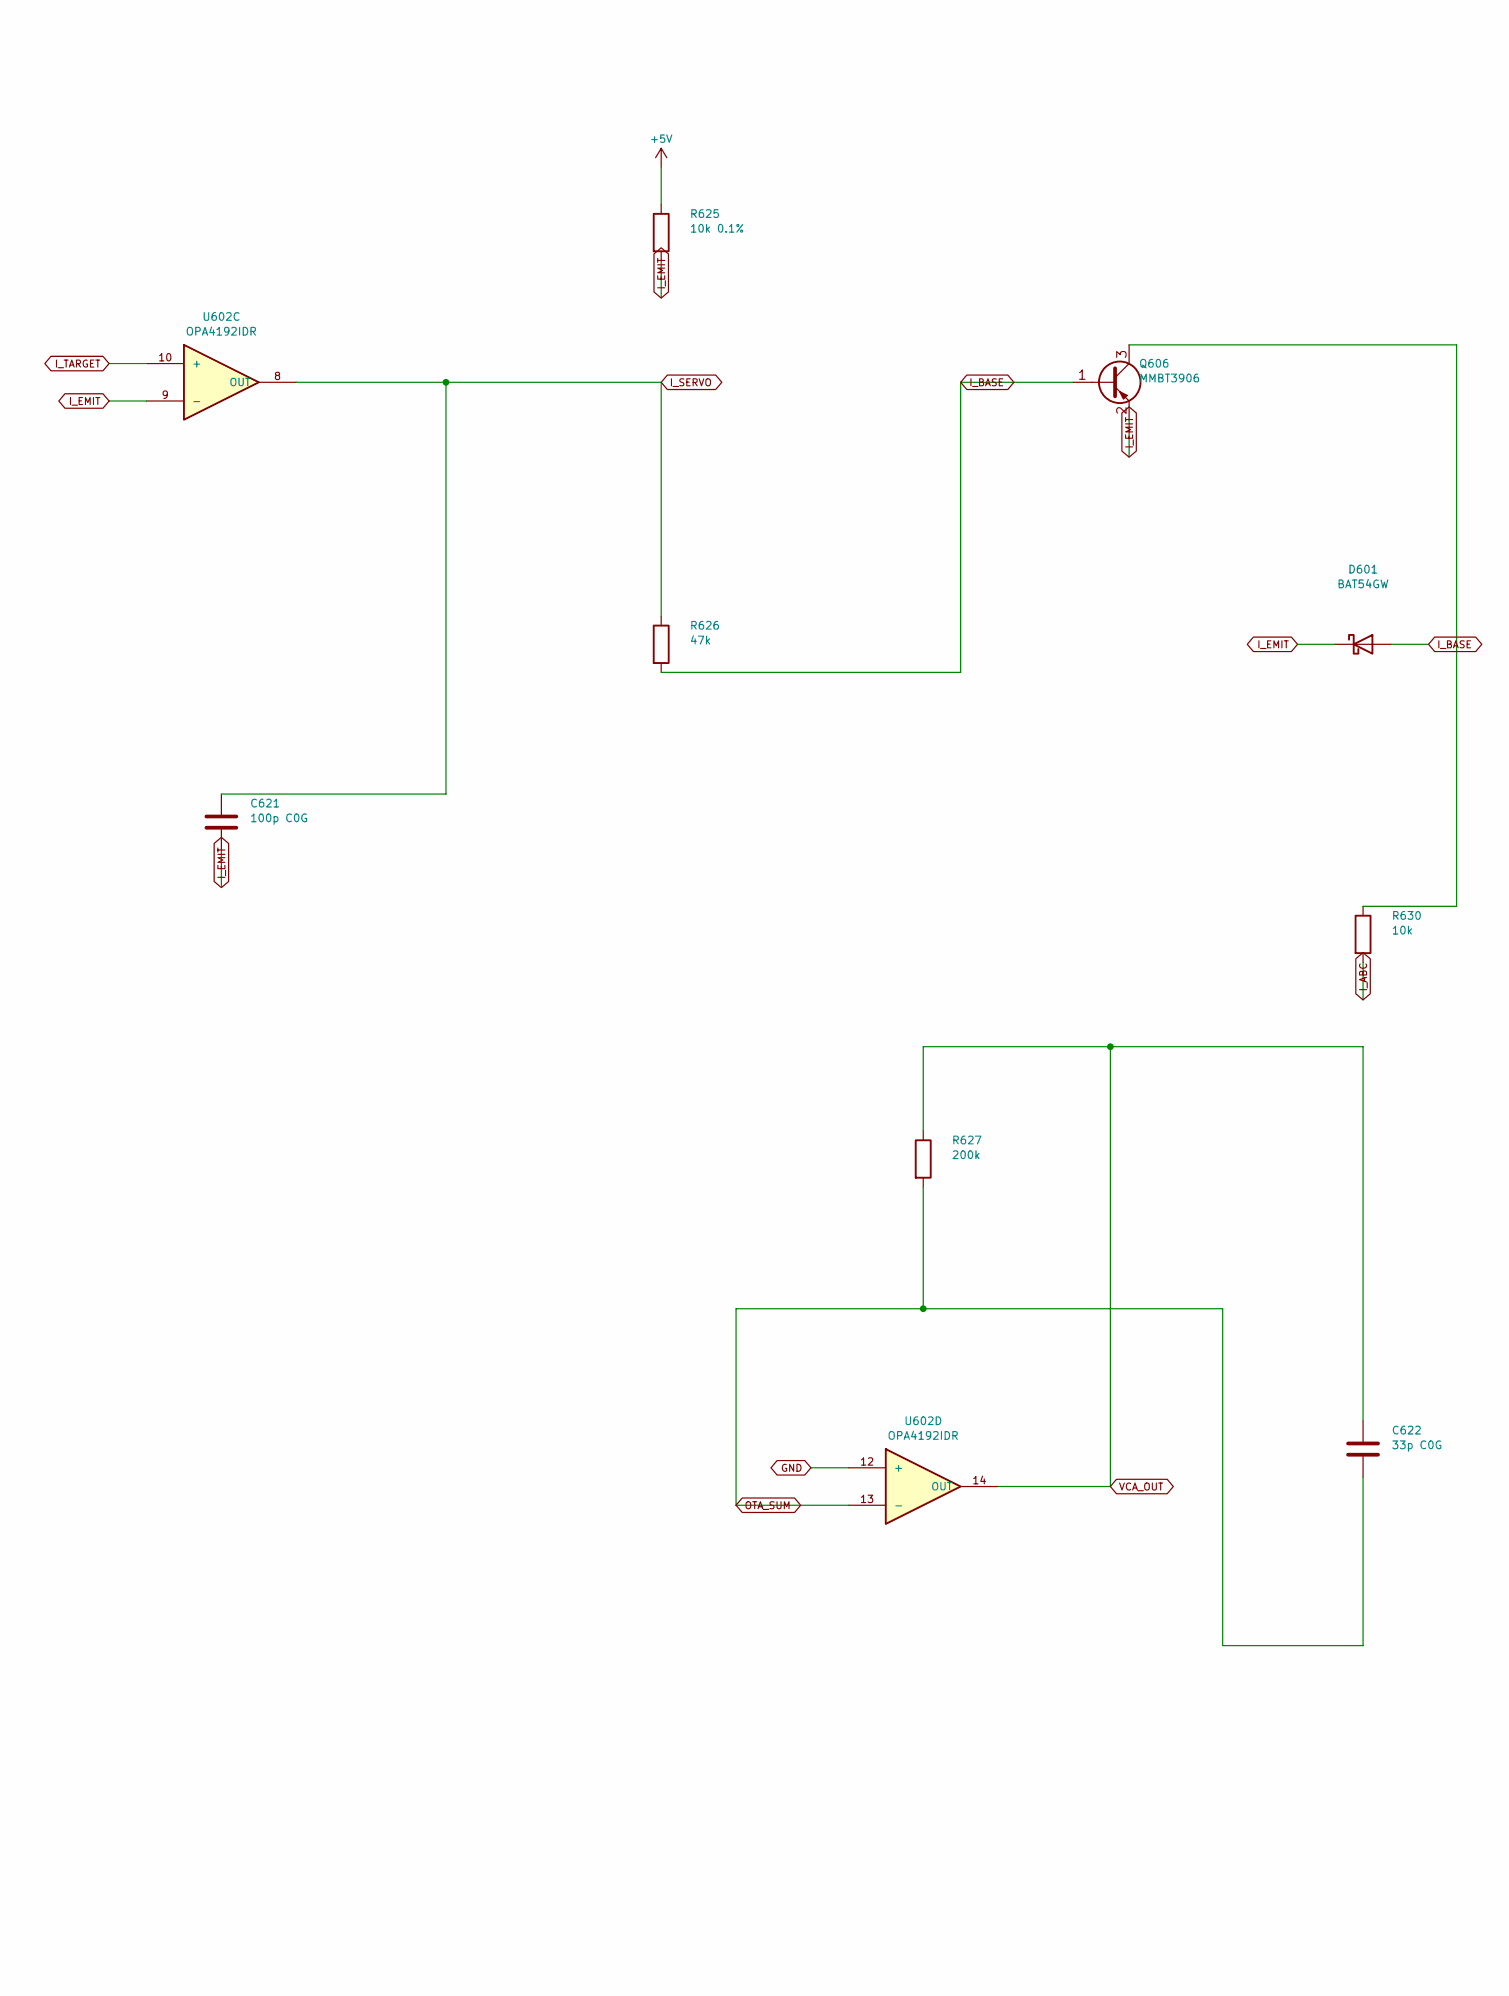
[picture p75: schematic 12_amplifier.kicad_sch, Envelope current source and amplifier, part in row 1, column 2]

Parts:
C621: 100p C0G; C_0805_2012Metric
C622: 33p C0G; C_0805_2012Metric
D601: BAT54GW; D_SOD-123; MPN BAT54GWX
Q606: MMBT3906; SOT-23; MPN MMBT3906,215
R620: 1.82M 0.1%; R_0805_2012Metric
R621, R624: 10k 0.01% 25ppm/C; R_0805_2012Metric; MPN RNCF0805TKY10K0
R622, R623: 100k 0.01% 25ppm/C; R_0805_2012Metric; MPN RNCF0805TKT100K
R625: 10k 0.1%; R_0805_2012Metric
R626: 47k; R_0805_2012Metric
R627: 200k; R_0805_2012Metric
R628: 1k; R_0805_2012Metric
R629: 1M; R_0805_2012Metric
R630: 10k; R_0805_2012Metric
RV602: 100k offset null; Potentiometer_Bourns_3296W_Vertical; MPN 3296W-1-104LF
U602: OPA4192IDR; SOIC-14_3.9x8.7mm_P1.27mm; MPN OPA4192IDR
U604: LM13700M/NOPB; SOIC-16_3.9x9.9mm_P1.27mm; MPN LM13700M/NOPB

Connections:
+5V: R620.1, R621.1, R625.1, RV602.1; also elsewhere on the board
-5V: RV602.3; also elsewhere on the board
ENV_BUF: R623.1; also elsewhere on the board
I_ABC: R630.2, U604.1
I_BASE: D601.2 (A), Q606.1 (B), R626.2
I_EMIT: C621.2, D601.1 (K), Q606.2 (E), R625.2, U602.9 (-)
I_SERVO: C621.1, R626.1, U602.8 (OUT)
I_TARGET: R624.1, U602.7 (OUT), U602.10 (+)
unnamed: Q606.3 (C), R630.1
unnamed: R620.2, R621.2, R622.1, U602.5 (+)
unnamed: R623.2, R624.2, U602.6 (-)
OFFSET_W: R629.1, RV602.2
OTA_SUM: C622.2, R627.2, U602.13 (-), U604.5
OTA_ZERO: R628.1, R629.2, U604.4 (-)
VCA_OUT: C622.1, R627.1, U602.14 (OUT); also elsewhere on the board
WAVE_IN: U604.3 (+); also elsewhere on the board

Notes on the sheet:
Envelope current source and amplifier
U602B makes 5.0025V - ENV/10. The small offset turns the current off at the end of the decay.
R630 limits fault current. D601 limits reverse base-emitter voltage. Adjust RV602 for minimum envelope click.
