EwoudVV/arpeggiator/arpeggiator.kicad_pcb

## KiCad design arpeggiator.kicad_pcb (continued)

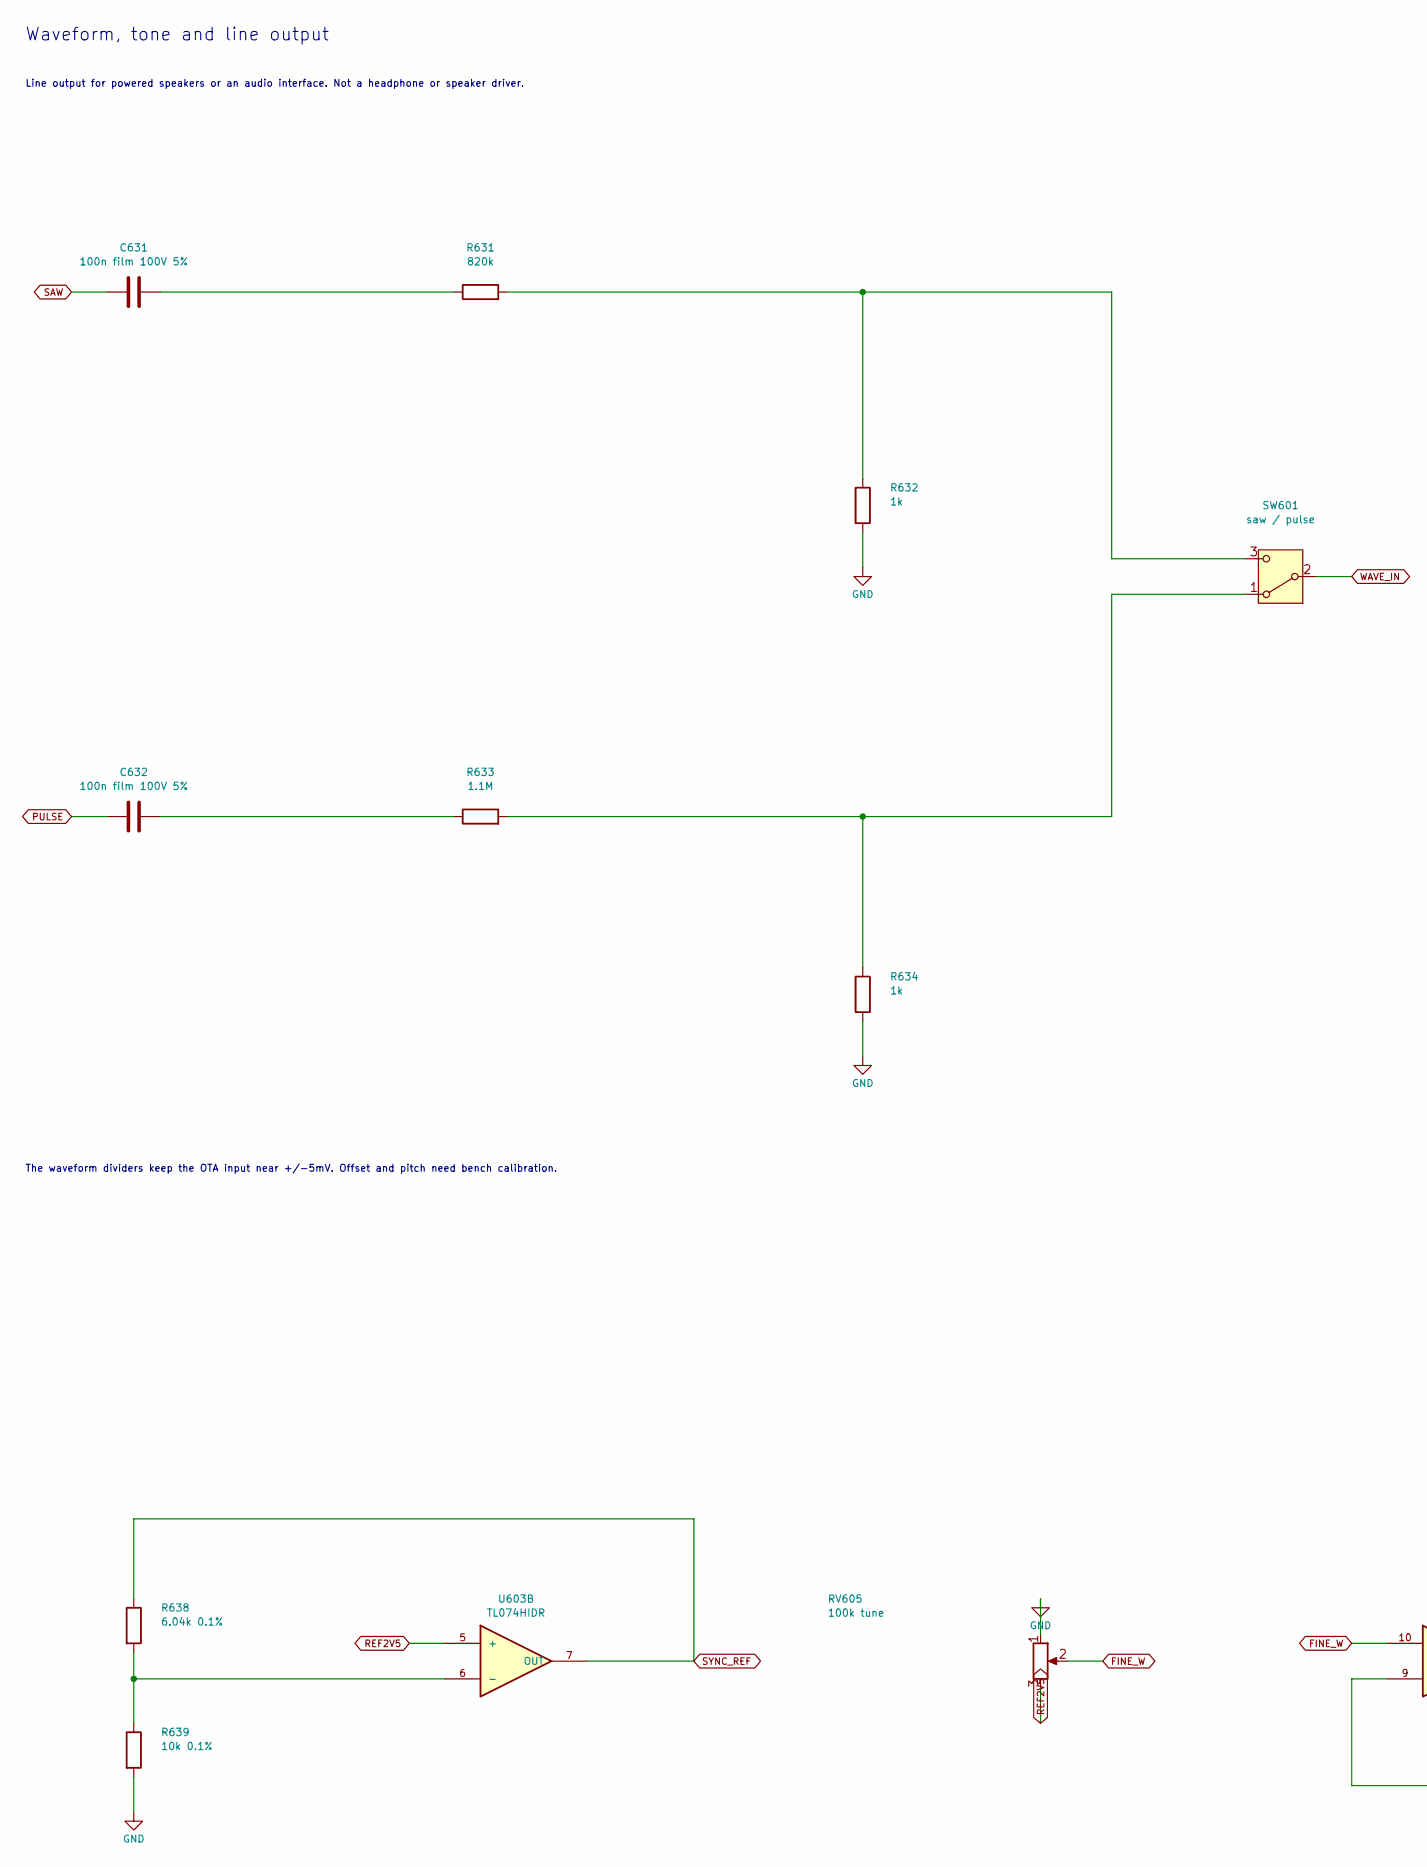
[picture p76: schematic 13_line_output.kicad_sch, Waveform, tone and line output, part in row 1, column 1]

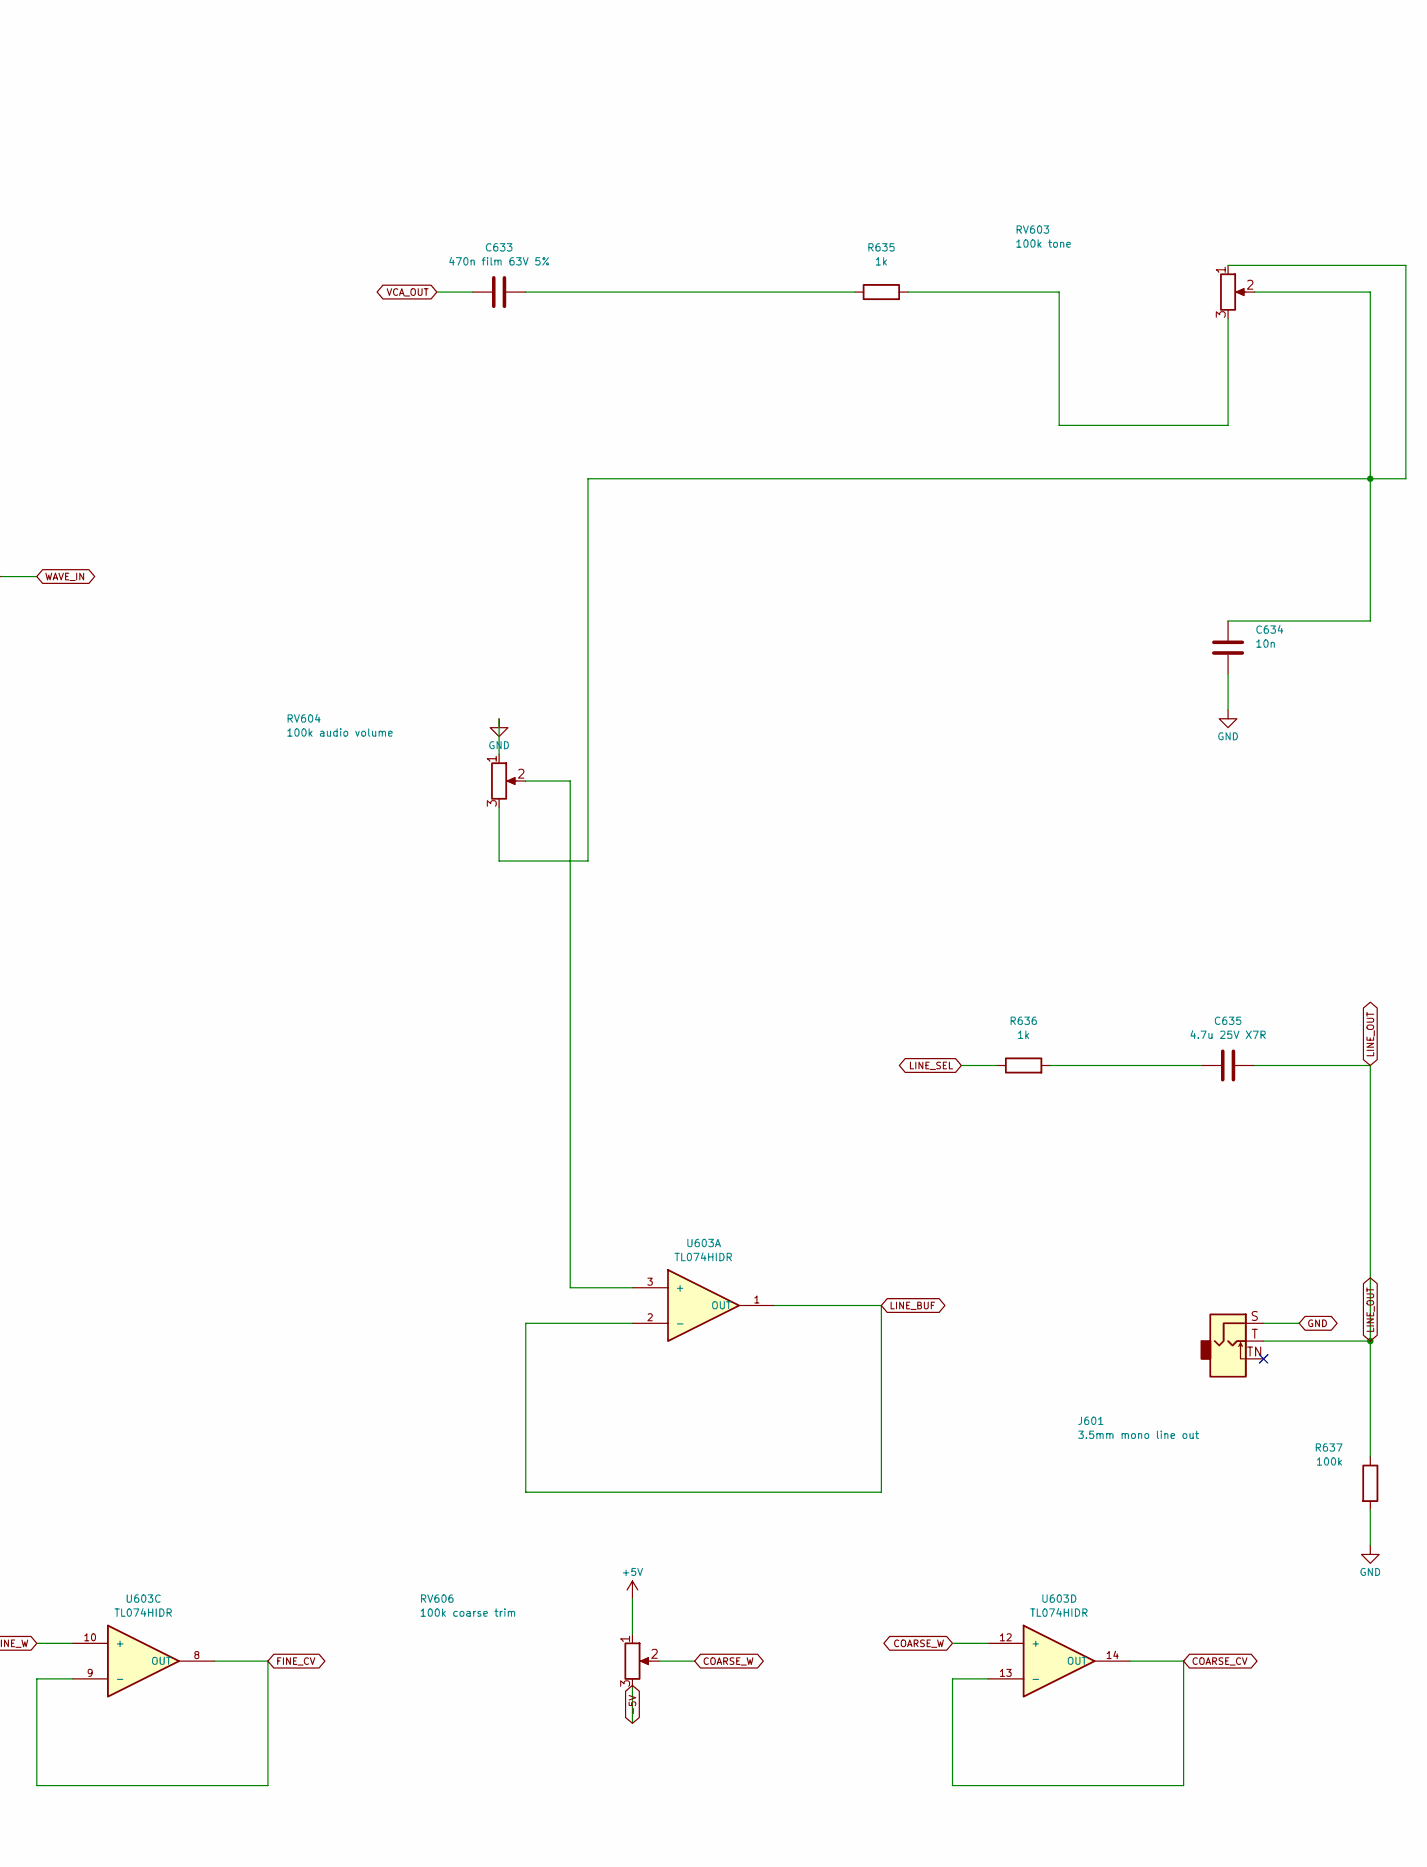
[picture p77: schematic 13_line_output.kicad_sch, Waveform, tone and line output, part in row 1, column 2]

Parts:
C631, C632: 100n film 100V 5%; C_Rect_L7.2mm_W2.5mm_P5.00mm; MPN R82EC3100DQ70J
C633: 470n film 63V 5%; C_Rect_L7.2mm_W3.5mm_P5.00mm; MPN R82DC3470AA60J
C634: 10n; C_0805_2012Metric
C635: 4.7u 25V X7R; C_0805_2012Metric
J601: 3.5mm mono line out; Jack_PJ-3001F_Vertical; MPN PJ-3001F
R631: 820k; R_0805_2012Metric
R632, R634, R635, R636: 1k; R_0805_2012Metric
R633: 1.1M; R_0805_2012Metric
R637: 100k; R_0805_2012Metric
R638: 6.04k 0.1%; R_0805_2012Metric
R639: 10k 0.1%; R_0805_2012Metric
RV603: 100k tone; Potentiometer_Alpha_RD901F-40-00D_Single_Vertical; MPN RD901F-40-15F-B100K
RV604: 100k audio volume; Potentiometer_Alpha_RD901F-40-00D_Single_Vertical; MPN RD901F-40-15F-A100K
RV605: 100k tune; Potentiometer_Alpha_RD901F-40-00D_Single_Vertical; MPN RD901F-40-15F-B100K
RV606: 100k coarse trim; Potentiometer_Bourns_3296W_Vertical; MPN 3296W-1-104LF
SW601: saw / pulse; SW_Dailywell_1M_SPDT_M2; MPN 1MS1T1B1M2QES
U603: TL074HIDR; SOIC-14_3.9x8.7mm_P1.27mm; MPN TL074HIDR

Connections:
+5V: RV606.1; also elsewhere on the board
-5V: RV606.3; also elsewhere on the board
COARSE_CV: U603.13 (-), U603.14 (OUT); also elsewhere on the board
COARSE_W: RV606.2, U603.12 (+)
FINE_CV: U603.8 (OUT), U603.9 (-); also elsewhere on the board
FINE_W: RV605.2, U603.10 (+)
LINE_BUF: U603.1 (OUT), U603.2 (-); also elsewhere on the board
LINE_OUT: C635.2, J601.T, R637.1; also elsewhere on the board
LINE_SEL: R636.1; also elsewhere on the board
unnamed: C631.2, R631.1
unnamed: C632.2, R633.1
unnamed: C633.2, R635.1
unnamed: C634.1, RV603.1, RV603.2, RV604.3
unnamed: C635.1, R636.2
unnamed: R635.2, RV603.3
unnamed: R633.2, R634.1, SW601.1 (A)
unnamed: R631.2, R632.1, SW601.3 (C)
unnamed: RV604.2, U603.3 (+)
unnamed: R638.2, R639.1, U603.6 (-)
PULSE: C632.1; also elsewhere on the board
REF2V5: RV605.3, U603.5 (+); also elsewhere on the board
SAW: C631.1; also elsewhere on the board
SYNC_REF: R638.1, U603.7 (OUT); also elsewhere on the board
VCA_OUT: C633.1; also elsewhere on the board
WAVE_IN: SW601.2 (B); also elsewhere on the board

Notes on the sheet:
Waveform, tone and line output
Line output for powered speakers or an audio interface. Not a headphone or speaker driver.
The waveform dividers keep the OTA input near +/-5mV. Offset and pitch need bench calibration.

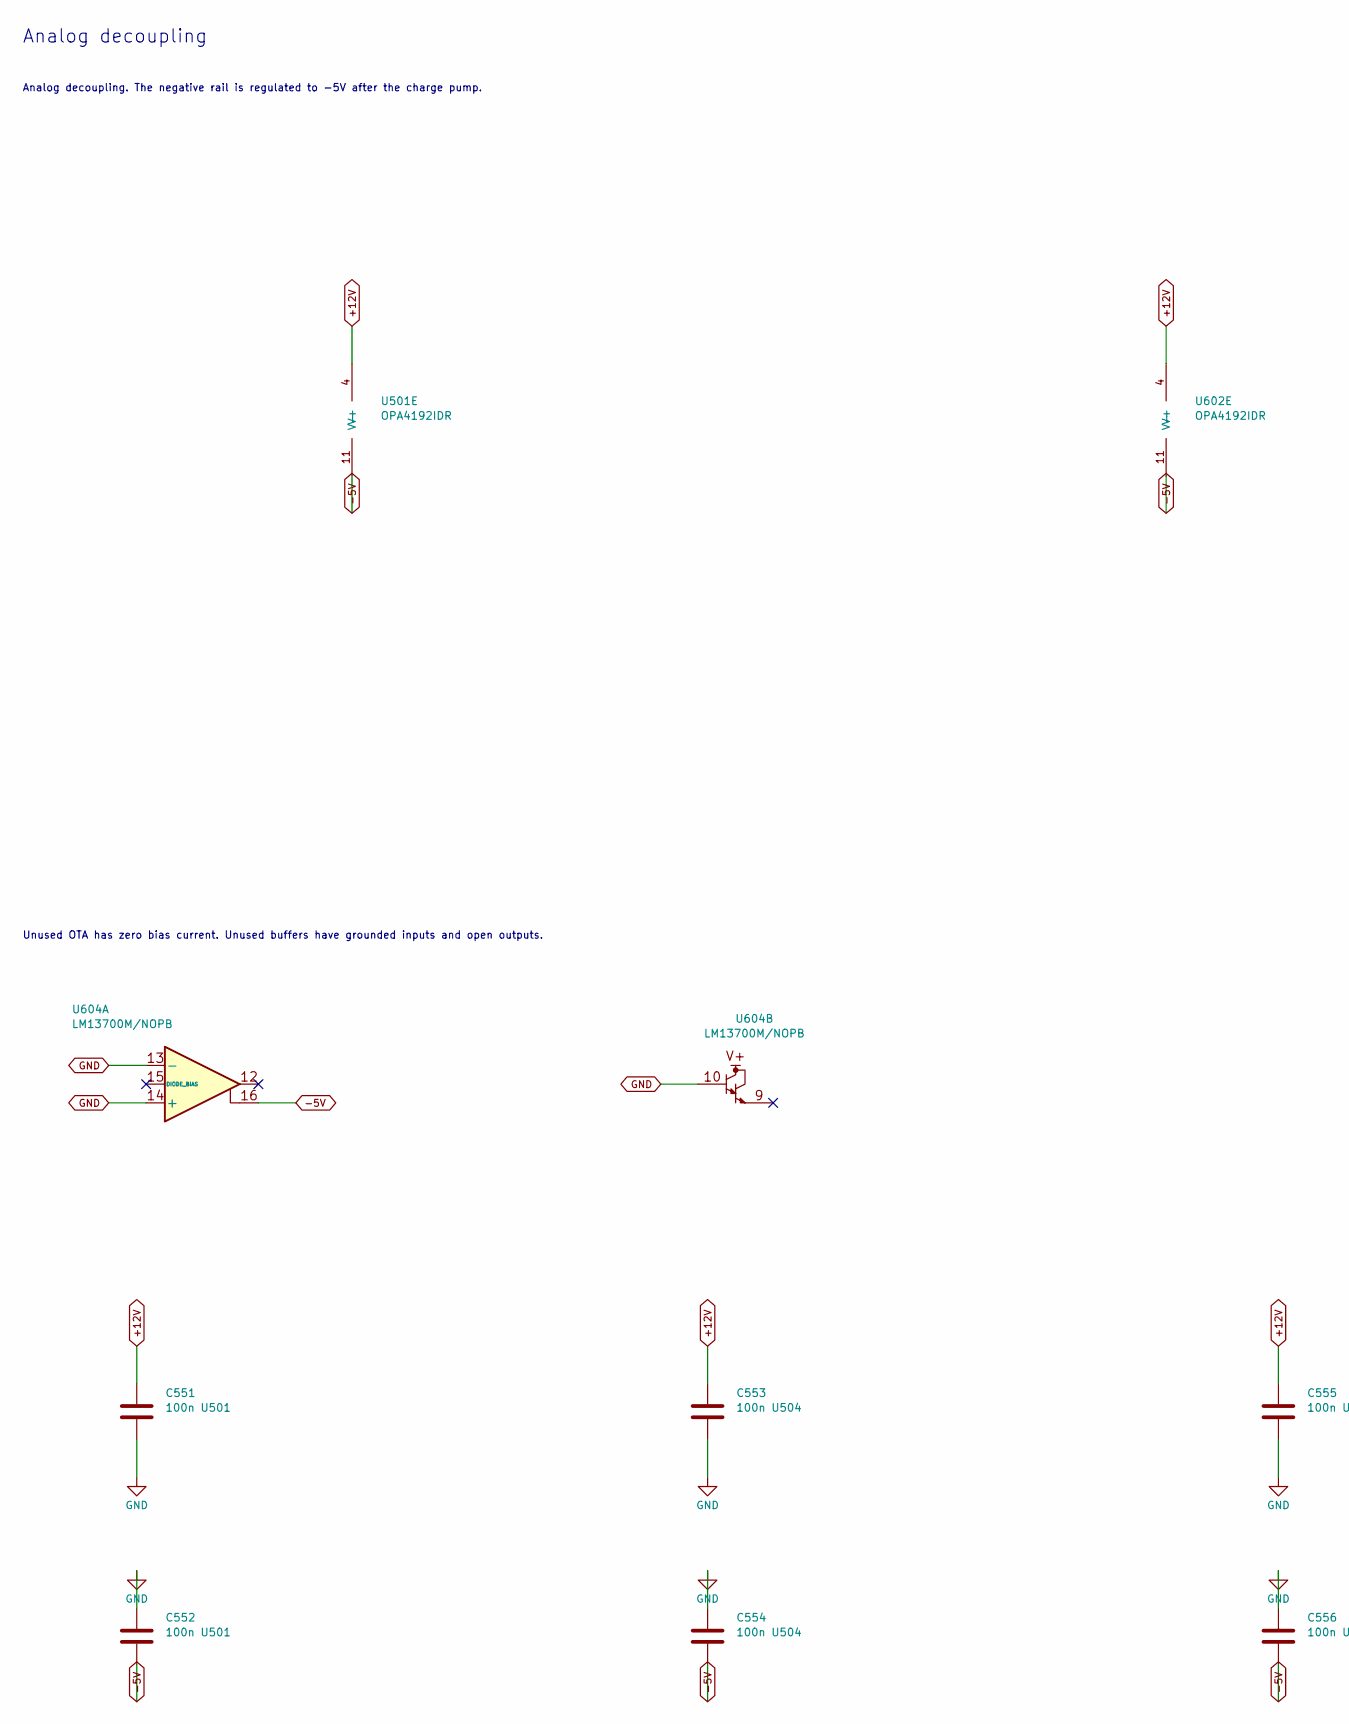
[picture p78: schematic 14_analog_power.kicad_sch, Analog decoupling, part in row 1, column 1]

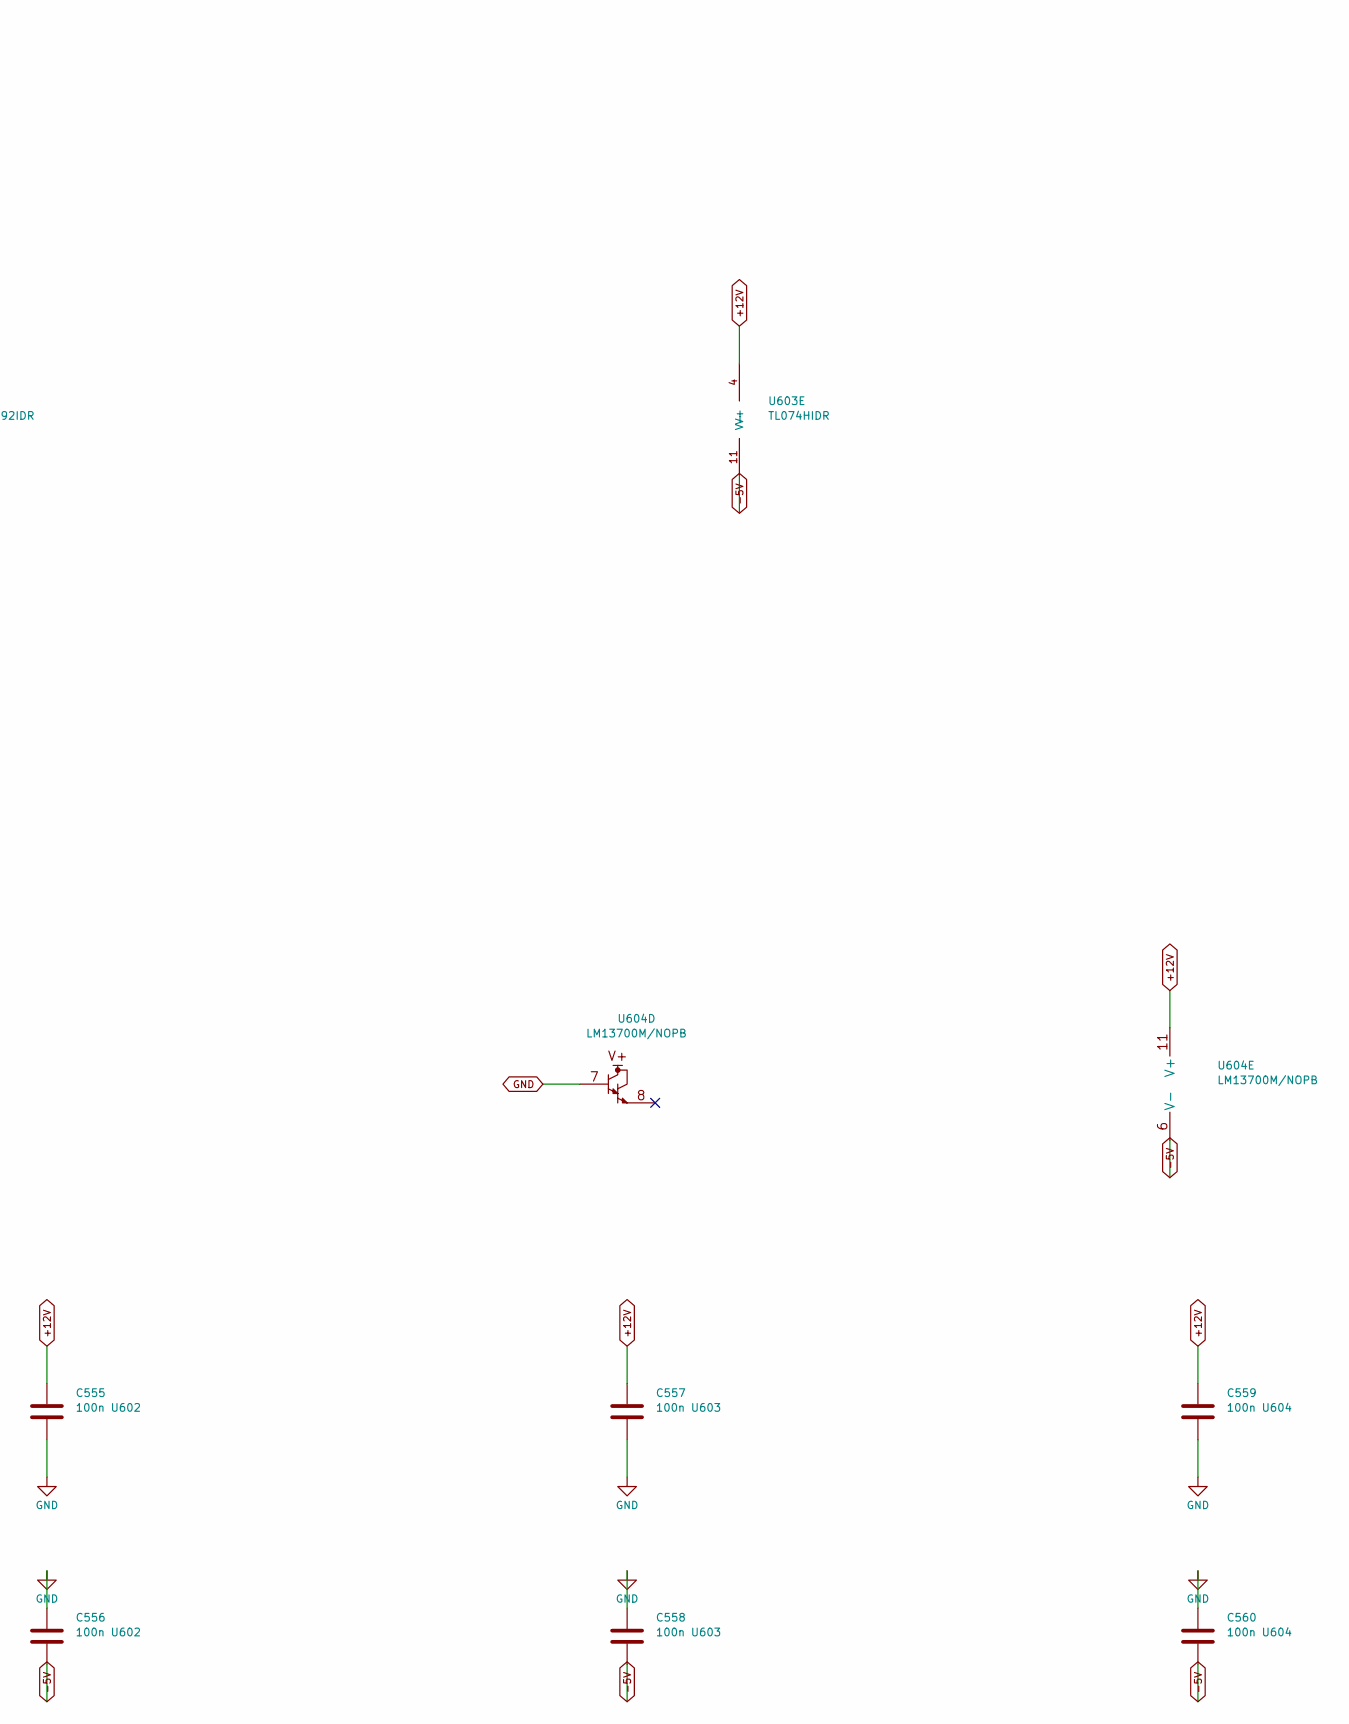
[picture p79: schematic 14_analog_power.kicad_sch, Analog decoupling, part in row 1, column 2]

Parts:
C551, C552: 100n U501; C_0805_2012Metric
C553, C554: 100n U504; C_0805_2012Metric
C555, C556: 100n U602; C_0805_2012Metric
C557, C558: 100n U603; C_0805_2012Metric
C559, C560: 100n U604; C_0805_2012Metric
U501, U602: OPA4192IDR; SOIC-14_3.9x8.7mm_P1.27mm; MPN OPA4192IDR
U603: TL074HIDR; SOIC-14_3.9x8.7mm_P1.27mm; MPN TL074HIDR
U604: LM13700M/NOPB; SOIC-16_3.9x9.9mm_P1.27mm; MPN LM13700M/NOPB

Connections:
+12V: C551.1, C553.1, C555.1, C557.1, C559.1, U501.4 (V+), U602.4 (V+), U603.4 (V+), U604.11 (V+); also elsewhere on the board
-5V: C552.2, C554.2, C556.2, C558.2, C560.2, U501.11 (V-), U602.11 (V-), U603.11 (V-), U604.6 (V-), U604.16; also elsewhere on the board

Notes on the sheet:
Analog decoupling
Analog decoupling. The negative rail is regulated to -5V after the charge pump.
Unused OTA has zero bias current. Unused buffers have grounded inputs and open outputs.

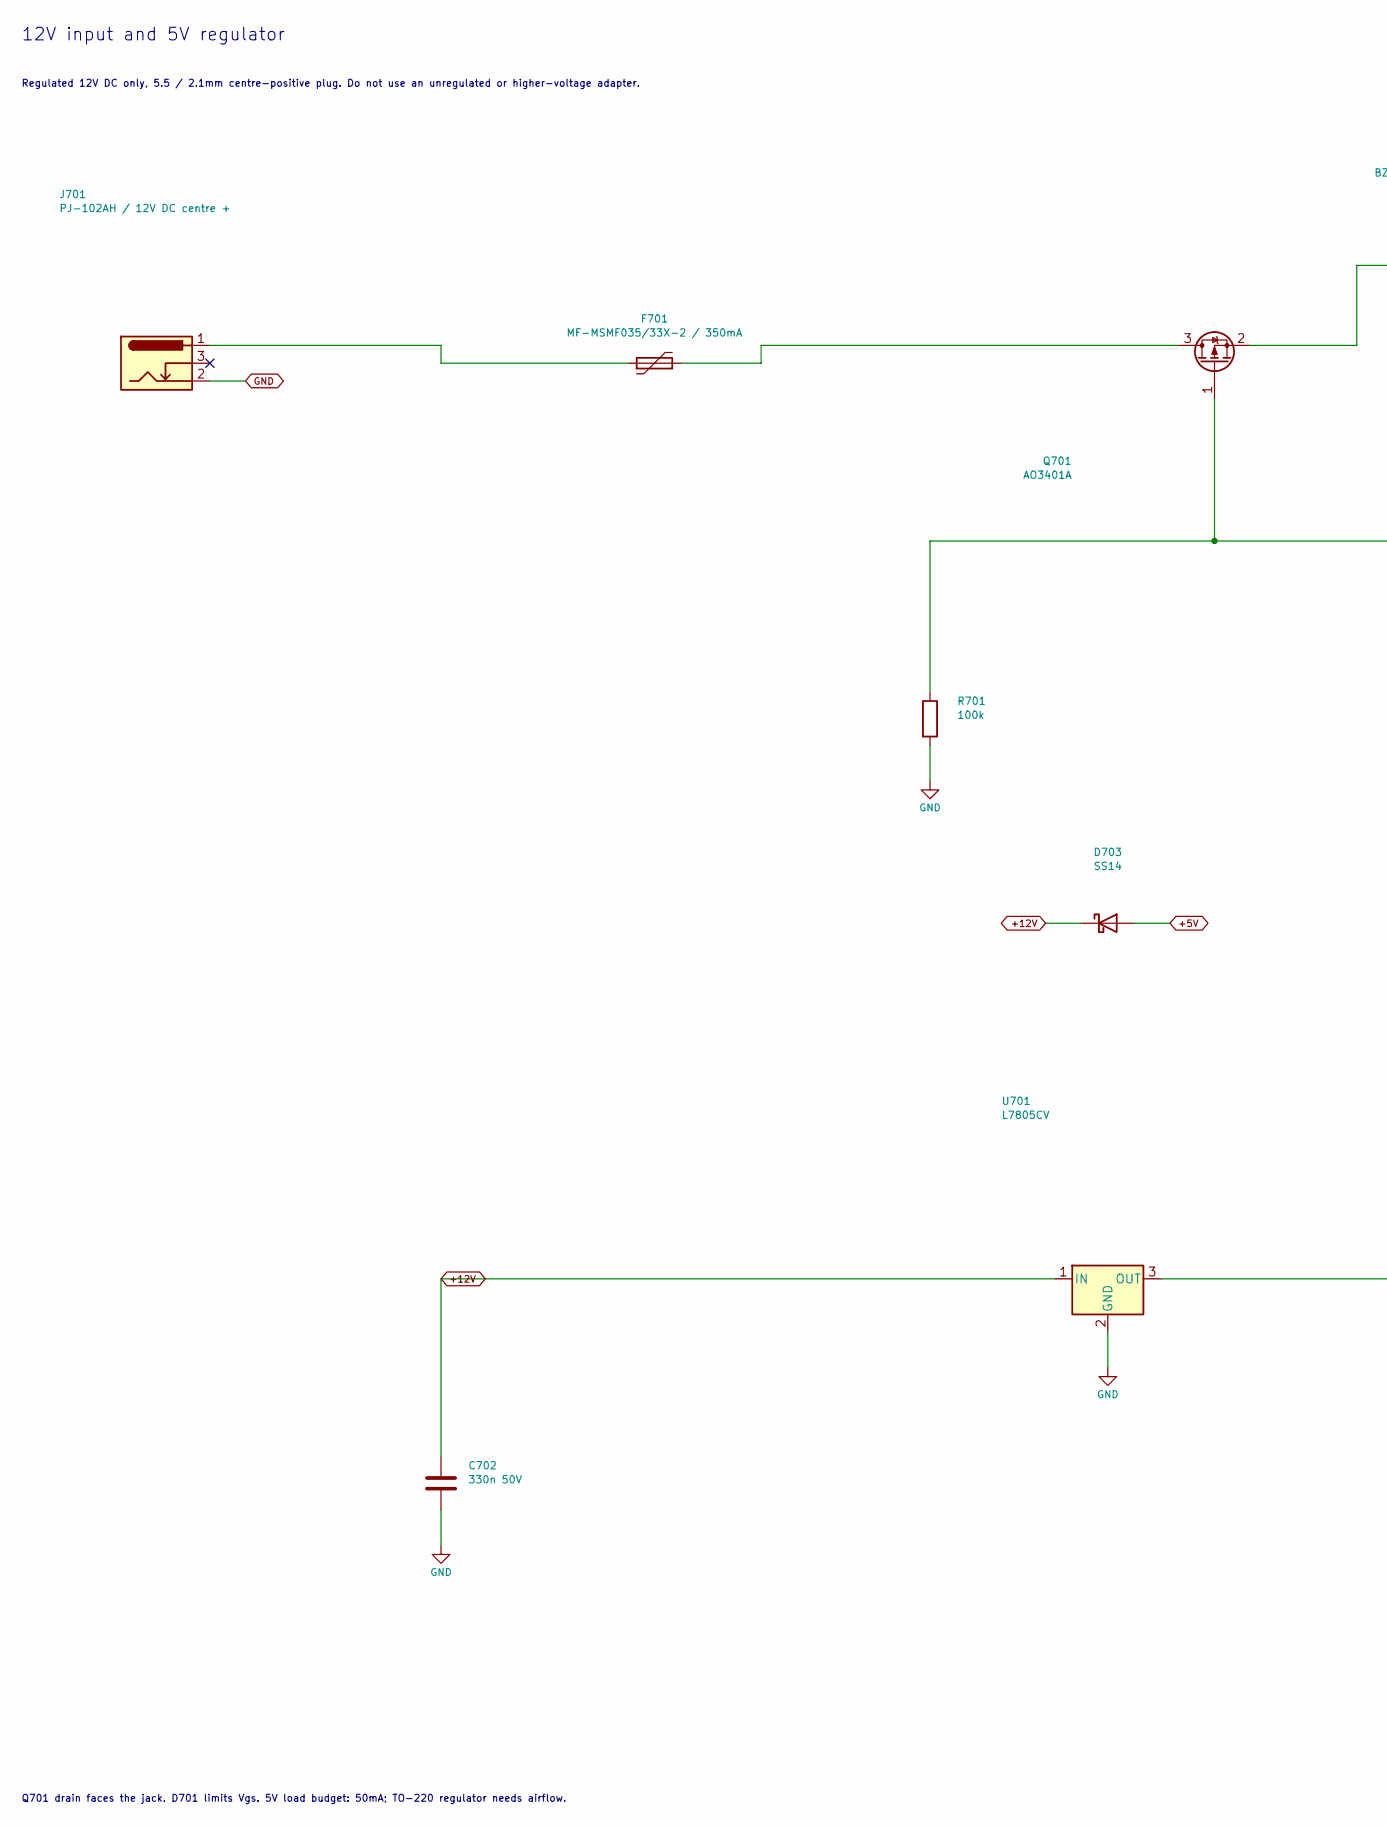
[picture p80: schematic 15_input_power.kicad_sch, 12V input and 5V regulator, part in row 1, column 1]

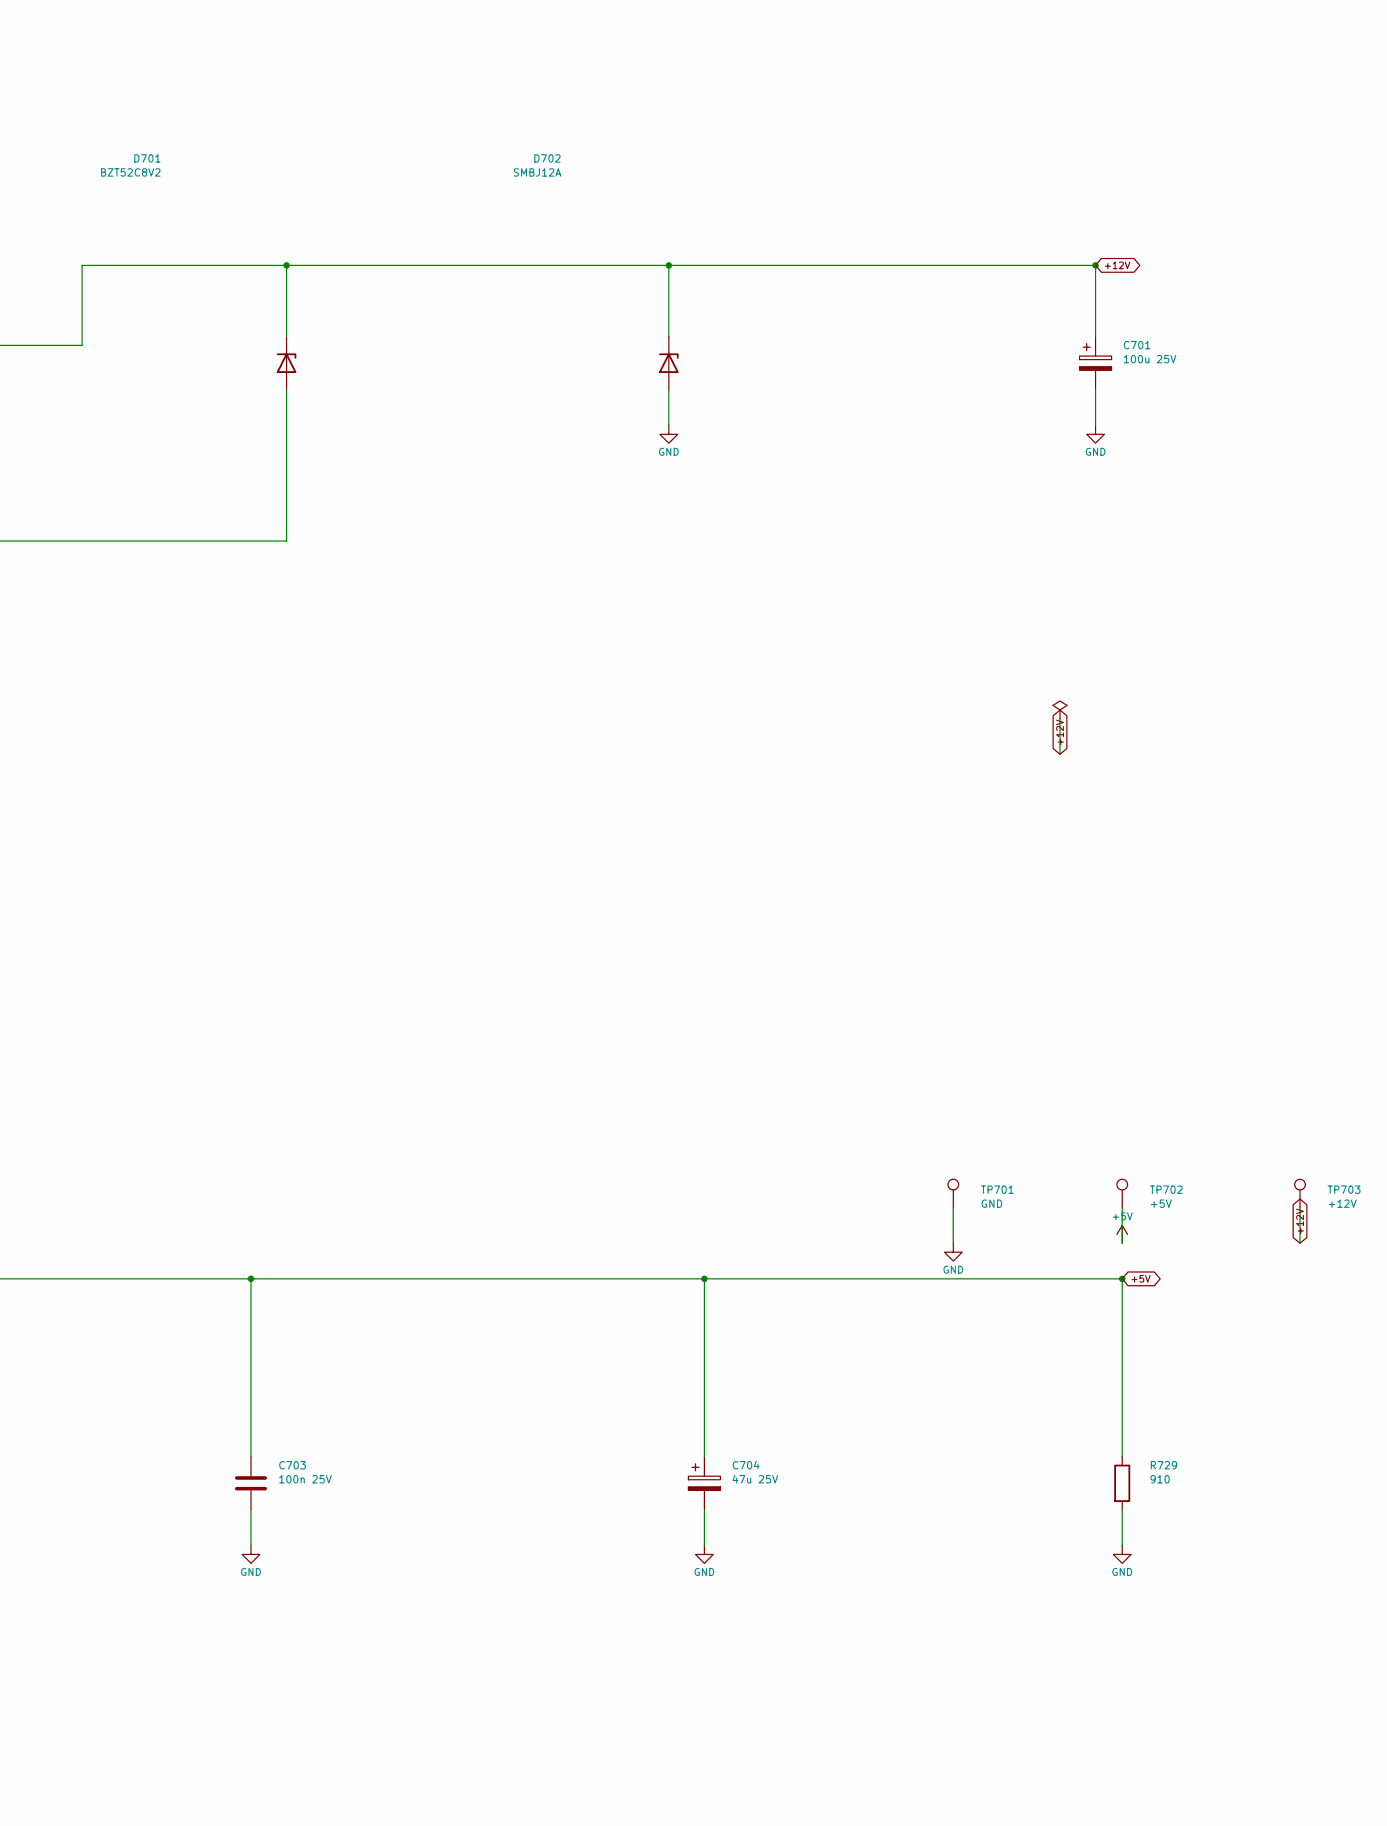
[picture p81: schematic 15_input_power.kicad_sch, 12V input and 5V regulator, part in row 1, column 2]

Parts:
C701: 100u 25V; CP_Radial_D6.3mm_P2.50mm; MPN EEU-FC1E101S
C702: 330n 50V; C_0805_2012Metric
C703: 100n 25V; C_0805_2012Metric
C704: 47u 25V; CP_Radial_D5.0mm_P2.00mm; MPN 25YXJ47M5X11
D701: BZT52C8V2; D_SOD-123; MPN BZT52-C8V2J
D702: SMBJ12A; D_SMB; MPN SMBJ12A
D703: SS14; D_SMA; MPN SS14-E3/61T
F701: MF-MSMF035/33X-2 / 350mA; Fuse_1812_4532Metric; MPN MF-MSMF035/33X-2
J701: PJ-102AH / 12V DC centre +; BarrelJack_PJ102AH_Rear; MPN PJ-102AH
Q701: AO3401A; SOT-23; MPN AO3401A
R701: 100k; R_0805_2012Metric
R729: 910; R_0805_2012Metric
TP701: GND; TestPoint_THTPad_D1.5mm_Drill0.7mm
TP702: +5V; TestPoint_THTPad_D1.5mm_Drill0.7mm
TP703: +12V; TestPoint_THTPad_D1.5mm_Drill0.7mm
U701: L7805CV; TO-220-3_Vertical; MPN L7805CV

Connections:
+5V: C703.1, C704.1, D703.2 (A), R729.1, TP702.1, U701.3 (OUT); also elsewhere on the board
+12V: C701.1, C702.1, D701.1 (K), D702.1 (K), D703.1 (K), Q701.2 (S), TP703.1, U701.1 (IN); also elsewhere on the board
unnamed: D701.2 (A), Q701.1 (G), R701.1
unnamed: F701.1, J701.1
unnamed: F701.2, Q701.3 (D)

Notes on the sheet:
12V input and 5V regulator
Regulated 12V DC only, 5.5 / 2.1mm centre-positive plug. Do not use an unregulated or higher-voltage adapter.
Q701 drain faces the jack. D701 limits Vgs. 5V load budget: 50mA; TO-220 regulator needs airflow.
