EwoudVV/arpeggiator/arpeggiator.kicad_pcb

## KiCad design arpeggiator.kicad_pcb (continued)

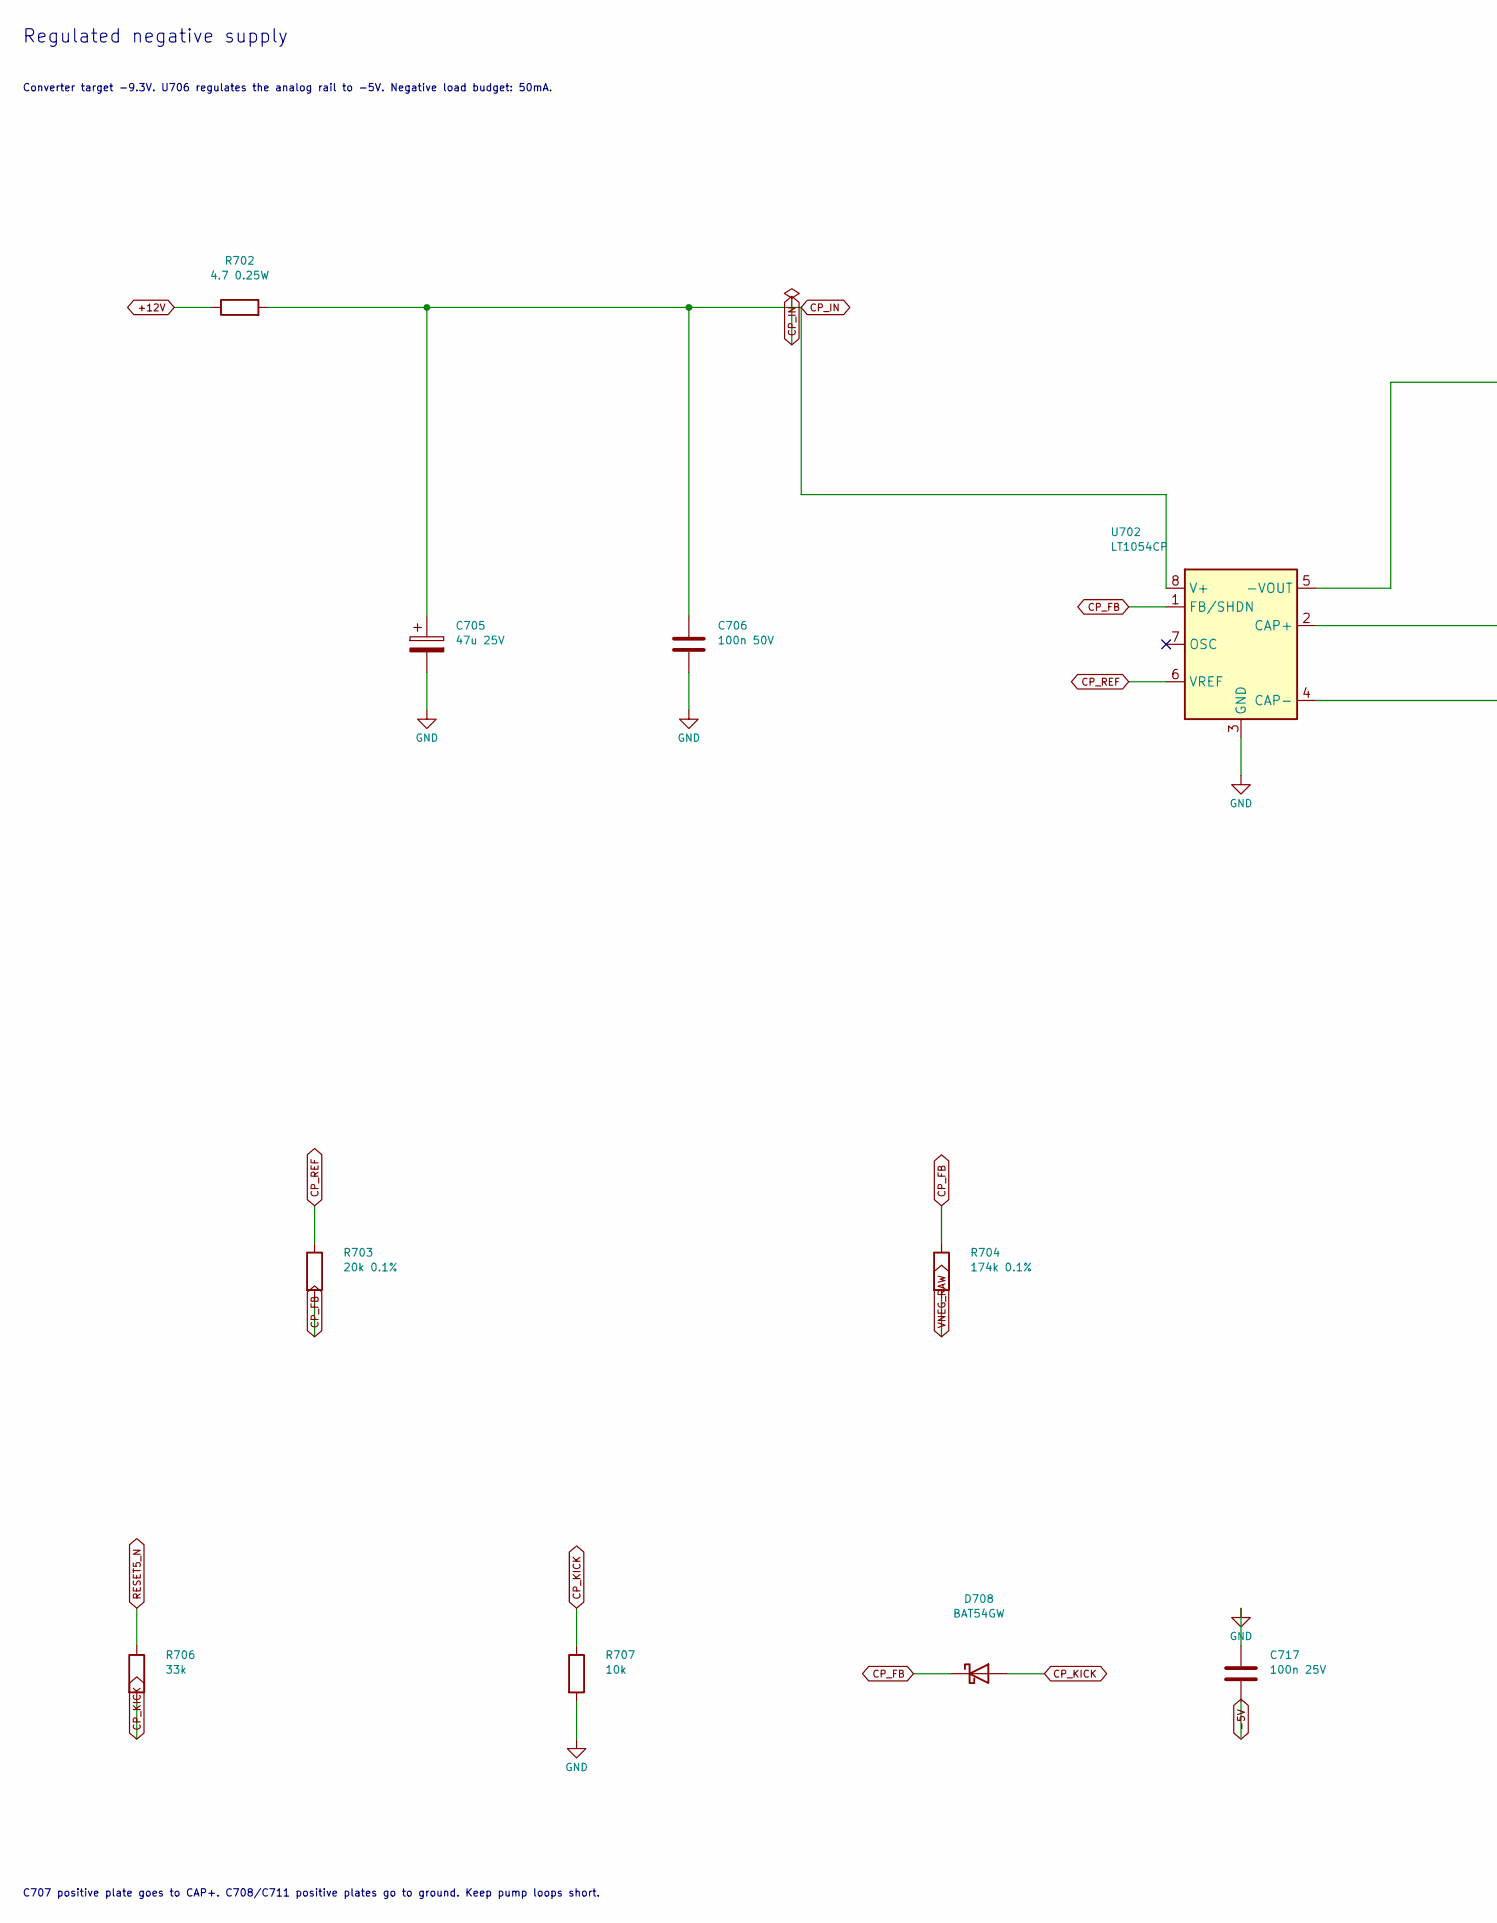
[picture p82: schematic 16_negative_supply.kicad_sch, Regulated negative supply, part in row 1, column 1]

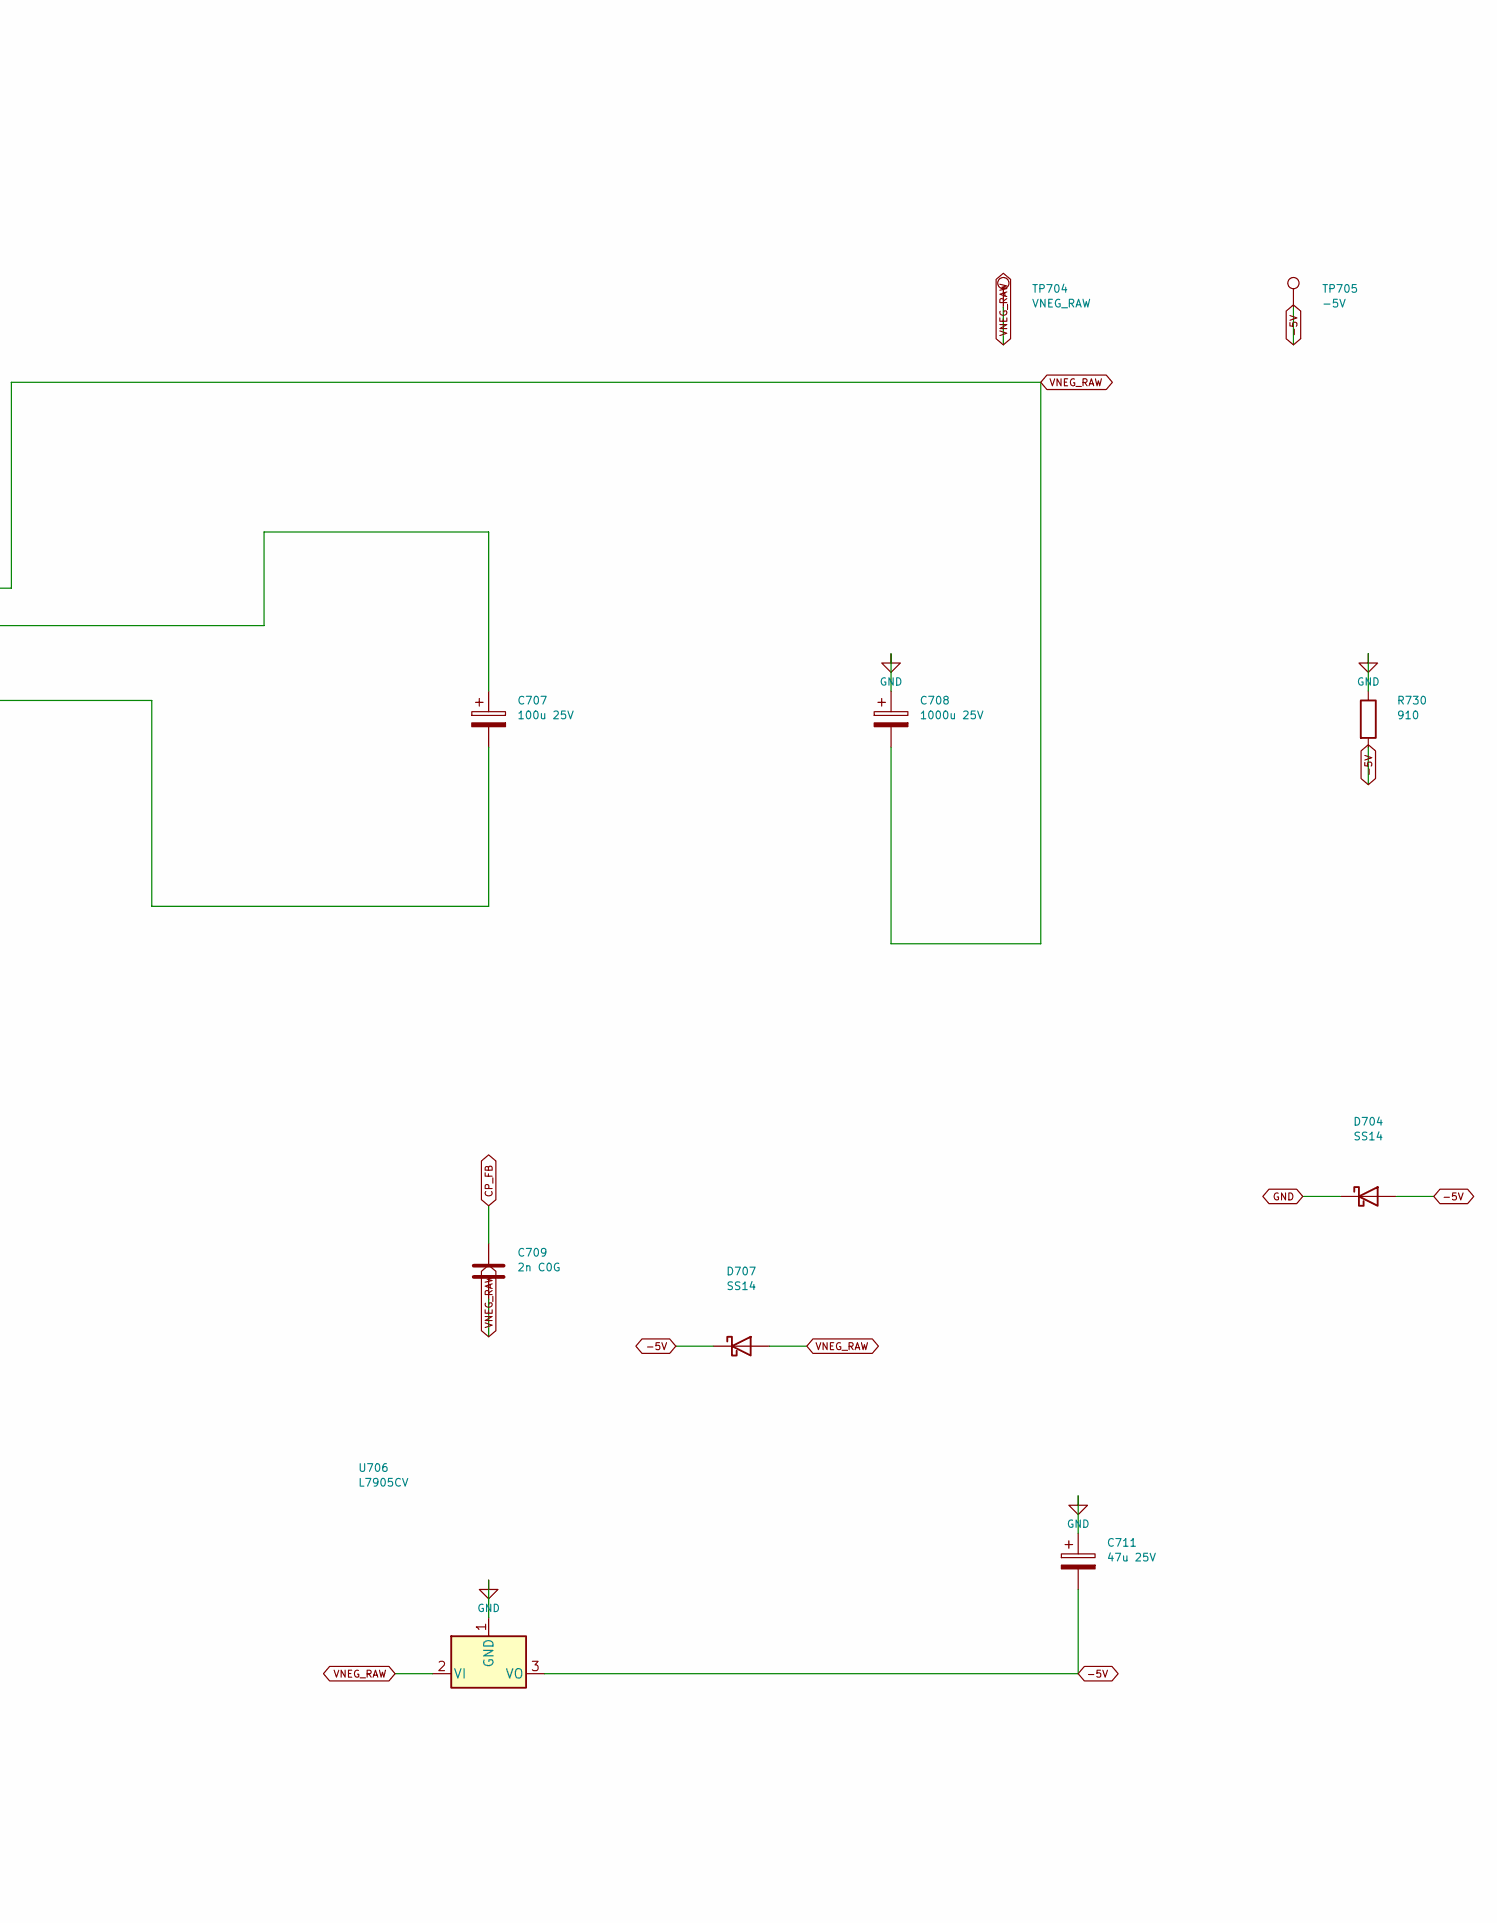
[picture p83: schematic 16_negative_supply.kicad_sch, Regulated negative supply, part in row 1, column 2]

Parts:
C705, C711: 47u 25V; CP_Radial_D5.0mm_P2.00mm; MPN 25YXJ47M5X11
C706: 100n 50V; C_0805_2012Metric
C707: 100u 25V; CP_Radial_D6.3mm_P2.50mm; MPN EEU-FC1E101S
C708: 1000u 25V; CP_Radial_D10.0mm_P5.00mm; MPN EEU-FR1E102
C709: 2n C0G; C_0805_2012Metric
C717: 100n 25V; C_0805_2012Metric
D704, D707: SS14; D_SMA; MPN SS14-E3/61T
D708: BAT54GW; D_SOD-123; MPN BAT54GWX
R702: 4.7 0.25W; R_1206_3216Metric
R703: 20k 0.1%; R_0805_2012Metric
R704: 174k 0.1%; R_0805_2012Metric
R706: 33k; R_0805_2012Metric
R707: 10k; R_0805_2012Metric
R730: 910; R_0805_2012Metric
TP704: VNEG_RAW; TestPoint_THTPad_D1.5mm_Drill0.7mm
TP705: -5V; TestPoint_THTPad_D1.5mm_Drill0.7mm
U702: LT1054CP; DIP-8_W7.62mm; MPN LT1054CP
U706: L7905CV; TO-220-3_Vertical; MPN L7905CV

Connections:
+12V: R702.1; also elsewhere on the board
-5V: C711.2, C717.2, D704.2 (A), D707.1 (K), R730.2, TP705.1, U706.3 (VO); also elsewhere on the board
CP_FB: C709.1, D708.1 (K), R703.2, R704.1, U702.1 (FB/SHDN)
CP_IN: C705.1, C706.1, R702.2, U702.8 (V+)
CP_KICK: D708.2 (A), R706.2, R707.1
CP_REF: R703.1, U702.6 (VREF)
unnamed: C707.1, U702.2 (CAP+)
unnamed: C707.2, U702.4 (CAP-)
RESET5_N: R706.1; also elsewhere on the board
VNEG_RAW: C708.2, C709.2, D707.2 (A), R704.2, TP704.1, U702.5 (-VOUT), U706.2 (VI)

Notes on the sheet:
Regulated negative supply
Converter target -9.3V. U706 regulates the analog rail to -5V. Negative load budget: 50mA.
C707 positive plate goes to CAP+. C708/C711 positive plates go to ground. Keep pump loops short.

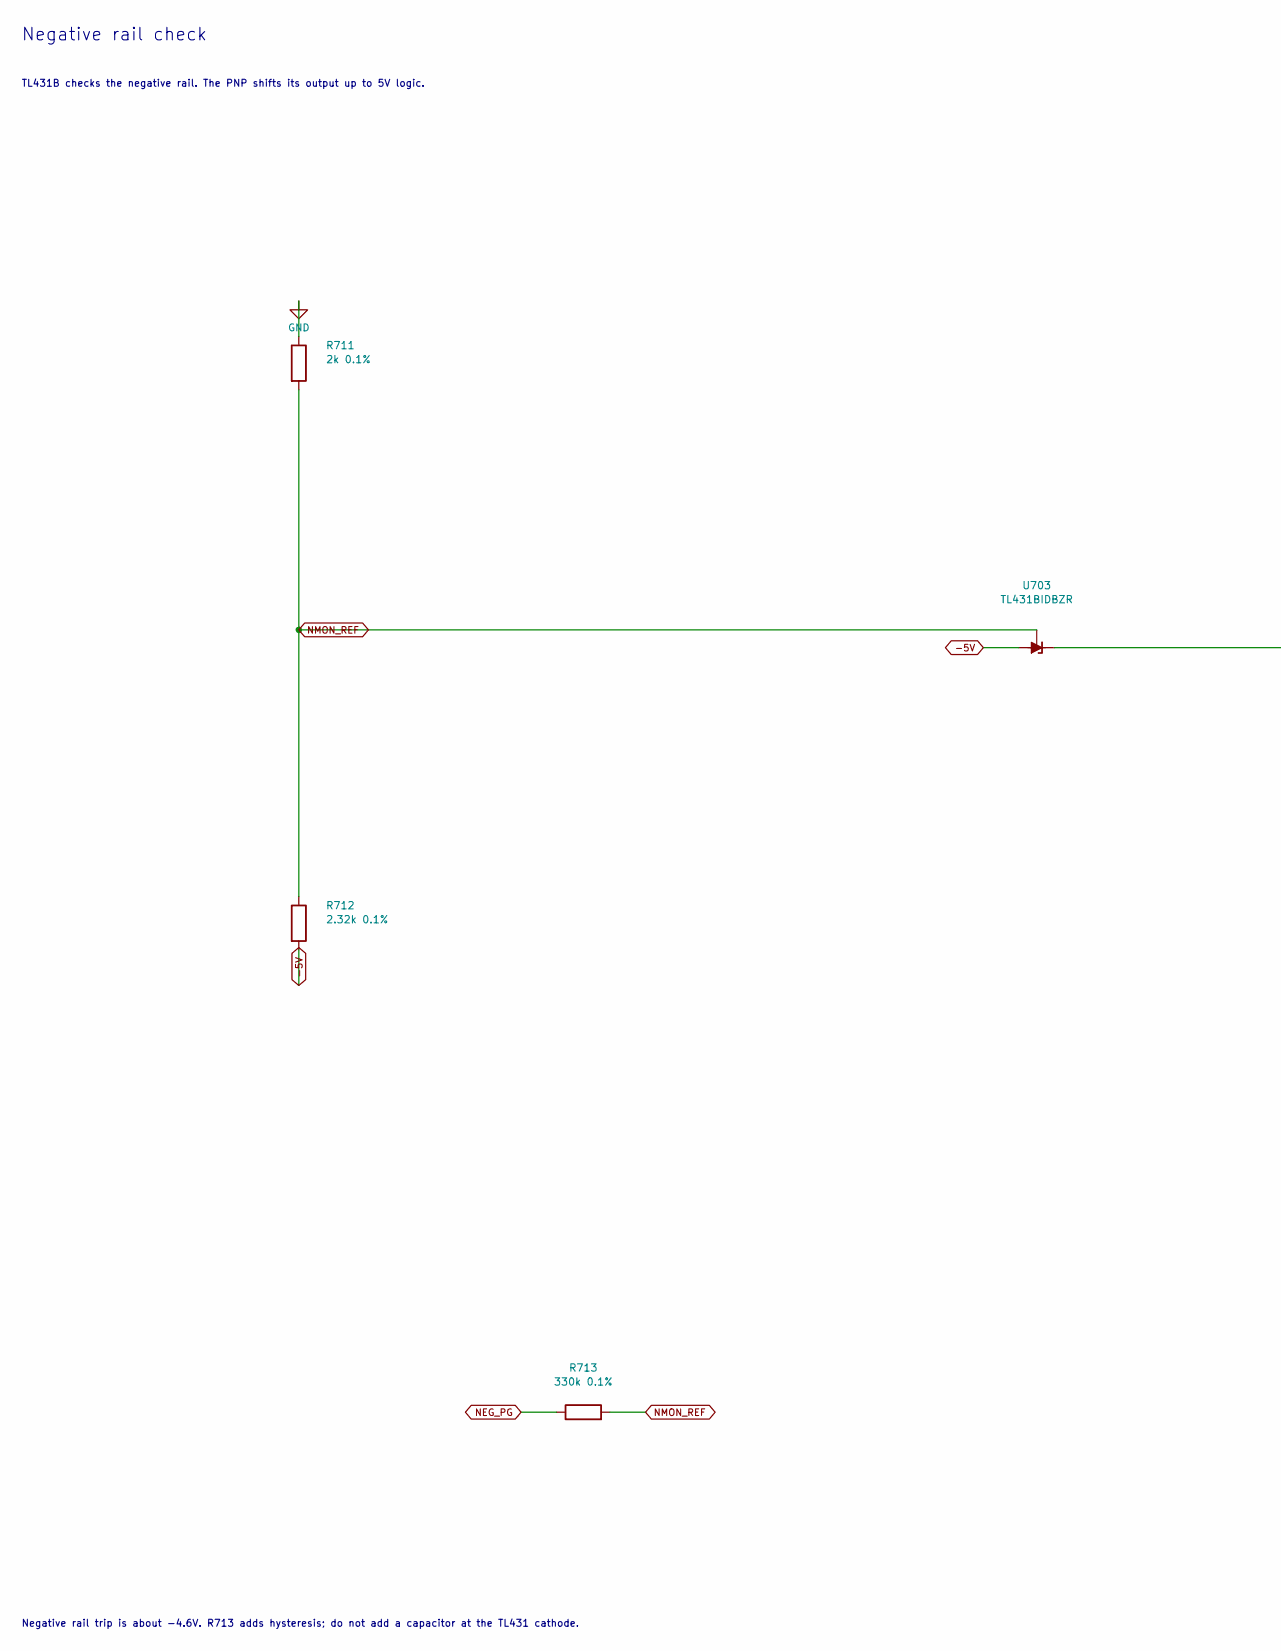
[picture p84: schematic 17_negative_monitor.kicad_sch, Negative rail check, part in row 1, column 1]

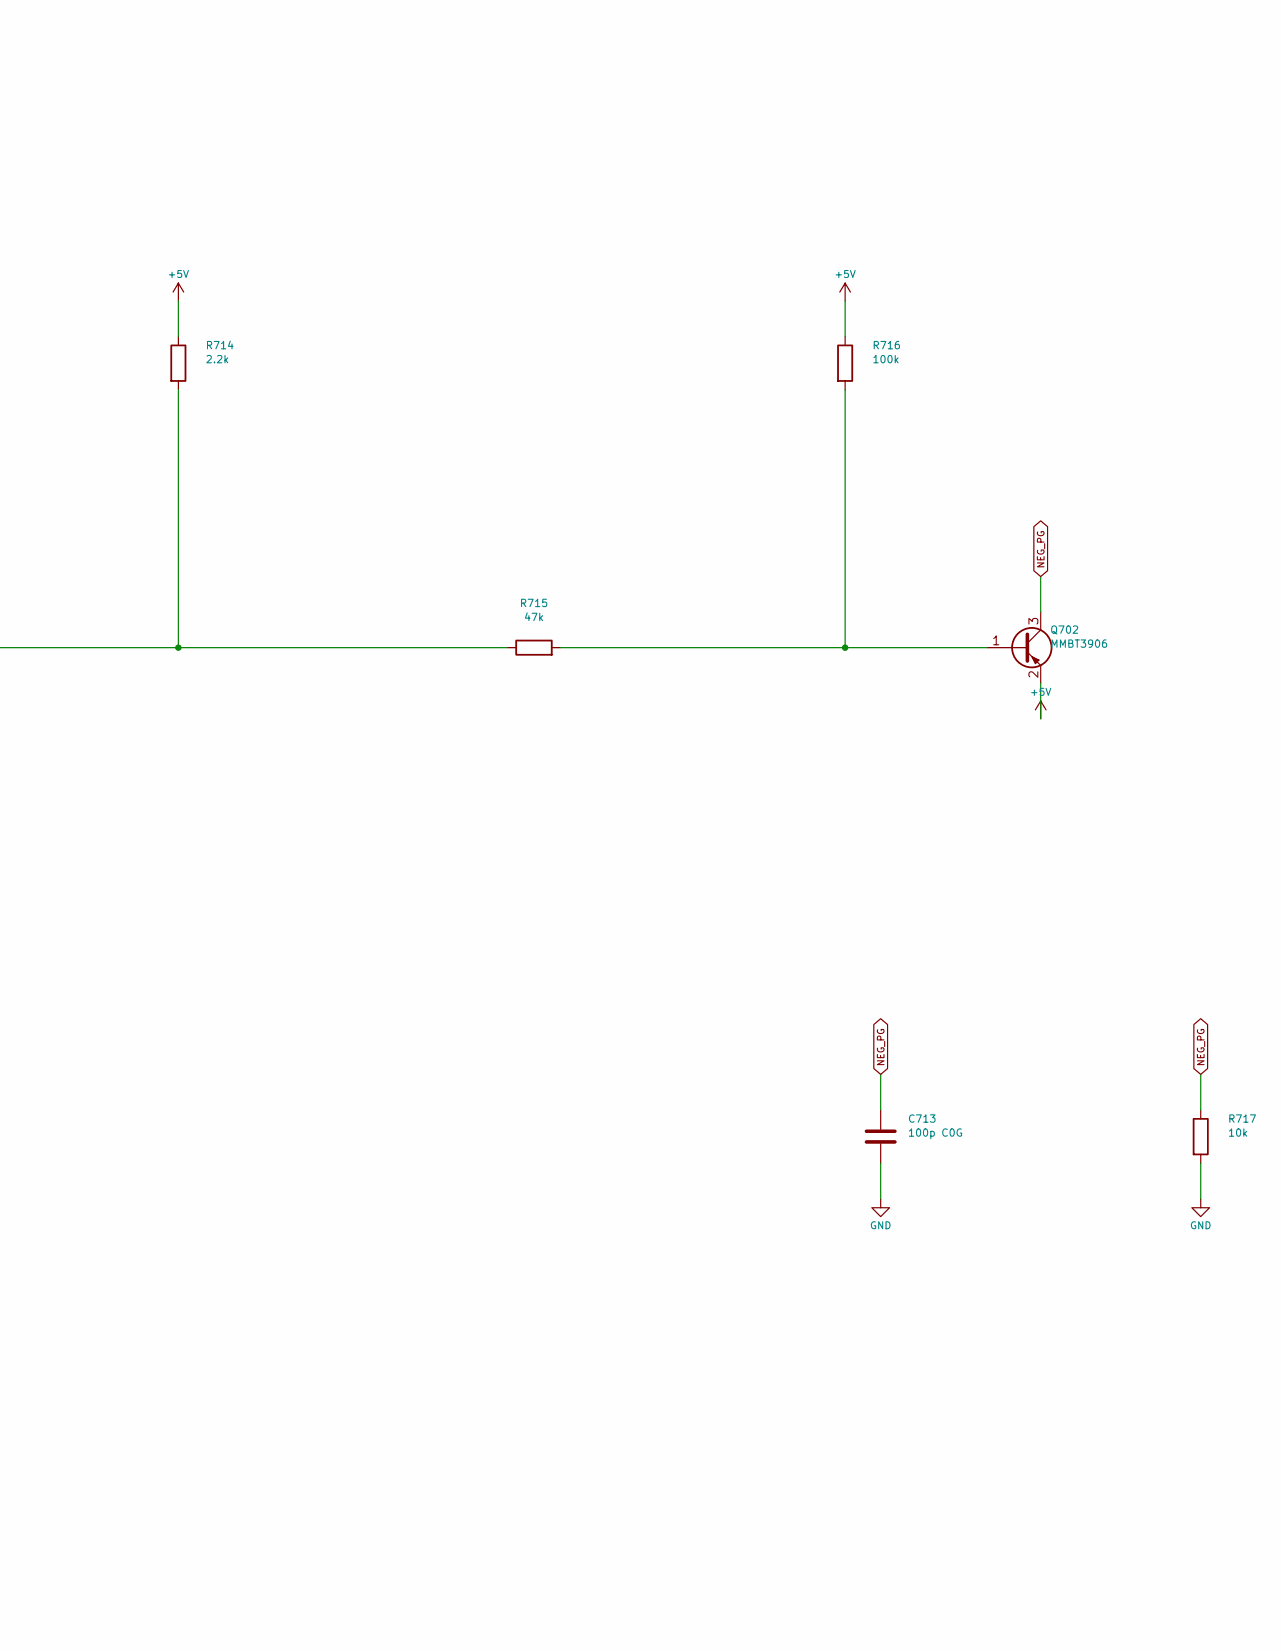
[picture p85: schematic 17_negative_monitor.kicad_sch, Negative rail check, part in row 1, column 2]

Parts:
C713: 100p C0G; C_0805_2012Metric
Q702: MMBT3906; SOT-23; MPN MMBT3906,215
R711: 2k 0.1%; R_0805_2012Metric
R712: 2.32k 0.1%; R_0805_2012Metric
R713: 330k 0.1%; R_0805_2012Metric
R714: 2.2k; R_0805_2012Metric
R715: 47k; R_0805_2012Metric
R716: 100k; R_0805_2012Metric
R717: 10k; R_0805_2012Metric
U703: TL431BIDBZR; SOT-23; MPN TL431BIDBZR

Connections:
+5V: Q702.2 (E), R714.1, R716.1; also elsewhere on the board
-5V: R712.2, U703.3 (A); also elsewhere on the board
NEG_PG: C713.1, Q702.3 (C), R713.1, R717.1; also elsewhere on the board
NMON_REF: R711.2, R712.1, R713.2, U703.2 (REF)
unnamed: Q702.1 (B), R715.2, R716.2
unnamed: R714.2, R715.1, U703.1 (K)

Notes on the sheet:
Negative rail check
TL431B checks the negative rail. The PNP shifts its output up to 5V logic.
Negative rail trip is about -4.6V. R713 adds hysteresis; do not add a capacitor at the TL431 cathode.

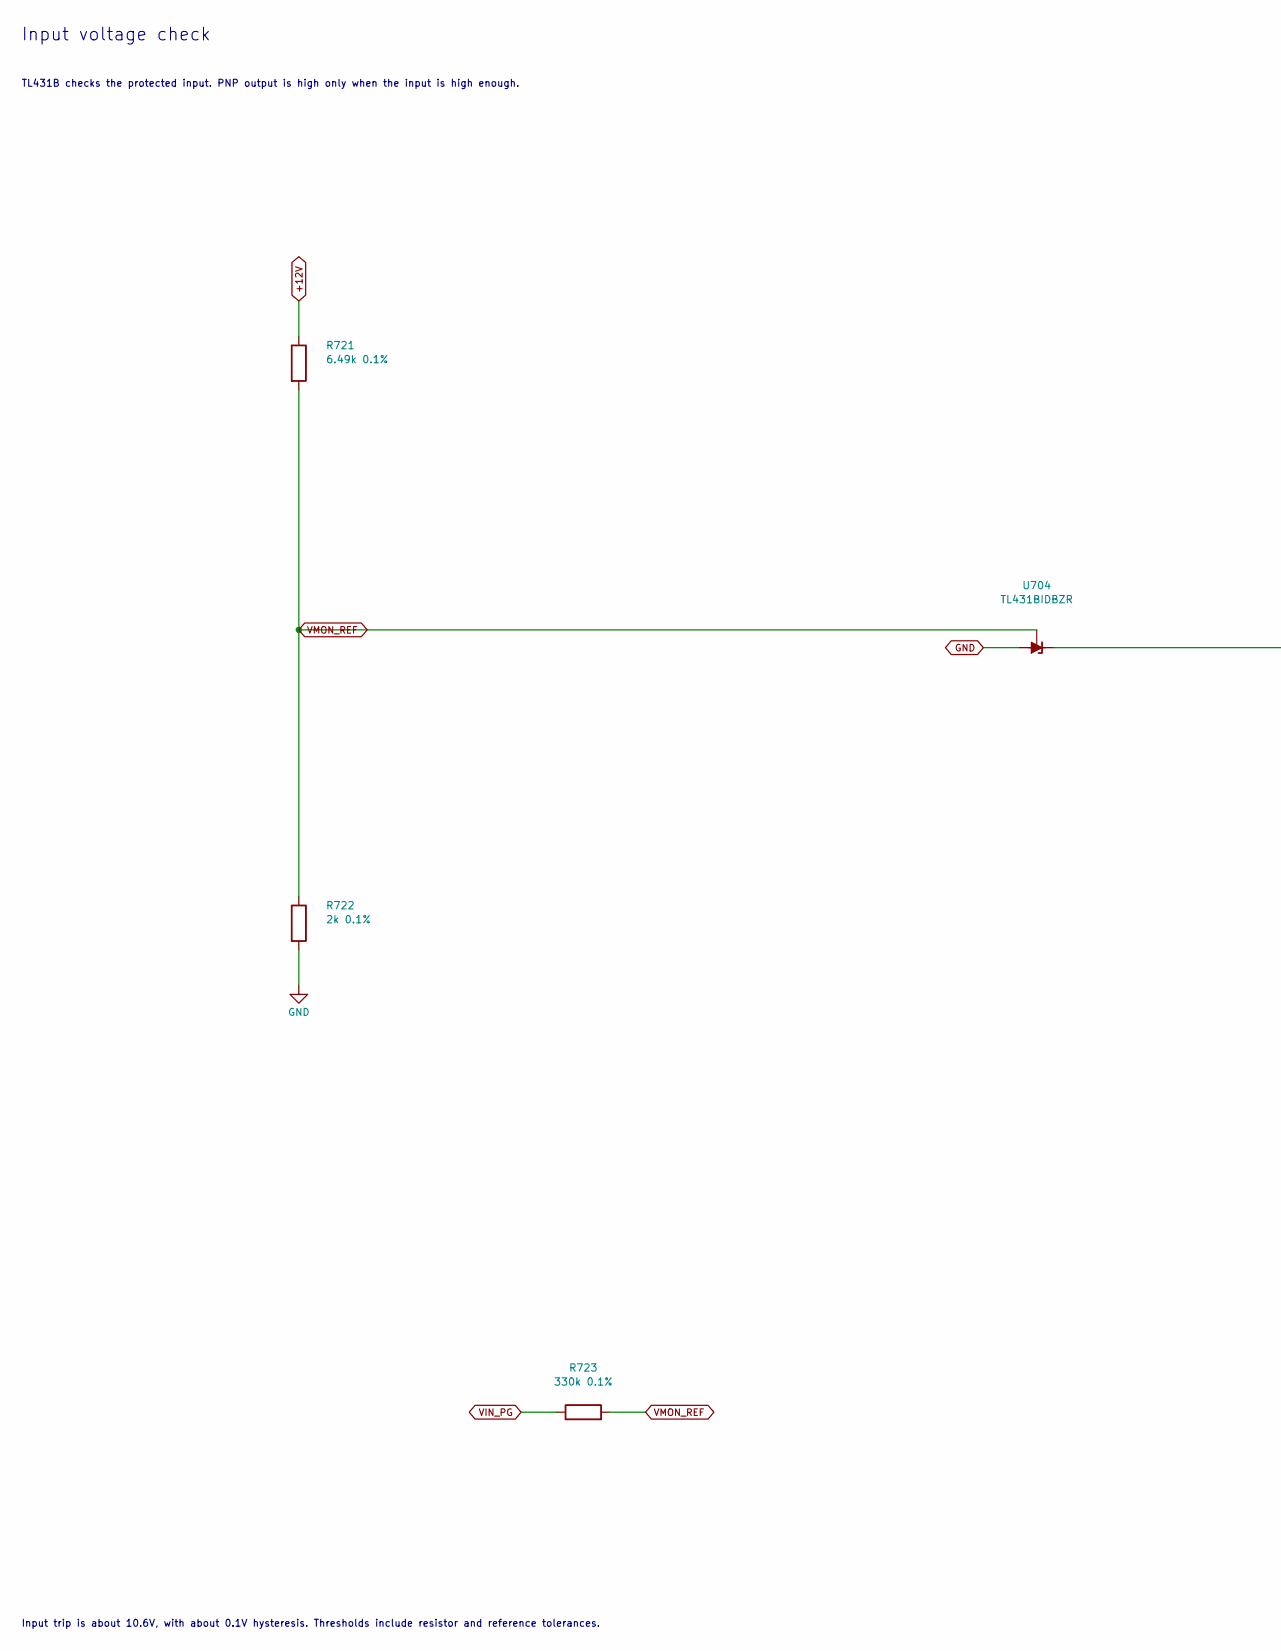
[picture p86: schematic 18_input_monitor.kicad_sch, Input voltage check, part in row 1, column 1]

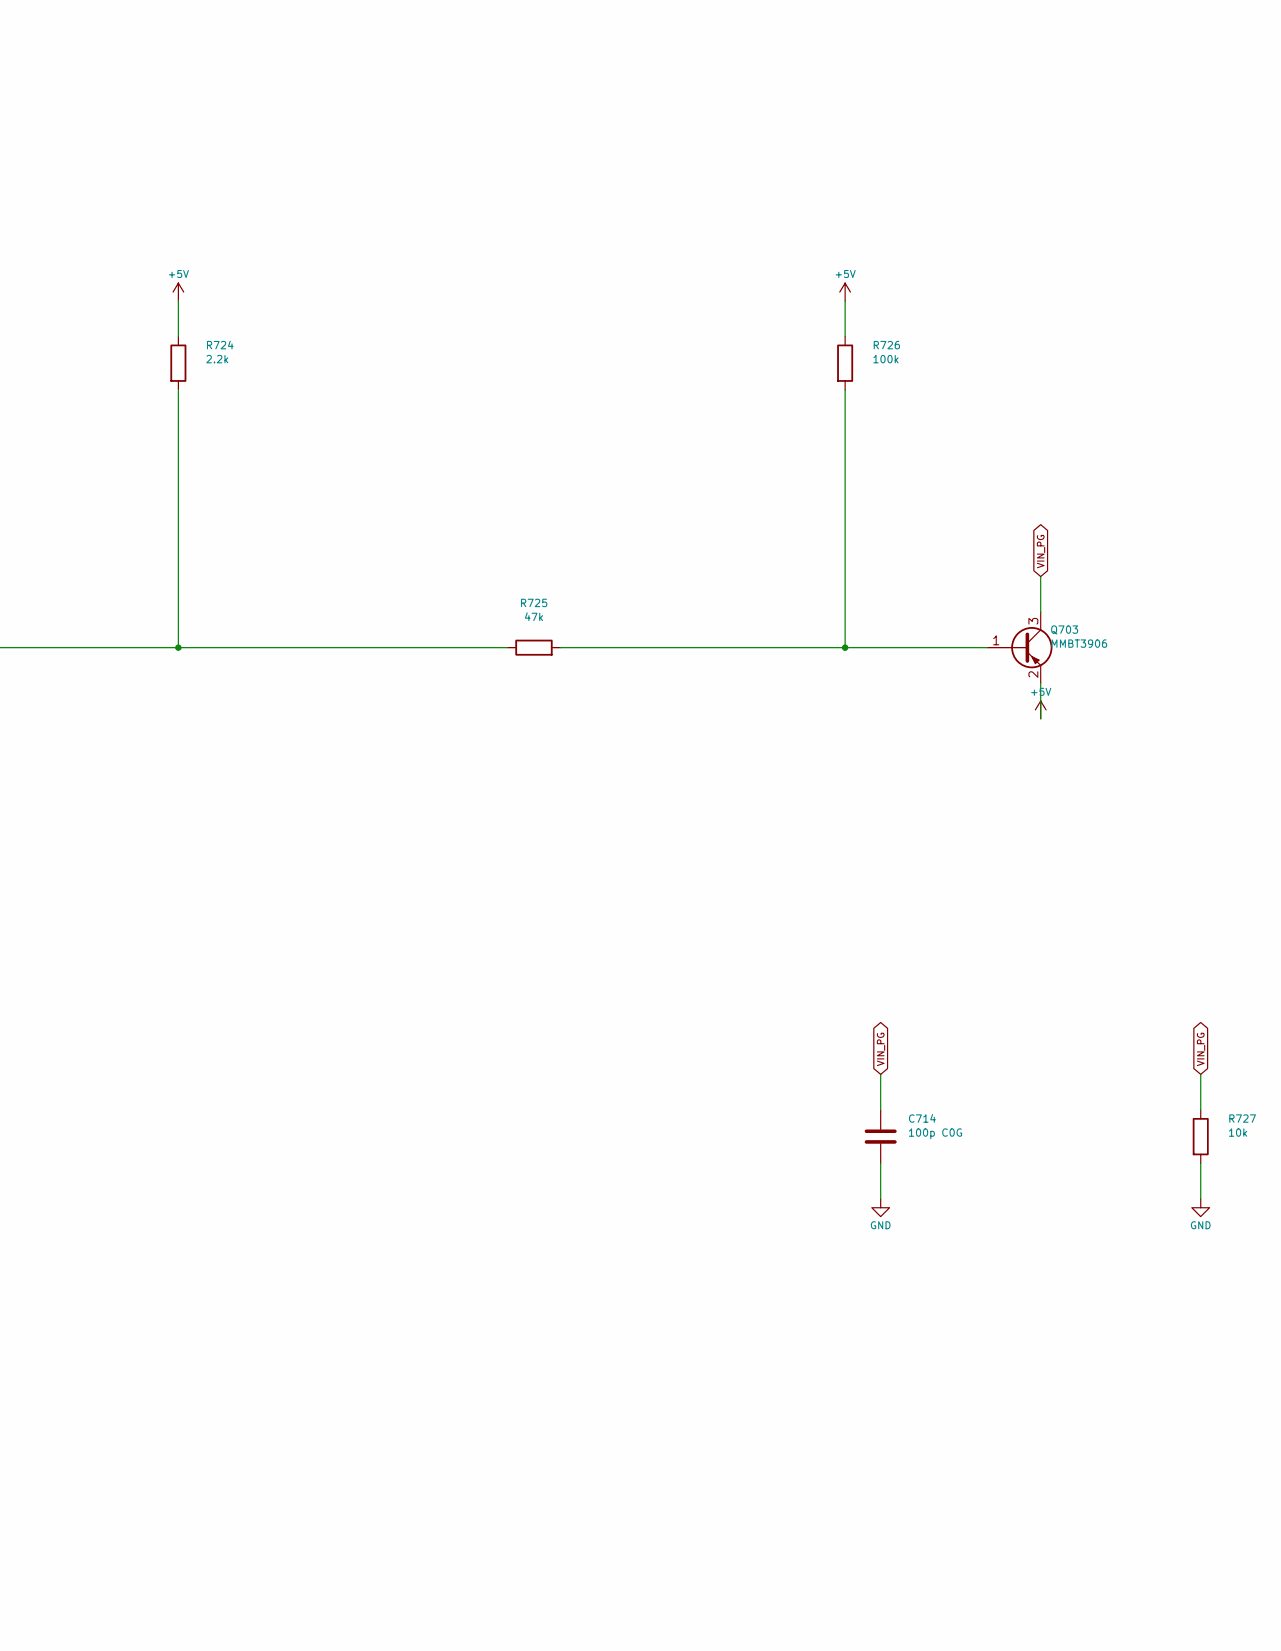
[picture p87: schematic 18_input_monitor.kicad_sch, Input voltage check, part in row 1, column 2]

Parts:
C714: 100p C0G; C_0805_2012Metric
Q703: MMBT3906; SOT-23; MPN MMBT3906,215
R721: 6.49k 0.1%; R_0805_2012Metric
R722: 2k 0.1%; R_0805_2012Metric
R723: 330k 0.1%; R_0805_2012Metric
R724: 2.2k; R_0805_2012Metric
R725: 47k; R_0805_2012Metric
R726: 100k; R_0805_2012Metric
R727: 10k; R_0805_2012Metric
U704: TL431BIDBZR; SOT-23; MPN TL431BIDBZR

Connections:
+5V: Q703.2 (E), R724.1, R726.1; also elsewhere on the board
+12V: R721.1; also elsewhere on the board
unnamed: Q703.1 (B), R725.2, R726.2
unnamed: R724.2, R725.1, U704.1 (K)
VIN_PG: C714.1, Q703.3 (C), R723.1, R727.1; also elsewhere on the board
VMON_REF: R721.2, R722.1, R723.2, U704.2 (REF)

Notes on the sheet:
Input voltage check
TL431B checks the protected input. PNP output is high only when the input is high enough.
Input trip is about 10.6V, with about 0.1V hysteresis. Thresholds include resistor and reference tolerances.

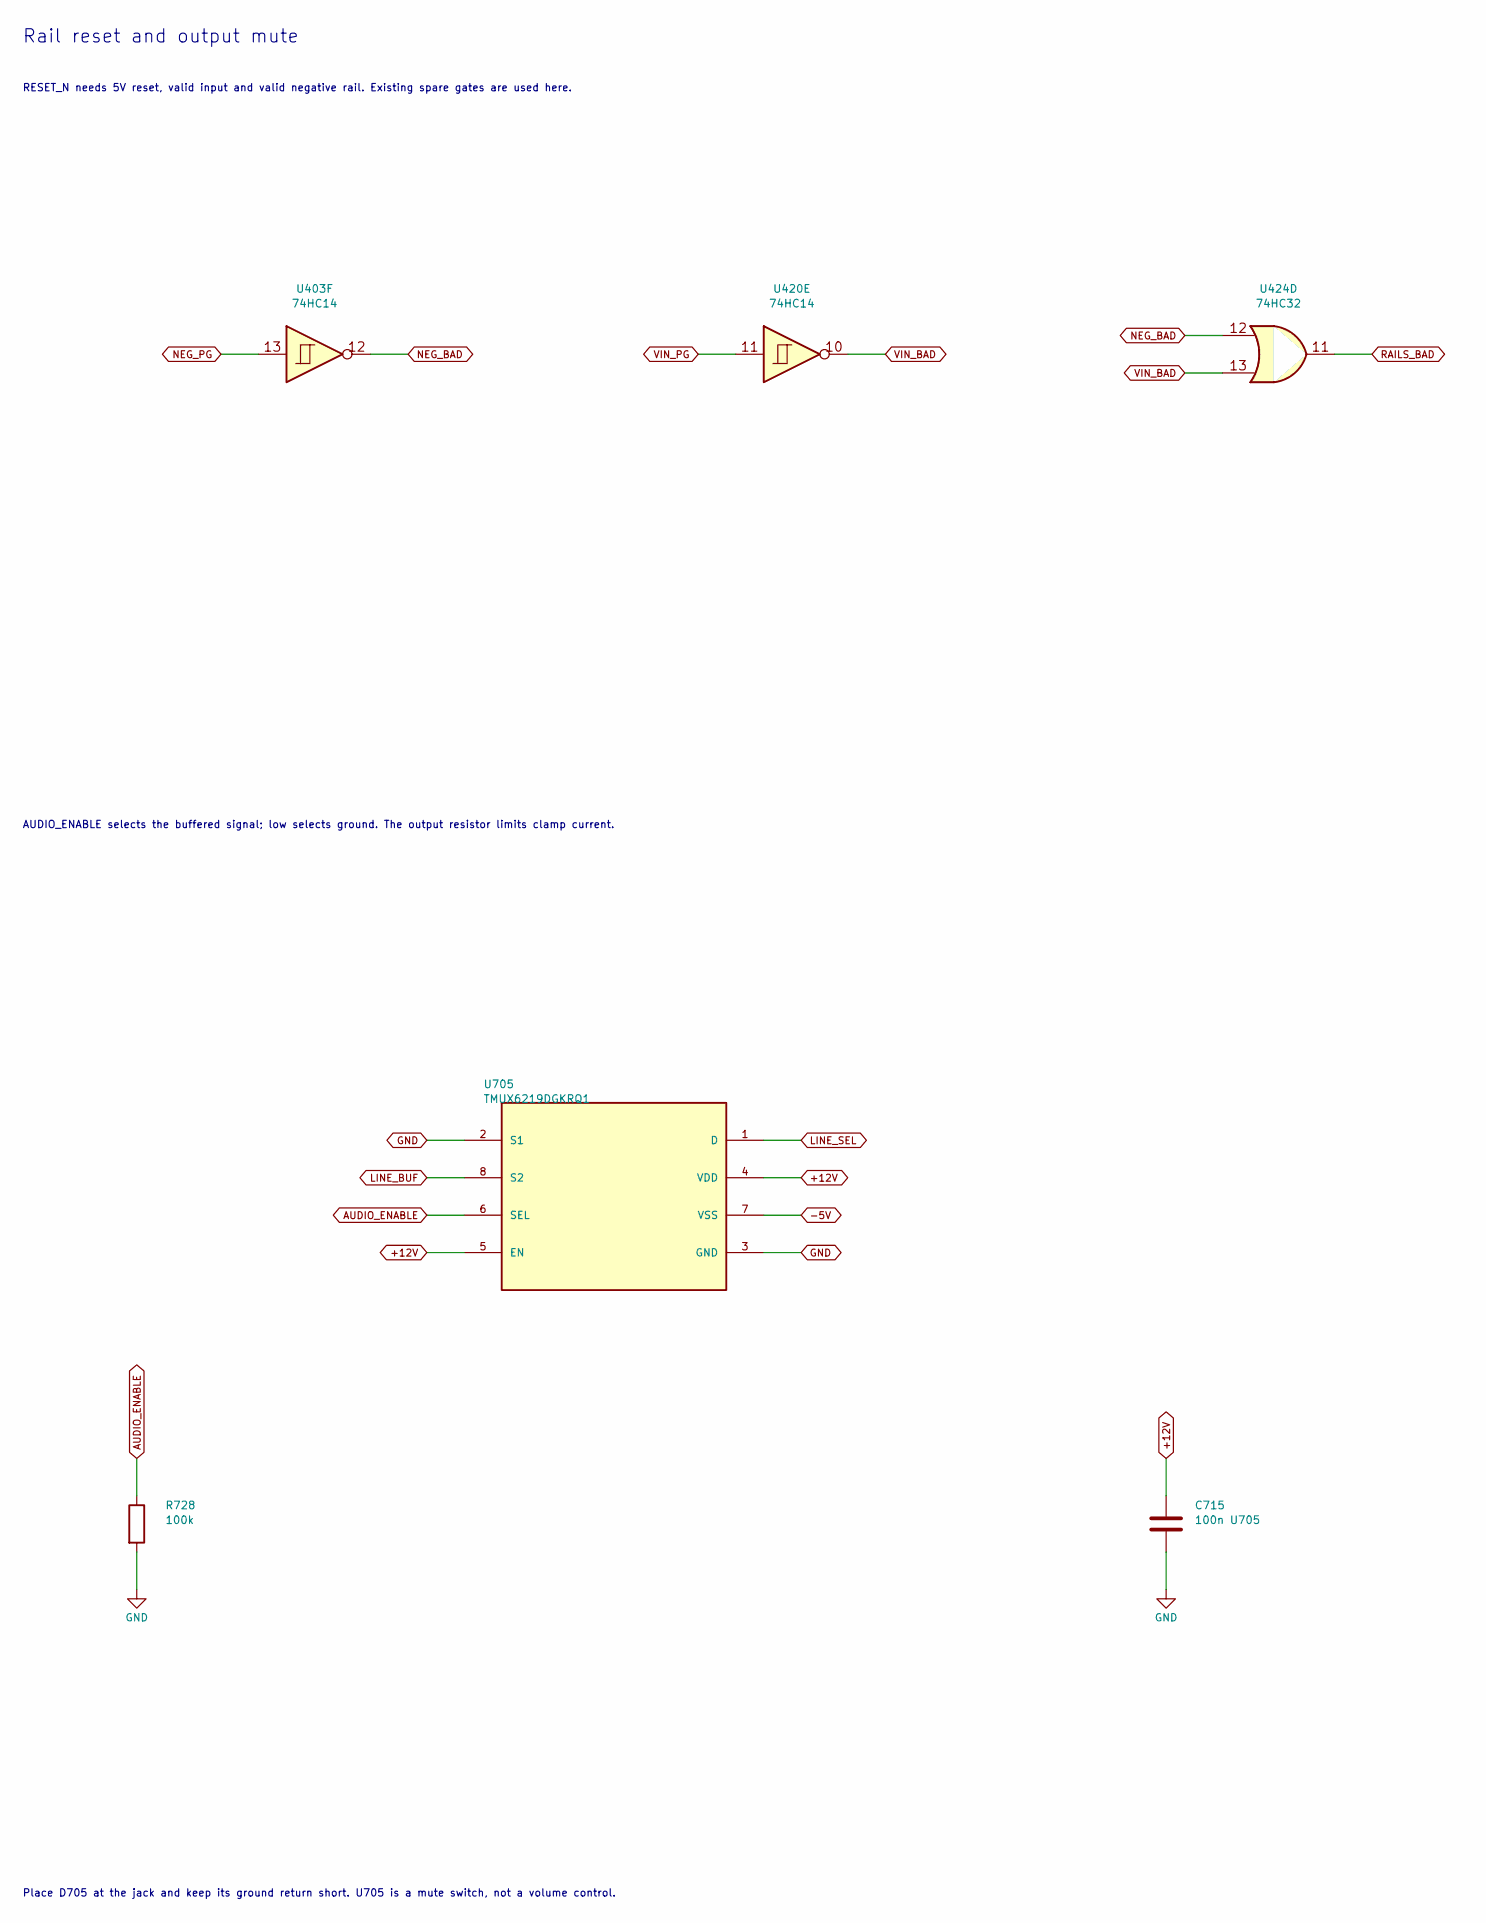
[picture p88: schematic 19_reset_output.kicad_sch, Rail reset and output mute, part in row 1, column 1]

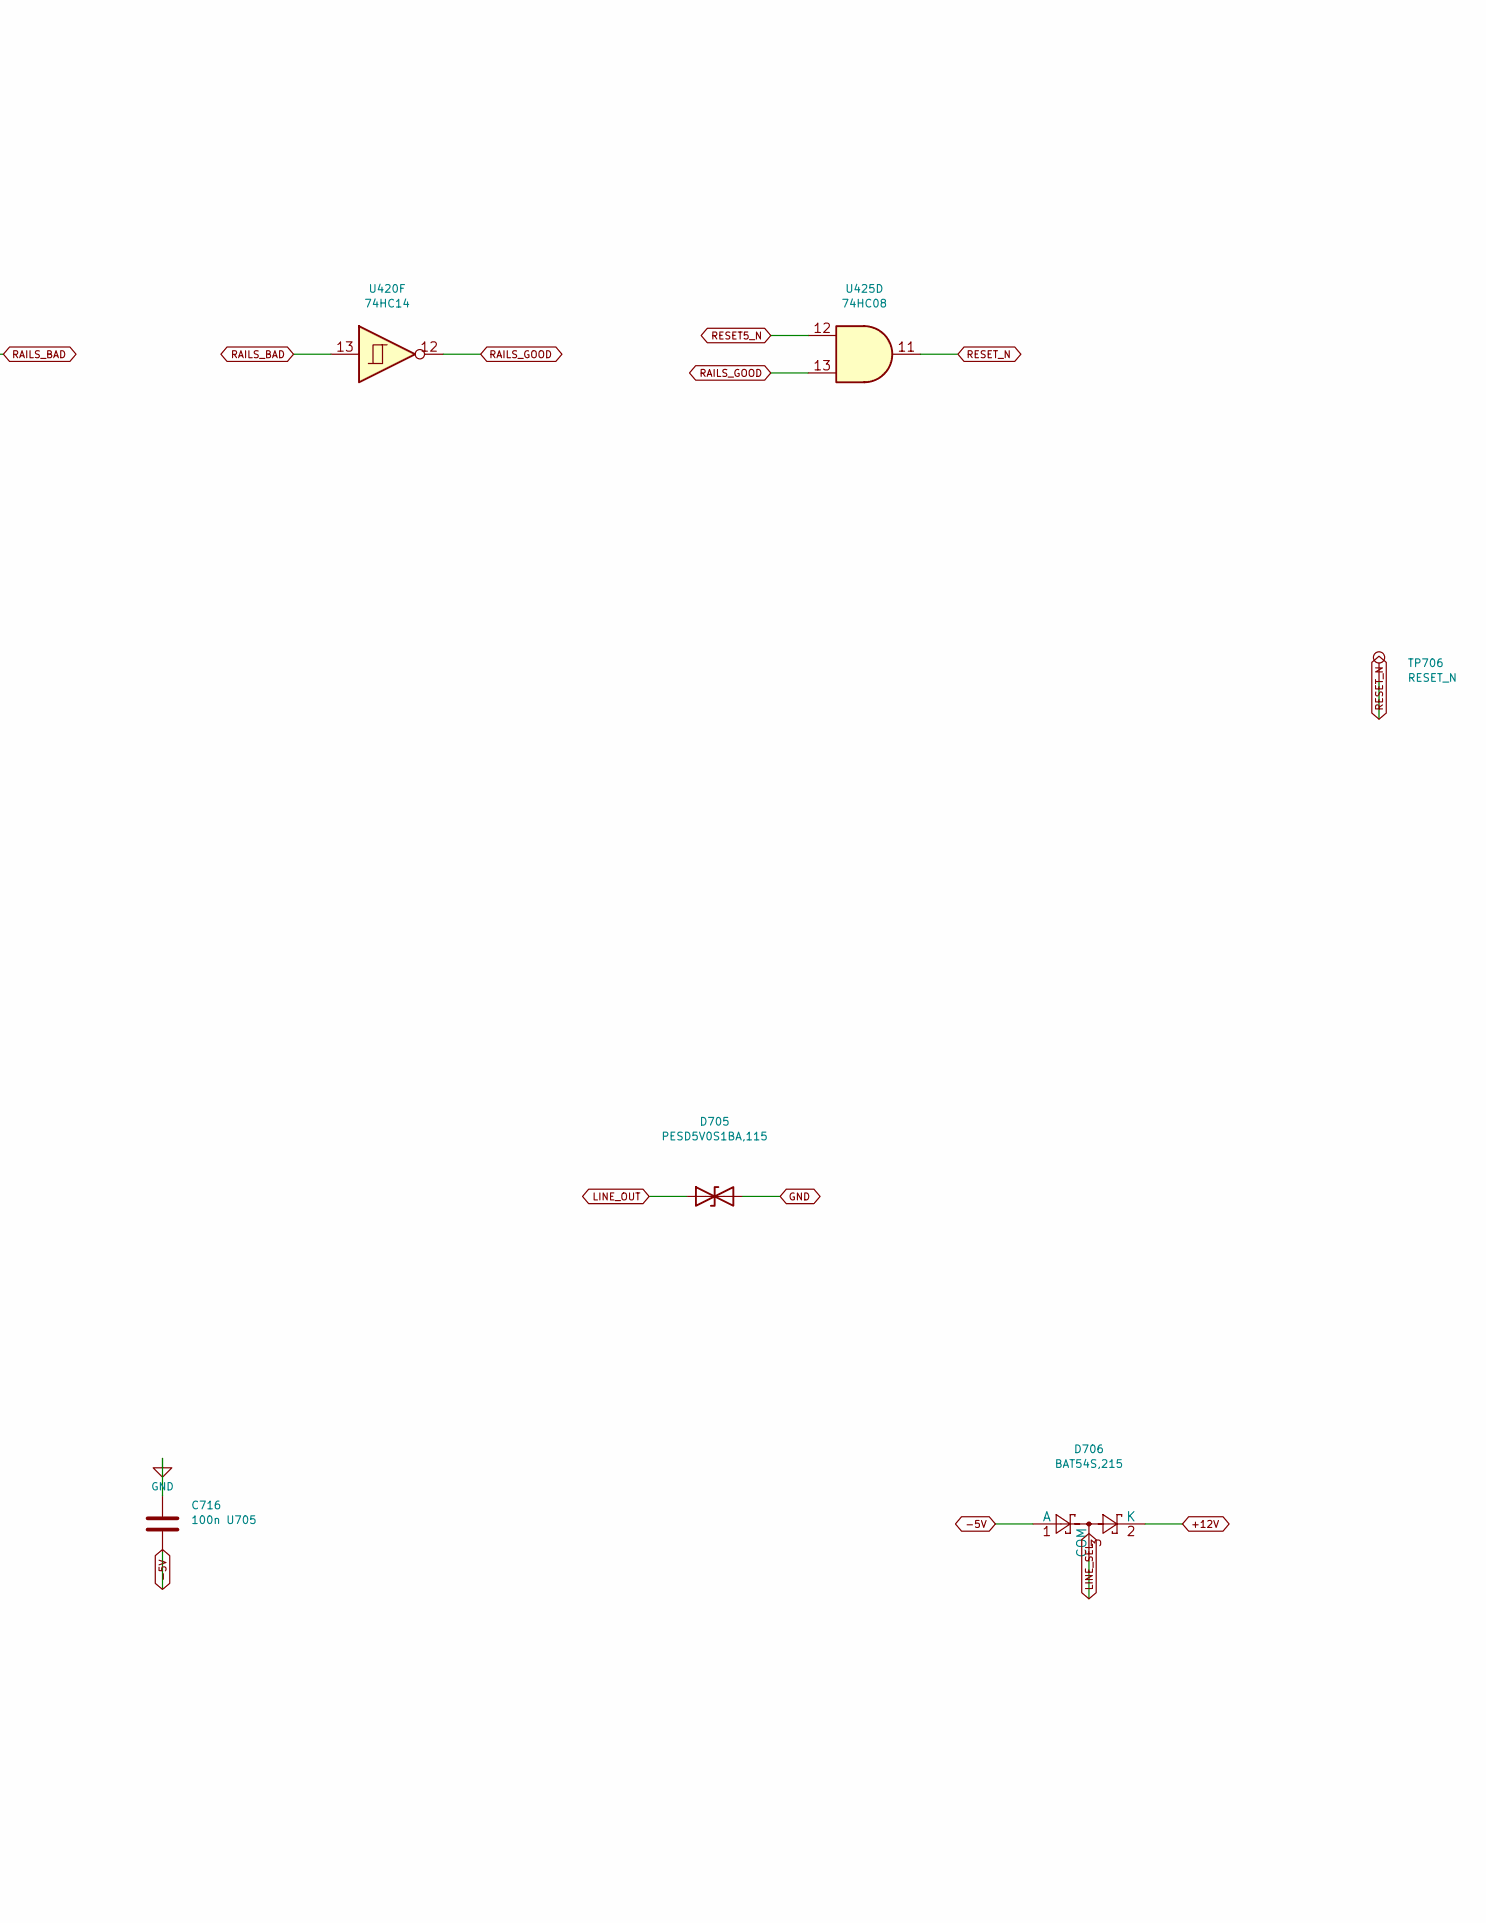
[picture p89: schematic 19_reset_output.kicad_sch, Rail reset and output mute, part in row 1, column 2]

Parts:
C715, C716: 100n U705; C_0805_2012Metric
D705: PESD5V0S1BA,115; D_SOD-323; MPN PESD5V0S1BA,115
D706: BAT54S,215; SOT-23; MPN BAT54S,215
R728: 100k; R_0805_2012Metric
TP706: RESET_N; TestPoint_THTPad_D1.5mm_Drill0.7mm
U403, U420: 74HC14; SOIC-14_3.9x8.7mm_P1.27mm; MPN 74HC14D,653
U424: 74HC32; SOIC-14_3.9x8.7mm_P1.27mm; MPN 74HC32D,653
U425: 74HC08; SOIC-14_3.9x8.7mm_P1.27mm; MPN 74HC08D,653
U705: TMUX6219DGKRQ1; VSSOP-8_DGK0008A_TI; MPN TMUX6219DGKRQ1

Connections:
+12V: C715.1, D706.2 (K), U705.4 (VDD), U705.5 (EN); also elsewhere on the board
-5V: C716.2, D706.1 (A), U705.7 (VSS); also elsewhere on the board
AUDIO_ENABLE: R728.1, U705.6 (SEL); also elsewhere on the board
LINE_BUF: U705.8 (S2); also elsewhere on the board
LINE_OUT: D705.1 (A1); also elsewhere on the board
LINE_SEL: D706.3 (COM), U705.1 (D); also elsewhere on the board
NEG_BAD: U403.12, U424.12
NEG_PG: U403.13; also elsewhere on the board
RAILS_BAD: U420.13, U424.11
RAILS_GOOD: U420.12, U425.13
RESET5_N: U425.12; also elsewhere on the board
RESET_N: TP706.1, U425.11; also elsewhere on the board
VIN_BAD: U420.10, U424.13
VIN_PG: U420.11; also elsewhere on the board

Notes on the sheet:
Rail reset and output mute
RESET_N needs 5V reset, valid input and valid negative rail. Existing spare gates are used here.
AUDIO_ENABLE selects the buffered signal; low selects ground. The output resistor limits clamp current.
Place D705 at the jack and keep its ground return short. U705 is a mute switch, not a volume control.

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
