EwoudVV/arpeggiator/arpeggiator.kicad_pcb

## KiCad design arpeggiator.kicad_pcb (continued)

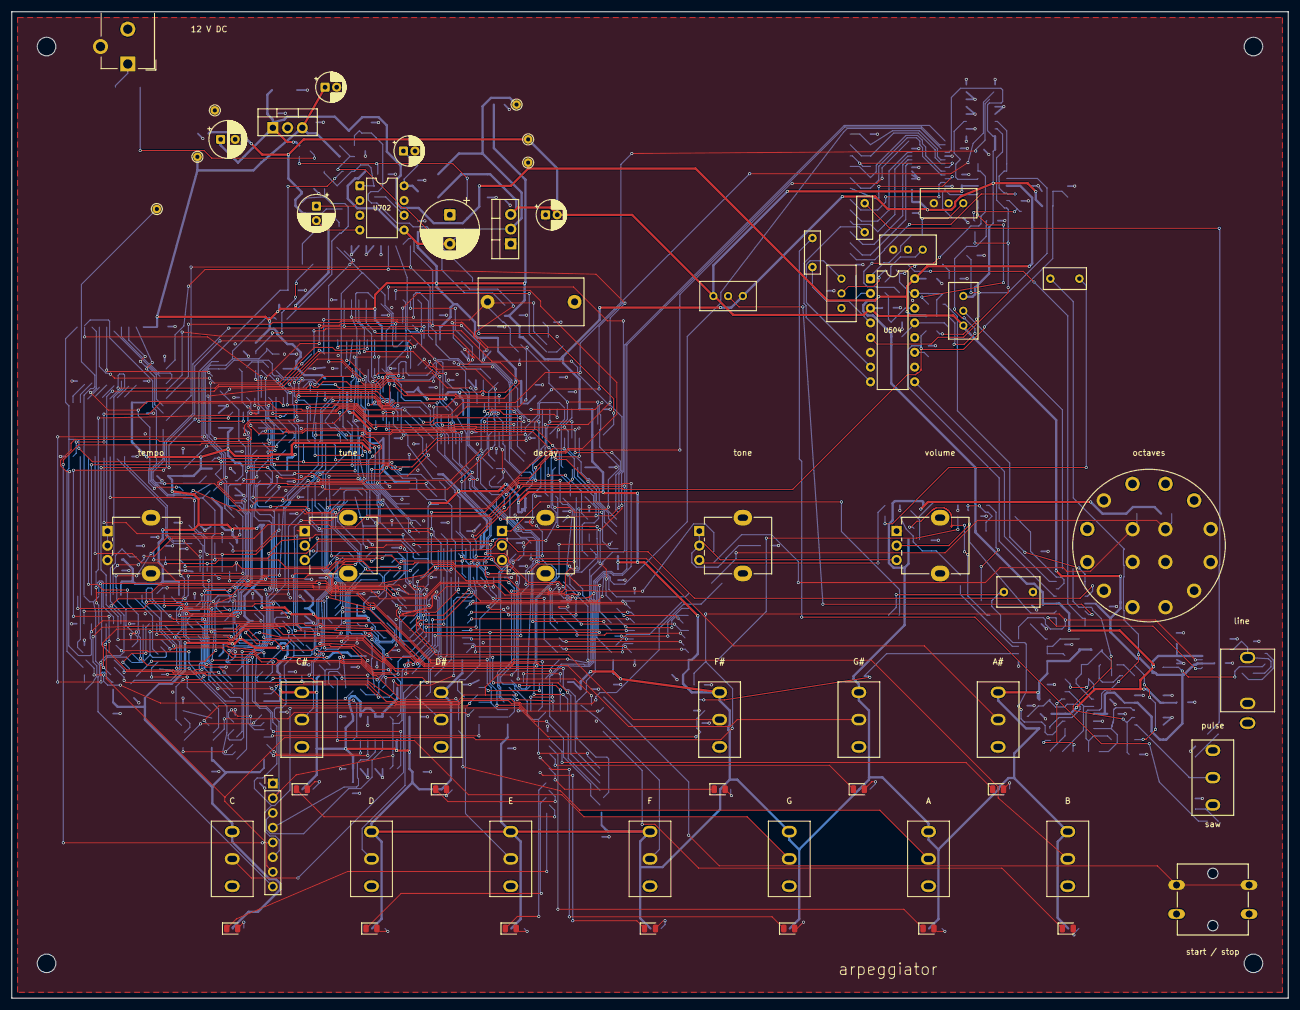
[picture p90: board arpeggiator.kicad_pcb from above]

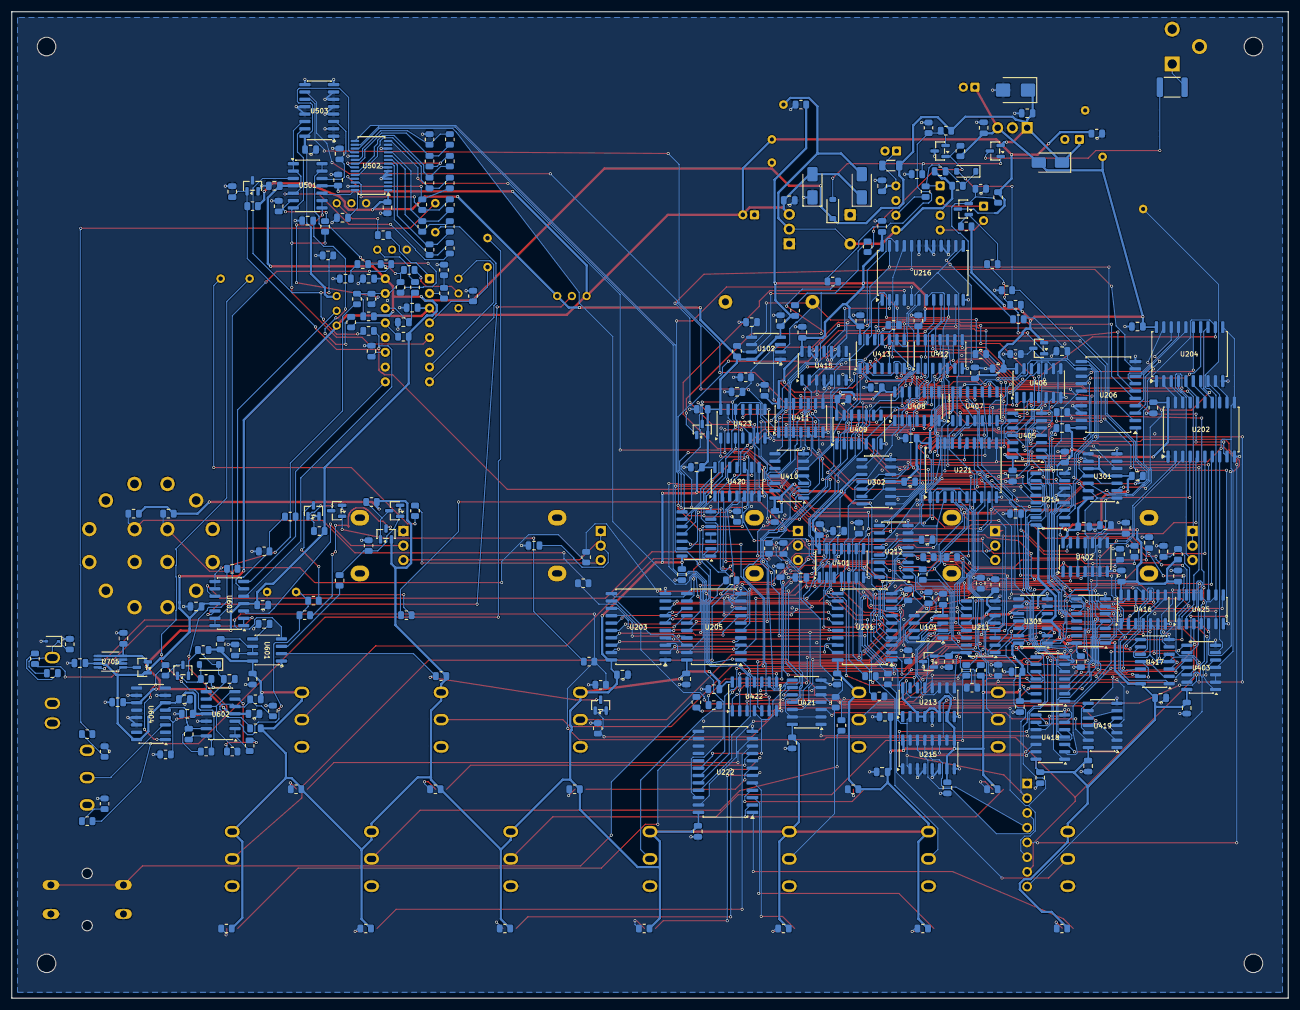
[picture p91: board arpeggiator.kicad_pcb from below]

Board: 4 copper layers, 220.0 x 170.0 mm, 360 parts (295 on the bottom side), 365 nets.

Other parts of the board:
H1, H2, H3, H4: M3; MountingHole_3.2mm_M3
