EwoudVV/arpeggiator/(commit log)

2026-10-19 set the pitch selection and supply plan
2026-10-19 draw and check the sequencer circuit
    [01_controls_a.kicad_sch, 02_controls_b.kicad_sch, 03_clock_range.kicad_sch, 04_input_registers.kicad_sch, 05_search_counters.kicad_sch, 06_pitch_register.kicad_sch, 07_power.kicad_sch, arpeggiator.kicad_sch]
2026-10-19 add the pitch and sound circuit
    [01_controls_a.kicad_sch, 02_controls_b.kicad_sch, 03_clock_range.kicad_sch, 06_pitch_register.kicad_sch, 08_reference.kicad_sch, 09_pitch_select.kicad_sch, 10_oscillator.kicad_sch, 11_envelope.kicad_sch]
2026-10-19 add the pitch and sound devlog
2026-10-20 add power supply, rail checks and parts list
    [01_controls_a.kicad_sch, 02_controls_b.kicad_sch, 03_clock_range.kicad_sch, 04_input_registers.kicad_sch, 05_search_counters.kicad_sch, 06_pitch_register.kicad_sch, 07_power.kicad_sch, 08_reference.kicad_sch]
2026-10-20 add power supply devlog
2026-10-20 pick controls and start pcb placement
    [01_controls_a.kicad_sch, 02_controls_b.kicad_sch, 03_clock_range.kicad_sch, 11_envelope.kicad_sch, 13_line_output.kicad_sch, 15_input_power.kicad_sch, 16_negative_supply.kicad_sch, 19_reset_output.kicad_sch]
2026-10-20 add controls and pcb placement devlog
2026-10-21 start routing the board
    [arpeggiator.kicad_pcb]
2026-10-21 clean up routing and connect more ground returns
    [arpeggiator.kicad_pcb]
2026-10-22 finish signal routing and clean up the traces
    [arpeggiator.kicad_pcb]
2026-10-22 connect ground pours and remove redundant routing
    [arpeggiator.kicad_pcb]
2026-10-22 finish the four-layer layout and routing devlog
    [arpeggiator.kicad_pcb]
2026-10-22 add the printed case and rear power opening
    [15_input_power.kicad_sch, BOM.csv, arpeggiator-assembly.step, arpeggiator-case.FCStd, arpeggiator.kicad_pcb, base.stl, control-panel.stl, fit-coupon.stl]
2026-10-22 add the case devlog
2026-10-23 parts and cheaper PCB files
    [05_search_counters.kicad_sch, 06_pitch_register.kicad_sch, 12_amplifier.kicad_sch, 15_input_power.kicad_sch, 16_negative_supply.kicad_sch, 19_reset_output.kicad_sch, BOM.csv, PURCHASES.csv]
